zhcntiangang/seahorse.github.io/fishs.jpg

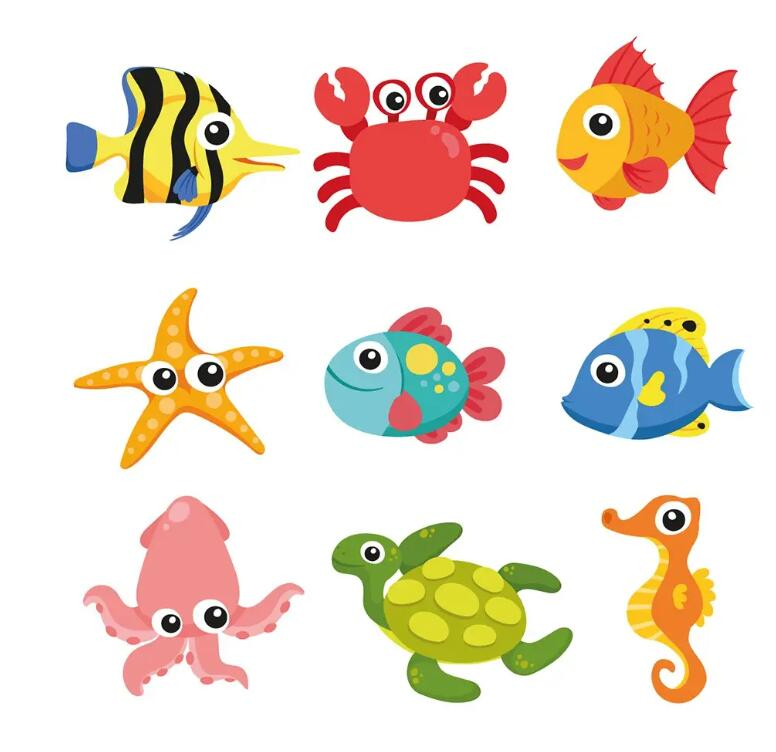
fishs.jpg
