zhcntiangang/seahorse.github.io/gzt/摆放示意图.jpg

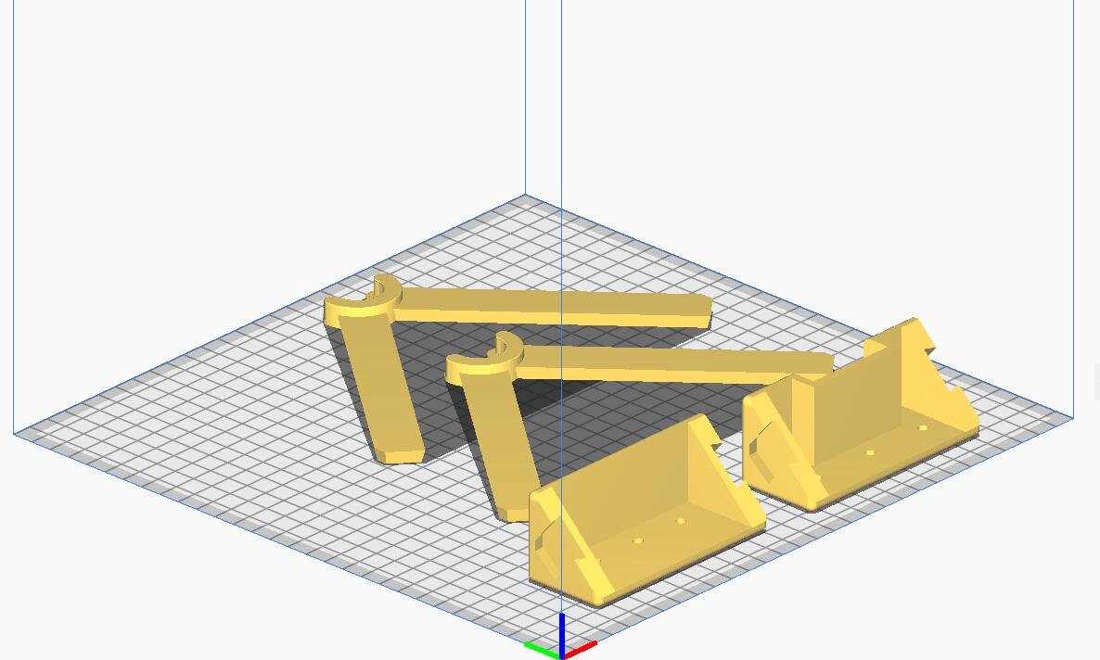
gzt/摆放示意图.jpg
