zhcntiangang/seahorse.github.io/voron/线束标签.docx

断线传感器 断线传感器 断线传感器 断线传感器

LED数据信号 LED数据信号 LED数据信号 LED数据信号

热端加热器V- 热端加热器V- 热端加热器V- 热端加热器V-

5V电源正极 5V电源正极 5V电源正极 5V电源正极

热端风扇V- 热端风扇V- 热端风扇V- 热端风扇V-

电机线-黑色 电机线-黑色 电机线-黑色 电机线-黑色

电机线-绿色 电机线-绿色 电机线-绿色 电机线-绿色

电机线-红色 电机线-红色 电机线-红色 电机线-红色

电机线-蓝色 电机线-蓝色 电机线-蓝色 电机线-蓝色

Probe 信号线 Probe 信号线 Probe 信号线 Probe 信号线

24V正极 24V正极 24V正极 24V正极

可控风扇V- 可控风扇V- 可控风扇V- 可控风扇V-

热敏V- 热敏V- 热敏V- 热敏V-

热敏信号线 热敏信号线 热敏信号线 热敏信号线

电源负极 电源负极 电源负极 电源负极

辅助的信号线 辅助的信号线 辅助的信号线 辅助的信号线

X限位 Y限位 Z限位 照明 仓底风扇 热床正极 热床负极 热床热敏 排气风扇 热床控制

X限位 Y限位 Z限位 照明 仓底风扇 热床正极 热床负极 热床热敏 排气风扇 热床控制
