zhcntiangang/seahorse.github.io/voron/网站发布过程.pptx

像Word一样，用Typora写网站的内容

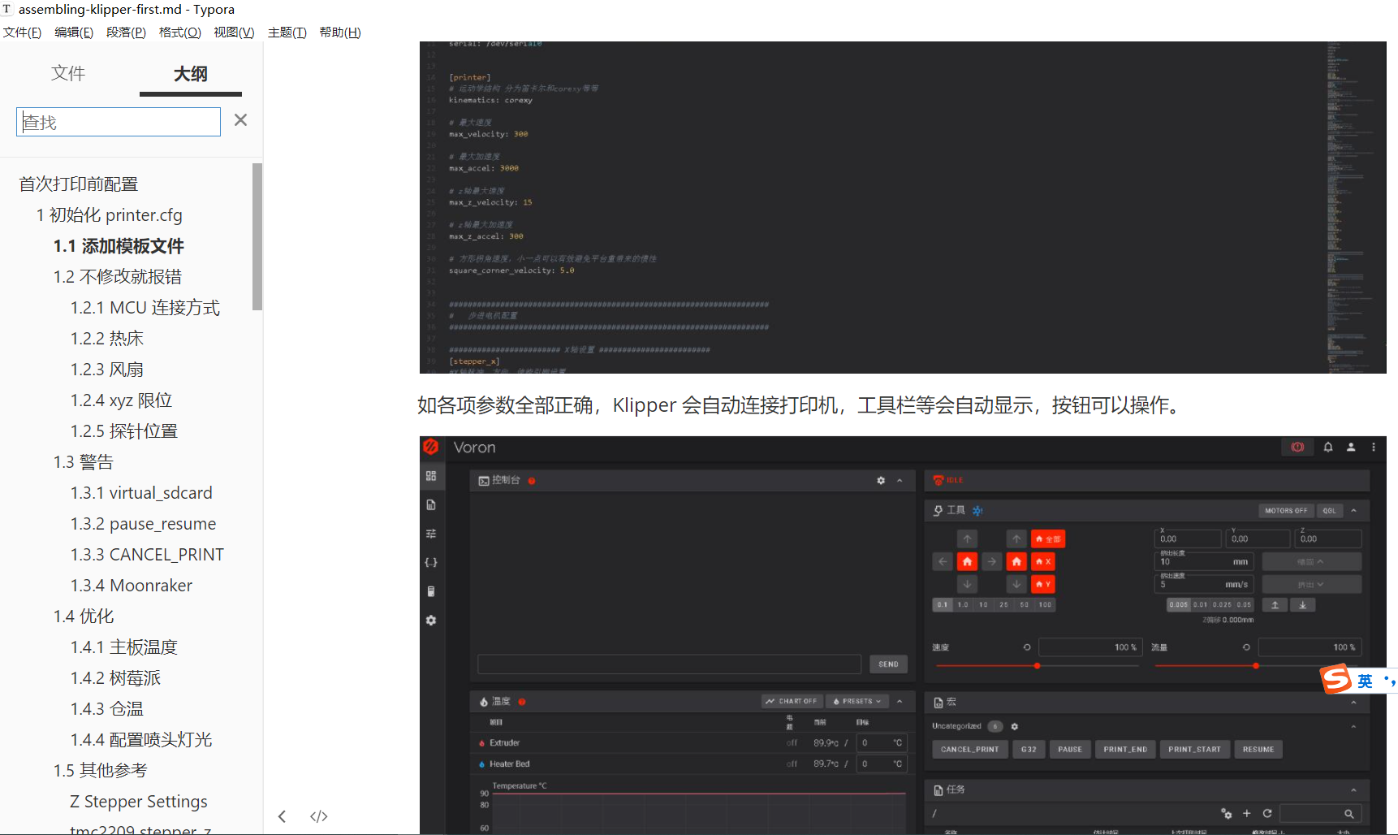
[picture p16: figure]

保存到免费的Gitee网站上

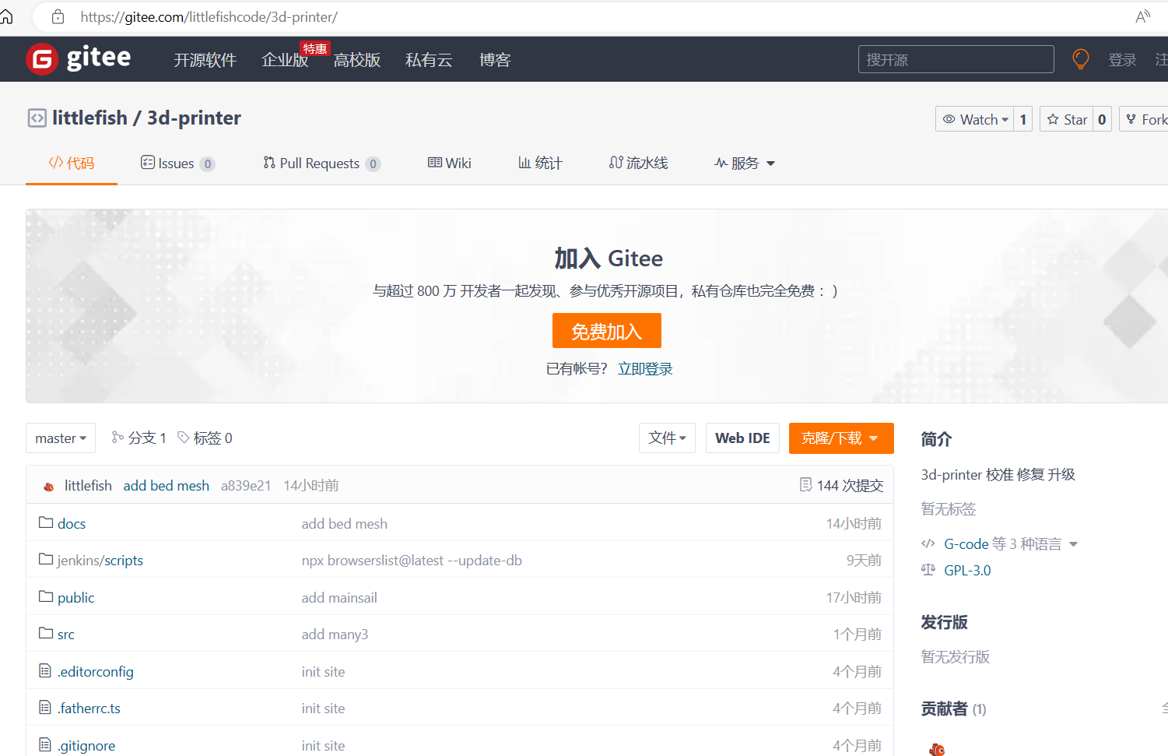
[picture p17: figure]

所有人都可以gitee下载这个项目

发现Gitee有变化，就自动编译网站

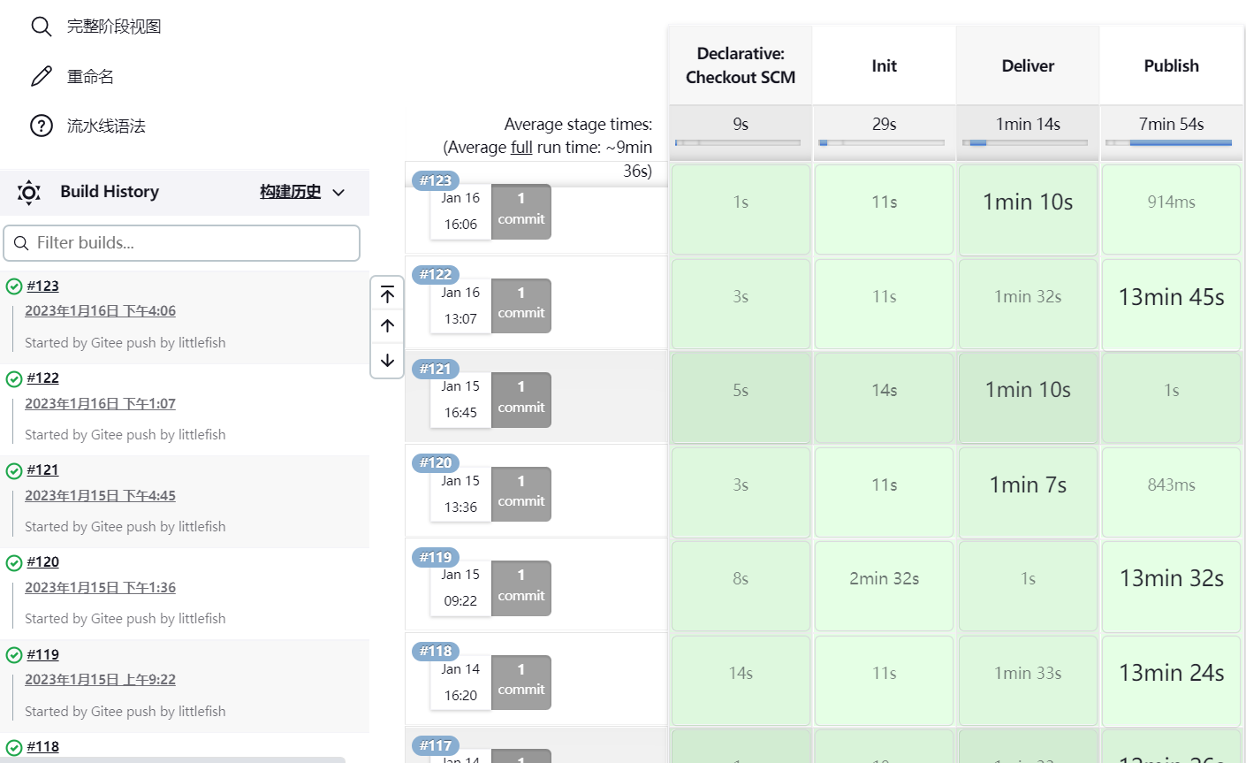
[picture p18: figure]

自动生成手机与电脑两种样式

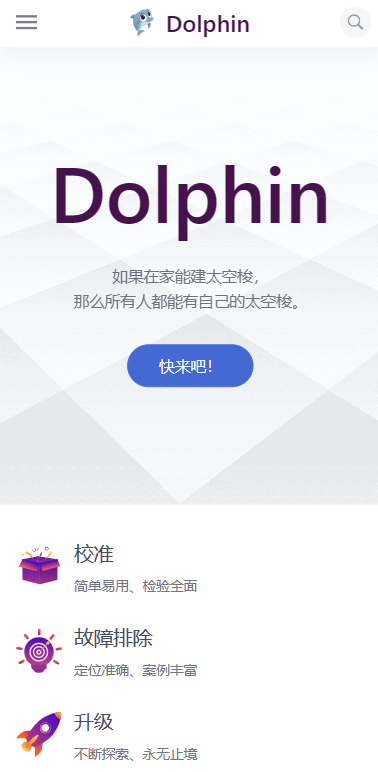
[picture p19: figure]
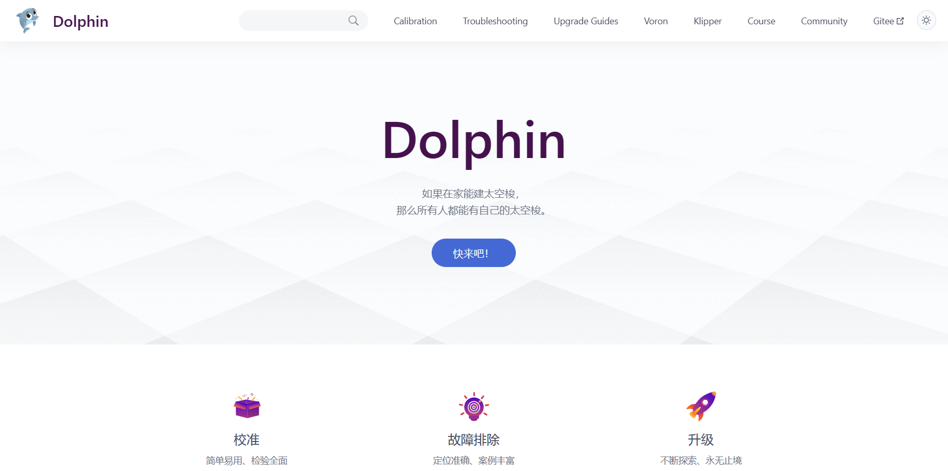
[picture p20: figure]
