zhcntiangang/seahorse.github.io/blibli.png

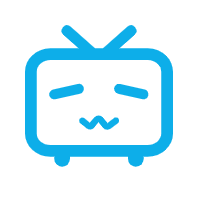
blibli.png
