zhcntiangang/seahorse.github.io/features/soft.png

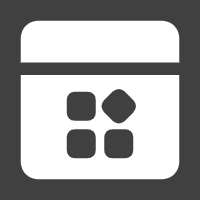
features/soft.png
