zhcntiangang/seahorse.github.io/features/upgrade.png

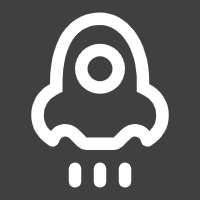
features/upgrade.png
