zhcntiangang/seahorse.github.io/help.png

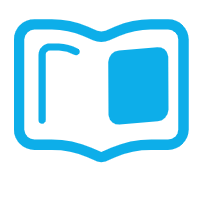
help.png
