zhcntiangang/seahorse.github.io/home.jpg

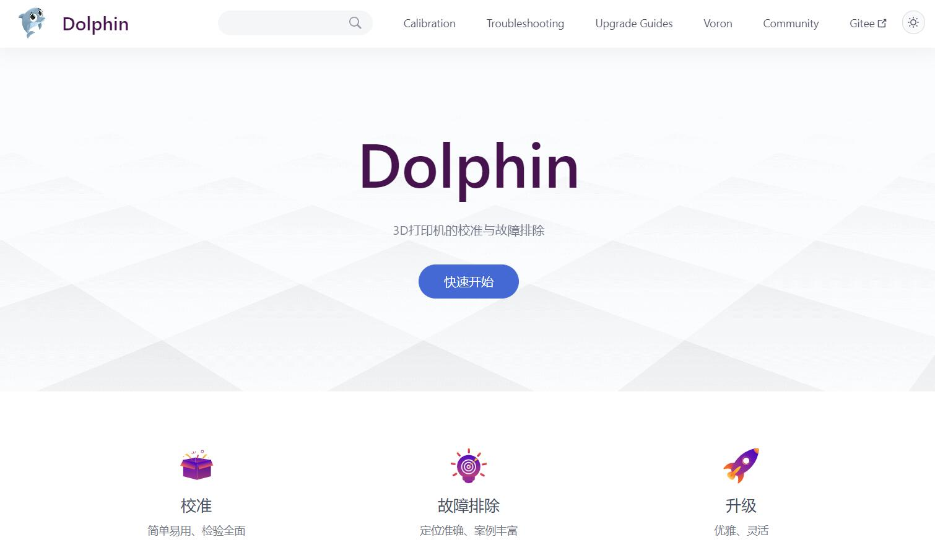
home.jpg
