zhcntiangang/seahorse.github.io/sj.jpg

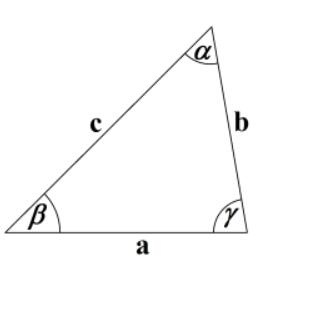
sj.jpg
