zhcntiangang/seahorse.github.io/bom/Voron2.4 R2（CNC专属BOM）中英互译20220822.pdf

# Voron V2.4 R2 300/350mm热床 中英对照翻译清单

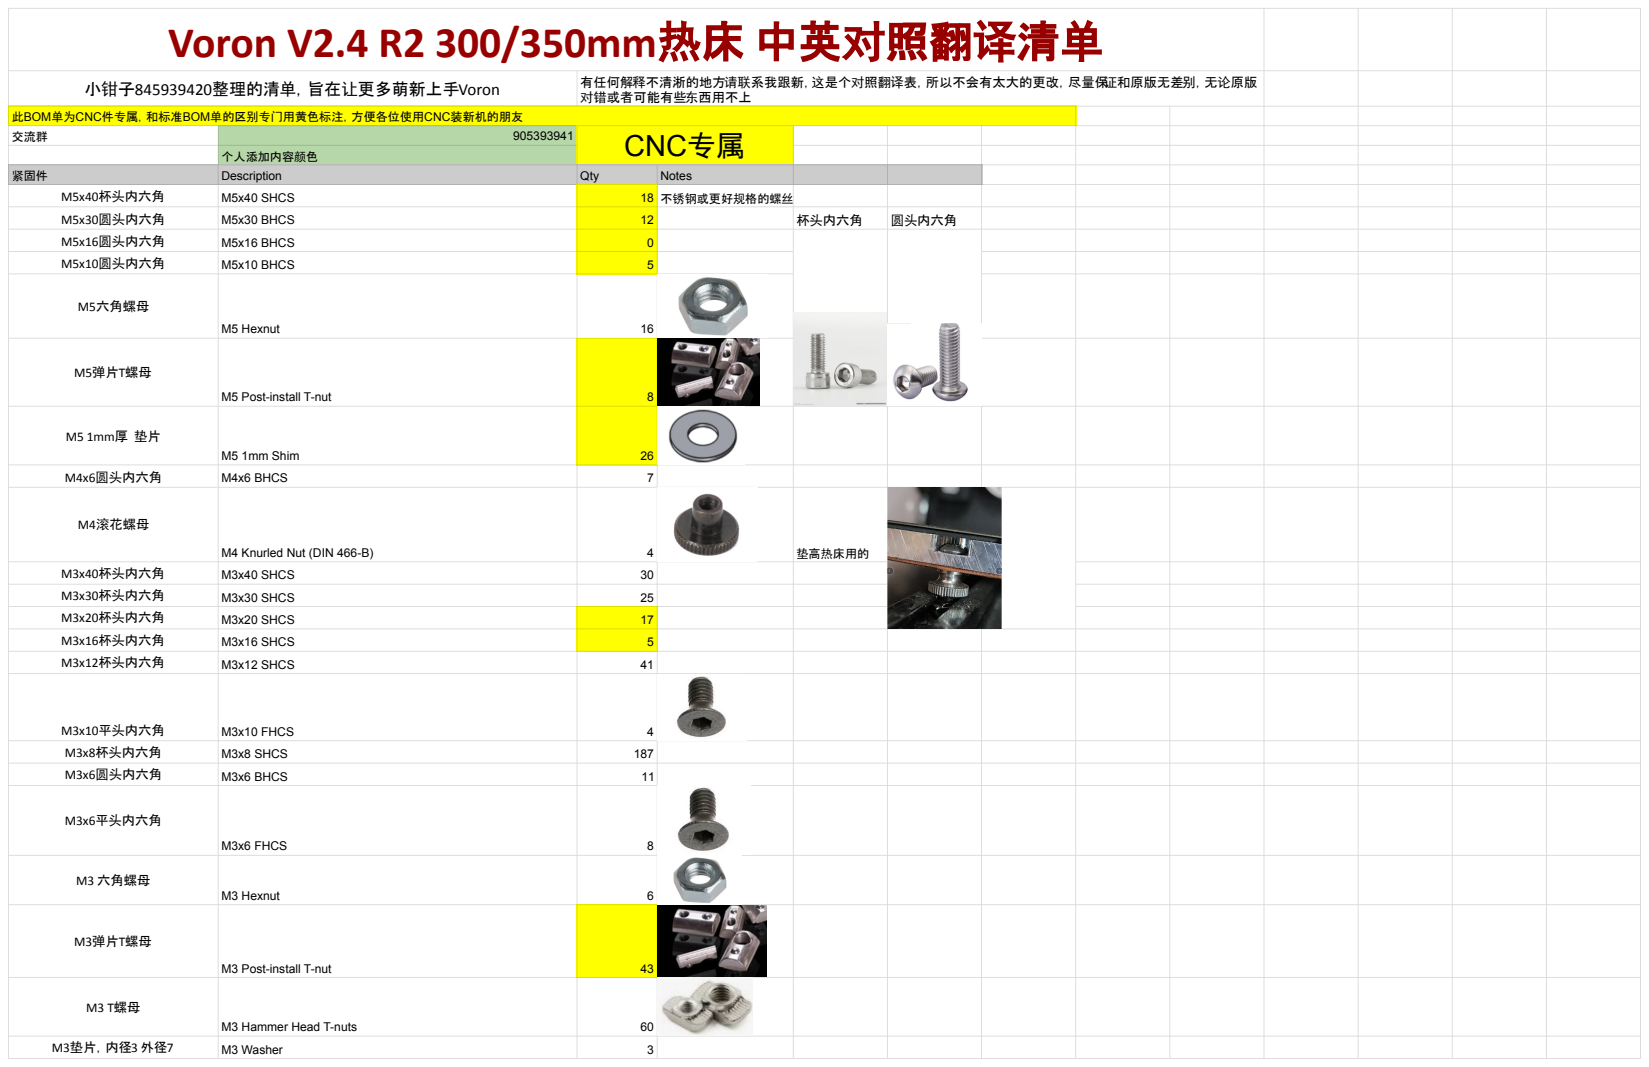
[picture p27: page 1]
M5x40杯头内六角; M5x40 SHCS; 不锈钢或更好规格的螺丝; M5x30圆头内六角; M5x30 BHCS; 杯头内六角; 圆头内六角; M5x16圆头内六角; M5x16 BHCS; M5x10圆头内六角; M5x10 BHCS; M5六角螺母; M5 Hexnut; M5弹片T螺母; M5 Post-install T-nut; M5 1mm厚 垫片; M5 1mm Shim; M4x6圆头内六角; M4x6 BHCS; M4滚花螺母; M4 Knurled Nut (DIN 466-B); 垫高热床用的; M3x40杯头内六角; M3x40 SHCS; M3x30杯头内六角; M3x30 SHCS; M3x20杯头内六角; M3x20 SHCS; M3x16杯头内六角; M3x16 SHCS; M3x12杯头内六角; M3x12 SHCS; M3x10平头内六角; M3x10 FHCS; M3x8杯头内六角; M3x8 SHCS; M3x6圆头内六角; M3x6 BHCS; M3x6平头内六角; M3x6 FHCS; M3 六角螺母; M3 Hexnut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

小钳子845939420整理的清单，旨在让更多萌新上手Voron | 有任何解释不清淅的地方请联系我跟新，这是个对照翻译表，所以不会有太大的更改，尽量保证和原版无差别，无论原版 对错或者可能有些东西用不上

此BOM单为CNC件专属，和标准BOM单的区别专门用黄色标注，方便各位使用CNC装新机的朋友
交流群 | 905393941 个人添加内容颜色 | CNC专属

紧固件 Description Qty Notes

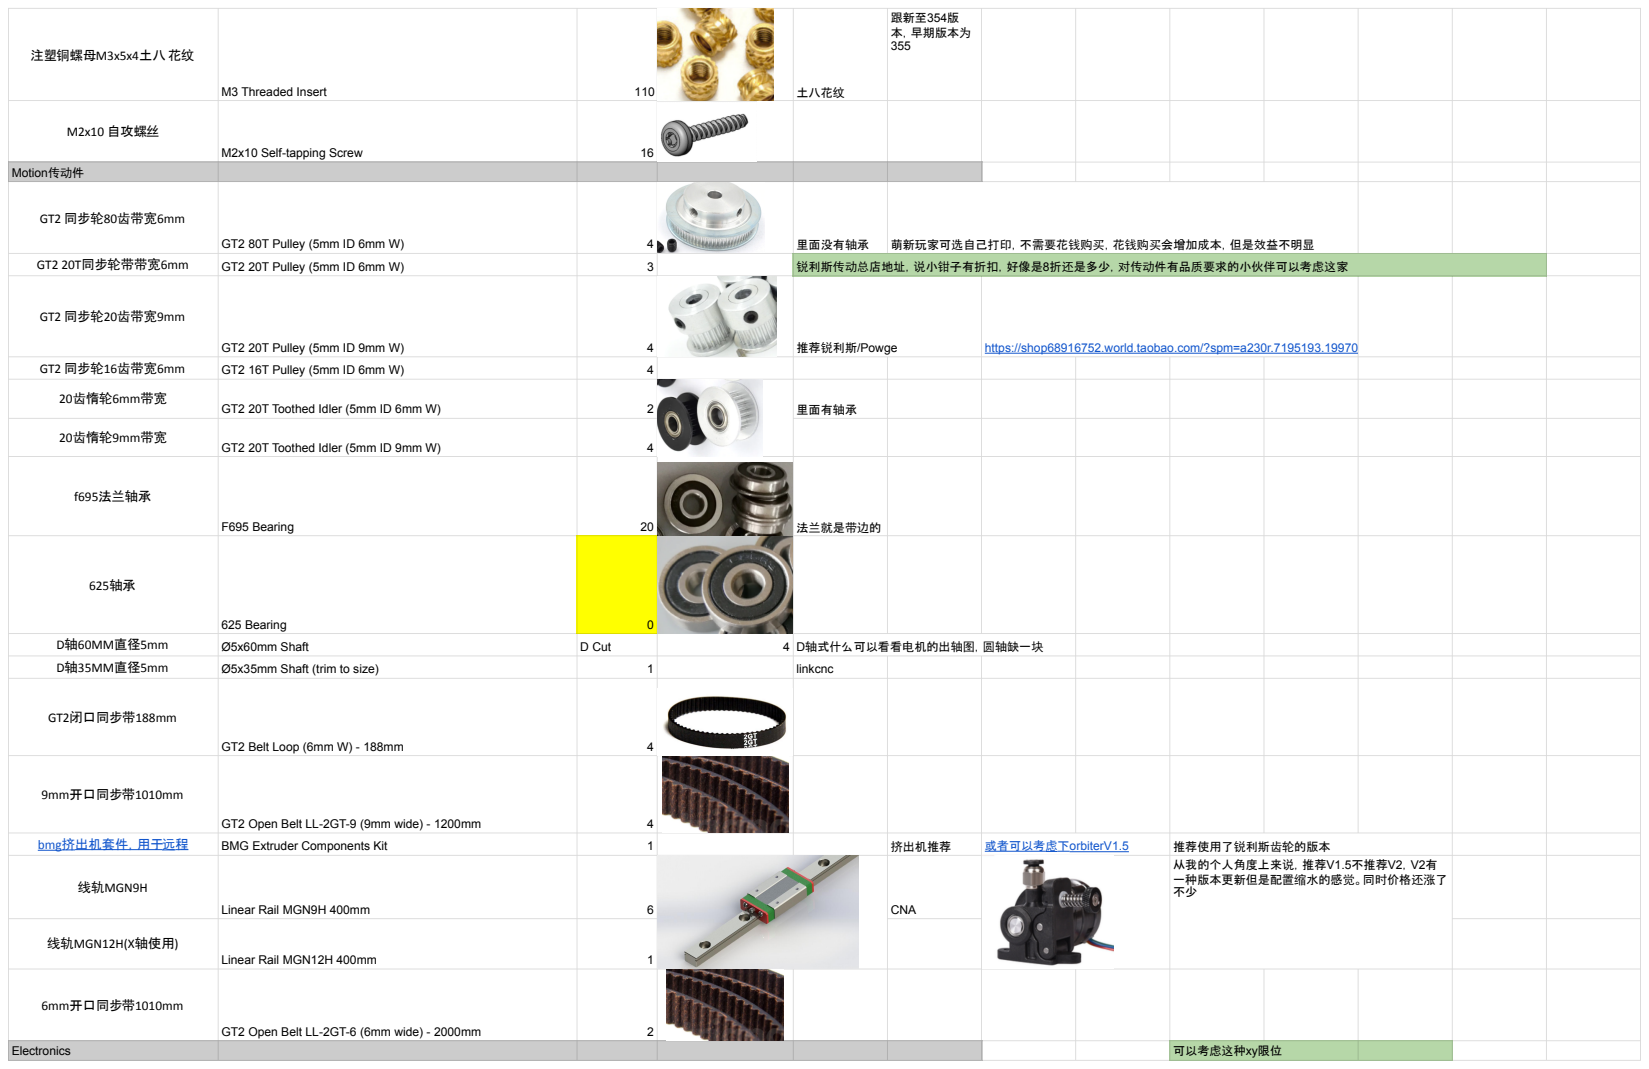
[picture p28: page 2]
注塑铜螺母M3x5x4土八 花纹; M3 Threaded Insert; 土八花纹; 跟新至354版 本，早期版本为 355; M2x10 自攻螺丝; M2x10 Self-tapping Screw; Motion传动件; GT2 同步轮80齿带宽6mm; GT2 80T Pulley (5mm ID 6mm W); 里面没有轴承; 萌新玩家可选自己打印，不需要花钱购买，花钱购买会增加成本，但是效益不明显; GT2 20T同步轮带带宽6mm; GT2 20T Pulley (5mm ID 6mm W); 锐利斯传动总店地址，说小钳子有折扣，好像是8折还是多少，对传动件有品质要求的小伙伴可以考虑这家; GT2 同步轮20齿带宽9mm; GT2 20T Pulley (5mm ID 9mm W); 推荐锐利斯/Powge; https://shop68916752.world.taobao.com/?spm=a230r.7195193.1997079397.2.1e216d77pc7N9O; GT2 同步轮16齿带宽6mm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

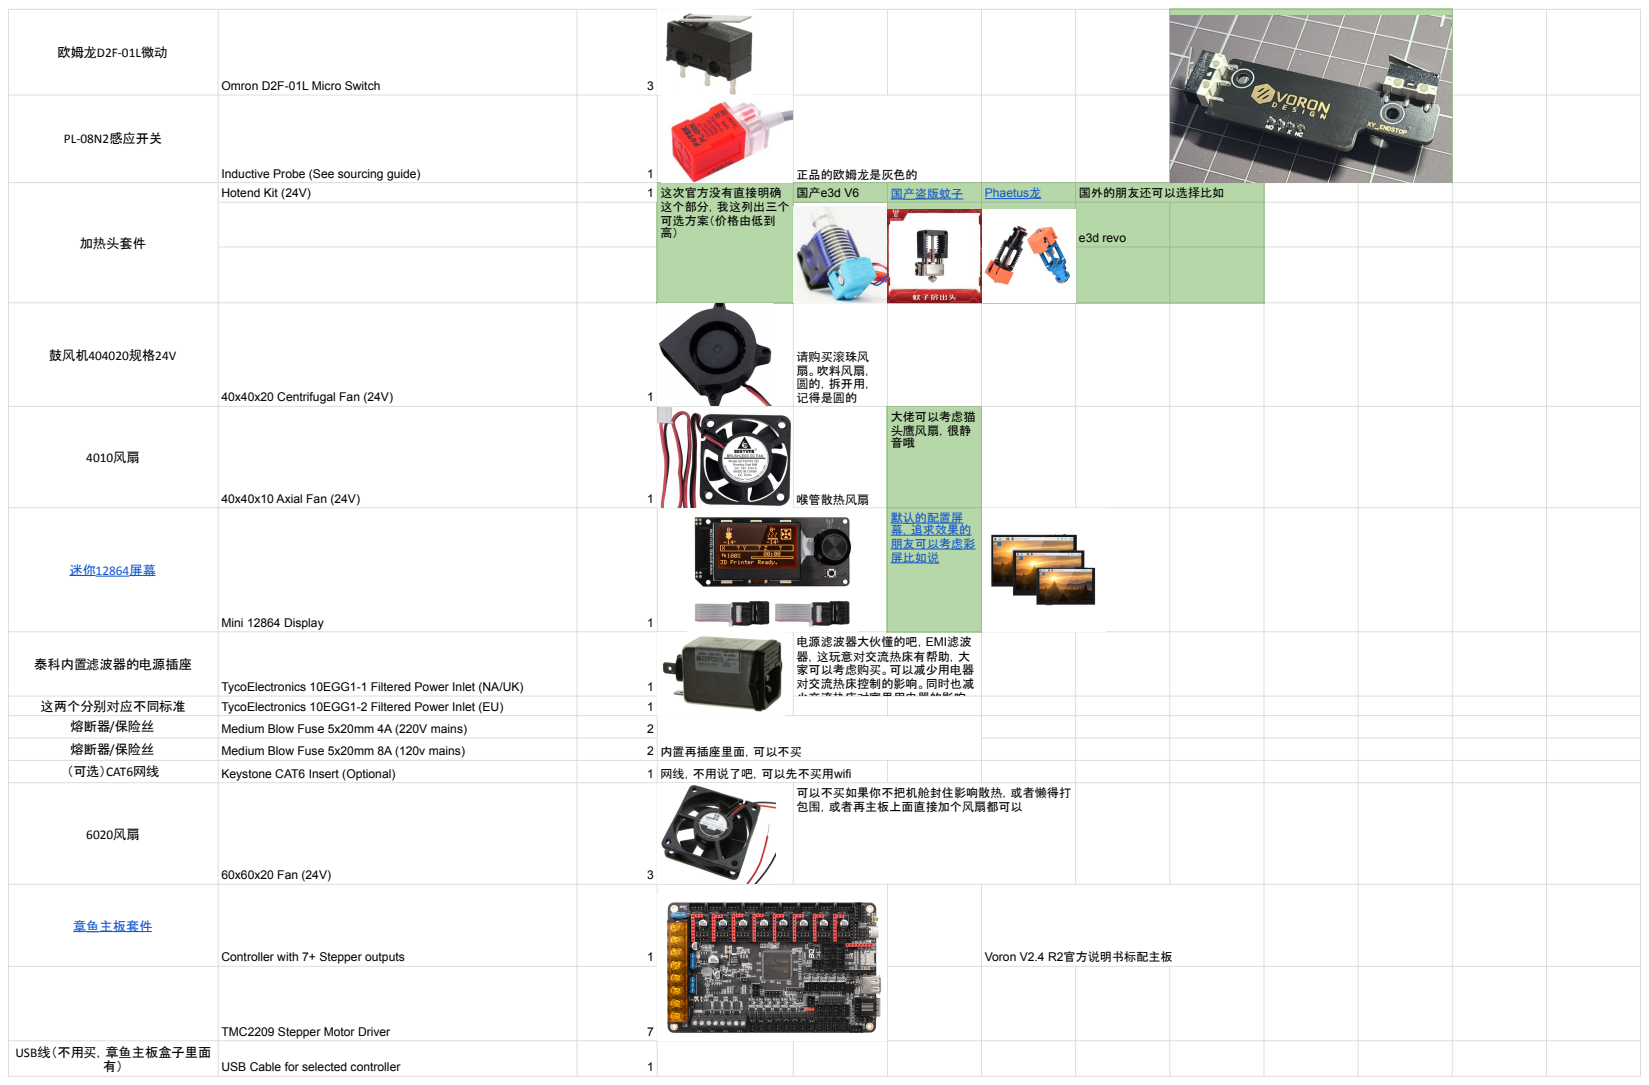
[picture p29: page 3]
加热头套件; Hotend Kit (24V); 这次官方没有直接明确; 鼓风机404020规格24V; 40x40x20 Centrifugal Fan (24V); 请购买滚珠风 扇。吹料风扇， 圆的，拆开用， 记得是圆的; 40x40x10 Axial Fan (24V); 喉管散热风扇; 大佬可以考虑猫 头鹰风扇，很静 音哦; Mini 12864 Display; 默认的配置屏 幕，追求效果的 朋友可以考虑彩 屏比如说; 泰科内置滤波器的电源插座; TycoElectronics 10EGG1-1 Filtered Power Inlet (NA/UK); 电源滤波器大伙懂的吧，EMI滤波 器，这玩意对交流热床有帮助，大 家可以考虑购买。可以减少用电器 对交流热床控制的影响。同时也减 少交流热床对家里用电器的影响。; 这两个分别对应不同标准; TycoElectronics 10EGG1-2 Filtered Power Inlet (EU); 1 熔断器/保险丝; Medium Blow Fuse 5x20mm 4A (220V mains); 2 熔断器/保险丝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

欧姆龙D2F-01L微动 Omron D2F-01L Micro Switch 3 PL-08N2感应开关 Inductive Probe (See sourcing guide) 1 正品的欧姆龙是灰色的

国产e3d V6 国产盗版蚊子 (https://item.taobao.com/item.htm?id=617701287324) Phaetus龙 (https://item.taobao.com/item.htm?id=618872835165) 国外的朋友还可以选择比如

这个部分，我这列出三个 可选方案（价格由低到 高） | | e3d revo

USB线（不用买，章鱼主板盒子里面

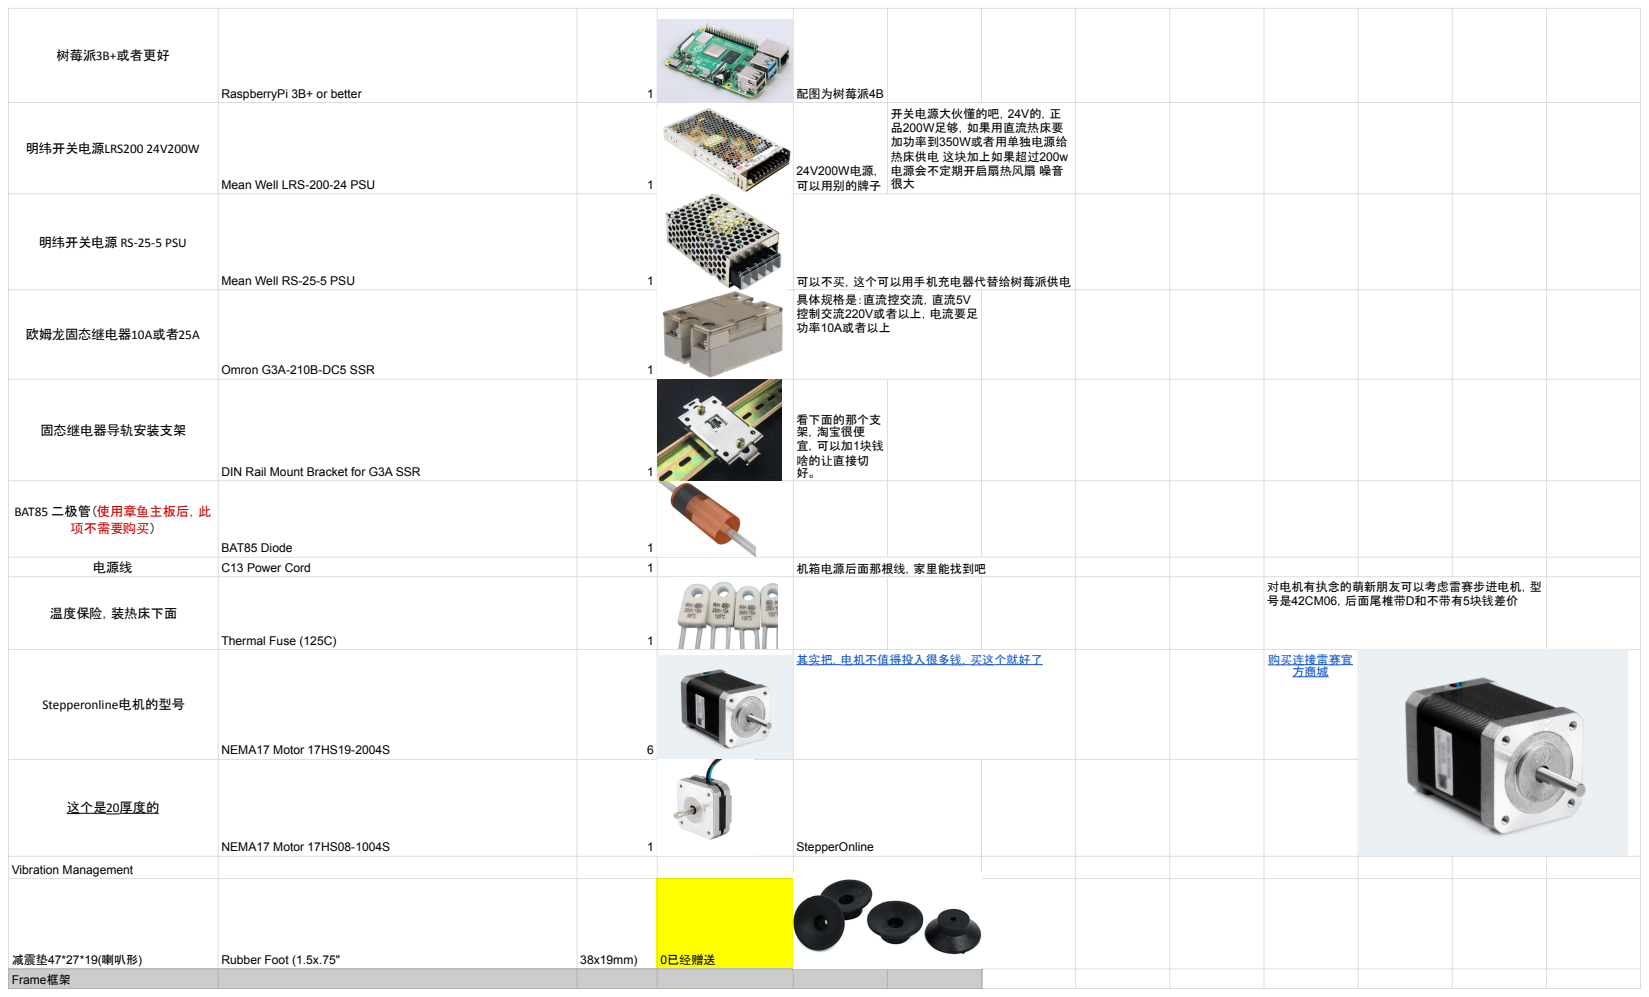
[picture p30: page 4]
树莓派3B+或者更好; RaspberryPi 3B+ or better; 配图为树莓派4B; 明纬开关电源LRS200 24V200W; Mean Well LRS-200-24 PSU; 24V200W电源， 可以用别的牌子; 开关电源大伙懂的吧，24V的，正 品200W足够，如果用直流热床要 加功率到350W或者用单独电源给 热床供电 这块加上如果超过200w 电源会不定期开启扇热风扇 噪音; Mean Well RS-25-5 PSU; 可以不买，这个可以用手机充电器代替给树莓派供电; 欧姆龙固态继电器10A或者25A; Omron G3A-210B-DC5 SSR; 功率10A或者以上; 固态继电器导轨安装支架; DIN Rail Mount Bracket for G3A SSR; 看下面的那个支 架，淘宝很便 宜，可以加1块钱 啥的让直接切 好。; BAT85 二极管（使用章鱼主板后，此 项不需要购买）; BAT85 Diode; 1 电源线; C13 Power Cord; 机箱电源后面那根线，家里能找到吧; 温度保险，装热床下面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

明纬开关电源 RS-25-5 PSU

具体规格是：直流控交流，直流5V 控制交流220V或者以上，电流要足

减震垫47*27*19(喇叭形) Rubber Foot (1.5x.75" 38x19mm) | 0已经赠送
Frame框架

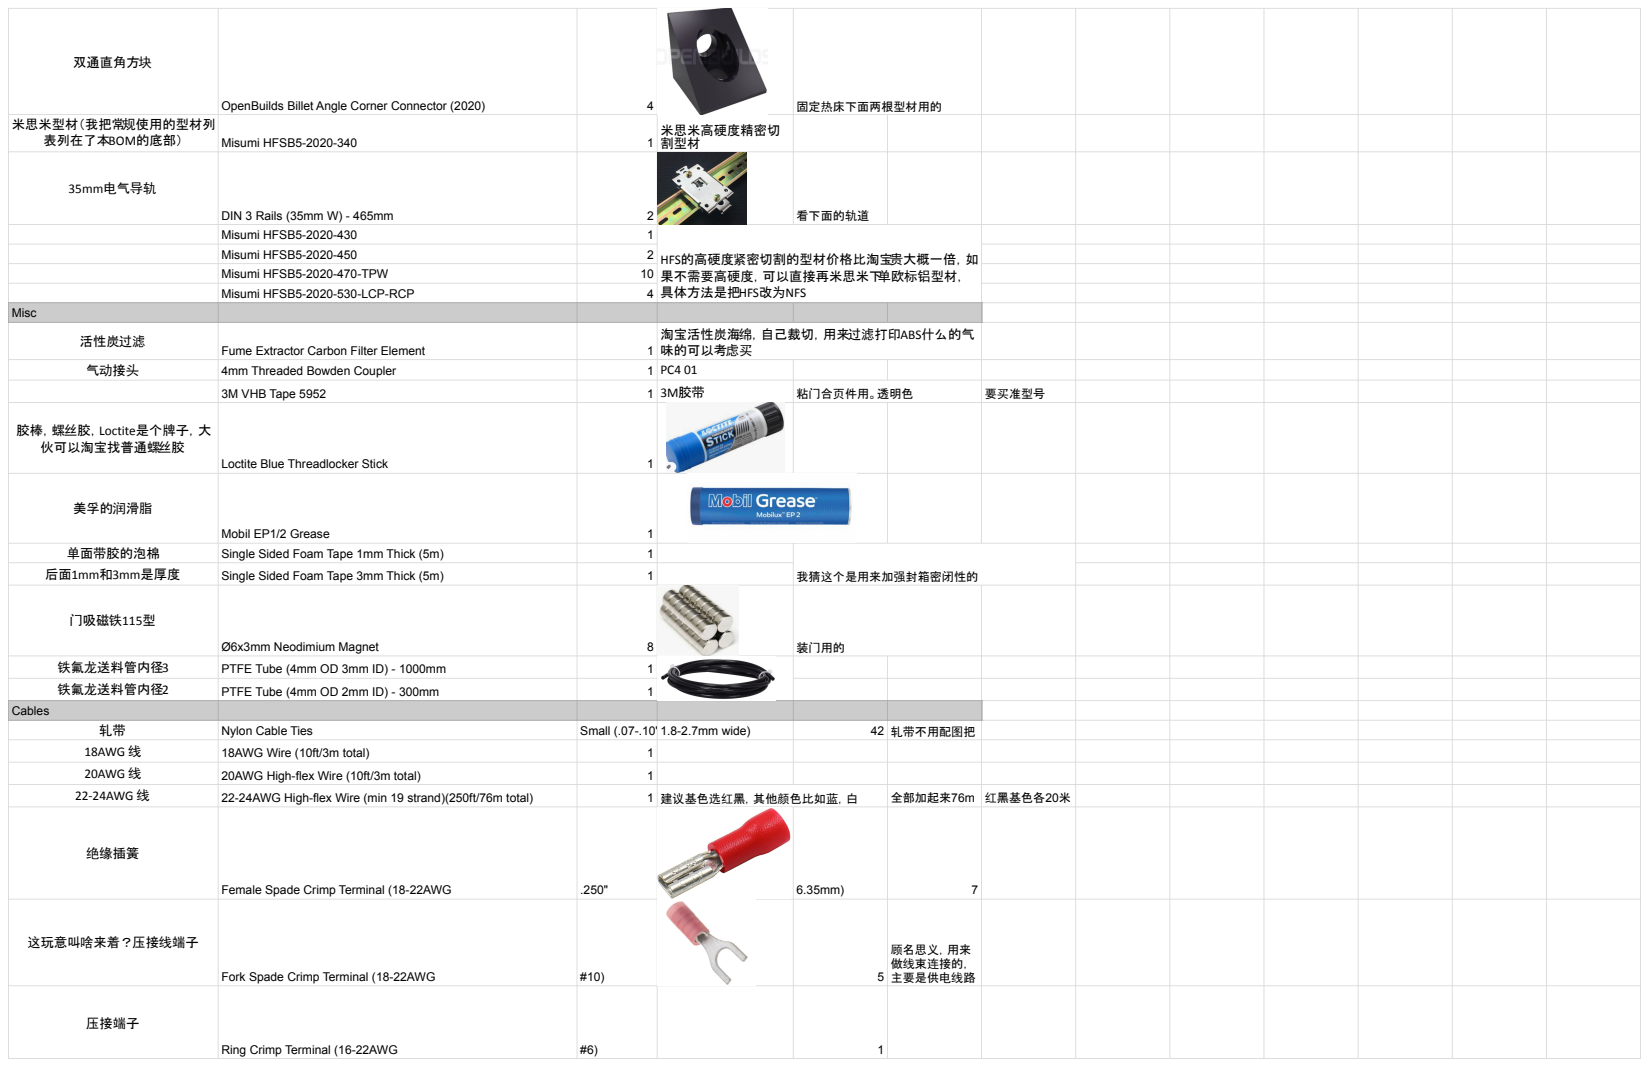
[picture p31: page 5]
双通直角方块; OpenBuilds Billet Angle Corner Connector (2020); 固定热床下面两根型材用的; 米思米型材（我把常规使用的型材列; 表列在了本BOM的底部）; Misumi HFSB5-2020-340; 1 米思米高硬度精密切; 割型材; 35mm电气导轨; DIN 3 Rails (35mm W) - 465mm; 看下面的轨道; Misumi HFSB5-2020-430; HFS的高硬度紧密切割的型材价格比淘宝贵大概一倍，如 果不需要高硬度，可以直接再米思米下单欧标铝型材， 具体方法是把HFS改为NFS; Misumi HFSB5-2020-450; Misumi HFSB5-2020-470-TPW; Misumi HFSB5-2020-530-LCP-RCP; Misc; 活性炭过滤; Fume Extractor Carbon Filter Element; 气动接头; 4mm Threaded Bowden Coupler; 3M VHB Tape 5952; 1 3M胶带; 粘门合页件用。透明色; 要买准型号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

淘宝活性炭海绵，自己裁切，用来过滤打印ABS什么的气
味的可以考虑买

胶棒，螺丝胶，Loctite是个牌子，大
伙可以淘宝找普通螺丝胶

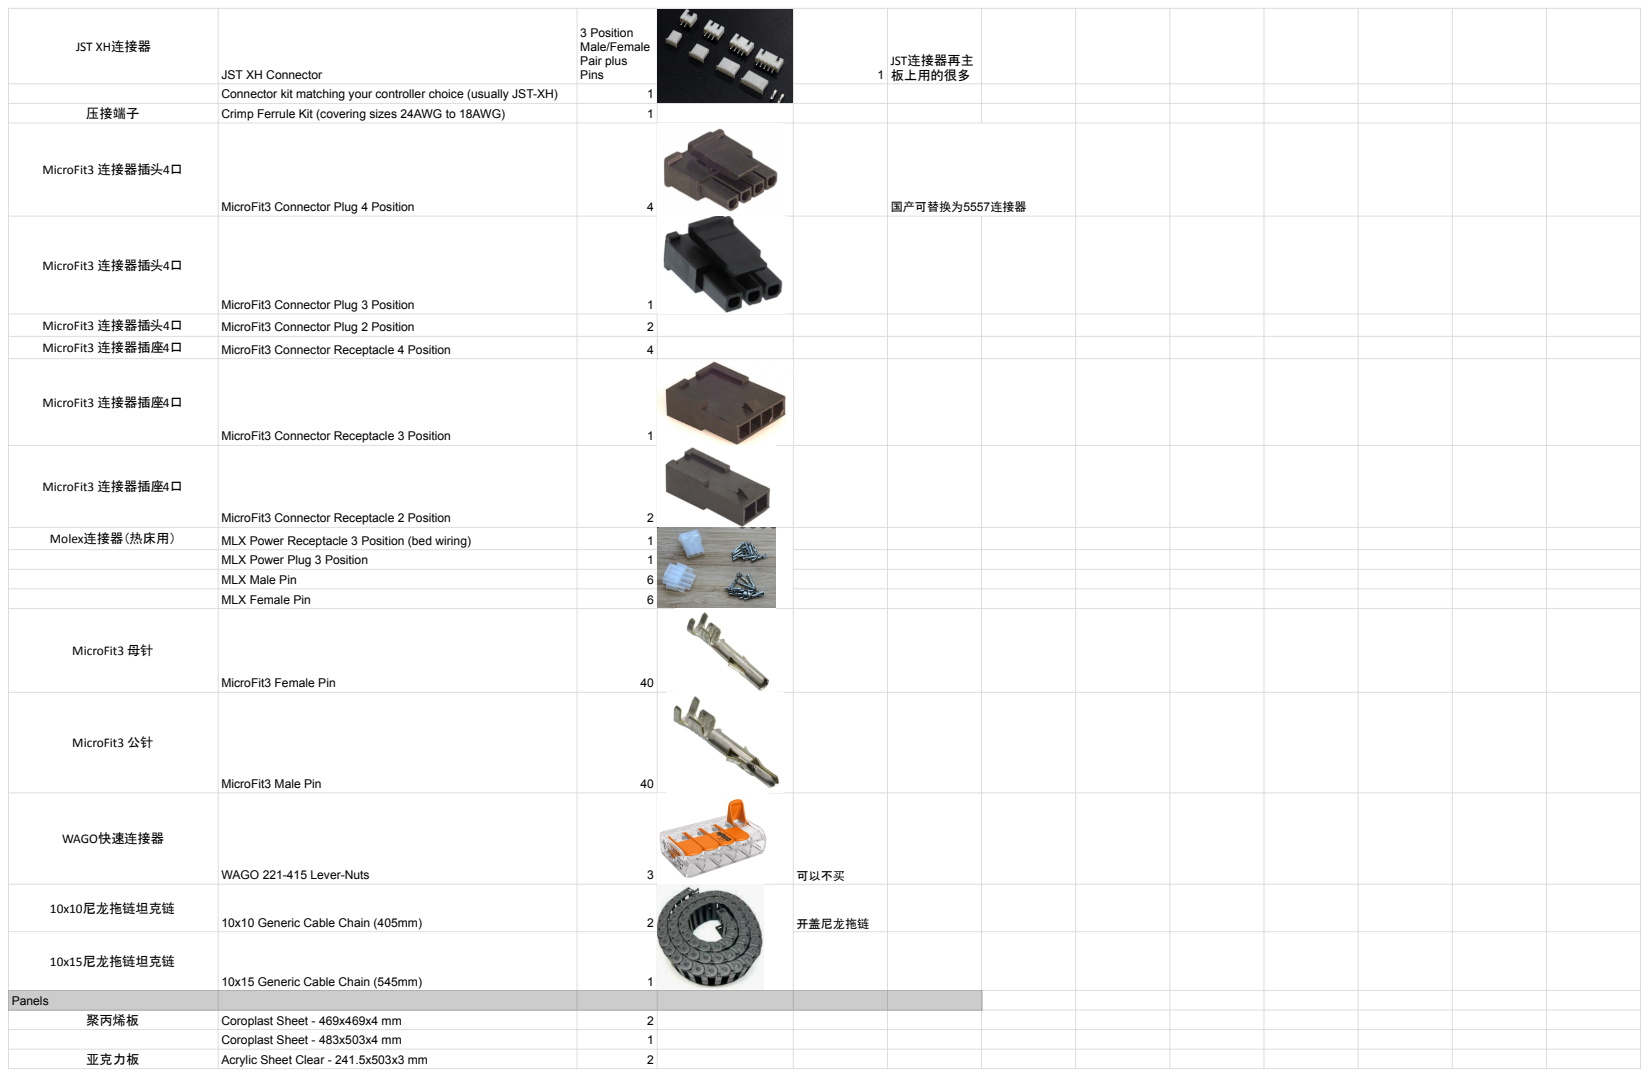
[picture p32: page 6]
JST XH连接器; 3 Position Male/Female Pair plus Pins; JST连接器再主 板上用的很多; Connector kit matching your controller choice (usually JST-XH); 1 压接端子; Crimp Ferrule Kit (covering sizes 24AWG to 18AWG); MicroFit3 连接器插头4口; MicroFit3 Connector Plug 4 Position; 国产可替换为5557连接器; MicroFit3 Connector Plug 3 Position; MicroFit3 Connector Plug 2 Position; MicroFit3 连接器插座4口; MicroFit3 Connector Receptacle 4 Position; MicroFit3 Connector Receptacle 3 Position; MicroFit3 Connector Receptacle 2 Position; Molex连接器（热床用）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

JST XH Connector

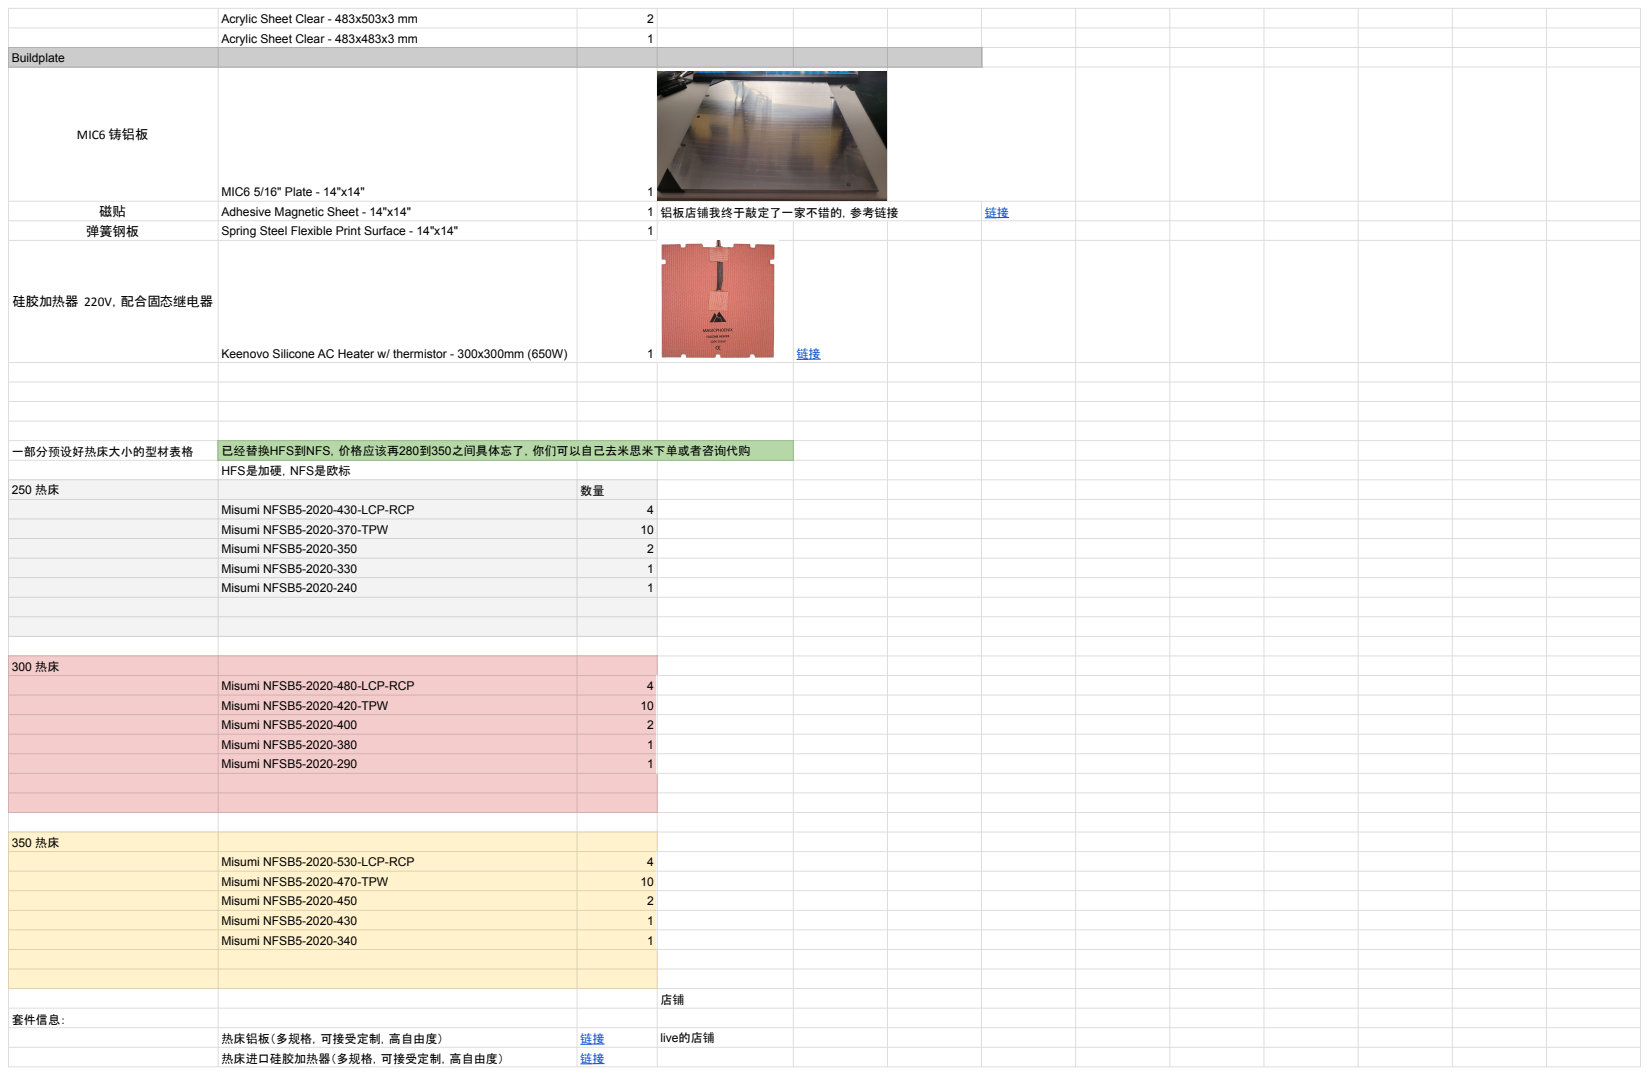
[picture p33: page 7]
Acrylic Sheet Clear - 483x503x3 mm; Acrylic Sheet Clear - 483x483x3 mm; Buildplate; MIC6 铸铝板; MIC6 5/16" Plate - 14"x14"; Adhesive Magnetic Sheet - 14"x14"; 1 铝板店铺我终于敲定了一家不错的，参考链接; 弹簧钢板; Spring Steel Flexible Print Surface - 14"x14"; 硅胶加热器 220V，配合固态继电器; Keenovo Silicone AC Heater w/ thermistor - 300x300mm (650W); 一部分预设好热床大小的型材表格; 已经替换HFS到NFS，价格应该再280到350之间具体忘了，你们可以自己去米思米下单或者咨询代购; HFS是加硬，NFS是欧标; Misumi NFSB5-2020-430-LCP-RCP; Misumi NFSB5-2020-370-TPW; Misumi NFSB5-2020-350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

传动件套件 | 链 接 (https://shop68916752.world.taobao.com/?spm=a230r.7195193.1997079397.2.1e216d77pc7N9O) | 锐利斯传动总 店 | 报 小 钳子有 8折折扣
可以 购入高品质锐利斯传动件， 轮子，皮 带 等
