zhcntiangang/seahorse.github.io/voron/采购清单_v2.4_250样例.xlsx

大类 | 物品 | 描述 | 数量 | 备注 | 淘宝连接 | 单号 | 订单价格 | 小计 | 总价
紧固件 | M5x10 BHCS | M5x10 圆头内六角螺丝40 | 20 | 已下单 | https://detail.tmall.com/item.htm?id=526444785564&ns=1&abbucket=13&skuId=4689711815827
 | M5x16 BHCS | M5x16 圆头内六角螺丝27 | 15 | 已下单 | https://detail.tmall.com/item.htm?id=526444785564&ns=1&abbucket=13&skuId=4689711815827
 | M5x30 BHCS | M5x30 圆头内六角螺丝22 | 11 | 已下单 | https://detail.tmall.com/item.htm?id=526444785564&ns=1&abbucket=13&skuId=4689711815827
 | M5x40 SHCS | M5x40 普通内六角螺丝22 | 11 | 已下单 | https://detail.tmall.com/item.htm?id=521303490209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
 | M5 Hexnut | M5 螺母26 | 13 | 已下单
 | M5 T-nut HNTAJ5-5 | M5 T型螺母 HNTAJ5-5 61 | 40 | 已下单 | https://detail.tmall.com/item.htm?id=542911953480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
 | M5 1mm Spacer | M5 1mm 垫片42 | 21 | 已下单
 | M4x6 BHCS | M4x6 圆头内六角螺丝4 | 2 | 已下单
 | M4 Knurled Nut (DIN 466-B) | M4 滚花螺母 (DIN 466-B) 4 | 2 | 已下单
 | M3x6 BHCS | M3x6 圆头内六角螺丝6 | 3 | 已下单
 | M3x8 SHCS | M3x8 普通内六角螺丝217 | 100 | 已下单
 | M3x12 SHCS | M3x12 普通内六角螺丝23 | 12 | 已下单
 | M3x16 SHCS | M3x16 普通内六角螺丝14 | 7 | 已下单
 | M3x20 SHCS | M3x20 普通内六角螺丝29 | 15 | 已下单
 | M3x30 SHCS | M3x30 普通内六角螺丝25 | 13 | 已下单
 | M3x40 SHCS | M3x40 普通内六角螺丝28 | 14 | 已下单
 | M3 Hexnut | M3 螺母 | 6 | 不用采购
 | M3 Washer | M3 垫圈 | 1 | 不用采购
 | M3 Hammer Head T-nuts | M3 Hammer Head T型螺母s 47 | 30 | 已下单
 | M3 T-nut HNTAJ5-3 | M3 T型螺母 HNTAJ5-3 120 | 52 | 已下单 | https://detail.tmall.com/item.htm?id=542911953480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
 | M3 Threaded Insert | M3 螺纹嵌入件90 | 45 | 已下单
 | M2x10 Self-tapping Screw | M2x10 自攻螺丝15 | 8 | 不用采购
小计 |  |  |  |  |  |  |  | ¥0.00
运动件 | GT2 20T Toothed Idler (5mm ID 6mm W) | GT2 20T 同步带带轮（带齿） (5mm 内径 6mm W) 2 | 3 | 已下单 | https://item.taobao.com/item.htm?spm=a1z10.5-c-s.w4002-22254585059.17.127171c2YtuZVC&id=528334274858
 | GT2 20T Toothed Idler (5mm ID 9mm W) | GT2 20T 同步带带轮（带齿） (5mm 内径 9mm W) 4 | 5 | 已下单 | https://item.taobao.com/item.htm?spm=a1z10.5-c-s.w4002-22254585059.17.127171c2YtuZVC&id=528334274858
 | GT2 16T Pulley (5mm ID 6mm W) | GT2 16T 滑轮 (5mm 内径 6mm W) 4 | 5 | 已下单 | https://item.taobao.com/item.htm?spm=a1z0d.7625083.1998302264.6.5c5f4e69aaZqoX&id=566921623127
 | GT2 20T Pulley (5mm ID 6mm W) | GT2 20T 滑轮 (5mm 内径 6mm W) 3 | 4 | 已下单 | https://item.taobao.com/item.htm?spm=a1z0d.7625083.1998302264.6.5c5f4e69aaZqoX&id=566921623127
 | GT2 20T Pulley (5mm ID 9mm W) | GT2 20T 滑轮 (5mm 内径 9mm W) 4 | 5 | 已下单 | https://item.taobao.com/item.htm?spm=a1z0d.7625083.1998302264.6.5c5f4e69qw19pC&id=591441097993
 | GT2 80T Pulley (5mm ID 6mm W) | GT2 80T 滑轮 (5mm 内径 6mm W) 4 | 4 | 已下单 | https://item.taobao.com/item.htm?spm=a1z0d.7625083.1998302264.6.5c5f4e69Y43Eno&id=590822265991
 | GT2 Belt Loop (6mm W) - 188mm | GT2 皮带环 (6mm W) - 188mm 4 | 5 | 已下单 | https://item.taobao.com/item.htm?spm=a1z0d.7625083.1998302264.6.5c5f4e69csUAUT&id=573703705377
 | GT2 Open Belt LL-2GT-6 (6mm wide) - 1600mm | GT2 皮带 LL-2GT-6 (6mm w内径e) - 2000mm 2 | 3 | 已下单 | https://item.taobao.com/item.htm?spm=a1z10.5-c-s.w4002-22254585059.11.32fa71c25OK8eg&id=527745858306
 | GT2 Open Belt LL-2GT-9 (9mm wide) - 910mm | GT2 皮带 LL-2GT-9 (9mm w内径e) - 1110mm 4 | 5 | 已下单 | https://item.taobao.com/item.htm?spm=a1z10.5-c-s.w4002-22254585059.11.32fa71c25OK8eg&id=527745858306
 | 625 Bearing | 625 轴承12 | 15 | 已下单 | https://item.taobao.com/item.htm?spm=a1z10.3-c.w4002-1583111922.9.6d8226b5Yd6MUG&id=22821888002
 | F695 Bearing | F695 轴承20 | 25 | 已下单 | https://item.taobao.com/item.htm?spm=a1z0d.7625083.1998302264.6.5c5f4e69wsMXqA&id=631306709484
 | 5x30mm Shaft | 5x30mm 轴1 | 1 | 已下单 | https://item.taobao.com/item.htm?spm=a1z0d.7625083.1998302264.6.5c5f4e697XhWca&id=609903675812
 | 5x60mm Shaft | 5x60mm 轴4 | 2 | 已下单 | https://item.taobao.com/item.htm?spm=a1z0d.7625083.1998302264.6.5c5f4e697XhWca&id=609903675812
 | BMG Extruder Componnets Kit | BMG 挤出机套件1 | 1 | 已下单 | https://item.taobao.com/item.htm?spm=a1z0d.7625083.1998302264.6.5c5f4e69s3Wqbs&id=607616053219
 | Linear Rail MGN9H 300mm | 线轨 MGN9H 400mm | 8 | 已下单 | https://item.taobao.com/item.htm?spm=a1z09.2.0.0.4c972e8dosr2U8&id=626739666987&_u=qc2trq2ade
小计 |  |  |  |  |  |  |  | ¥0.00
电子类 | NEMA17 Motor 17HS19-2004S | NEMA17 步进电机 17HS19-2004S 6 | 8 | 已下单 | https://item.taobao.com/item.htm?id=607627034377&ns=1&abbucket=13 (https://item.taobao.com/item.htm?spm=a230r.1.14.75.37d110d4f0G6QE&id=607627034377&ns=1&abbucket=13)
 | NEMA17 Motor 17HS08-1004S | NEMA17 电机 17HS08-1004S 1 | 1 | 已下单 | https://item.taobao.com/item.htm?spm=a1z10.5-c-s.w4002-21829575240.10.6cbe1280QFwzL9&id=628046381148
 | Keystone CAT6 Insert (Optional) | CAT6 输入接头 (可选) 1 | 1 | 不用采购
 | C13 Power Cord | C13 电缆1 | 1 | 不用采购
 | Inlet Power Socket IEC320 C14 | 输入电源座 IEC320 C14 1 | 2 | 已下单 | https://detail.tmall.com/item.htm?id=623807292869&spm=a1z09.2.0.0.77ea2e8dmn6Zto&_u=rc2trqedb7
 | Mean Well LRS-200-24 PSU | LRS-200-24 电源1 | 1 | 已下单 | https://item.taobao.com/item.htm?id=595783963500&ns=1&abbucket=13
 | Mean Well RS-25-5 PSU | RS-25-5 电源1 | 1 | 已下单 | https://item.taobao.com/item.htm?id=595783963500&ns=1&abbucket=13
 | Omron G3A-210B-DC5 SSR | 欧姆龙 G3A-210B-DC5 固态继电器1 | 1 | 已下单 | https://item.taobao.com/item.htm?spm=a1z0d.7625083.1998302264.6.5c5f4e69cEQXPM&id=35199228116
 | DIN Rail Mount Bracket for G3A SSR | G3A固态继电器安装支架1 | 1 | 已下单 | https://item.taobao.com/item.htm?spm=a1z0d.7625083.1998302264.6.5c5f4e699PPOV6&id=561361622414
 | BAT85 Diode | BAT85 二极管1 | 1 | 未采购
 | Thermal Fuse (120C) | 保险丝 (120C) 1 | 1 | 未采购
 | USB Cable A-male B-male | USB Cable A-公 B-公2 | 1 | 已下单 | https://detail.tmall.com/item.htm?id=548985853308&ns=1&abbucket=13&skuId=4383058248855
 | SPDT KW10 Limit Micro Switch | SPDT KW10 微动限位开关3 | 3 | 已下单 | https://detail.tmall.com/item.htm?id=637355104450&ns=1&abbucket=13&skuId=4745360878403
 | PL-08N Inductive Probe | PL-08N 接近开关1 | 1 | 已下单 | https://item.taobao.com/item.htm?id=626654032601&ns=1&abbucket=13
 | 40x40x20 Centrifugal Fan (24V) | 40x40x20 离心风扇 (24V) 1 | 1 | 已下单 | https://item.taobao.com/item.htm?spm=a1z10.3-c.w4002-21921534145.28.15f21714Aq6Nkg&id=600384522992
 | 40x40x10 Axial Fan (24V) | 40x40x10 轴流风扇 (24V) 1 | 1 | 已下单 | https://item.taobao.com/item.htm?spm=a1z10.3-c.w4002-21921534145.22.15f21714Aq6Nkg&id=626184133606
 | 60x60x20 Fan (24V) | 60x60x20 风扇 (24V) 3 | 6 | 已下单 | https://item.taobao.com/item.htm?spm=a1z0d.7625083.1998302264.6.5c5f4e69BOtJbt&id=600469054707
 | E3D V6 Bowden Hotend Kit (24V) | E3D V6 Bowden Hotend Kit (24V) 1 | 1 | 已下单 | https://item.taobao.com/item.htm?spm=a1z09.2.0.0.704b2e8dnKYMa2&id=559769172879&_u=rc2trqb2a0
 | Mini 12864 Display | Mini 12864 显示屏1 | 1 | 已下单 | https://item.taobao.com/item.htm?id=631993516074&ns=1&abbucket=13
 | SKR PRO | SKR PRO | 2 | 已下单 | https://item.taobao.com/item.htm?spm=a1z10.3-c.w4002-17869221479.15.6175b631FWRHP1&id=625671241167
 | RaspberryPi 4 | RaspberryPi 4 1 | 1 | 已下单 | https://item.taobao.com/item.htm?spm=a1z09.2.0.0.2a792e8dA0FAu3&id=597048000256&_u=rc2trqd2a7
 | TMC2209 Stepper Motor Driver | TMC2209 步进电机驱动板7 | 7 | 已下单 | https://item.taobao.com/item.htm?spm=a1z09.2.0.0.62852e8d240ots&id=616606914217&_u=rc2trq169f
小计 |  |  |  |  |  |  |  | ¥0.00
Vibration Management | Rubber Compressor Foot |  | 2 | 未采购
型材框架 | OpenBuilds Angle Corner Connector | 角码 | 4 | 不用采购
 | DIN 3 Rails (35mm W) - 370mm | 设备 安装板 | 1 | 已下单 | https://detail.tmall.com/item.htm?id=543619238162&ns=1&abbucket=13&skuId=4375645299333
 | Misumi HFSB5-2020-240 | 2020-240 | 1 | 已下单 | https://detail.tmall.com/item.htm?id=589891490152&spm=a1z09.2.0.0.67002e8dhL2uUw&_u=qc2trq92e2
 | Misumi HFSB5-2020-330 | 2020-330 | 1 | 已下单 | https://detail.tmall.com/item.htm?id=589891490152&spm=a1z09.2.0.0.67002e8dhL2uUw&_u=qc2trq92e3
 | Misumi HFSB5-2020-350 | 2020-350 | 2 | 已下单 | https://detail.tmall.com/item.htm?id=589891490152&spm=a1z09.2.0.0.67002e8dhL2uUw&_u=qc2trq92e4
 | Misumi HFSB5-2020-370-TPW | 2020-370 | 10 | 已下单 | https://detail.tmall.com/item.htm?id=589891490152&spm=a1z09.2.0.0.67002e8dhL2uUw&_u=qc2trq92e5
 | Misumi HFSB5-2020-430-LCP-RCP | 2020-430 | 4 | 已下单 | https://detail.tmall.com/item.htm?id=589891490152&spm=a1z09.2.0.0.67002e8dhL2uUw&_u=qc2trq92e6
小计 |  |  |  |  |  |  |  | ¥0.00
杂项 | Fume Extractor Carbon Filter Element | 活性炭滤芯1 | 1 | 未采购
 | 4mm Bowden Coupler | 4mm 快插气动接头1 | 1 | 不用采购
 | Bowden Tube 100mm Piece (For Spool Holder) | 特氟龙管 100mm (料架用) 2 | 1 | 不用采购
 | 3M VHB Tape 5952 | 3M VHB 胶带 5952 1 | 1 | 已下单 | https://detail.tmall.com/item.htm?id=620576825408&spm=a1z09.2.0.0.20ee2e8dWNS7bw&_u=rc2trqe2f6
 | Loctite Blue Threadlocker Stick | 螺丝胶1 | 1 | 已下单 | https://detail.tmall.com/item.htm?id=611309468987&spm=a1z09.2.0.0.242b2e8dDwAsBM&_u=rc2trqf8a6
 | Mobil EP2 Grease | EP2 润滑脂1 | 1 | 已下单 | https://item.taobao.com/item.htm?id=573235803291&ns=1&abbucket=13
 | SuperLube PTFE Grease | PTFE 润滑脂1 | 1 | 已下单
 | Tesa Wire Loom Harness Tape | 耐热电工胶带1 | 1 | 已下单 | https://detail.tmall.com/item.htm?id=36505275892&ns=1&abbucket=13&skuId=3562805002211
 | 6x3mm Neodimium Magnet | 6x3mm 汝磁磁铁8 | 4 | 已下单 | https://item.taobao.com/item.htm?spm=a210c.1.0.0.79791debjgaApp&id=522032448600
 | PTFE Tube (4mm OD 3mm ID) - 1m | 铁氟龙管 | 1 | 不用采购
 | petg打印耗材 |  | 1 | 已下单
 | petg打印耗材 |  | 1 | 已下单
 | tf卡两张 |  | 1 | 已下单
 | 砂轮片 |  | 5 | 已下单
 | 25cm镜子 |  | 2 | 已下单
小计 |  |  |  |  |  |  |  | ¥0.00
线材 | Nylon Cable Ties 4" | 扎带 4" 40 | 20 | 已下单
 | 20AWG Silicone Cable (10ft total) | 20AWG 硅胶线 (10ft total=3.1m) 1 | 5 | 已下单 | https://detail.tmall.com/item.htm?id=601167338741&ns=1&abbucket=13&skuId=4371828122108
 | 24AWG Silicone Cable (250ft total) | 24AWG 硅胶线 (250ft total=77m) 1 | 0.5 | 已下单 | https://detail.tmall.com/item.htm?id=601167338741&ns=1&abbucket=13&skuId=4371828122108
 | Spade Crimp Terminal 4.8mm Female | 冷压端子 4.8mm 母头7 | 10 | 已下单 | https://detail.tmall.com/item.htm?id=548394502988&ns=1&abbucket=13&skuId=3327483737121
 | JST XH Connector Plug 4 Position | JST XH 4针插头7 | 3.5 | 已下单 | https://detail.tmall.com/item.htm?id=551195211656&cm_id=140105335569ed55e27b&abbucket=13&skuId=3423125168152
 | JST XH Connector Plug 2 Position | JST XH 2针插头6 | 3 | 已下单 | https://detail.tmall.com/item.htm?id=551195211656&cm_id=140105335569ed55e27b&abbucket=13&skuId=3423125168152
 | MicroFit3 Connector Plug 4 Position | molex 4针连接器4 | 2 | 已下单 | https://detail.tmall.com/item.htm?id=610339377518&ns=1&abbucket=13&skuId=4291527132748
 | MicroFit3 Connector Plug 3 Position | molex 3针连接器1 | 0.5 | 已下单 | https://detail.tmall.com/item.htm?id=610339377518&ns=1&abbucket=13&skuId=4291527132748
 | MicroFit3 Connector Plug 2 Position | molex 2针连接器2 | 1 | 已下单 | https://detail.tmall.com/item.htm?id=610339377518&ns=1&abbucket=13&skuId=4291527132748
 | MicroFit3 Connector Receptacle 4 Position | molex 4针插座4 | 2 | 已下单 | https://detail.tmall.com/item.htm?id=610339377518&ns=1&abbucket=13&skuId=4291527132748
 | MicroFit3 Connector Receptacle 3 Position | molex 3针插座1 | 0.5 | 已下单 | https://detail.tmall.com/item.htm?id=610339377518&ns=1&abbucket=13&skuId=4291527132748
 | MicroFit3 Connector Receptacle 2 Position | molex 2针插座2 | 1 | 已下单 | https://detail.tmall.com/item.htm?id=610339377518&ns=1&abbucket=13&skuId=4291527132748
 | JST XH Female Pin | JST XH 母头40 | 20 | 已下单 | https://detail.tmall.com/item.htm?id=608456381688&rn=9afc4e4bde5fde640c6c86a9d3878af7&abbucket=8
 | MicroFit3 Female Pin | molex MicroFit3 母头40 | 20 | 已下单 | https://detail.tmall.com/item.htm?id=608456381688&rn=9afc4e4bde5fde640c6c86a9d3878af7&abbucket=8
 | MicroFit3 Male Pin | molex MicroFit3 公头40 | 20 | 已下单 | https://detail.tmall.com/item.htm?id=608456381688&rn=9afc4e4bde5fde640c6c86a9d3878af7&abbucket=8
 | VORON XY ZipChain (printed a/b link pairs) | 10x10 拖链 (405mm) 2 | 9 | 未采购
 | VORON Z ZipChain (printed a/b link pairs) | 10x15 拖链 (545mm) 1 | 5.5 | 未采购
 | VORON XY ZipChain (printed ends) |  | 2 | 未采购
 | VORON Z ZipChain (printed ends) |  | 1 | 未采购
 |  |  |  |  |  |  |  | ¥0.00
外面板 | Coroplast Sheet - 370x370x4 mm | 塑料瓦楞板 -370x370x4mm | 2 | 已下单 | https://item.taobao.com/item.htm?spm=a1z0d.7625083.1998302264.6.5c5f4e69oFzstl&id=533229845809
 | Coroplast Sheet - 384x404x4 mm | 塑料瓦楞板 - 384x404x4mm | 1 | 已下单 | https://item.taobao.com/item.htm?spm=a1z0d.7625083.1998302264.6.5c5f4e69oFzstl&id=533229845809
 | Acrylic Sheet Clear - 192x404x2.5 mm | 透明亚克力板 -192x404x2.5 mm | 2 | 已下单 | https://detail.tmall.com/item.htm?id=45653259177&tracelogww=ltckbburl
 | Acrylic Sheet Clear - 384x404x2.5 mm | 透明亚克力板 - 384x404x2.5 mm | 2 | 已下单 | https://detail.tmall.com/item.htm?id=45653259177&tracelogww=ltckbburl
 | Acrylic Sheet Clear - 384x384x2.5 mm | 透明亚克力板 - 384x384x2.5 mm | 1 | 已下单 | https://detail.tmall.com/item.htm?id=45653259177&tracelogww=ltckbburl
 |  |  |  |  |  |  |  | ¥0.00
Buildplate | 3M 468MP Adhesive Sheet - 10"x10" | 3M 468MP 无基材双面胶 - 10"x10" 1 | 1 | 已下单 | https://item.taobao.com/item.htm?id=641310406256&ns=1&abbucket=13
 | PEI 0.04" Sheet - 10"x10" | 0.04" PEI板 - 10"x10" 1 | 1 | 未采购
 | MIC6 5/16" Plate - 10"x10" | 5/16" MIC6铝合金板 - 10"x10" 1 | 1 | 已下单 | https://item.taobao.com/item.htm?spm=a210c.1.0.0.52681debmuVBVf&id=614474644547
 | Keenovo Silicone AC Heater w/ thermistor - 200x200mm (300W) | AC加热床 - 200x200mm (300W) 1 | 1 | 已下单 | https://item.taobao.com/item.htm?spm=a1z09.2.0.0.4da02e8dQx73aA&id=632527218556&_u=rc2trq03a6
小计 |  |  |  |  |  |  |  | ¥0.00
合计 |  |  |  |  |  |  |  |  | ¥0.00
