zhcntiangang/seahorse.github.io/voron/Voron Printed Part Reference.xlsx

Sheet: V0.1
Location |  |  | Part | Color | Quantity | Essential (PIF provided) | Non-Essential | Notes
Base |  |  | A_Drive_Frame_Lower_x1 | Primary | 1 | Included
Base |  |  | A_Drive_Frame_Upper_x1 | Primary | 1 | Included
Base |  |  | A_Idler_Lower_x1 | Primary | 1 | Included
Base |  |  | A_Idler_Upper_x1 | Primary | 1 | Included
Base |  |  | B_Drive_Frame_Lower_x1 | Primary | 1 | Included
Base |  |  | B_Drive_Frame_Upper_x1 | Primary | 1 | Included
Base |  |  | B_Idler_Lower_x1 | Primary | 1 | Included
Base |  |  | B_Idler_Upper_x1 | Primary | 1 | Included
Base |  |  | Front_Bed_Mount_x1 | Primary | 1 | Included
Base |  |  | M2_Nut_Adapter_Rotated_x5 | Primary | 5 | Included
Base |  |  | MGN7_Rail_Guide_x2 | Primary | 2 | Included
Base |  |  | PSU_Cover_x1 | Primary | 1 |  | Cosmetic
Base |  |  | Power_Inlet_x1 | Primary | 1 | Included
Base |  |  | Raspberry_Pi_3b_Mount_x1 | Primary | 1 | Included
Base |  |  | Rear_Bed_Mount_Left_x1 | Primary | 1 | Included
Base |  |  | Rear_Bed_Mount_Right_x1 | Primary | 1 | Included
Base |  |  | Skirt_mirror_x3 | Primary | 3 |  | Cosmetic
Base |  |  | Skirt_x3 | Primary | 3 |  | Cosmetic
Base |  |  | Skr_E3_Mounting_Bracket_x1 | Primary | 1 | Included
Base |  |  | Spool_Holder_V0_x1 | Primary | 1 | Included
Base |  |  | T8_Nut_Block_16mmx22mmOD_x1 | Primary | 1 | Optional
Base |  |  | T8_Nut_Block_18mmx24mmOD_x1 | Primary | 1 | Included
Base |  |  | XY_Joint_Left_Lower_x1 | Primary | 1 | Included
Base |  |  | XY_Joint_Left_Upper_x1 | Primary | 1 | Included
Base |  |  | XY_Joint_Right_Lower_x1 | Primary | 1 | Included
Base |  |  | XY_Joint_Right_Upper_x1 | Primary | 1 | Included
Base |  |  | [a]_9mm_Spacer_x6 | Alternate | 6 | Included
Base |  |  | [a]_A_Drive_Tensioner_x1 | Alternate | 1 | Included
Base |  |  | [a]_B_Drive_Tensione_x1 | Alternate | 1 | Included
Base |  |  | [a]_Cable_Tie_x1 | Alternate | 1 | Included
Base |  |  | [a]_Foot_Front_x2 | Alternate | 2 | Included
Base |  |  | [a]_Foot_Rear_Left_x1 | Alternate | 1 | Included
Base |  |  | [a]_Foot_Rear_Right_x1 | Alternate | 1 | Included
Base |  |  | [a]_Railstops_x6 | Alternate | 6 | Included
Base |  |  | [a]_Tensioner_Knob_x2 | Alternate | 2 | Included
Base |  |  | [a]_Thumb_Nut_x3 | Alternate | 3 | Included
Base |  |  | [a]_X_Endstop_Bumper_x1 | Alternate | 1 | Included
Base |  |  | [a]_Z_Endstop_Mount_x1 | Alternate | 1 | Included
Base |  |  | [a]_Z_Motor_Mount_x1 | Alternate | 1 | Included
Panel_Mounting |  |  | Door_Handle_x1 | Primary | 1 |  | Cosmetic
Panel_Mounting |  |  | Door_Latch_x2 | Primary | 2 |  | Cosmetic
Panel_Mounting | For_2.5mm_Panels |  | 2point5mm_Bottom_Corner_Front_x1 | Primary | 1 |  | Cosmetic
Panel_Mounting | For_2.5mm_Panels |  | 2point5mm_Bottom_Corner_Rear_mirror_x1 | Primary | 1 |  | Cosmetic
Panel_Mounting | For_2.5mm_Panels |  | 2point5mm_Bottom_Corner_Rear_x1 | Primary | 1 |  | Cosmetic
Panel_Mounting | For_2.5mm_Panels |  | 2point5mm_Bottom_Corner_Side_mirror_x1 | Primary | 1 |  | Cosmetic
Panel_Mounting | For_2.5mm_Panels |  | 2point5mm_Bottom_Corner_Side_x2 | Primary | 2 |  | Cosmetic
Panel_Mounting | For_2.5mm_Panels |  | 2point5mm_Hinge_Bottom_A_x1 | Primary | 1 |  | Cosmetic
Panel_Mounting | For_2.5mm_Panels |  | 2point5mm_Hinge_Bottom_B_x1 | Primary | 1 |  | Cosmetic
Panel_Mounting | For_2.5mm_Panels |  | 2point5mm_Hinge_Top_A_x1 | Primary | 1 |  | Cosmetic
Panel_Mounting | For_2.5mm_Panels |  | 2point5mm_Hinge_Top_B_x1 | Primary | 1 |  | Cosmetic
Panel_Mounting | For_2.5mm_Panels |  | 2point5mm_Middle_Clip_x9 | Primary | 9 |  | Cosmetic
Panel_Mounting | For_2.5mm_Panels |  | 2point5mm_Top_Corner_Front_x1 | Primary | 1 |  | Cosmetic
Panel_Mounting | For_2.5mm_Panels |  | 2point5mm_Top_Corner_Rear_mirror_x1 | Primary | 1 |  | Cosmetic
Panel_Mounting | For_2.5mm_Panels |  | 2point5mm_Top_Corner_Rear_x1 | Primary | 1 |  | Cosmetic
Panel_Mounting | For_2.5mm_Panels |  | 2point5mm_Top_Corner_Side_mirror_x1 | Primary | 1 |  | Cosmetic
Panel_Mounting | For_2.5mm_Panels |  | 2point5mm_Top_Corner_Side_x2 | Primary | 2 |  | Cosmetic
Panel_Mounting | For_2mm_Panels |  | 2mm_Bottom_Corner_Front_x1 | Primary | 1 |  | Cosmetic
Panel_Mounting | For_2mm_Panels |  | 2mm_Bottom_Corner_Rear_mirror_x1 | Primary | 1 |  | Cosmetic
Panel_Mounting | For_2mm_Panels |  | 2mm_Bottom_Corner_Rear_x1 | Primary | 1 |  | Cosmetic
Panel_Mounting | For_2mm_Panels |  | 2mm_Bottom_Corner_Side_mirror_x1 | Primary | 1 |  | Cosmetic
Panel_Mounting | For_2mm_Panels |  | 2mm_Bottom_Corner_Side_x2 | Primary | 2 |  | Cosmetic
Panel_Mounting | For_2mm_Panels |  | 2mm_Hinge_Bottom_A_x1 | Primary | 1 |  | Cosmetic
Panel_Mounting | For_2mm_Panels |  | 2mm_Hinge_Bottom_B_x1 | Primary | 1 |  | Cosmetic
Panel_Mounting | For_2mm_Panels |  | 2mm_Hinge_Top_A_x1 | Primary | 1 |  | Cosmetic
Panel_Mounting | For_2mm_Panels |  | 2mm_Hinge_Top_B_x1 | Primary | 1 |  | Cosmetic
Panel_Mounting | For_2mm_Panels |  | 2mm_Middle_Clip_x9 | Primary | 9 |  | Cosmetic
Panel_Mounting | For_2mm_Panels |  | 2mm_Top_Corner_Front_x1 | Primary | 1 |  | Cosmetic
Panel_Mounting | For_2mm_Panels |  | 2mm_Top_Corner_Rear_mirror_x1 | Primary | 1 |  | Cosmetic
Panel_Mounting | For_2mm_Panels |  | 2mm_Top_Corner_Rear_x1 | Primary | 1 |  | Cosmetic
Panel_Mounting | For_2mm_Panels |  | 2mm_Top_Corner_Side_mirror_x1 | Primary | 1 |  | Cosmetic
Panel_Mounting | For_2mm_Panels |  | 2mm_Top_Corner_Side_x2 | Primary | 2 |  | Cosmetic
Panel_Mounting | For_3mm_Panels |  | 3mm_Bottom_Corner_Front_x1 | Primary | 1 |  | Cosmetic
Panel_Mounting | For_3mm_Panels |  | 3mm_Bottom_Corner_Rear_mirror_x1 | Primary | 1 |  | Cosmetic
Panel_Mounting | For_3mm_Panels |  | 3mm_Bottom_Corner_Rear_x1 | Primary | 1 |  | Cosmetic
Panel_Mounting | For_3mm_Panels |  | 3mm_Bottom_Corner_Side_mirror_x1 | Primary | 1 |  | Cosmetic
Panel_Mounting | For_3mm_Panels |  | 3mm_Bottom_Corner_Side_x2 | Primary | 2 |  | Cosmetic
Panel_Mounting | For_3mm_Panels |  | 3mm_Hinge_Bottom_A_x1 | Primary | 1 |  | Cosmetic
Panel_Mounting | For_3mm_Panels |  | 3mm_Hinge_Bottom_B_x1 | Primary | 1 |  | Cosmetic
Panel_Mounting | For_3mm_Panels |  | 3mm_Hinge_Top_A_x1 | Primary | 1 |  | Cosmetic
Panel_Mounting | For_3mm_Panels |  | 3mm_Hinge_Top_B_x1 | Primary | 1 |  | Cosmetic
Panel_Mounting | For_3mm_Panels |  | 3mm_Middle_Clip_x9 | Primary | 9 |  | Cosmetic
Panel_Mounting | For_3mm_Panels |  | 3mm_Top_Corner_Front_x1 | Primary | 1 |  | Cosmetic
Panel_Mounting | For_3mm_Panels |  | 3mm_Top_Corner_Rear_mirror_x1 | Primary | 1 |  | Cosmetic
Panel_Mounting | For_3mm_Panels |  | 3mm_Top_Corner_Rear_x1 | Primary | 1 |  | Cosmetic
Panel_Mounting | For_3mm_Panels |  | 3mm_Top_Corner_Side_mirror_x1 | Primary | 1 |  | Cosmetic
Panel_Mounting | For_3mm_Panels |  | 3mm_Top_Corner_Side_x2 | Primary | 2 |  | Cosmetic
Toolheads | Bowden | Dragon_Toolhead | Toolhead_Left_Dragon_x1 | Primary | 1 | Check With Provider
Toolheads | Bowden | Dragon_Toolhead | Toolhead_Right_Dragon_x1 | Primary | 1
Toolheads | Bowden | Dragon_Toolhead | [a]_Toolhead_Blower_Duct_Left_x1 | Alternate | 1
Toolheads | Bowden | Dragon_Toolhead | [a]_Toolhead_Blower_Duct_Right_x1 | Alternate | 1
Toolheads | Bowden | Mosquito_Toolhead | Toolhead_Left_Mosquito_x1 | Primary | 1
Toolheads | Bowden | Mosquito_Toolhead | Toolhead_Right_Mosquito_x1 | Primary | 1
Toolheads | Bowden | Mosquito_Toolhead | [a]_Toolhead_Blower_Duct_Left_x1 | Alternate | 1
Toolheads | Bowden | Mosquito_Toolhead | [a]_Toolhead_Blower_Duct_Right_x1 | Alternate | 1
Toolheads | Bowden | Threaded_V6_Toolhead | Toolhead_Left_Threaded_V6_x1 | Primary | 1
Toolheads | Bowden | Threaded_V6_Toolhead | Toolhead_Right_Threaded_V6_x1 | Primary | 1
Toolheads | Bowden | Threaded_V6_Toolhead | [a]_Toolhead_Blower_Duct_Left_TV6_x1 | Alternate | 1
Toolheads | Bowden | Threaded_V6_Toolhead | [a]_Toolhead_Blower_Duct_Right_TV6_x1 | Alternate | 1
Toolheads | Bowden |  | [a]_Endstop_Strike_Block_x1 | Alternate | 1 |  | Optional
Toolheads | Mini_Afterburner | Dragon_Toolhead_DD | [a]_Cowling_dragon_MULTIBODY_x1 | Alternate | 1 | Included - Choose one hot end
Toolheads | Mini_Afterburner | Dragon_Toolhead_DD | [a]_Cowling_dragon_x1 | Alternate | 1
Toolheads | Mini_Afterburner | Dragon_Toolhead_DD | [a]_Mid_Body_Dragon_x1 | Alternate | 1
Toolheads | Mini_Afterburner | Dragonfly_BMO_Toolhead_DD | [a]_Cowling_BMO_MULTIBODY_x1 | Alternate | 1
Toolheads | Mini_Afterburner | Dragonfly_BMO_Toolhead_DD | [a]_Cowling_BMO_x1 | Alternate | 1
Toolheads | Mini_Afterburner | Dragonfly_BMO_Toolhead_DD | [a]_Mid_Body_BMO_x1 | Alternate | 1
Toolheads | Mini_Afterburner | Mosquito_Toolhead_DD | [a]_Cowling_Mosquito_MULTIBODY_x1 | Alternate | 1 |  | Not Supported | PIF no longer supports Slice products
Toolheads | Mini_Afterburner | Mosquito_Toolhead_DD | [a]_Cowling_Mosquito_x1 | Alternate | 1
Toolheads | Mini_Afterburner | Mosquito_Toolhead_DD | [a]_Mid_Body_Mosquito_x1 | Alternate | 1
Toolheads | Mini_Afterburner |  | Cowling_LOGO_ONLY_x1 | Primary | 1 |  | Optional
Toolheads | Mini_Afterburner |  | Guidler_DD_x1 | Primary | 1 | Included
Toolheads | Mini_Afterburner |  | Latch_DD_x1 | Primary | 1 | Included
Toolheads | Mini_Afterburner |  | Latch_Shuttle_DD_x1 | Primary | 1 | Included
Toolheads | Mini_Afterburner |  | Motor_Frame_x1 | Primary | 1 | Included
Toolheads | Mini_Afterburner |  | Strain_Relief_Body_x1 | Primary | 1 | Included
Toolheads | Mini_Afterburner |  | Strain_Relief_Spacers_x2 | Primary | 2 | Included
Toolheads | Mini_Afterburner |  | X_Carriage_90_x1 | Primary | 1 | Included
Tools |  |  | AB_pulley_jig_x1 | Primary | 1 |  | Optional
Tools |  |  | BMG_Shaft_Mod_Spacer_x1 | Primary | 1 | Included
Tools |  |  | T-Nut_Mod_Tool_x1 | Primary | 1 | Included
Tools |  |  | V0_Extrusion_Drilling_Guide_x1 | Primary | 1 | Included
Tophat |  |  | Front_and_Rear_Midclip_x2 | Primary | 2 | Check Provider
Tophat |  |  | Left_and_Right_Midclip_x2 | Primary | 2 | Check Provider
Tophat |  |  | Lower_Corner_1_and_3_Clip_x2 | Primary | 2 | Check Provider
Tophat |  |  | Lower_Corner_2_and_4_Clip_x2 | Primary | 2 | Check Provider
Tophat |  |  | Tophat_Part1_x1 | Primary | 1 | Check Provider
Tophat |  |  | Tophat_Part2_x2 | Primary | 2 | Check Provider
Tophat |  |  | Tophat_Part3_x1 | Primary | 1 | Check Provider
Tophat |  |  | Unibody_Tophat_x1 | Primary | 1 | Check Provider
Tophat |  |  | Upper_Corner_1_and_3_Clip_x2 | Primary | 2 | Check Provider
Tophat |  |  | Upper_Corner_2_and_4_Clip_x2 | Primary | 2 | Check Provider
Last Updated: | 2021-08-26

Sheet: Trident
Location |  |  |  |  | Part | Color | Quantity | Essential (PIF provided) | Non-Essential | Notes
ElectronicsBay | Controller_Mounts |  |  |  | BTT_MOT_EXP_bracket | Primary | 1 | Included - Choose One
ElectronicsBay | Controller_Mounts |  |  |  | Duet2_Duet3Mini5_bracket_2pc | Primary | 1
ElectronicsBay | Controller_Mounts |  |  |  | GTR_bracket_2pc | Primary | 1
ElectronicsBay | Controller_Mounts |  |  |  | Octopus_bracket_2pc | Primary | 1
ElectronicsBay | Controller_Mounts |  |  |  | SKR_Pro_bracket_2pc | Primary | 1
ElectronicsBay | Controller_Mounts |  |  |  | SKR_bracket_inline_2pc | Primary | 1
ElectronicsBay | Controller_Mounts |  |  |  | Spider_bracket_2pc | Primary | 1
ElectronicsBay |  |  |  |  | DIN_center_support_x2 | Primary | 2 | Included
ElectronicsBay |  |  |  |  | DIN_frame_mount_x4 | Primary | 4 | Included
ElectronicsBay | Other_PS_Mounts |  |  |  | UHP_200_Mount_x2 | Primary | 2 |  | Optional
ElectronicsBay | Other_PS_Mounts |  |  |  | UHP_350_Mount_x2 | Primary | 2 |  | Optional
ElectronicsBay |  |  |  |  | PSU_stabilizer_50mm | Primary | 1 | Included
ElectronicsBay |  |  |  |  | cable_frame_anchor_x6 | Primary | 6 | Included
ElectronicsBay |  |  |  |  | lrs_psu_bracket_x2 | Primary | 2 | Included
ElectronicsBay |  |  |  |  | pcb_din_clip_v2_x5 | Primary | 5 | Included
ElectronicsBay |  |  |  |  | raspberrypi_bracket | Primary | 1 | Included
ElectronicsBay |  |  |  |  | rs25_psu_bracket | Primary | 1 | Included
Exhaust_Filter |  |  |  |  | [a]_exhaust_filter_mount_x2 | Alternate | 2 |  | Optional
Exhaust_Filter |  |  |  |  | [a]_filter_access_cover | Alternate | 1 |  | Optional
Exhaust_Filter |  |  |  |  | exhaust_filter_grill | Primary | 1 |  | Optional
Exhaust_Filter |  |  |  |  | exhaust_filter_housing | Primary | 1 |  | Optional
Gantry | AB_Drive_Units |  |  |  | [a]_wire_cover | Alternate | 1 | Included
Gantry | AB_Drive_Units |  |  |  | [a]_y_endstop_bumper | Alternate | 1 | Included
Gantry | AB_Drive_Units |  |  |  | [a]_y_endstop_housing | Alternate | 1 | Included
Gantry | AB_Drive_Units |  |  |  | a_drive_frame_lower | Primary | 1 | Included
Gantry | AB_Drive_Units |  |  |  | a_drive_frame_upper | Primary | 1 | Included
Gantry | AB_Drive_Units |  |  |  | b_drive_frame_lower | Primary | 1 | Included
Gantry | AB_Drive_Units |  |  |  | b_drive_frame_upper | Primary | 1 | Included
Gantry | Front_Idlers |  |  |  | [a]_tensioner_left | Alternate | 1 | Included
Gantry | Front_Idlers |  |  |  | [a]_tensioner_right | Alternate | 1 | Included
Gantry | Front_Idlers |  |  |  | front_idler_a_x2 | Primary | 2 | Included
Gantry | Front_Idlers |  |  |  | front_idler_b_x2 | Primary | 2 | Included
Gantry | X_Axis | XY_Joints |  |  | [a]_endstop_pod_hall_effect | Alternate | 1 | Check Provider |  | Only one needed based on endstop type selected
Gantry | X_Axis | XY_Joints |  |  | [a]_endstop_pod_microswitch | Alternate | 1 | Included
Gantry | X_Axis | XY_Joints |  |  | [a]_xy_joint_cable_bridge_2hole | Alternate | 1 | Included |  | Only one needed based on chain type
Gantry | X_Axis | XY_Joints |  |  | [a]_xy_joint_cable_bridge_3hole | Alternate | 1 | Included
Gantry | X_Axis | XY_Joints |  |  | xy_joint_left_lower_MGN12 | Primary | 1 | Included
Gantry | X_Axis | XY_Joints |  |  | xy_joint_left_upper_MGN12 | Primary | 1 | Included
Gantry | X_Axis | XY_Joints |  |  | xy_joint_right_lower_MGN12 | Primary | 1 | Included
Gantry | X_Axis | XY_Joints |  |  | xy_joint_right_upper_MGN12 | Primary | 1 | Included
Gantry | X_Axis | X_Carriage | Bowden |  | bowden_module_front | Primary | 1 |  | Optional
Gantry | X_Axis | X_Carriage | Bowden |  | bowden_module_rear_10x11chains | Primary | 1 |  | Optional
Gantry | X_Axis | X_Carriage | Bowden |  | bowden_module_rear_igus | Primary | 1 |  | Optional
Gantry | X_Axis | X_Carriage | Bowden |  | bsp_adapter | Primary | 1 |  | Optional
Gantry | X_Axis | X_Carriage | Bowden |  | tl_collet_adapter | Primary | 1 |  | Optional
Gantry | X_Axis | X_Carriage | Direct Feed |  | [a]_connector_cover | Alternate | 1 | Included
Gantry | X_Axis | X_Carriage | Direct Feed |  | [a]_guidler | Alternate | 1 | Included
Gantry | X_Axis | X_Carriage | Direct Feed |  | [a]_latch | Alternate | 1 | Included
Gantry | X_Axis | X_Carriage | Direct Feed |  | [a]_latch_shuttle | Alternate | 1 | Included
Gantry | X_Axis | X_Carriage | Direct Feed |  | chain_anchor_2hole | Primary | 1 | Included
Gantry | X_Axis | X_Carriage | Direct Feed |  | chain_anchor_3hole | Primary | 1 | Included
Gantry | X_Axis | X_Carriage | Direct Feed |  | extruder_body | Primary | 1 | Included
Gantry | X_Axis | X_Carriage | Direct Feed |  | extruder_motor_plate | Primary | 1 | Included
Gantry | X_Axis | X_Carriage | Toolheads | Dragon | printhead_front_dragon | Primary | 1 | Included - Choose One Hot End
Gantry | X_Axis | X_Carriage | Toolheads | Dragon | printhead_rear_dragon | Primary | 1
Gantry | X_Axis | X_Carriage | Toolheads | Dragonfly_BMO | printhead_front_dragonfly_bmo | Primary | 1
Gantry | X_Axis | X_Carriage | Toolheads | Dragonfly_BMO | printhead_rear_dragonfly_bmo | Primary | 1
Gantry | X_Axis | X_Carriage | Toolheads | Dragonfly_BMS | printhead_front_dragonfly_bms | Primary | 1
Gantry | X_Axis | X_Carriage | Toolheads | Dragonfly_BMS | printhead_rear_dragonfly_bms | Primary | 1
Gantry | X_Axis | X_Carriage | Toolheads | E3D V6 | printhead_front_e3dv6 | Primary | 1
Gantry | X_Axis | X_Carriage | Toolheads | E3D V6 | printhead_rear_e3dv6 | Primary | 1
Gantry | X_Axis | X_Carriage | Toolheads | Slice Mosquito | printhead_front_mosquito | Primary | 1 |  | Not Supported | PIF no longer supports Slice products
Gantry | X_Axis | X_Carriage | Toolheads | Slice Mosquito | printhead_rear_mosquito | Primary | 1
Gantry | X_Axis | X_Carriage |  |  | [a]_blower_housing_front | Alternate | 1 | Included
Gantry | X_Axis | X_Carriage |  |  | blower_housing_rear | Primary | 1 | Included
Gantry | X_Axis | X_Carriage |  |  | hotend_fan_mount | Primary | 1 | Included
Gantry | X_Axis | X_Carriage |  |  | probe_retainer_bracket | Primary | 1 | Included
Gantry | X_Axis | X_Carriage |  |  | x_carriage_frame_left | Primary | 1 | Included
Gantry | X_Axis | X_Carriage |  |  | x_carriage_frame_right | Primary | 1 | Included
Panels | Front_Doors |  |  |  | door_hinge_x6 | Primary | 6 |  | Cosmetic
Panels | Front_Doors |  |  |  | handle_a_x2 | Primary | 2 |  | Cosmetic
Panels | Front_Doors |  |  |  | handle_b_x2 | Primary | 2 |  | Cosmetic
Panels | Front_Doors |  |  |  | latch_x2 | Primary | 2 |  | Cosmetic
Panels |  |  |  |  | bottom_panel_clip_x4 | Primary | 4 |  | Cosmetic
Panels |  |  |  |  | bottom_panel_hinge_x2 | Primary | 2 |  | Cosmetic
Panels |  |  |  |  | corner_panel_clip_4mm_x8 | Primary | 8 |  | Cosmetic | 4mm clips intended for back and top
Panels |  |  |  |  | corner_panel_clip_6mm_x8 | Primary | 8 |  | Cosmetic | 8mm clips intended for sides
Panels |  |  |  |  | deck_support_3mm_x8 | Primary | 8 | Included
Panels |  |  |  |  | deck_support_4mm_x8 | Primary | 8 |  | Optional | For use with thinner deck material (PC, ACM)
Panels |  |  |  |  | midspan_panel_clip_4mm_x7 | Primary | 7 |  | Cosmetic | 4mm clips intended for back and top
Panels |  |  |  |  | midspan_panel_clip_6mm_x8 | Primary | 8 |  | Cosmetic | 8mm clips intended for sides
Panels |  |  |  |  | wire_corner_left | Primary | 1 |  | Cosmetic
Panels |  |  |  |  | wire_corner_right | Primary | 1 |  | Cosmetic
Skirt | 250 |  |  |  | front_skirt_a_250 | Primary | 1 |  | Cosmetic - Select based on frame size
Skirt | 250 |  |  |  | front_skirt_b_250 | Primary | 1
Skirt | 250 |  |  |  | rear_center_skirt_250 | Primary | 1
Skirt | 250 |  |  |  | side_skirt_a_250_x2 | Primary | 2
Skirt | 250 |  |  |  | side_skirt_b_250_x2 | Primary | 2
Skirt | 300 |  |  |  | front_skirt_a_300 | Primary | 1
Skirt | 300 |  |  |  | front_skirt_b_300 | Primary | 1
Skirt | 300 |  |  |  | rear_center_skirt_300 | Primary | 1
Skirt | 300 |  |  |  | side_skirt_a_300_x2 | Primary | 2
Skirt | 300 |  |  |  | side_skirt_b_300_x2 | Primary | 2
Skirt | 350 |  |  |  | front_skirt_a_350 | Primary | 1
Skirt | 350 |  |  |  | front_skirt_b_350 | Primary | 1
Skirt | 350 |  |  |  | rear_center_skirt_350 | Primary | 1
Skirt | 350 |  |  |  | side_skirt_a_350_x2 | Primary | 2
Skirt | 350 |  |  |  | side_skirt_b_350_x2 | Primary | 2
Skirt |  |  |  |  | [a]_60mm_fan_blank_insert_x2 | Alternate | 2 |  | Cosmetic
Skirt |  |  |  |  | [a]_corner_baseplate_a_x2 | Alternate | 2 | Included
Skirt |  |  |  |  | [a]_corner_baseplate_b_x2 | Alternate | 2 | Included
Skirt |  |  |  |  | [a]_keystone_blank_insert_x2 | Alternate | 2 |  | Cosmetic
Skirt |  |  |  |  | [a]_mini12864_case_front_insert | Alternate | 1 |  | Optional
Skirt |  |  |  |  | [a]_mini12864_case_hinge | Alternate | 1 |  | Optional
Skirt |  |  |  |  | [a]_skirt_logo_x2 | Alternate | 2 |  | Cosmetic
Skirt |  |  |  |  | corner_a_x2 | Primary | 2 | Included
Skirt |  |  |  |  | corner_b_x2 | Primary | 2 | Included
Skirt |  |  |  |  | keystone_panel | Primary | 1 |  | Cosmetic
Skirt |  |  |  |  | mini12864_case_front | Primary | 1 |  | Optional
Skirt |  |  |  |  | mini12864_case_rear | Primary | 1 |  | Optional
Skirt |  |  |  |  | power_inlet_adamstech | Primary | 1 |  | Optional
Skirt |  |  |  |  | power_inlet_filtered | Primary | 1 | Included
Skirt |  |  |  |  | side_fan_support_x2 | Primary | 2 |  | Cosmetic
Spool_Management |  |  |  |  | bowen_retainer | Primary | 1 | Included
Spool_Management |  |  |  |  | spool_holder | Primary | 1 | Included
Tools |  |  |  |  | 10mm_extrusion_drill_guide | Primary | 1 | Included |  | Intended for 1.8 -> Trident conversion
Tools |  |  |  |  | 110mm_Y_alignment_spacer_x2 | Primary | 2 | Included
Tools |  |  |  |  | 140mm_extrusion_drill_guide | Primary | 1 | Included |  | Intended for 1.8 -> Trident conversion
Tools |  |  |  |  | AB_pulley_jig | Primary | 1 | Included
Tools |  |  |  |  | MGN12_rail_guide_x2 | Primary | 2 | Included
Tools |  |  |  |  | MGN9_rail_guide_x2 | Primary | 2 | Included
Z_Assembly |  |  |  |  | [a]_z_carriage_left | Alternate | 1 | Included
Z_Assembly |  |  |  |  | [a]_z_carriage_right | Alternate | 1 | Included
Z_Assembly |  |  |  |  | [a]_z_rail_stop_x3 | Alternate | 3 | Included
Z_Assembly |  |  |  |  | nozzle_probe | Primary | 1 | Included
Z_Assembly |  |  |  |  | z_bed_left | Primary | 1 | Included
Z_Assembly |  |  |  |  | z_bed_rear | Primary | 1 | Included
Z_Assembly |  |  |  |  | z_bed_right | Primary | 1 | Included
Z_Assembly |  |  |  |  | z_cable_chain_mount_2hole | Primary | 1 | Included |  | Only one needed based on chain type
Z_Assembly |  |  |  |  | z_cable_chain_mount_3hole | Primary | 1 | Included
Z_Assembly |  |  |  |  | z_carriage_left | Primary | 1 | Included
Z_Assembly |  |  |  |  | z_carriage_rear_2hole | Primary | 1 | Included |  | Only one needed based on chain type
Z_Assembly |  |  |  |  | z_carriage_rear_3hole | Primary | 1 | Included
Z_Assembly |  |  |  |  | z_carriage_right | Primary | 1 | Included
Z_Assembly |  |  |  |  | z_rear_extrusionbracket_left | Primary | 1 | Included
Z_Assembly |  |  |  |  | z_rear_extrusionbracket_right | Primary | 1 | Included
Z_Assembly |  |  |  |  | z_stepper_left | Primary | 1 | Included
Z_Assembly |  |  |  |  | z_stepper_rear | Primary | 1 | Included
Z_Assembly |  |  |  |  | z_stepper_right | Primary | 1 | Included
Last Updated: | 2021-11-26

Sheet: V2.4
目录 |  |  |  |  | 组件 | 实际称重 | 必不可少的 (提供PIF) | 非必需 | Notes
Electronics_Bay | Controller_Mounts |  |  |  | BIGDIPPER_bracket_set |  | 包括 -从这里面选一个
Electronics_Bay | Controller_Mounts |  |  |  | BTT_MOT_EXP_bracket
Electronics_Bay | Controller_Mounts |  |  |  | Duet2_Duet3Mini5_bracket_set
Electronics_Bay | Controller_Mounts |  |  |  | GTR_bracket_set
Electronics_Bay | Controller_Mounts |  |  |  | Octopus_bracket_set
Electronics_Bay | Controller_Mounts |  |  |  | S6_bracket_set
Electronics_Bay | Controller_Mounts |  |  |  | SKR_Pro_bracket_set
Electronics_Bay | Controller_Mounts |  |  |  | SKR_bracket_inline_set
Electronics_Bay | Controller_Mounts |  |  |  | Spider_bracket_set
Electronics_Bay | Other_PS_Mounts |  |  |  | UHP_200_Mount_x2 |  |  | Optional
Electronics_Bay | Other_PS_Mounts |  |  |  | UHP_350_Mount_x2 |  |  | Optional
Electronics_Bay |  |  |  |  | PSU_stabilizer_50mm |  | Included
Electronics_Bay |  |  |  |  | lrs_200_psu_bracket_x2.stl |  | Included
Electronics_Bay |  |  |  |  | pcb_din_clip_x3 |  | Included
Electronics_Bay |  |  |  |  | raspberrypi_bracket |  | Included
Electronics_Bay |  |  |  |  | rs25_psu_bracket |  | Included
Electronics_Bay |  |  |  |  | wago_221-415_mount_3x5 |  |  | Optional
Exhaust_Filter |  |  |  |  | [a]_exhaust_fan_grill |  |  | Optional
Exhaust_Filter |  |  |  |  | [a]_exhaust_filter_mount_x2 |  |  | Optional
Exhaust_Filter |  |  |  |  | [a]_filter_access_cover |  |  | Optional
Exhaust_Filter |  |  |  |  | exhaust_filter_grill |  |  | Optional
Exhaust_Filter |  |  |  |  | exhaust_filter_housing |  |  | Optional
Gantry | AB_Drive_Units |  |  |  | [a]_cable_cover |  | Included
Gantry | AB_Drive_Units |  |  |  | [a]_z_chain_retainer_bracket_x2 |  | Included
Gantry | AB_Drive_Units |  |  |  | a_drive_frame_lower |  | Included
Gantry | AB_Drive_Units |  |  |  | a_drive_frame_upper |  | Included
Gantry | AB_Drive_Units |  |  |  | b_drive_frame_lower |  | Included
Gantry | AB_Drive_Units |  |  |  | b_drive_frame_upper |  | Included
Gantry | Front_Idlers |  |  |  | [a]_tensioner_left |  | Included
Gantry | Front_Idlers |  |  |  | [a]_tensioner_right |  | Included
Gantry | Front_Idlers |  |  |  | front_idler_left_lower |  | Included
Gantry | Front_Idlers |  |  |  | front_idler_left_upper |  | Included
Gantry | Front_Idlers |  |  |  | front_idler_right_lower |  | Included
Gantry | Front_Idlers |  |  |  | front_idler_right_upper |  | Included
Gantry | X_Axis | XY_Joints |  |  | [a]_endstop_pod_D2F_switch |  | Included |  | Only one needed based on endstop type selected
Gantry | X_Axis | XY_Joints |  |  | [a]_endstop_pod_hall_effect |  | Included
Gantry | X_Axis | XY_Joints |  |  | [a]_xy_joint_cable_bridge_2hole |  | Included |  | Only one needed based on chain type
Gantry | X_Axis | XY_Joints |  |  | [a]_xy_joint_cable_bridge_3hole |  | Included
Gantry | X_Axis | XY_Joints |  |  | xy_joint_left_lower_MGN12 |  | Included
Gantry | X_Axis | XY_Joints |  |  | xy_joint_left_upper_MGN12 |  | Included
Gantry | X_Axis | XY_Joints |  |  | xy_joint_right_lower_MGN12 |  | Included
Gantry | X_Axis | XY_Joints |  |  | xy_joint_right_upper_MGN12 |  | Included
Gantry | X_Axis | X_Carriage | Bowden |  | bowden_dual_front_a |  |  | Optional
Gantry | X_Axis | X_Carriage | Bowden |  | bowden_dual_front_b |  |  | Optional
Gantry | X_Axis | X_Carriage | Bowden |  | bowden_rear |  |  | Optional
Gantry | X_Axis | X_Carriage | Bowden |  | bowden_single_bsp_adapter |  |  | Optional
Gantry | X_Axis | X_Carriage | Bowden |  | bowden_single_front |  |  | Optional
Gantry | X_Axis | X_Carriage | Bowden |  | bowden_single_tl_collet_adapter |  |  | Optional
Gantry | X_Axis | X_Carriage | Direct_Feed |  | [a]_connector_cover |  | Included
Gantry | X_Axis | X_Carriage | Direct_Feed |  | [a]_guidler |  | Included
Gantry | X_Axis | X_Carriage | Direct_Feed |  | [a]_latch |  | Included
Gantry | X_Axis | X_Carriage | Direct_Feed |  | [a]_latch_shuttle |  | Included
Gantry | X_Axis | X_Carriage | Direct_Feed |  | chain_anchor_2hole |  | Included |  | Only one needed based on chain type
Gantry | X_Axis | X_Carriage | Direct_Feed |  | chain_anchor_3hole |  | Included
Gantry | X_Axis | X_Carriage | Direct_Feed |  | extruder_body |  | Included
Gantry | X_Axis | X_Carriage | Direct_Feed |  | extruder_motor_plate |  | Included
Gantry | X_Axis | X_Carriage | Direct_Feed |  | extruder_motor_plate_for_pcb |  |  | Optional
Gantry | X_Axis | X_Carriage | Printheads | Dragon | printhead_front_dragon |  | 这里面选一个
Gantry | X_Axis | X_Carriage | Printheads | Dragon | printhead_rear_dragon
Gantry | X_Axis | X_Carriage | Printheads | Dragonfly_BMO | printhead_front_dragonfly_bmo
Gantry | X_Axis | X_Carriage | Printheads | Dragonfly_BMO | printhead_rear_dragonfly_bmo
Gantry | X_Axis | X_Carriage | Printheads | Dragonfly_BMS | printhead_front_dragonfly_bms
Gantry | X_Axis | X_Carriage | Printheads | Dragonfly_BMS | printhead_rear_dragonfly_bms
Gantry | X_Axis | X_Carriage | Printheads | E3D_Revo_Micro | printhead_front_e3d_revo_micro
Gantry | X_Axis | X_Carriage | Printheads | E3D_Revo_Micro | printhead_rear_e3d_revo_micro
Gantry | X_Axis | X_Carriage | Printheads | E3D_V6 | printhead_front_e3dv6
Gantry | X_Axis | X_Carriage | Printheads | E3D_V6 | printhead_rear_e3dv6
Gantry | X_Axis | X_Carriage | Printheads | Slice_Mosquito | printhead_front_mosquito |  |  | Not Supported | PIF no longer supports Slice products
Gantry | X_Axis | X_Carriage | Printheads | Slice_Mosquito | printhead_rear_mosquito
Gantry | X_Axis | X_Carriage |  |  | [a]_blower_housing_front |  | Included
Gantry | X_Axis | X_Carriage |  |  | blower_housing_rear |  | Included
Gantry | X_Axis | X_Carriage |  |  | hotend_fan_mount |  | Included
Gantry | X_Axis | X_Carriage |  |  | pinda_adapter |  |  | Optional
Gantry | X_Axis | X_Carriage |  |  | probe_retainer_bracket |  | Included
Gantry | X_Axis | X_Carriage |  |  | probe_retainer_bracket_9mm |  |  | Optional
Gantry | X_Axis | X_Carriage |  |  | x_carriage_frame_left_MGN12 |  | Included
Gantry | X_Axis | X_Carriage |  |  | x_carriage_frame_right_MGN12 |  | Included
Gantry | Z_Joints |  |  |  | z_joint_lower_x4 |  | Included
Gantry | Z_Joints |  |  |  | z_joint_upper_hall_effect |  | Included |  | Only needed if using hall effect
Gantry | Z_Joints |  |  |  | z_joint_upper_x4 |  | Included |  | 3 needed if using hall effect (one replaced by hall effect joint)
Gantry |  |  |  |  | [a]_z_belt_clip_lower_x4 |  | Included
Gantry |  |  |  |  | [a]_z_belt_clip_upper_x4 |  | Included
Gantry |  |  |  |  | z_chain_bottom_anchor |  | Included
Gantry |  |  |  |  | z_chain_guide |  | Included
Panel_Mounting | Front_Doors |  |  |  | door_hinge_x6 |  |  | 装饰件
Panel_Mounting | Front_Doors |  |  |  | handle_a_x2 |  |  | 装饰件
Panel_Mounting | Front_Doors |  |  |  | handle_b_x2 |  |  | 装饰件
Panel_Mounting | Front_Doors |  |  |  | latch_x2 |  |  | 装饰件
Panel_Mounting |  |  |  |  | bottom_panel_clip_x4 |  |  | 装饰件
Panel_Mounting |  |  |  |  | bottom_panel_hinge_x2 |  |  | 装饰件
Panel_Mounting |  |  |  |  | corner_panel_clip_4mm_x8 |  |  | 装饰件 | 4mm clips intended for sides, can be larger
Panel_Mounting |  |  |  |  | corner_panel_clip_6mm_x8 |  |  | 装饰件 | 6mm clips intended for top and back, can be used other places
Panel_Mounting |  |  |  |  | deck_support_3mm_x8 |  |  | 装饰件 | Choose one based on deck panel thickness
Panel_Mounting |  |  |  |  | deck_support_4mm_x8 |  |  | 装饰件
Panel_Mounting |  |  |  |  | midspan_panel_clip_4mm_x7 |  |  | 装饰件 | 4mm clips intended for sides, can be larger
Panel_Mounting |  |  |  |  | midspan_panel_clip_6mm_x8 |  |  | 装饰件 | 6mm clips intended for top and back, can be used other places
Panel_Mounting |  |  |  |  | z_belt_cover_a_x2 |  |  | 装饰件
Panel_Mounting |  |  |  |  | z_belt_cover_b_x2 |  |  | 装饰件
Skirts | 250 |  |  |  | front_skirt_a_250 |  |  | 装饰件 - Select based on frame size
Skirts | 250 |  |  |  | front_skirt_b_250
Skirts | 250 |  |  |  | rear_center_skirt_250
Skirts | 250 |  |  |  | side_skirt_a_250_x2
Skirts | 250 |  |  |  | side_skirt_b_250_x2
Skirts | 300 |  |  |  | front_skirt_a_300
Skirts | 300 |  |  |  | front_skirt_b_300
Skirts | 300 |  |  |  | rear_center_skirt_300
Skirts | 300 |  |  |  | side_skirt_a_300_x2
Skirts | 300 |  |  |  | side_skirt_b_300_x2
Skirts | 350 |  |  |  | front_skirt_a_350
Skirts | 350 |  |  |  | front_skirt_b_350
Skirts | 350 |  |  |  | rear_center_skirt_350
Skirts | 350 |  |  |  | side_skirt_a_350_x2
Skirts | 350 |  |  |  | side_skirt_b_350_x2
Skirts |  |  |  |  | [a]_belt_guard_a_x2 |  |  | 装饰件
Skirts |  |  |  |  | [a]_belt_guard_b_x2 |  |  | 装饰件
Skirts |  |  |  |  | [a]_btt_knob_light_shield |  |  | Optional
Skirts |  |  |  |  | [a]_fan_grill_a_x2 |  |  | 装饰件
Skirts |  |  |  |  | [a]_fan_grill_b_x2 |  |  | 装饰件
Skirts |  |  |  |  | [a]_fan_grill_open_optional_x2 |  |  | 装饰件
Skirts |  |  |  |  | [a]_fan_grill_retainer_x2 |  |  | 装饰件
Skirts |  |  |  |  | [a]_keystone_blank_insert |  |  | Optional
Skirts |  |  |  |  | [a]_mini12864_case_front_insert |  |  | Optional
Skirts |  |  |  |  | [a]_mini12864_case_hinge |  |  | Optional
Skirts |  |  |  |  | keystone_panel |  |  | Optional
Skirts |  |  |  |  | mini12864_case_front |  |  | Optional
Skirts |  |  |  |  | mini12864_case_rear |  |  | Optional
Skirts |  |  |  |  | power_inlet_IECGS_1.2mm |  |  | Optional | Only one needed, choose one. For PIF check with provider.
Skirts |  |  |  |  | power_inlet_IECGS_1mm |  |  | Optional
Skirts |  |  |  |  | power_inlet_filtered |  | Included
Skirts |  |  |  |  | side_fan_support_x2 |  |  | 装饰件
Spool_Management |  |  |  |  | bowden_retainer |  | Included
Spool_Management |  |  |  |  | spool_holder |  | Included
Tools |  |  |  |  | MGN12_rail_guide_x2 |  | Included
Tools |  |  |  |  | MGN9_rail_guide_x2 |  | Included
Tools |  |  |  |  | bed_hole_marking_template_x1_Rev2 |  |  | Optional | Not needed if buying a pre-drilled bed
Tools |  |  |  |  | bottom_panel_template |  |  | Optional | Only needed if upgrading from 2.4r1
Tools |  |  |  |  | pulley_jig |  |  | Optional | Commonly included - check with PIF provider
Z_Drive |  |  |  |  | [a]_belt_tensioner_a_x2 |  | Included
Z_Drive |  |  |  |  | [a]_belt_tensioner_b_x2 |  | Included
Z_Drive |  |  |  |  | [a]_z_drive_baseplate_a_x2 |  | Included
Z_Drive |  |  |  |  | [a]_z_drive_baseplate_b_x2 |  | Included
Z_Drive |  |  |  |  | z_drive_main_a_x2 |  | Included
Z_Drive |  |  |  |  | z_drive_main_b_x2 |  | Included
Z_Drive |  |  |  |  | z_drive_retainer_a_x2 |  | Included
Z_Drive |  |  |  |  | z_drive_retainer_b_x2 |  | Included
Z_Drive |  |  |  |  | z_motor_mount_a_x2 |  | Included
Z_Drive |  |  |  |  | z_motor_mount_b_x2 |  | Included
Z_Endstop |  |  |  |  | nozzle_probe |  | Included
Z_Idlers |  |  |  |  | [a]_z_tensioner_x4_9mm |  | Included
Z_Idlers |  |  |  |  | z_tensioner_bracket_a_x2 |  | Included
Z_Idlers |  |  |  |  | z_tensioner_bracket_b_x2 |  | Included
Superceded_Parts | Frame_Brackets |  |  |  | dual_ramps_bracket_frame |  |  |  | No longer required
Superceded_Parts | Frame_Brackets |  |  |  | duet_duex_bracket_frame_x2 |  |  |  | No longer required
Superceded_Parts | Frame_Brackets |  |  |  | lrs_bracket_frame |  |  |  | No longer required
Superceded_Parts | Frame_Brackets |  |  |  | mks_gen_1.4_bracket_frame_x2 |  |  |  | No longer required
Superceded_Parts | Frame_Brackets |  |  |  | mks_gen_L_bracket_frame_x2 |  |  |  | No longer required
Superceded_Parts | Frame_Brackets |  |  |  | raspberry_pi_bracket |  |  |  | No longer required
Superceded_Parts | Frame_Brackets |  |  |  | rs_25_psu_bracket_frame |  |  |  | No longer required
Superceded_Parts | Frame_Brackets |  |  |  | rs_35_bracket_frame |  |  |  | No longer required
Superceded_Parts | Frame_Brackets |  |  |  | skr_1.3_bracket_frame |  |  |  | No longer required
Superceded_Parts | Frame_Brackets |  |  |  | skr_mini_e3_bracket_frame |  |  |  | No longer required
Superceded_Parts | MGN9_X |  |  |  | [a]_belt_clamp_MGN9_x2 |  |  |  | No longer required
Superceded_Parts | MGN9_X |  |  |  | x_carriage_frame_left_MGN9 |  |  |  | No longer required
Superceded_Parts | MGN9_X |  |  |  | x_carriage_frame_right_MGN9 |  |  |  | No longer required
Superceded_Parts | MGN9_X |  |  |  | x_carriage_pivot_block_MGN9 |  |  |  | No longer required
Superceded_Parts | MGN9_X |  |  |  | xy_joint_left_lower_MGN9 |  |  |  | No longer required
Superceded_Parts | MGN9_X |  |  |  | xy_joint_left_upper_MGN9 |  |  |  | No longer required
Superceded_Parts | MGN9_X |  |  |  | xy_joint_right_lower_MGN9 |  |  |  | No longer required
Superceded_Parts | MGN9_X |  |  |  | xy_joint_right_upper_MGN9 |  |  |  | No longer required
Superceded_Parts | ZipChain | XY |  |  | zipchain2_xy_end |  |  |  | No longer required
Superceded_Parts | ZipChain | XY |  |  | zipchain2_xy_link_a |  |  |  | No longer required
Superceded_Parts | ZipChain | XY |  |  | zipchain2_xy_link_b |  |  |  | No longer required
Superceded_Parts | ZipChain | Z |  |  | zipchain2_z_end |  |  |  | No longer required
Superceded_Parts | ZipChain | Z |  |  | zipchain2_z_link_a |  |  |  | No longer required
Superceded_Parts | ZipChain | Z |  |  | zipchain2_z_link_b |  |  |  | No longer required
Superceded_Parts | ZipChain | Z |  |  | zipchain2_z_link_b_locking |  |  |  | No longer required
Superceded_Parts |  |  |  |  | [a]_stopgap_80T_hubbed_gear |  |  |  | No longer required
Superceded_Parts |  |  |  |  | [a]_z_tensioner_x4_6mm |  |  |  | No longer required
Last Updated: | 2022-03-27
https://dolphin.littlefish.love/voron/assembling/assembling-stls

Sheet: 黑色
a_drive_frame_lower
a_drive_frame_upper
b_drive_frame_lower
b_drive_frame_upper
blower_housing_rear
bowden_retainer
chain_anchor_3hole
extruder_body
extruder_motor_plate
front_idler_left_lower
front_idler_left_upper
front_idler_right_lower
front_idler_right_upper
hotend_fan_mount
lrs_200_psu_bracket_x2.stl
nozzle_probe
pcb_din_clip_x3
power_inlet_filtered
printhead_front_e3dv6
printhead_rear_e3dv6
probe_retainer_bracket
PSU_stabilizer_50mm
raspberrypi_bracket
Spider_bracket_set
spool_holder
wago_221-415_mount_3x5
x_carriage_frame_left_MGN12
x_carriage_frame_right_MGN12
xy_joint_left_lower_MGN12
xy_joint_left_upper_MGN12
xy_joint_right_lower_MGN12
xy_joint_right_upper_MGN12
z_chain_bottom_anchor
z_chain_guide
z_drive_main_a_x2
z_drive_main_b_x2
z_drive_retainer_a_x2
z_drive_retainer_b_x2
z_joint_lower_x4
z_joint_upper_hall_effect
z_joint_upper_x4
z_motor_mount_a_x2
z_motor_mount_b_x2
z_tensioner_bracket_a_x2
z_tensioner_bracket_b_x2

Sheet: 红色
[a]_belt_tensioner_a_x2
[a]_belt_tensioner_b_x2
[a]_blower_housing_front
[a]_cable_cover
[a]_connector_cover
[a]_endstop_pod_D2F_switch
[a]_guidler
[a]_latch
[a]_latch_shuttle
[a]_tensioner_left
[a]_tensioner_right
[a]_xy_joint_cable_bridge_3hole
[a]_z_belt_clip_lower_x4
[a]_z_belt_clip_upper_x4
[a]_z_chain_retainer_bracket_x2
[a]_z_drive_baseplate_a_x2
[a]_z_drive_baseplate_b_x2
[a]_z_tensioner_x4_9mm

Sheet: Switchwire
Location |  |  |  |  | Part | Color | Quantity | Essential (PIF provided) | Non-Essential | Notes
Electronics |  |  |  |  | 3030_wire_clip | Primary | 1 | Included
Electronics | LCD | 2004_(Prusa) |  |  | [a]_lcd_knob | Alternate | 1 |  | Optional
Electronics | LCD | 2004_(Prusa) |  |  | lcd_case_front_2004 | Primary | 1 |  | Optional
Electronics | LCD | 2004_(Prusa) |  |  | lcd_case_rear_2004 | Primary | 1 |  | Optional
Electronics | LCD | Mini12864 |  |  | lcd_case_front_mini12864 | Primary | 1 |  | Optional
Electronics | LCD | Mini12864 |  |  | lcd_case_rear_mini12864 | Primary | 1 |  | Optional
Electronics | LCD | No_LCD |  |  | [a]_lcd_blank | Alternate | 1 |  | Optional
Electronics |  |  |  |  | PS_2020_Mount_x2 | Primary | 2 | Included
Electronics |  |  |  |  | PS_3030_Mount_x2 | Primary | 2 | Included
Electronics |  |  |  |  | einsy_rambo_mount | Primary | 1 | Included - Choose one
Electronics |  |  |  |  | skr_mini_e3_mount | Primary | 1
Electronics |  |  |  |  | skr_mount | Primary | 1
Electronics |  |  |  |  | skr_mount_rotated | Primary | 1
Electronics |  |  |  |  | raspberry_pi_mount | Primary | 1 | Included
Electronics |  |  |  |  | raspberry_pi_zero_shelf | Primary | 1 |  | Optional
Electronics |  |  |  |  | rs_25_mount | Primary | 1 | Included
Gantry |  |  |  |  | 2020_MGN12_guide_x2 | Primary | 2 | Included
Gantry |  |  |  |  | 3030_MGN12_guide_x2 | Primary | 2 | Included
Gantry | XZ_Axis | X_Carriage | Bowden |  | bowden_dual_adapter_front_a | Primary | 1 |  | Optional
Gantry | XZ_Axis | X_Carriage | Bowden |  | bowden_dual_adapter_front_b | Primary | 1 |  | Optional
Gantry | XZ_Axis | X_Carriage | Bowden |  | bowden_module_front | Primary | 1 |  | Optional
Gantry | XZ_Axis | X_Carriage | Bowden |  | bowden_module_rear_generic | Primary | 1 |  | Optional | Only one needed based on chain type
Gantry | XZ_Axis | X_Carriage | Bowden |  | bowden_module_rear_igus | Primary | 1 |  | Optional
Gantry | XZ_Axis | X_Carriage | Bowden |  | bsp_adapter | Primary | 1 |  | Optional
Gantry | XZ_Axis | X_Carriage | Bowden |  | tl_collet_adapter | Primary | 1 |  | Optional
Gantry | XZ_Axis | X_Carriage | Direct_Feed |  | [a]_connector_cover | Alternate | 1 | Included
Gantry | XZ_Axis | X_Carriage | Direct_Feed |  | [a]_guidler | Alternate | 1 | Included
Gantry | XZ_Axis | X_Carriage | Direct_Feed |  | [a]_latch | Alternate | 1 | Included
Gantry | XZ_Axis | X_Carriage | Direct_Feed |  | [a]_latch_shuttle | Alternate | 1 | Included
Gantry | XZ_Axis | X_Carriage | Direct_Feed |  | extruder_body | Primary | 1 | Included
Gantry | XZ_Axis | X_Carriage | Direct_Feed |  | extruder_motor_plate | Primary | 1 | Included
Gantry | XZ_Axis | X_Carriage | Direct_Feed |  | x_chain_anchor_generic | Primary | 1 | Included |  | Only one needed based on chain type
Gantry | XZ_Axis | X_Carriage | Direct_Feed |  | x_chain_anchor_igus | Primary | 1 | Included
Gantry | XZ_Axis | X_Carriage | Printheads | E3D_V6 | printhead_front_e3dv6 | Primary | 1 | Included - Choose one hot end
Gantry | XZ_Axis | X_Carriage | Printheads | E3D_V6 | printhead_rear_e3dv6 | Primary | 1
Gantry | XZ_Axis | X_Carriage | Printheads | TriangleLab_Dragon | printhead_front_dragon | Primary | 1
Gantry | XZ_Axis | X_Carriage | Printheads | TriangleLab_Dragon | printhead_rear_dragon | Primary | 1
Gantry | XZ_Axis | X_Carriage | Printheads | Slice_Mosquito | printhead_front_mosquito | Primary | 1 |  | Not Supported | PIF no longer supports Slice products
Gantry | XZ_Axis | X_Carriage | Printheads | Slice_Mosquito | printhead_rear_mosquito | Primary | 1
Gantry | XZ_Axis | X_Carriage |  |  | [a]_blower_housing_front | Alternate | 1 | Included
Gantry | XZ_Axis | X_Carriage |  |  | [a]_x_bearing_block | Alternate | 1 | Included
Gantry | XZ_Axis | X_Carriage |  |  | [a]_xz_belt_clip_x2 | Alternate | 2 | Included
Gantry | XZ_Axis | X_Carriage |  |  | blower_housing_rear | Primary | 1 | Included
Gantry | XZ_Axis | X_Carriage |  |  | hotend_fan_mount | Primary | 1 | Included
Gantry | XZ_Axis | X_Carriage |  |  | pinion | Primary | 1 | Included
Gantry | XZ_Axis | X_Carriage |  |  | probe_retainer_bracket | Primary | 1 | Included
Gantry | XZ_Axis | X_Carriage |  |  | x_carriage_frame_left | Primary | 1 | Included
Gantry | XZ_Axis | X_Carriage |  |  | x_carriage_frame_right | Primary | 1 | Included
Gantry | XZ_Axis |  |  |  | [a]_upper_idler_support_b_left | Alternate | 1 | Included
Gantry | XZ_Axis |  |  |  | [a]_upper_idler_support_b_right | Alternate | 1 | Included
Gantry | XZ_Axis |  |  |  | [a]_xz_cable_cover | Alternate | 1 | Included
Gantry | XZ_Axis |  |  |  | [a]_xz_tensioner_x2 | Alternate | 2 | Included
Gantry | XZ_Axis |  |  |  | [a]_z_chain_lower_mount_generic | Alternate | 1 | Included |  | Only one needed based on chain type
Gantry | XZ_Axis |  |  |  | [a]_z_chain_lower_mount_igus | Alternate | 1 | Included
Gantry | XZ_Axis |  |  |  | keybak_gantry_anchor | Primary | 1 | Included
Gantry | XZ_Axis |  |  |  | keybak_idler_bracket | Primary | 1 | Included
Gantry | XZ_Axis |  |  |  | keybak_mount | Primary | 1 | Included
Gantry | XZ_Axis |  |  |  | keybak_mount_plate | Primary | 1 | Included
Gantry | XZ_Axis |  |  |  | upper_idler_support_a_left | Primary | 1 | Included
Gantry | XZ_Axis |  |  |  | upper_idler_support_a_right | Primary | 1 | Included
Gantry | XZ_Axis |  |  |  | x_motor_mount_a | Primary | 1 | Included
Gantry | XZ_Axis |  |  |  | x_motor_mount_b | Primary | 1 | Included
Gantry | XZ_Axis |  |  |  | xz_block_left_a | Primary | 1 | Included
Gantry | XZ_Axis |  |  |  | xz_block_left_b | Primary | 1 | Included
Gantry | XZ_Axis |  |  |  | xz_block_right_a | Primary | 1 | Included
Gantry | XZ_Axis |  |  |  | xz_block_right_b | Primary | 1 | Included
Gantry | XZ_Axis |  |  |  | z_bearing_block_left | Primary | 1 | Included
Gantry | XZ_Axis |  |  |  | z_bearing_block_right_generic | Primary | 1 | Included |  | Only one needed based on chain type
Gantry | XZ_Axis |  |  |  | z_bearing_block_right_igus | Primary | 1 | Included
Gantry | XZ_Axis |  |  |  | z_carriage_stop_x3 | Primary | 3 | Included
Gantry | XZ_Axis |  |  |  | z_motor_mount_a | Primary | 1 | Included
Gantry | XZ_Axis |  |  |  | z_motor_mount_b | Primary | 1 | Included
Gantry | Y_Axis |  |  |  | [a]_dummy_microswitch | Alternate | 1 |  | Optional
Gantry | Y_Axis |  |  |  | [a]_y_belt_clip | Alternate | 1 | Included
Gantry | Y_Axis |  |  |  | [a]_y_chain_bed_mount_generic | Alternate | 1 | Included |  | Only one needed based on chain type
Gantry | Y_Axis |  |  |  | [a]_y_chain_bed_mount_igus | Alternate | 1 | Included
Gantry | Y_Axis |  |  |  | [a]_y_chain_frame_mount_generic | Alternate | 1 | Included |  | Only one needed based on chain type
Gantry | Y_Axis |  |  |  | [a]_y_chain_frame_mount_igus | Alternate | 1 | Included
Gantry | Y_Axis |  |  |  | heatbed_terminals_cover | Primary | 1 | Included
Gantry | Y_Axis |  |  |  | y_belt_anchor | Primary | 1 | Included
Gantry | Y_Axis |  |  |  | y_carriage_drill_guide | Primary | 1 | Included
Gantry | Y_Axis |  |  |  | y_idler_lower | Primary | 1 | Included
Gantry | Y_Axis |  |  |  | y_idler_upper | Primary | 1 | Included
Gantry | Y_Axis |  |  |  | y_motor_mount_a | Primary | 1 | Included
Gantry | Y_Axis |  |  |  | y_motor_mount_b | Primary | 1 | Included
Grills |  |  |  |  | [a]_grill_endcap_x4 | Alternate | 4 |  | Cosmetic
Grills |  |  |  |  | grill_front_middle | Primary | 1 |  | Cosmetic
Grills |  |  |  |  | grill_front_x2 | Primary | 1 |  | Cosmetic
Grills |  |  |  |  | grill_rear_left | Primary | 1 |  | Cosmetic
Grills |  |  |  |  | grill_rear_left_filtered | Primary | 1 | Included
Grills |  |  |  |  | grill_rear_middle | Primary | 1 | Included
Grills |  |  |  |  | grill_rear_right | Primary | 1 | Included
Panel_Mounting | Doors |  |  |  | door_handle_a_x2 | Primary | 2 |  | Cosmetic
Panel_Mounting | Doors |  |  |  | door_handle_b_x2 | Primary | 2 |  | Cosmetic
Panel_Mounting | Doors |  |  |  | door_hinge_x4 | Primary | 4 |  | Cosmetic
Panel_Mounting |  |  |  |  | feed_slot | Primary | 1 |  | Cosmetic
Panel_Mounting |  |  |  |  | light_bar_x2 | Primary | 2 |  | Cosmetic
Panel_Mounting |  |  |  |  | panel_clip_x10 | Primary | 10 |  | Cosmetic
Panel_Mounting |  |  |  |  | rear_panel_bracket_x6 | Primary | 6 |  | Cosmetic
Panel_Mounting |  |  |  |  | side_strap_x4 | Primary | 4 |  | Cosmetic
Panel_Mounting |  |  |  |  | top_door_latch | Primary | 1 |  | Cosmetic
Other |  |  |  |  | foot_tpu_x4 | Primary | 4 |  | Optional
Other |  |  |  |  | spool_holder | Primary | 1 | Included
Other |  |  |  |  | spool_holder_base | Primary | 1 | Included
Last Updated: | 2021-08-26

Sheet: Legacy
Location |  |  |  | Part | Color | Quantity | Essential (PIF provided) | Non-Essential | Notes
Electronics | LCD |  |  | lcd_front | Primary | 1 |  | Optional
Electronics | LCD |  |  | lcd_mount | Primary | 1 |  | Optional
Electronics | LCD |  |  | lcd_pivot | Primary | 1 |  | Optional
Electronics | LCD |  |  | lcd_rear | Primary | 1 |  | Optional
Electronics |  |  |  | cable_frame_anchor_x10 | Primary | 10 | Included
Electronics |  |  |  | enclosure | Primary | 1 | Included
Electronics |  |  |  | enclosure_cover | Primary | 1 | Included
Electronics |  |  |  | psu_stabilizer | Primary | 1 | Included
Gantry | AB Drive Units |  |  | [a]_belt_tensioner_x2 | Alternate | 2 | Included
Gantry | AB Drive Units |  |  | a_drive_unit_lower | Primary | 1 | Included
Gantry | AB Drive Units |  |  | a_drive_unit_upper | Primary | 1 | Included
Gantry | AB Drive Units |  |  | b_drive_unit_lower | Primary | 1 | Included
Gantry | AB Drive Units |  |  | b_drive_unit_upper | Primary | 1 | Included
Gantry | AB Drive Units |  |  | y_shaft_rear_support_x2 | Primary | 2 | Included
Gantry | Front Idlers |  |  | front_idler_left_lower | Primary | 1 | Included
Gantry | Front Idlers |  |  | front_idler_left_upper | Primary | 1 | Included
Gantry | Front Idlers |  |  | front_idler_right_lower | Primary | 1 | Included
Gantry | Front Idlers |  |  | front_idler_right_upper | Primary | 1 | Included
Gantry | Front Idlers |  |  | idler_spacer_x2 | Primary | 2 | Included
Gantry | X Carriage | Printheads | E3D_V6 | printhead_front_e3dv6 | Primary | 1 | Included - Choose one hot end
Gantry | X Carriage | Printheads | E3D_V6 | printhead_rear_e3dv6 | Primary | 1
Gantry | X Carriage | Printheads | TriangleLab_Dragon | printhead_front_dragon | Primary | 1
Gantry | X Carriage | Printheads | TriangleLab_Dragon | printhead_rear_dragon | Primary | 1
Gantry | X Carriage | Printheads | Slice_Mosquito | printhead_front_mosquito | Primary | 1 |  | Not Supported | PIF no longer supports Slice products
Gantry | X Carriage | Printheads | Slice_Mosquito | printhead_rear_mosquito | Primary | 1
Gantry | X Carriage |  |  | [a]_belt_clip_x2 | Alternate | 2 | Included
Gantry | X Carriage |  |  | [a]_blower_housing_front | Alternate | 1 | Included
Gantry | X Carriage |  |  | [a]_bowden_cable_cover | Alternate | 1 | Included
Gantry | X Carriage |  |  | [a]_hotend_fan_mount | Alternate | 1 | Included
Gantry | X Carriage |  |  | afterburner_umbilical_anchor | Primary | 1 | Included
Gantry | X Carriage |  |  | blower_housing_rear | Primary | 1 | Included
Gantry | X Carriage |  |  | bowden_adapter_front | Primary | 1 | Included
Gantry | X Carriage |  |  | bowden_adapter_midsection | Primary | 1 | Included
Gantry | X Carriage |  |  | bowden_adapter_rear | Primary | 1 | Included
Gantry | X Carriage |  |  | probe_retainer_bracket | Primary | 1 | Included
Gantry | X Carriage |  |  | x_carriage_left | Primary | 1 | Included
Gantry | X Carriage |  |  | x_carriage_right | Primary | 4 | Included
Gantry | XY Joints |  |  | idler_spacer_x4 | Primary | 1 | Included
Gantry | XY Joints |  |  | xy_joint_backbrace_x2 | Primary | 2 | Included
Gantry | XY Joints |  |  | xy_joint_left_lower | Primary | 1 | Included
Gantry | XY Joints |  |  | xy_joint_left_upper | Primary | 1 | Included
Gantry | XY Joints |  |  | xy_joint_right_lower | Primary | 1 | Included
Gantry | XY Joints |  |  | xy_joint_right_upper | Primary | 1 | Included
Gantry | XY Joints |  |  | y_bearing_retainer_front_x2 | Primary | 2 | Included
Gantry | XY Joints |  |  | y_bearing_retainer_rear_x2 | Primary | 2 | Included
Tools |  |  |  | z_component_alignment_jig | Primary | 1 | Included
Z Axis | Bed Carriages |  |  | bed_carriage_lower_a_x2 | Primary | 2 | Included
Z Axis | Bed Carriages |  |  | bed_carriage_lower_b_x2 | Primary | 2 | Included
Z Axis | Bed Carriages |  |  | bed_carriage_upper_a_x2 | Primary | 2 | Included
Z Axis | Bed Carriages |  |  | bed_carriage_upper_b_x2 | Primary | 2 | Included
Z Axis | Bed Carriages |  |  | z_leadscrew_block_x2 | Primary | 2 | Included
Z Axis |  |  |  | z_motor_mount_a_x2 | Primary | 2 | Included
Z Axis |  |  |  | z_motor_mount_b_x2 | Primary | 2 | Included
Z Axis |  |  |  | z_shaft_suport_lower_a_x2 | Primary | 2 | Included
Z Axis |  |  |  | z_shaft_suport_lower_b_x2 | Primary | 2 | Included
Z Axis |  |  |  | z_shaft_suport_upper_x4 | Primary | 4 | Included
Last Updated: | 2021-08-26
