zhcntiangang/seahorse.github.io/voron/Voron bom采购指南.pdf

# Voron bom 采购指南

黎明

序言

本指南从常见的几个方面对 bom 采购中一些值得注意的地方进行指导，如有不足，请 各位大佬指出不足并加以了理解

1----------------------------------------------------------------------------------------------------------------螺丝 2----------------------------------------------------------------------------------------------------------------弹珠螺母 3----------------------------------------------------------------------------------------------------------------垫片 4----------------------------------------------------------------------------------------------------------------同步轮 5----------------------------------------------------------------------------------------------------------------同步带 6----------------------------------------------------------------------------------------------------------------轴承 7----------------------------------------------------------------------------------------------------------------挤出机 8----------------------------------------------------------------------------------------------------------------调平器件 9----------------------------------------------------------------------------------------------------------------热端 10--------------------------------------------------------------------------------------------------------------风扇 11--------------------------------------------------------------------------------------------------------------主板 12--------------------------------------------------------------------------------------------------------------上位机 13--------------------------------------------------------------------------------------------------------------开关电源 14--------------------------------------------------------------------------------------------------------------电机 15--------------------------------------------------------------------------------------------------------------型材 16--------------------------------------------------------------------------------------------------------------热床 17------------------------------------------------------------------------------------------------------- ------封箱板 18--------------------------------------------------------------------------------------------------------------结构件 19--------------------------------------------------------------------------------------------------------------拖链

螺丝

螺丝这里推荐 304 或者 12.9 级的，个人更推荐 304，304 有一个问题就是有很多家的 304 内六角很容易滑丝的。如果买 304 的螺丝，最好要配好的专门六角扳手，尽量不要用打 印机，主板什么的送的内六角。螺丝购买方面我个人是不建议去淘宝或者海鲜市场买成套（就 是别人已经按照 bom 表给你采购好装起来），这样的话虽然装机是够了，但是你之后稍微 有点升级或者螺丝丢了还得自己重新买，我个人建议买按照 bom 的数量买百分之 150，之 后升级之类的也需要一些螺丝。最后一点，因为 sb 头也就是常说的新头需要一两种新的螺 丝 没 有 纳 入 总 的 bom 需 要 单 独 购 买 ， bom 如 下 。 弹珠螺母

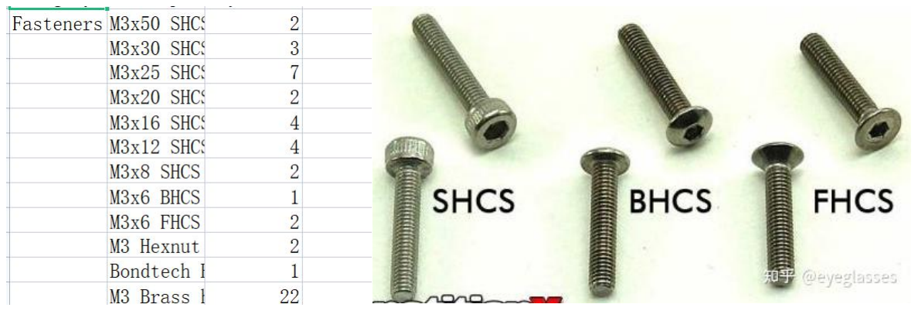
[picture p34: figure]

螺母方面。各家的弹珠螺母的尺寸外形相同，但是尺寸略有不同因为米思米型材和欧标 型材不同，槽宽是 6 槽深 4，而欧标是 6.2，淘宝上有些商家卖的弹珠螺母难装进去，装不

进去，所以选购时候需要注意。例如这样的就可以装入米思米型材之中 | 。弹珠螺母
价格大概是 0.25 一颗，不要买贵。 垫片

2.4 和三叉戟主要就是两种垫片 m3 和 m5 的。其中 m5 的最重要，要记住是 1mm 厚的 其他厚度的有可能导致轴承吃皮带

# 同步轮

同步轮从几角到十多的都有，各家质量参差不齐，好的有锐力斯，mellow 或者保捷 （powge）相比便宜的这几个耐久度更胜一筹，精度方面贵的和便宜的差别不是很大，这几 家贵的实际精度和耐用度更强，但是带来的问题是装配不到位的话带来负优化，导致出现刮

皮带的事情。再怎么说同步轮建议至少都要两三块钱的，价格太低的不是很推荐。 同步带

同步带，买盖茨的就没错了。普通的同步带在打印速度比较低的机器是够了，但是一旦 到了 voron 的机器动不动 100 以上的速度，普通的同步带一两周就拉断了。而且 voron 换皮 带又是比较麻烦，费时又耗力。盖茨同步带分三种，第一种普通的（整体黑色的）稍微便宜 一点 ，第二种低粉尘（齿面是棕色的）。第三种是耐高温的，比较少见，价格也比较高。 轴承

轴承好的肯定是 nsk 之类的，如果要买这些大品牌建议去米思米购买别在淘宝购买。一 般来说轴承淘宝三四块钱的就够了。 挤出机

## Voron 老头标配的挤出机是 cw1（clockwork1），新头标配的是 cw2（clockwork2），cw1

和 cw2 最大的不同就是挤出电机不同，cw1 是 42 电机，cw2 是 36 圆饼电机，购买时需要注 意。另外还有 orbiter1.5 和 orbiter2.0 推荐。这两个是成品挤出机，不会有一些小毛病，

## orbiter2.0 用在 sb 头上有点 bug，但是问题不大。如果有条件可以考虑一下 bondtech 的 lgx

挤出机，国外用的人挺多，换料也很方便。唯一缺点就是国内没有商家在卖。 调平器件

常用调平又 pl08n 和 klciky。Pl08n 就是无需其他配置上手即用，但是有热漂移的毛病。 Klicky 需要单独做配置，价格低，而且有替代 z 限位和自动做 z 偏移的功能。总体来说 klciky 更为推荐。 热端

如果对于不跑高速的人来说 v6 足够了。高速指 150 以下。V6 的选购有些点需要注意。

第一次是要选可以使用不锈钢封装的热敏 | 的，也就是这样子的加热块的

。第二就是应该有可以固定铁氟龙管的散热的 | 。如果土豪的

话可以选择龙，蚊子（sb 头官方不支持需要第三方 mod，问题不大），rapio，revo 之类的。 风扇

风扇，这里说的是模型散热风扇和喉管风扇。这两者都建议上高转速大风量的，喉管散 热不足的话很容易因为回抽过度导致喉管堵了，模型散热不足也会导致大角度的地方塌陷或 者拉桥塌陷。别买猫扇，猫扇除了静音和好看一无是处，价格也很贵。 主板

常用的主板有章鱼和蜘蛛，这两个的资料最完善，在用的群友也是最多的，对于新手来 说这两个主板比较合适。另外也有一些刚上市和准备上市的新品都有不错的产品力，有的将 上位机集成到主板上的。但是这主板可能没有配置来抄，自己配置起来比较麻烦

# 上位机

官方 bom 推荐是树莓派，树莓派的确有他的好，在国内的网络环境下不用饱受 kiauh 的折磨（大佬的话没这个问题）。无脑式安装 klipper。如果使用触摸屏幕，canhat（类似 u2c）的话也有现成的资料和脚本几句命令就可以启用。只是现在树莓派价格较高不是很推 荐。其他的 pi 只要搞定网络环境装起来也是很方便。有的大佬做的 klipper 盒子几十块钱也 有足够的性能，而且买来即用。最后千万别手贱点击更新，对于小白来说更新 klipper 就是 在浪费生命。 开关电源

开关电源，我只推荐明纬，注意我说的是明纬，绞丝旁的纬，明纬前面没有任何省份（例 如浙江明纬）。不要买成明伟。明纬群友们常用的有两种型号 lrs 和 uhp。Uhp 相比 lrs 体积 更小某些功率来说 uhp 的体积是 lrs 一半左右，但是价格更高大概是 lrs 的两倍价格。 电机

电机，一般来说拆机佬的电机对于普通人是足够了有些甚至比大价钱买的赛雷啥的还要 好。想要用好一个电机要电流给足给合适，驱动也要给散热，最好电机也贴一下散热片。如

果这些都还丢步，那可以考虑更好的电机比如说 ldo 和 moons。 型材

型材的选择很多，最常见的就是米思米的型材但是颜色只有两三种，另外还有淘宝上成 品的型材套装，淘宝的型材有些店铺是可以定制颜色的。以上的型材的横截面都是米思米同

款 | 。如果囊中羞涩可以选择欧标的型材，常见的欧标 20 型材有两种普通槽
和 v 槽 | ，这里不推荐 v 槽，因为 v 槽不好安装 9 的线规并且很难固定，影

响精度。 热床

热床，淘宝上，咸鱼上挺多智商税的。假的 mic6 也层出不穷，一个很容易鉴定假的 mic6 的 方法就是是不是 9.5mm 左右的。正品的 mic6 是没有 8mm 厚的产品的。如果是 8mm 厚的话

大概率是假的。群里面各位大佬和我一律推荐 live（voron 官方推荐卖家 | ）

的铝板，价格合适而且包平。VORON 2.4 Trident 铝板 热床铝板 构建板 铸铝板超平铝板 (https://item.taobao.com/item.htm?spm=a230r.1.14.16.39845361N5DkKe&id=677340504345&ns=1&abbucket=5) 精铣铝-淘宝网 (taobao.com)。他家的铝板多位群友购买后测出来都是 0.05 左右。而且加 热后形变很少。如果囊中羞涩的话可以找一下淘宝商家买精铸铝板，但是平整度一般，并且 一般不能帮忙打孔或者加工费很贵

# 加热垫

一般来说。300 尺寸的铝板要买 250 尺寸的加热垫，别买成 300 尺寸的否则不能安装。

但是 live 提供了异形加热垫 | ，可以规避螺丝孔位。加热面积更大也更加均匀。

# 封箱板

封箱板推荐 pc 材质，亚克力可能长时间加热后会变形。按理来说一套大概 300。如果 淘宝找商家切的话有的一百多就可以了，但是有个缺点就是尺寸不是很准，有个几毫米的误

# 差。结构件

官方推荐的是 abs 结构件。如果不是过分追求高速度，Abs 结构件完全够用。后期改装 加 mod 也更为方便。值得注意的一点 abs+结构件不是很推荐，abs+的比 abs 好打是因为掺 入一些其他材料例如 petg 让他不用封箱也可以打降低了代打门槛，但是因为掺入了这些材 料导致了其耐温性下降。如果土豪的话可以选择使用 cnc 结构件，建议是选那些专门优化过 结构的 cnc 套件。没有优化过的太重了。 拖链

拖链的选购有几个需要注意的点。z拖链也就是10*15的应该为r28，xy拖链也就是10*11 的应该为 r18，没选对虽然不会影响打印，但是对美观有一定的影响。还有购买时记得问商 家拖链头是多少孔的，一般有两孔或者三孔，并告诉代打的商家是多少孔的

# QQ 群 905393941
