zhcntiangang/seahorse.github.io/voron/stl/黑色/z_drive_main_b_x2.stl

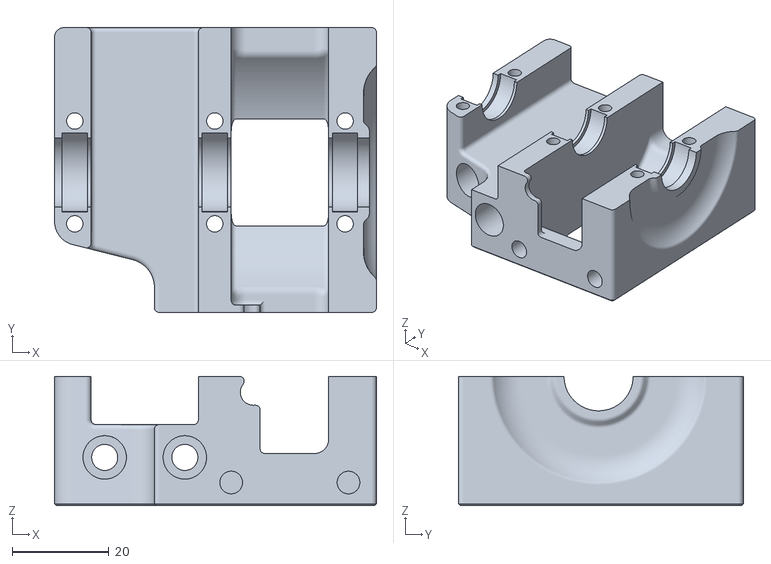
[picture p35: CAD file, 2026-05-05]
voron/stl/黑色/z_drive_main_b_x2.stl
66.7 x 59.0 x 26.8
