zhcntiangang/seahorse.github.io/babylon/exhaust_filter_housing.stl

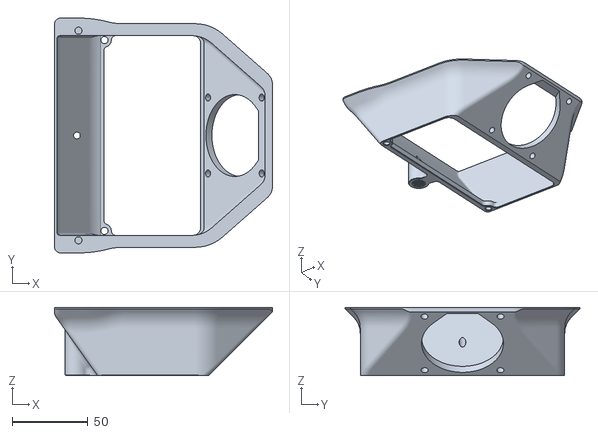
[picture p36: CAD file, 2026-05-05]
babylon/exhaust_filter_housing.stl
143.7 x 154.8 x 45.0
