zhcntiangang/seahorse.github.io/gzt/底座（小米温湿度） v3.stl

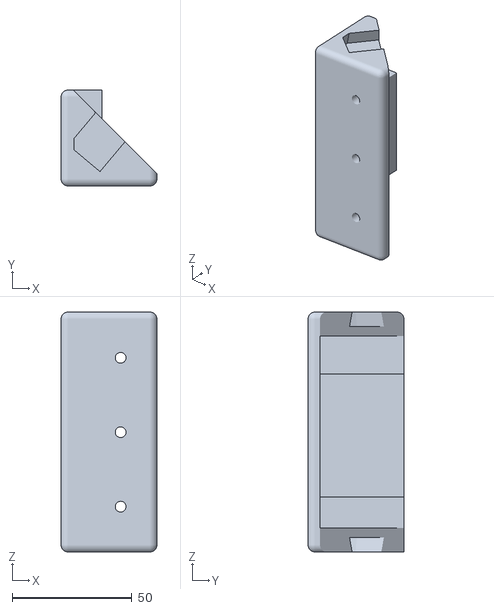
[picture p37: CAD file, 2026-05-05]
gzt/底座（小米温湿度） v3.stl
40.0 x 40.0 x 100.0
