zhcntiangang/seahorse.github.io/stl/accelerationtower.stl

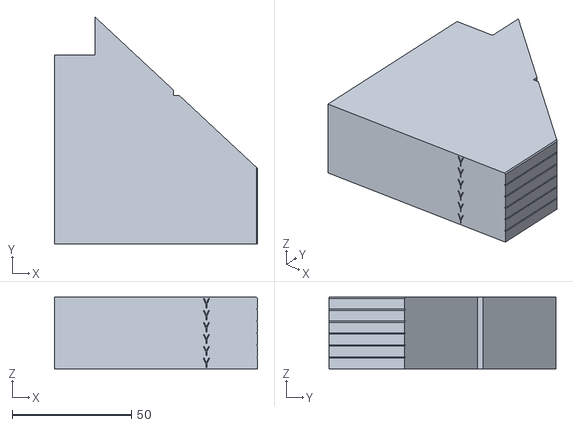
[picture p38: CAD file, 2026-05-05]
stl/accelerationtower.stl
85.0 x 95.0 x 30.0
