zhcntiangang/seahorse.github.io/stl/calibration/retraction-test-littlefish.stl

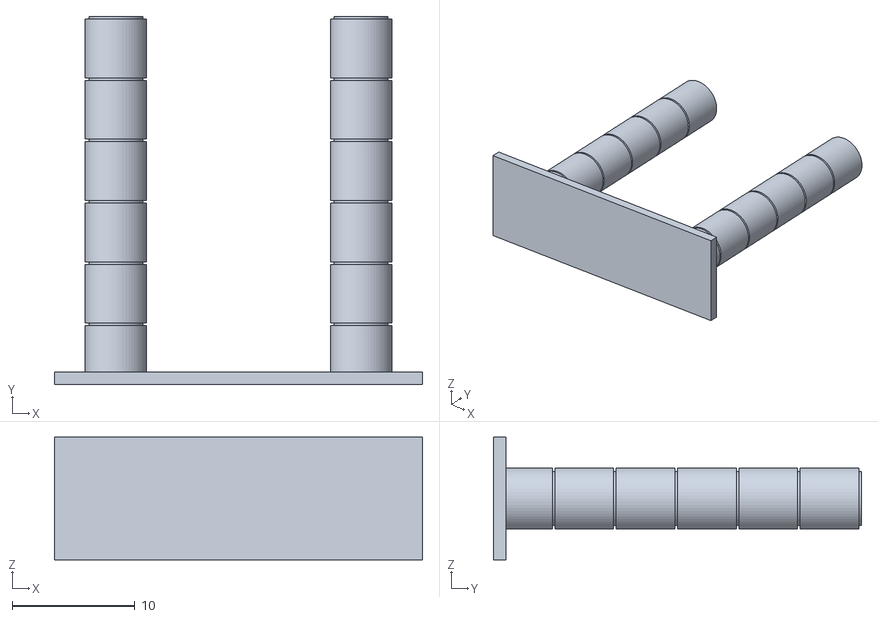
[picture p39: CAD file, 2026-05-05]
stl/calibration/retraction-test-littlefish.stl
30.0 x 30.0 x 10.0
