zhcntiangang/seahorse.github.io/stl/my/1亿.stl

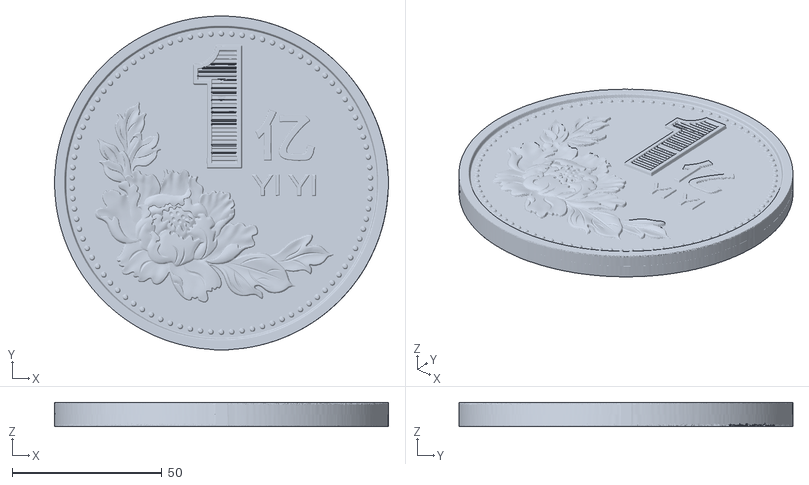
[picture p40: CAD file, 2026-05-05]
stl/my/1亿.stl
111.7 x 111.7 x 8.10
