zhcntiangang/seahorse.github.io/stl/upgrade/Magnetic_Panels_with_Magnet_Inserts/Corner-Clip-7mm.stl

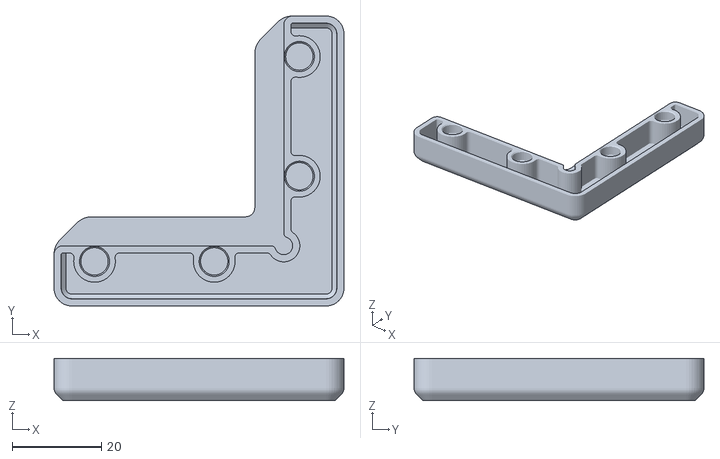
[picture p41: CAD file, 2026-05-05]
stl/upgrade/Magnetic_Panels_with_Magnet_Inserts/Corner-Clip-7mm.stl
65.0 x 65.0 x 9.50
