zhcntiangang/seahorse.github.io/stl/upgrade/中轴（大）装配体螺纹加长版.STL

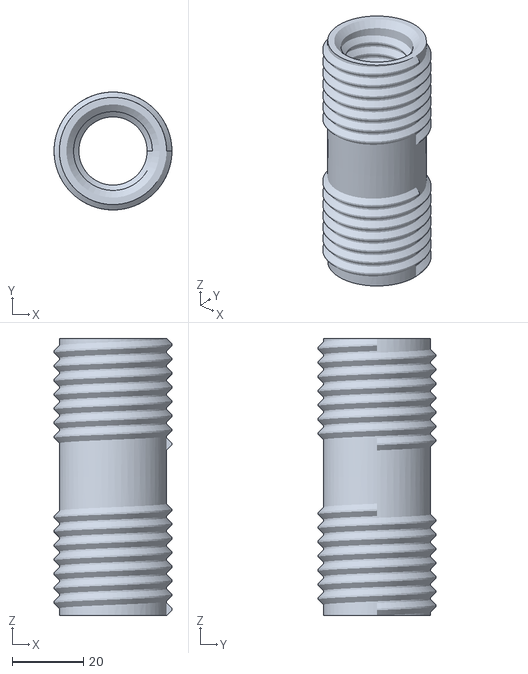
[picture p42: CAD file, 2026-05-05]
stl/upgrade/中轴（大）装配体螺纹加长版.STL
33.2 x 33.2 x 78.0
