zhcntiangang/seahorse.github.io/stl/voron/5mm-hole.stl

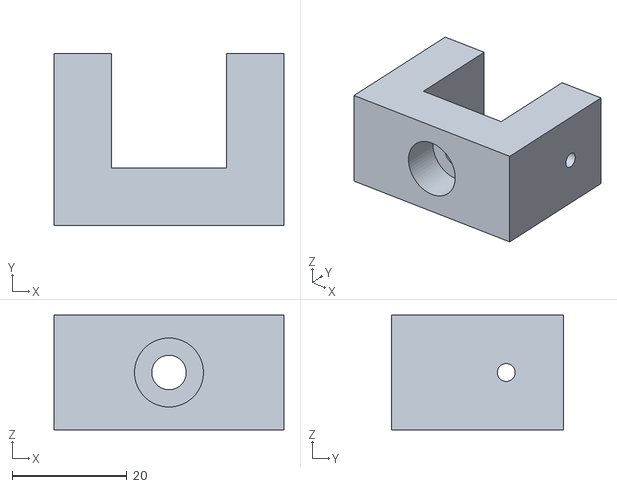
[picture p43: CAD file, 2026-05-05]
stl/voron/5mm-hole.stl
40.0 x 30.0 x 20.0
