zhcntiangang/seahorse.github.io/voron/stl/红色/[a]_guidler.stl

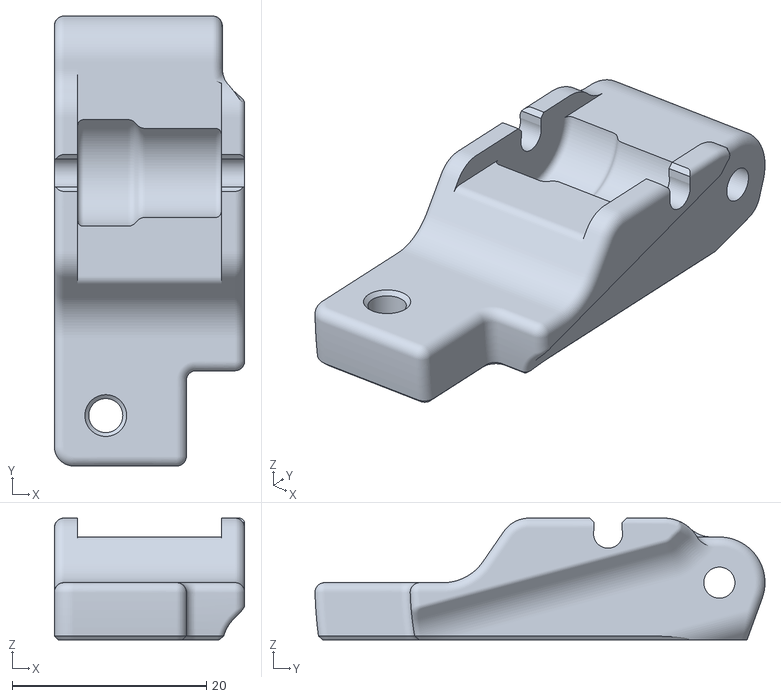
[picture p44: CAD file, 2026-05-05]
voron/stl/红色/[a]_guidler.stl
19.6 x 46.3 x 12.6
