zhcntiangang/seahorse.github.io/voron/stl/黑色/z_joint_lower_x4 -2.stl

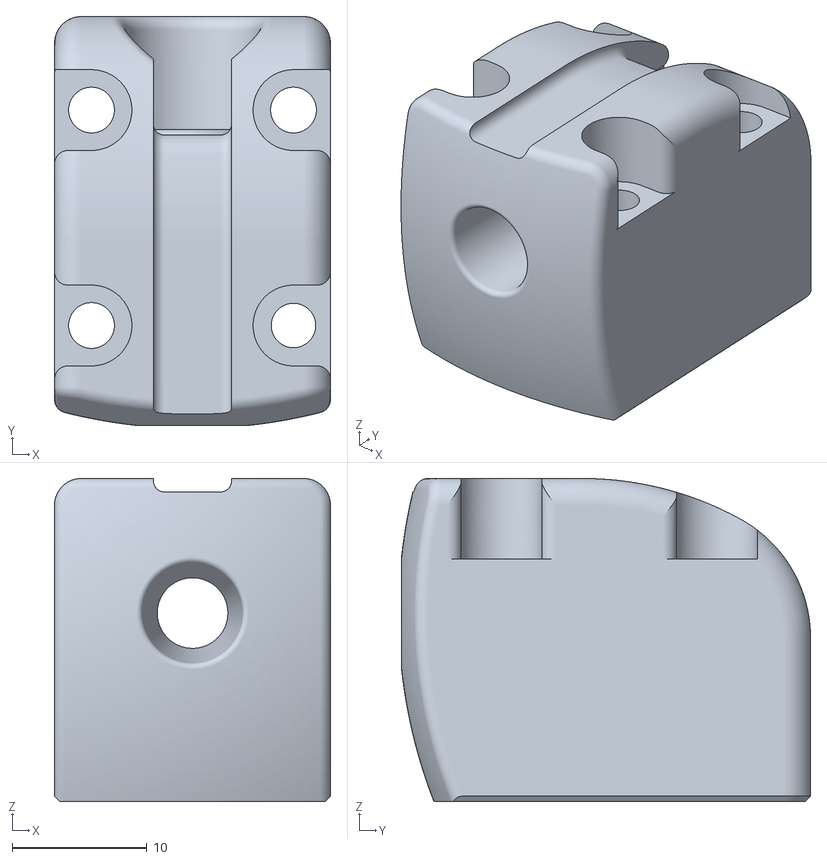
[picture p45: CAD file, 2026-05-05]
voron/stl/黑色/z_joint_lower_x4 -2.stl
20.5 x 30.4 x 24.0
