zhcntiangang/seahorse.github.io/babylon/printhead_front_e3dv6.stl

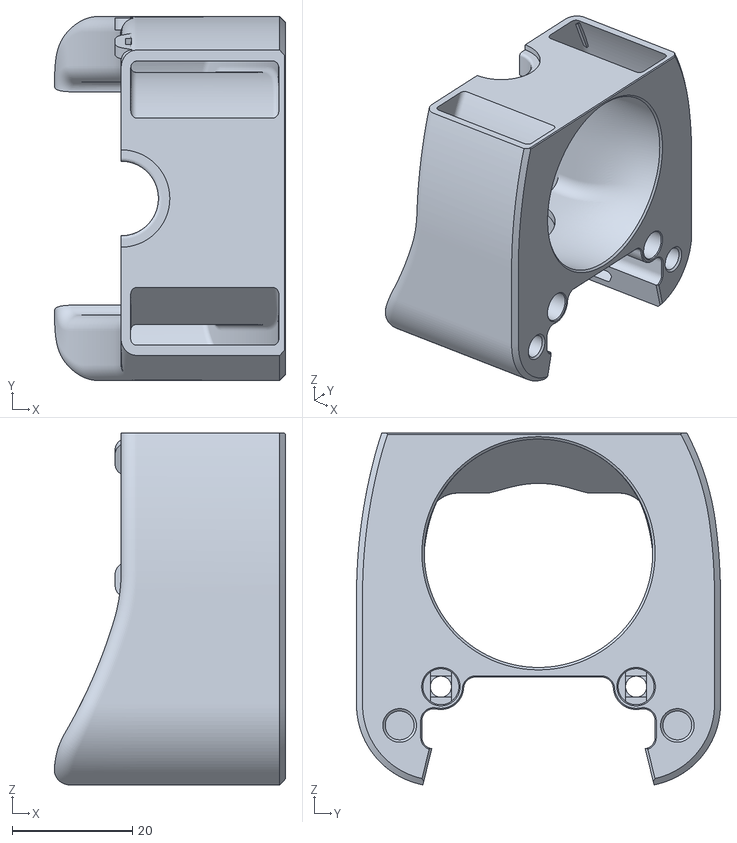
[picture p46: CAD file, 2026-05-05]
babylon/printhead_front_e3dv6.stl
38.5 x 60.6 x 58.6
