zhcntiangang/seahorse.github.io/gzt/中轴（大）-合并 v2.stl

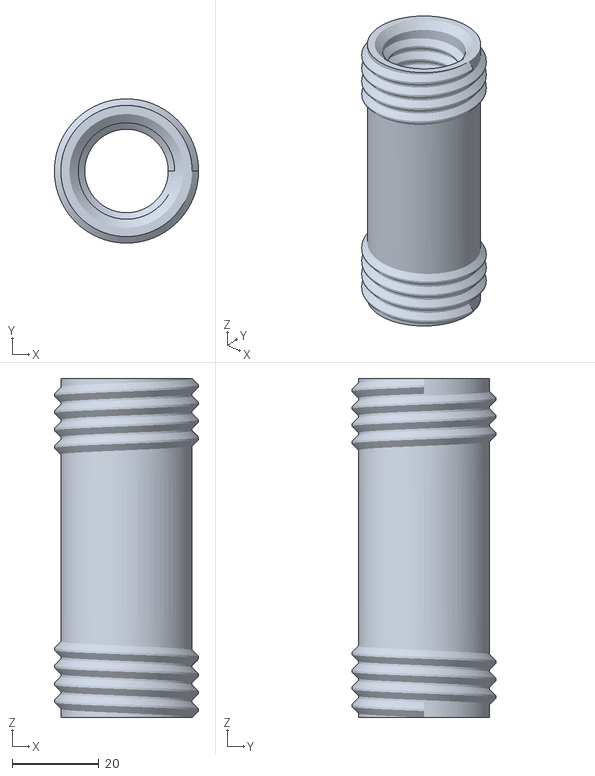
[picture p47: CAD file, 2026-05-05]
gzt/中轴（大）-合并 v2.stl
33.2 x 33.2 x 78.0
