zhcntiangang/seahorse.github.io/stl/calibration/百分表固定件.stl

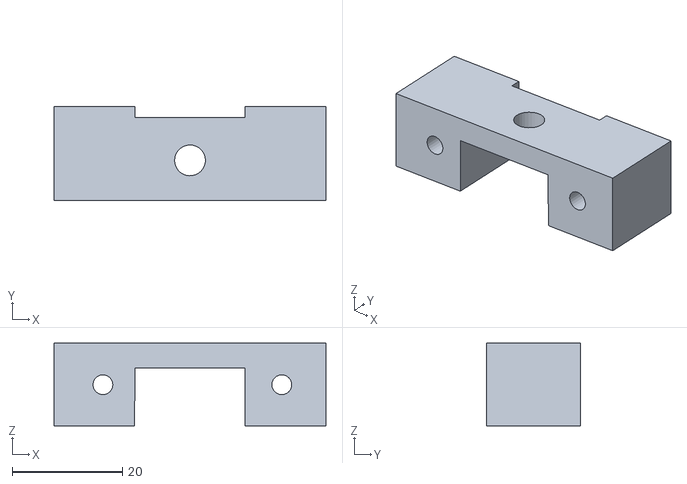
[picture p48: CAD file, 2026-05-05]
stl/calibration/百分表固定件.stl
49.4 x 17.0 x 15.0
