zhcntiangang/seahorse.github.io/stl/temperaturetower.stl

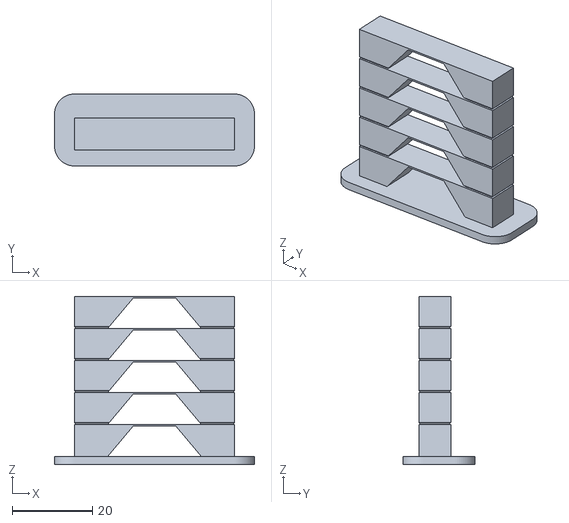
[picture p49: CAD file, 2026-05-05]
stl/temperaturetower.stl
50.0 x 18.0 x 42.0
