zhcntiangang/seahorse.github.io/stl/upgrade/把手垫片.stl

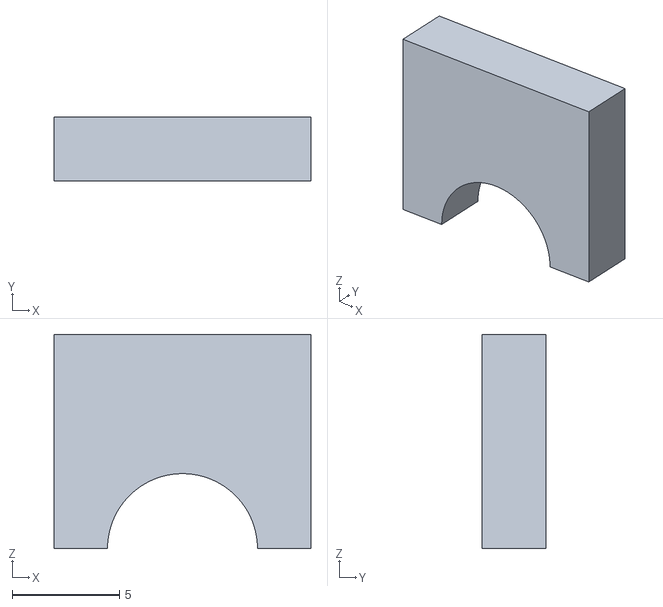
[picture p50: CAD file, 2026-05-05]
stl/upgrade/把手垫片.stl
12.0 x 3.00 x 10.0
