zhcntiangang/seahorse.github.io/stl/voron/6mm-hole.stl

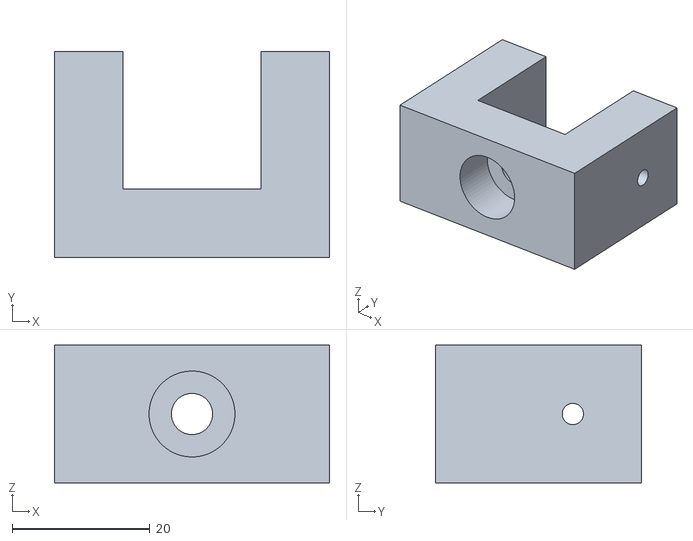
[picture p51: CAD file, 2026-05-05]
stl/voron/6mm-hole.stl
40.0 x 30.0 x 20.0
