zhcntiangang/seahorse.github.io/voron/stl/红色/[a]_belt_tensioner_b_x2.stl

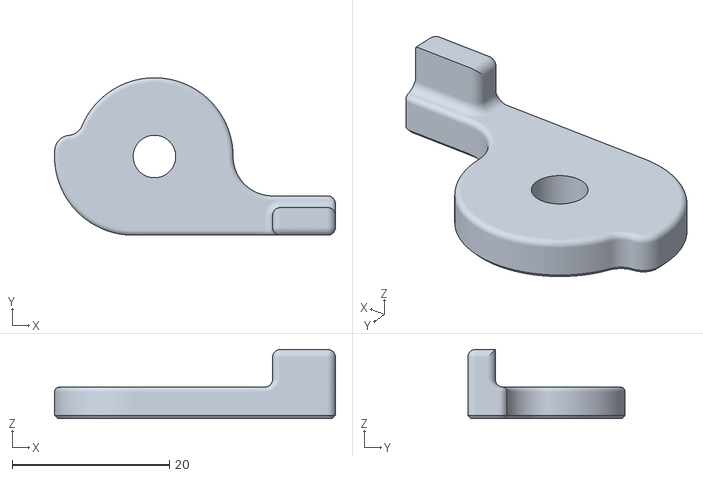
[picture p52: CAD file, 2026-05-05]
voron/stl/红色/[a]_belt_tensioner_b_x2.stl
35.7 x 20.0 x 8.80
