zhcntiangang/seahorse.github.io/voron/stl/黑色/extruder_motor_plate.stl

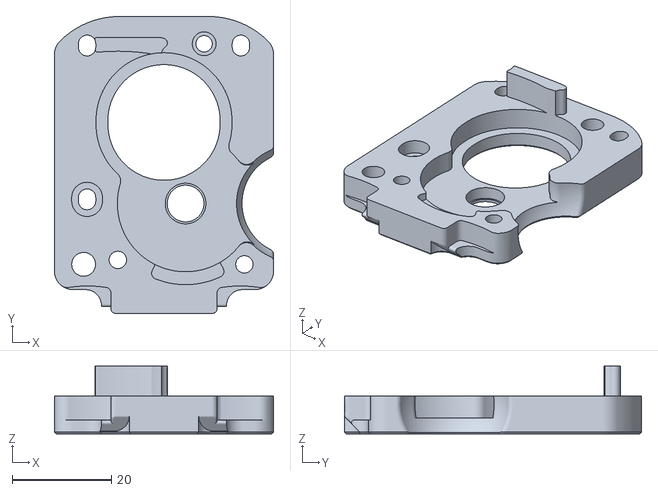
[picture p53: CAD file, 2026-05-05]
voron/stl/黑色/extruder_motor_plate.stl
44.2 x 59.9 x 13.7
