zhcntiangang/seahorse.github.io/babylon/ashe-1.stl

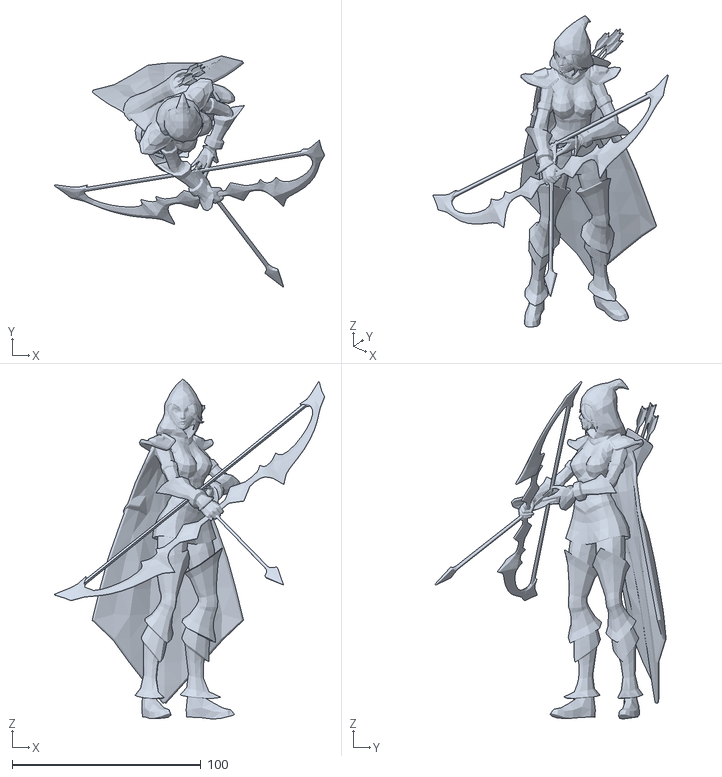
[picture p54: CAD file, 2026-05-05]
babylon/ashe-1.stl
143.3 x 122.6 x 180.2
