zhcntiangang/seahorse.github.io/gzt/三角支撑 v2 - 1.stl

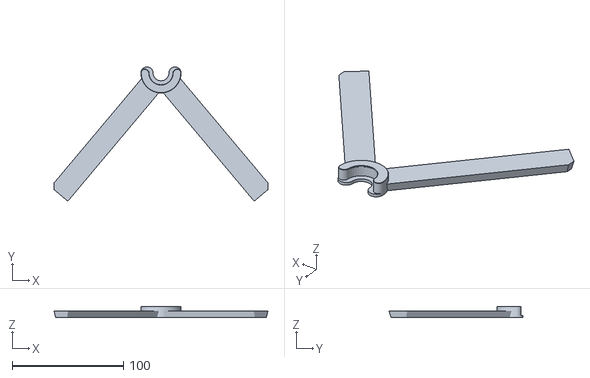
[picture p55: CAD file, 2026-05-05]
gzt/三角支撑 v2 - 1.stl
192.0 x 120.6 x 10.0
