zhcntiangang/seahorse.github.io/stl/calibration/hole-calibration-just-ok.stl

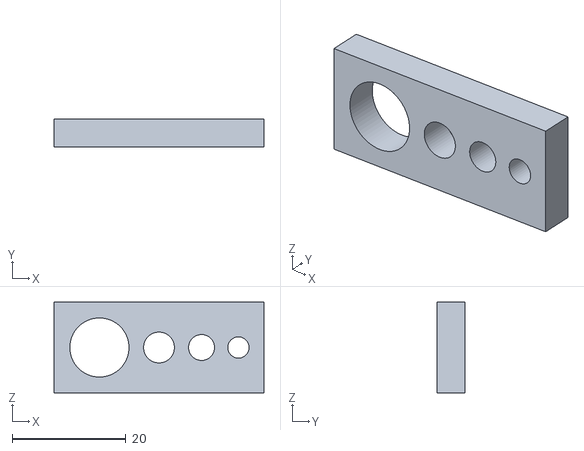
[picture p56: CAD file, 2026-05-05]
stl/calibration/hole-calibration-just-ok.stl
37.0 x 5.00 x 16.0
