zhcntiangang/seahorse.github.io/stl/retractiontest.stl

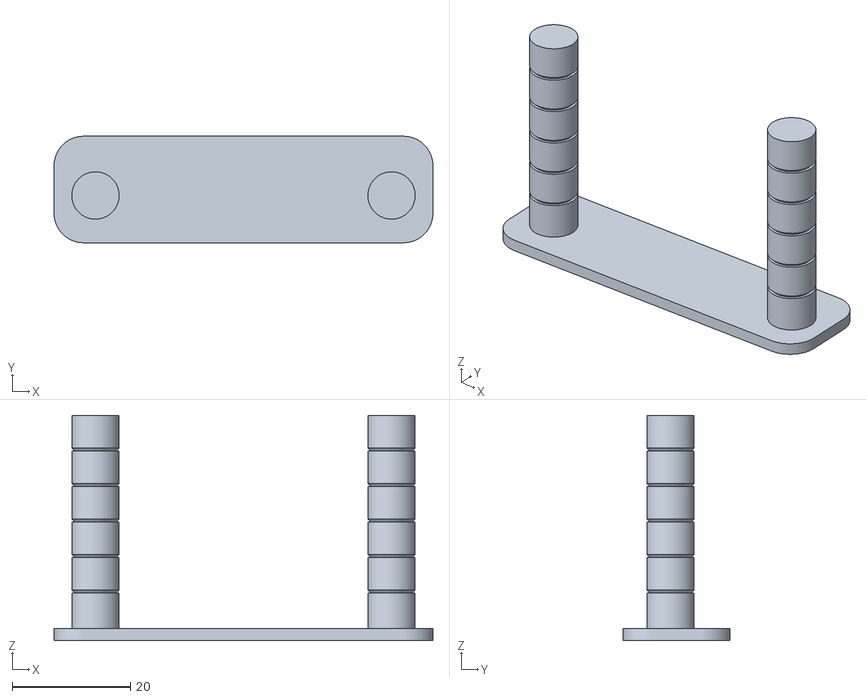
[picture p57: CAD file, 2026-05-05]
stl/retractiontest.stl
64.0 x 18.0 x 38.0
