zhcntiangang/seahorse.github.io/stl/upgrade/Magnetic_Panels_with_Magnet_Inserts/Corner-Clip-6mm.stl

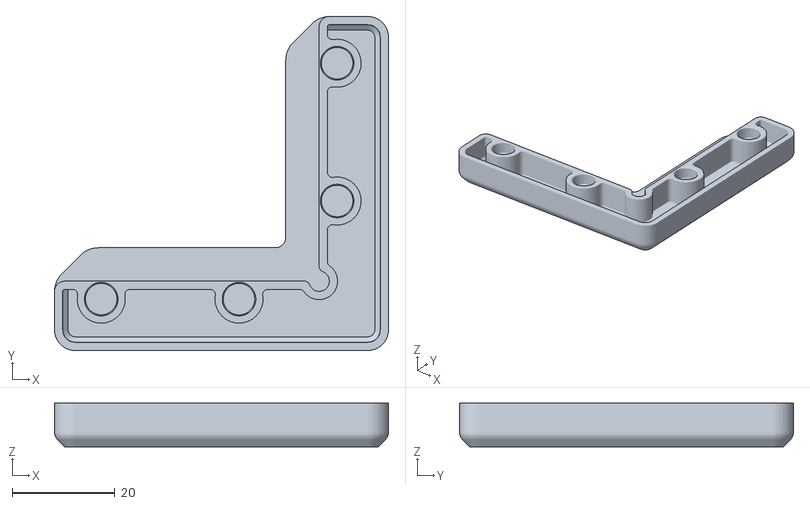
[picture p58: CAD file, 2026-05-05]
stl/upgrade/Magnetic_Panels_with_Magnet_Inserts/Corner-Clip-6mm.stl
65.0 x 65.0 x 8.50
