zhcntiangang/seahorse.github.io/stl/upgrade/中轴小区区-缩小版 v1.stl

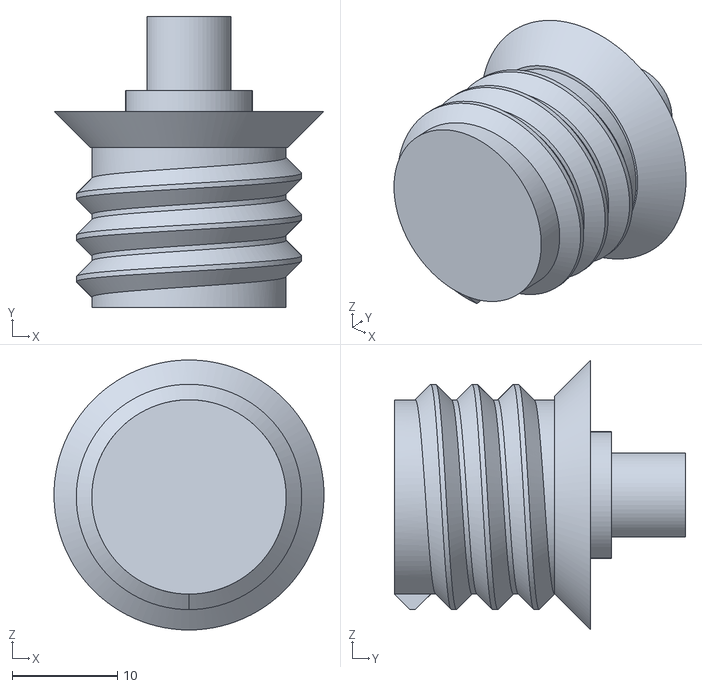
[picture p59: CAD file, 2026-05-05]
stl/upgrade/中轴小区区-缩小版 v1.stl
25.6 x 27.6 x 25.6
