zhcntiangang/seahorse.github.io/voron/stl/红色/[a]_z_chain_retainer_bracket_x2 - 1.stl

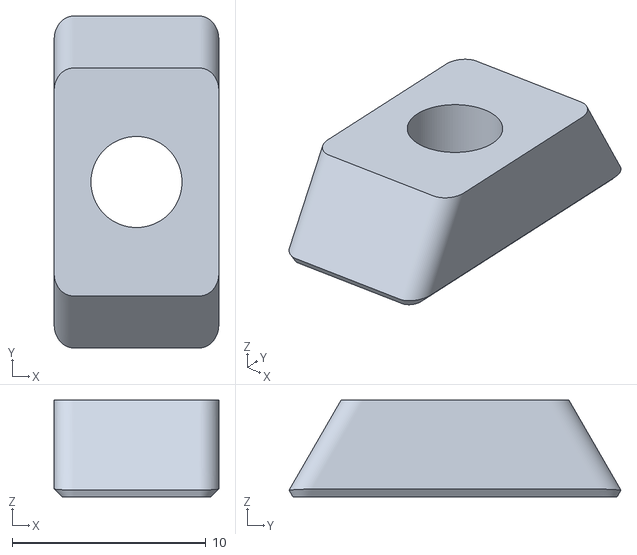
[picture p60: CAD file, 2026-05-05]
voron/stl/红色/[a]_z_chain_retainer_bracket_x2 - 1.stl
8.50 x 17.1 x 5.00
