zhcntiangang/seahorse.github.io/voron/stl/黑色/z_tensioner_bracket_a_x2.stl

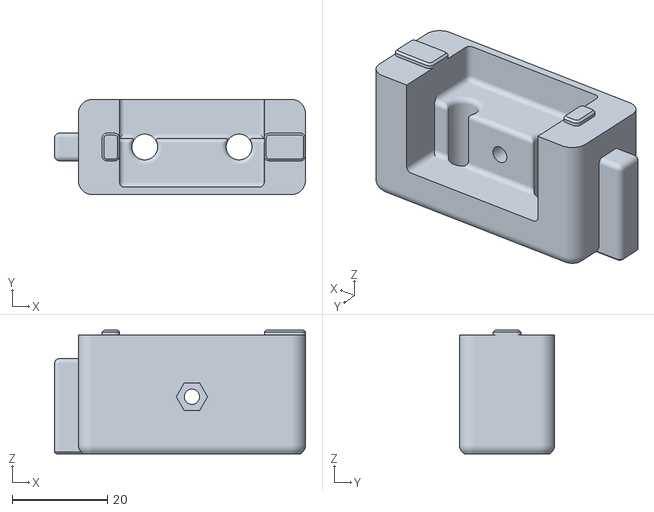
[picture p61: CAD file, 2026-05-05]
voron/stl/黑色/z_tensioner_bracket_a_x2.stl
52.7 x 20.0 x 26.0
