zhcntiangang/seahorse.github.io/gzt/中轴小区区 v1.stl

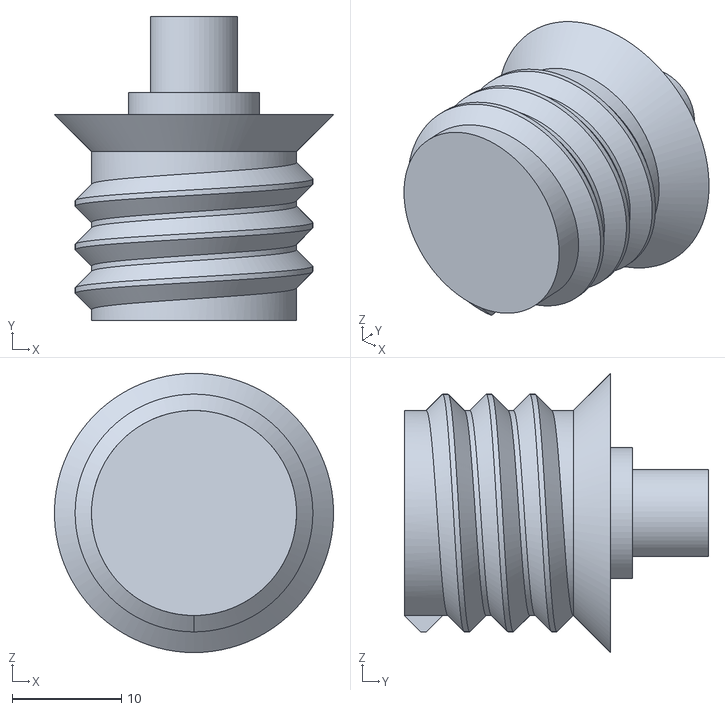
[picture p62: CAD file, 2026-05-05]
gzt/中轴小区区 v1.stl
25.6 x 27.9 x 25.6
