zhcntiangang/seahorse.github.io/stl/calibration/Voron_Design_Cube_v7.stl

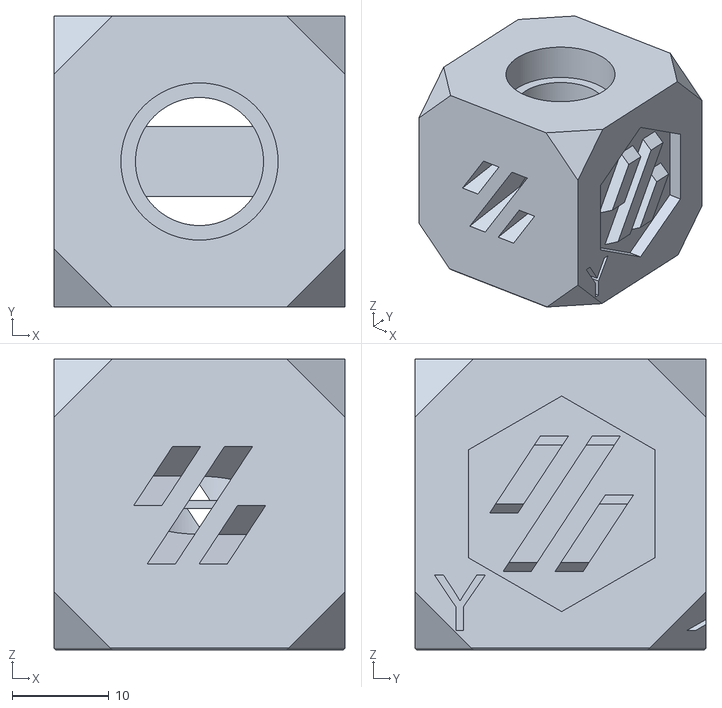
[picture p63: CAD file, 2026-05-05]
stl/calibration/Voron_Design_Cube_v7.stl
30.0 x 30.0 x 30.0
