zhcntiangang/seahorse.github.io/stl/retractiontestv2.stl

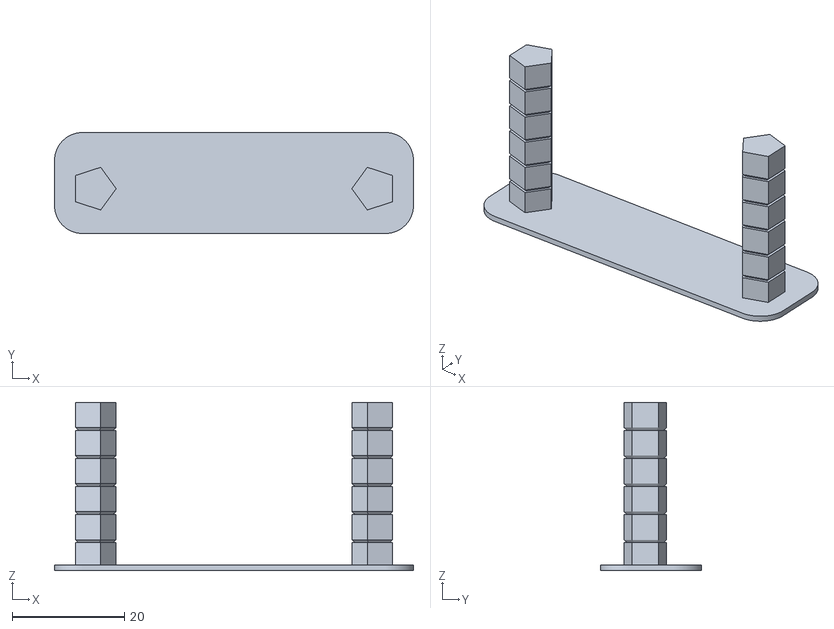
[picture p64: CAD file, 2026-05-05]
stl/retractiontestv2.stl
64.0 x 18.0 x 30.0
