zhcntiangang/seahorse.github.io/stl/upgrade/Magnetic_Panels_with_Magnet_Inserts/Magnet-Insert-v2.stl

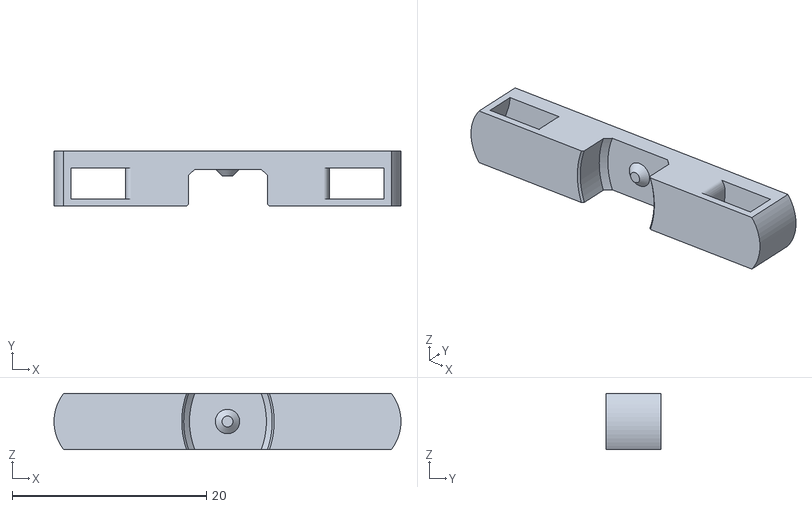
[picture p65: CAD file, 2026-05-05]
stl/upgrade/Magnetic_Panels_with_Magnet_Inserts/Magnet-Insert-v2.stl
35.7 x 5.70 x 5.80
