zhcntiangang/seahorse.github.io/voron/stl/黑色/z_motor_mount_b_x2.stl

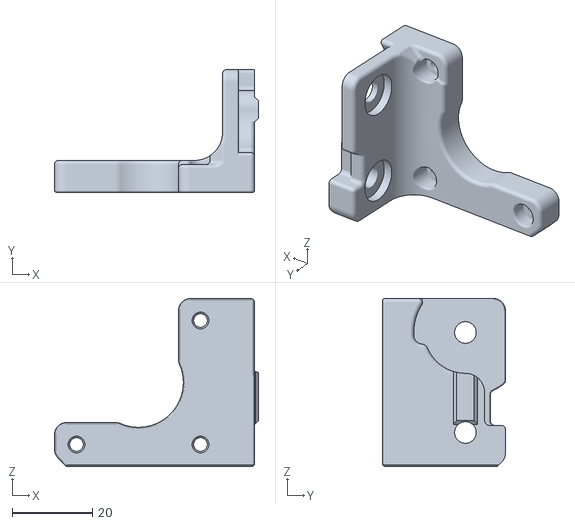
[picture p66: CAD file, 2026-05-05]
voron/stl/黑色/z_motor_mount_b_x2.stl
51.0 x 30.7 x 42.0
