zhcntiangang/seahorse.github.io/stl/calibration/hole-calibration-column.stl

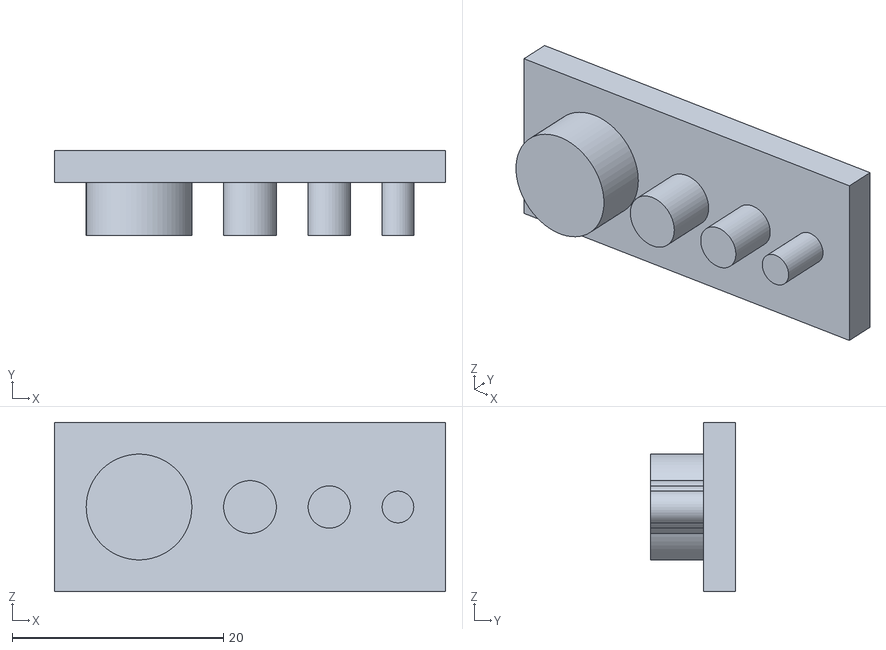
[picture p67: CAD file, 2026-05-05]
stl/calibration/hole-calibration-column.stl
37.0 x 8.00 x 16.0
