zhcntiangang/seahorse.github.io/stl/speedtower.stl

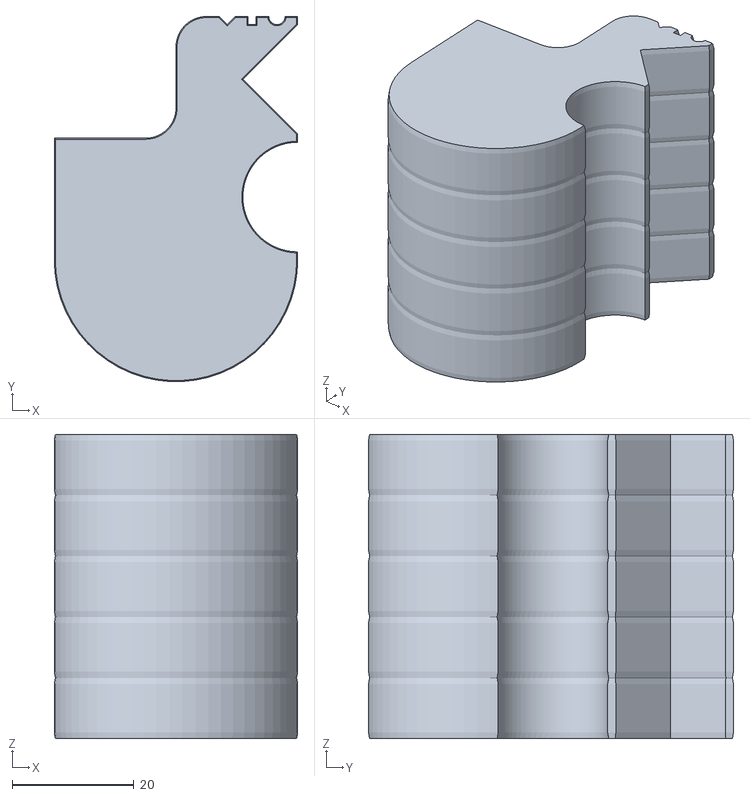
[picture p68: CAD file, 2026-05-05]
stl/speedtower.stl
40.0 x 60.0 x 50.0
