zhcntiangang/seahorse.github.io/voron/stl/黑色/z_drive_retainer_b_x2.stl

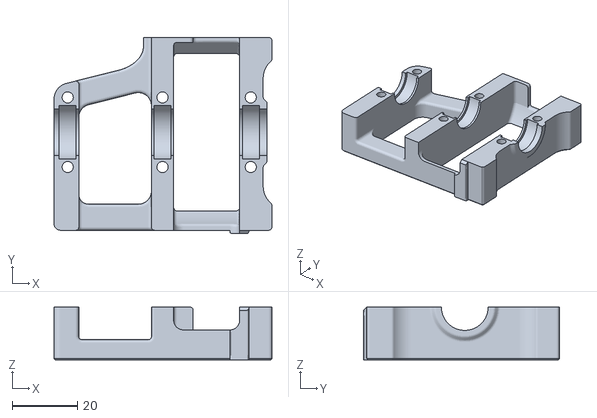
[picture p70: CAD file, 2026-05-05]
voron/stl/黑色/z_drive_retainer_b_x2.stl
66.7 x 60.0 x 16.2
