zhcntiangang/seahorse.github.io/stl/5mmTest.stl

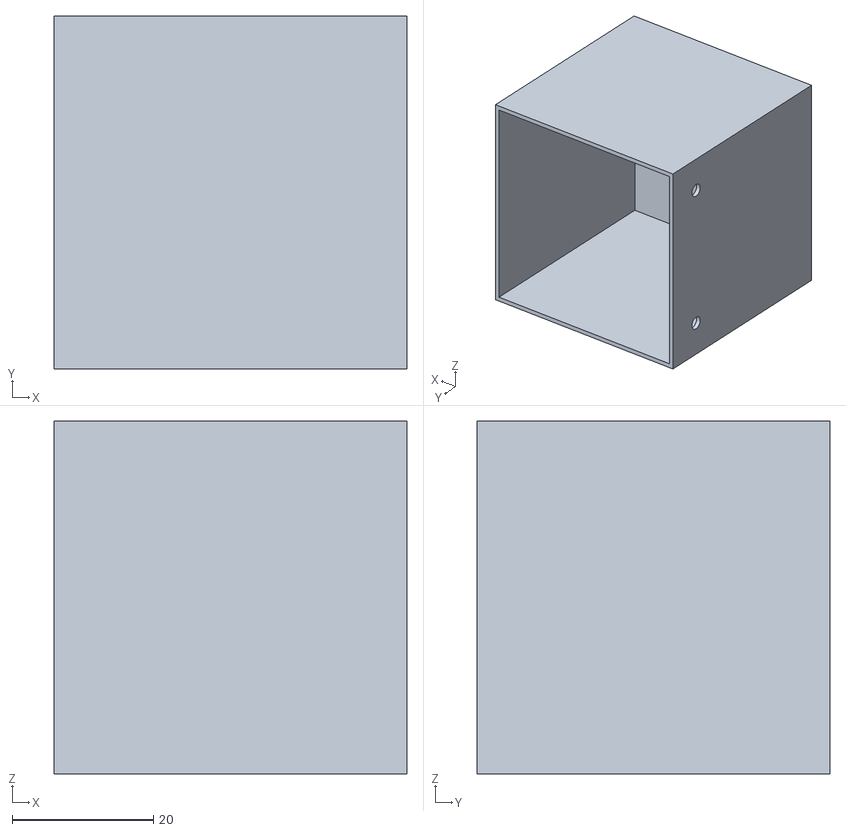
[picture p72: CAD file, 2026-05-05]
stl/5mmTest.stl
50.0 x 50.0 x 50.0
