zhcntiangang/seahorse.github.io/stl/upgrade/Magnetic_Panels_with_Magnet_Inserts/Unhammer-v2-Hex-Head.stl

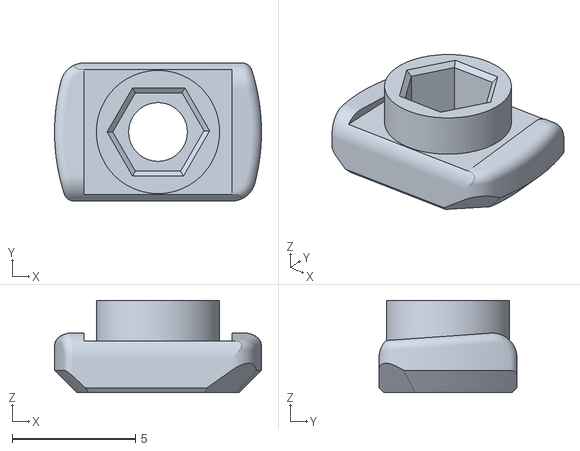
[picture p73: CAD file, 2026-05-05]
stl/upgrade/Magnetic_Panels_with_Magnet_Inserts/Unhammer-v2-Hex-Head.stl
8.40 x 5.60 x 3.75
