zhcntiangang/seahorse.github.io/voron/stl/红色/[a]_tensioner_left.stl

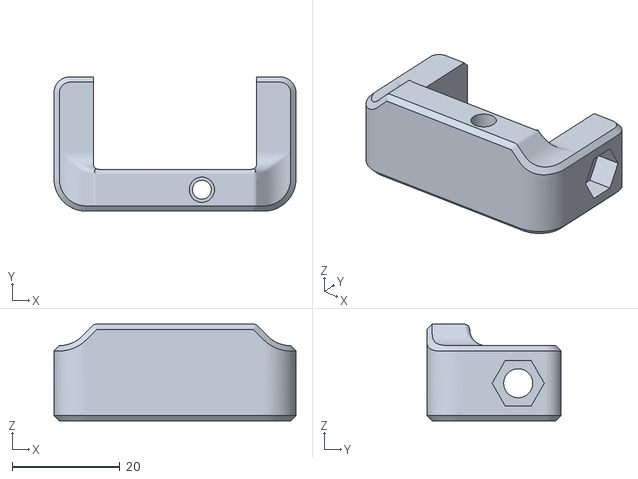
[picture p74: CAD file, 2026-05-05]
voron/stl/红色/[a]_tensioner_left.stl
45.0 x 25.0 x 18.0
