zhcntiangang/seahorse.github.io/voron/stl/黑色/pinda_adapter.stl

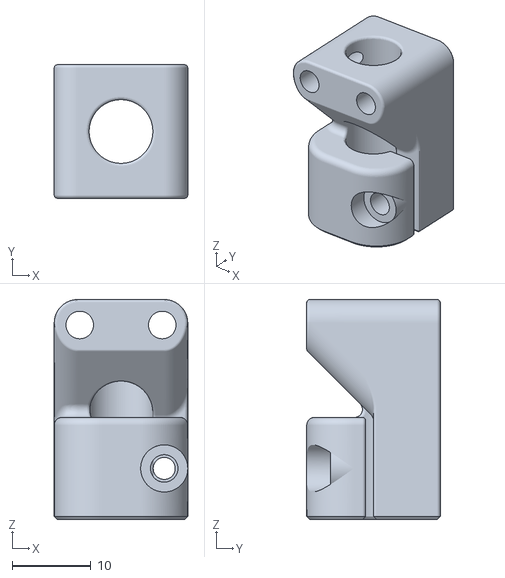
[picture p75: CAD file, 2026-05-05]
voron/stl/黑色/pinda_adapter.stl
17.0 x 17.0 x 28.0
