zhcntiangang/seahorse.github.io/gzt/中轴螺母 v1.stl

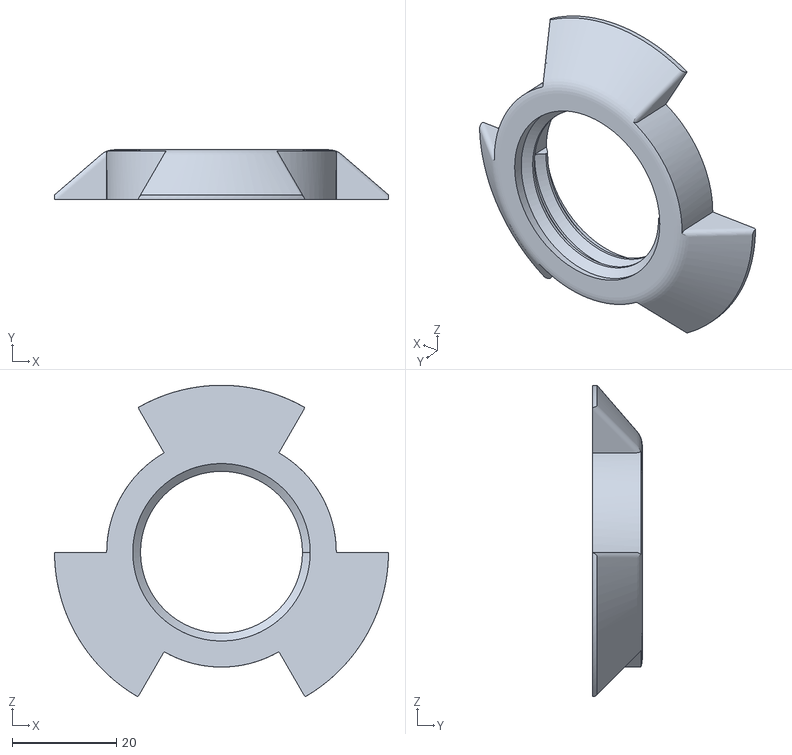
[picture p76: CAD file, 2026-05-05]
gzt/中轴螺母 v1.stl
64.0 x 9.50 x 59.7
