zhcntiangang/seahorse.github.io/stl/calibration/xyzCalibration_cube.stl

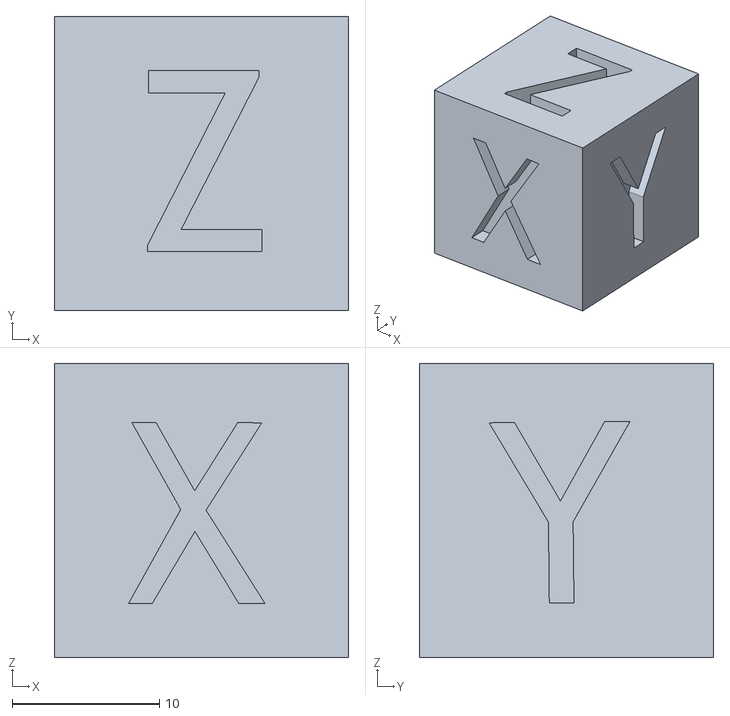
[picture p77: CAD file, 2026-05-05]
stl/calibration/xyzCalibration_cube.stl
20.0 x 20.0 x 20.0
