zhcntiangang/seahorse.github.io/stl/calibrationCube.stl

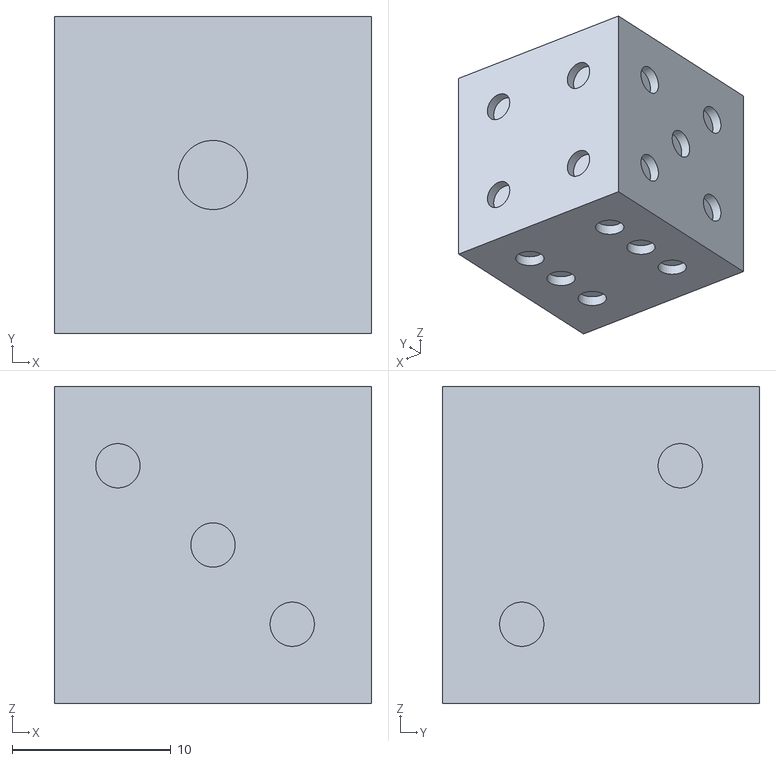
[picture p78: CAD file, 2026-05-05]
stl/calibrationCube.stl
20.0 x 20.0 x 20.0
