zhcntiangang/seahorse.github.io/voron/stl/红色/[a]_blower_housing_front.stl

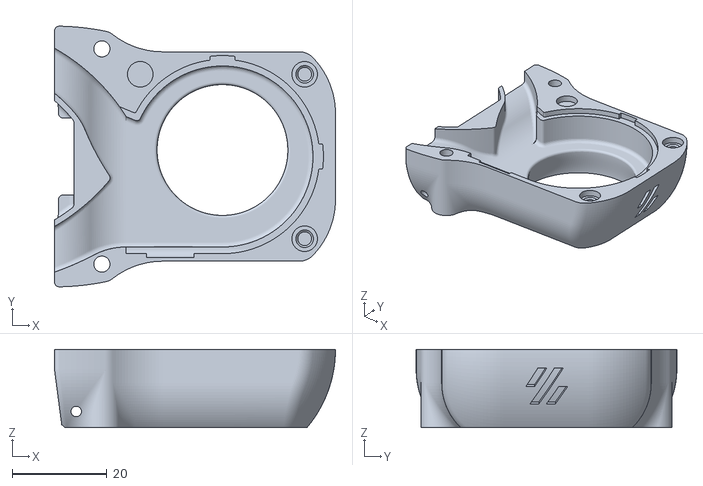
[picture p80: CAD file, 2026-05-05]
voron/stl/红色/[a]_blower_housing_front.stl
59.3 x 55.0 x 16.5
