zhcntiangang/seahorse.github.io/voron/stl/黑色/power_inlet_filtered.stl

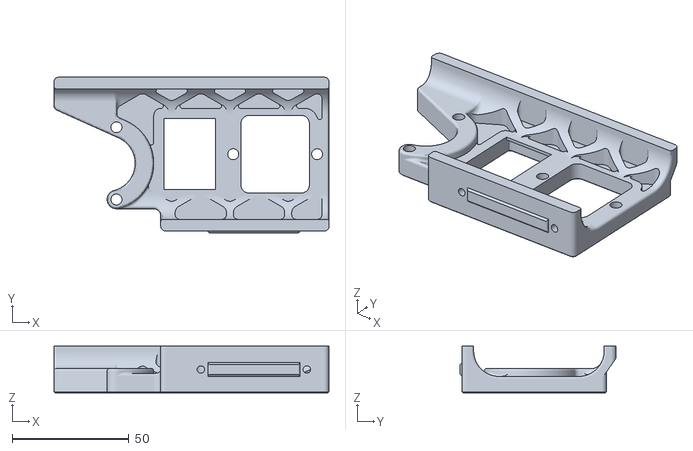
[picture p81: CAD file, 2026-05-05]
voron/stl/黑色/power_inlet_filtered.stl
118.0 x 66.8 x 20.0
