zhcntiangang/seahorse.github.io/stl/temperaturetowerv2.stl

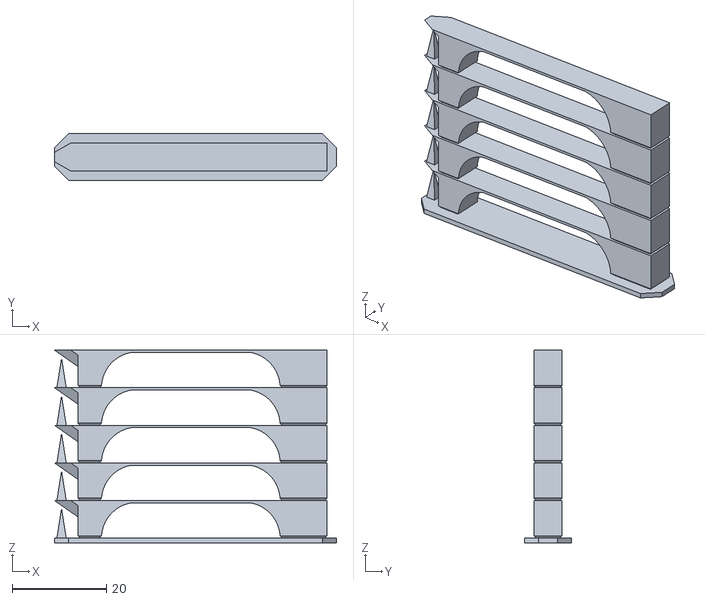
[picture p82: CAD file, 2026-05-05]
stl/temperaturetowerv2.stl
60.0 x 10.0 x 41.0
