zhcntiangang/seahorse.github.io/stl/upgrade/Magnetic_Panels_with_Magnet_Inserts/Midspan-Clip-6mm.stl

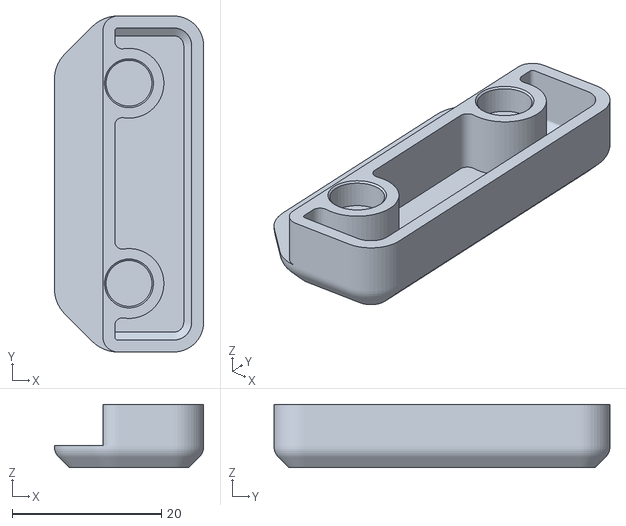
[picture p83: CAD file, 2026-05-05]
stl/upgrade/Magnetic_Panels_with_Magnet_Inserts/Midspan-Clip-6mm.stl
20.0 x 45.0 x 8.50
