zhcntiangang/seahorse.github.io/voron/stl/红色/[a]_cable_cover.stl

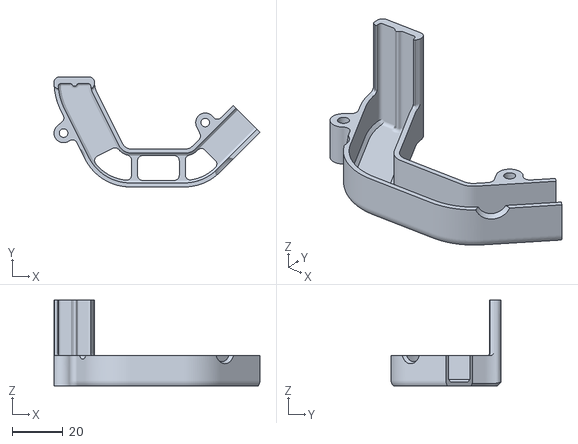
[picture p84: CAD file, 2026-05-05]
voron/stl/红色/[a]_cable_cover.stl
81.5 x 43.5 x 34.0
