zhcntiangang/seahorse.github.io/stl/upgrade/Magnetic_Panels_with_Magnet_Inserts/Mid-Panel-Clip-7mm-Lip.stl

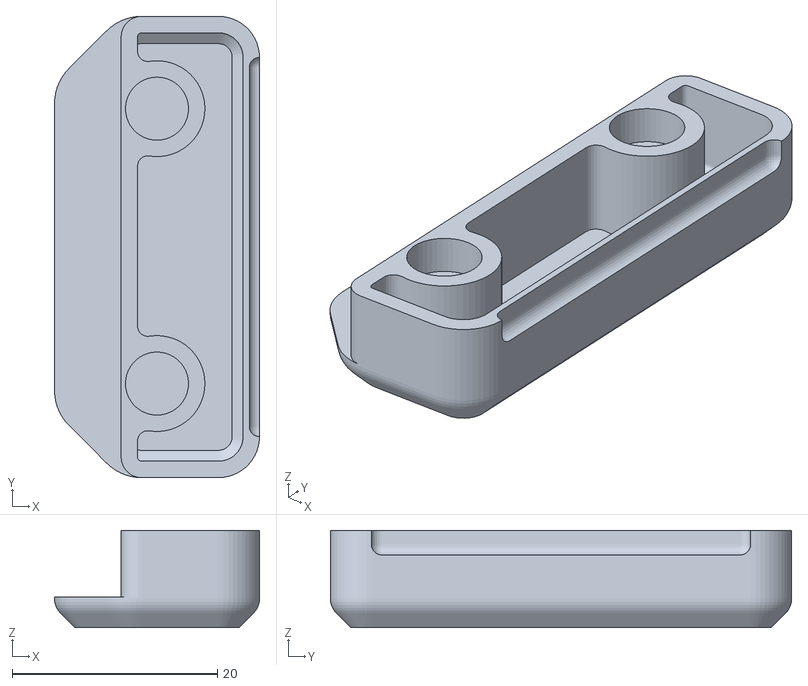
[picture p86: CAD file, 2026-05-05]
stl/upgrade/Magnetic_Panels_with_Magnet_Inserts/Mid-Panel-Clip-7mm-Lip.stl
20.0 x 45.0 x 9.50
