zhcntiangang/seahorse.github.io/voron/stl/红色/[a]_z_belt_clip_lower_x4 - 3.stl

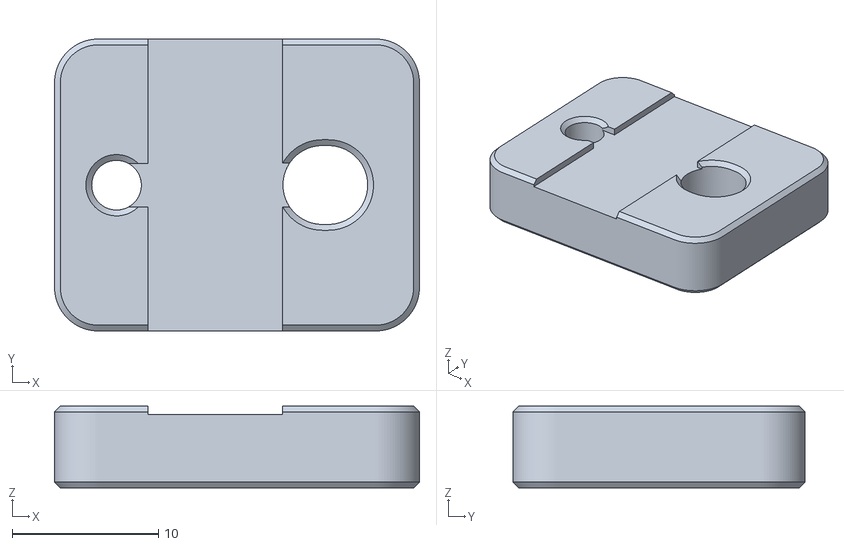
[picture p87: CAD file, 2026-05-05]
voron/stl/红色/[a]_z_belt_clip_lower_x4 - 3.stl
25.0 x 20.0 x 5.60
