zhcntiangang/seahorse.github.io/voron/stl/黑色/extruder_body.stl

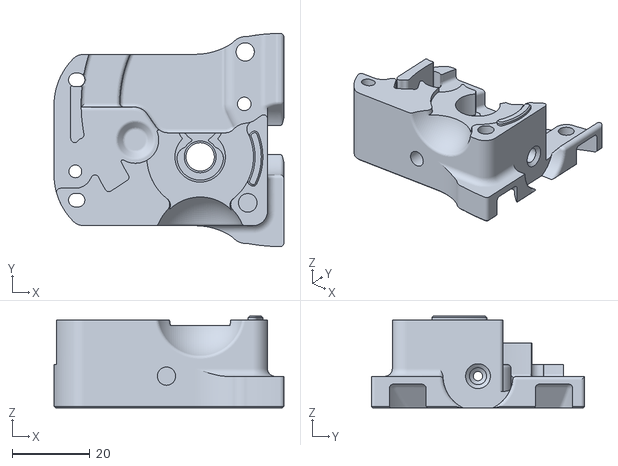
[picture p88: CAD file, 2026-05-05]
voron/stl/黑色/extruder_body.stl
59.3 x 55.0 x 23.7
