zhcntiangang/seahorse.github.io/stl/upgrade/Magnetic_Panels_with_Magnet_Inserts/加宽部件.stl

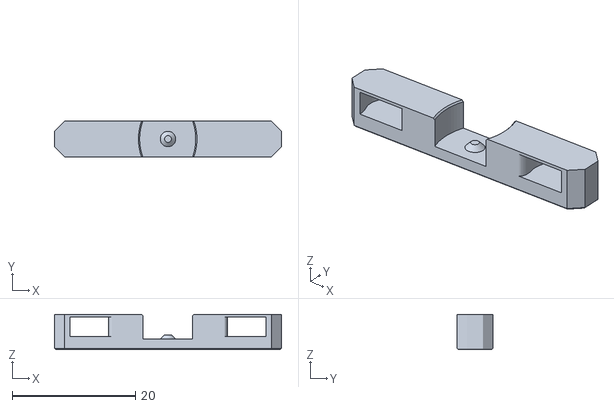
[picture p89: CAD file, 2026-05-05]
stl/upgrade/Magnetic_Panels_with_Magnet_Inserts/加宽部件.stl
36.9 x 5.80 x 5.70
