zhcntiangang/seahorse.github.io/voron/stl/黑色/nozzle_probe.stl

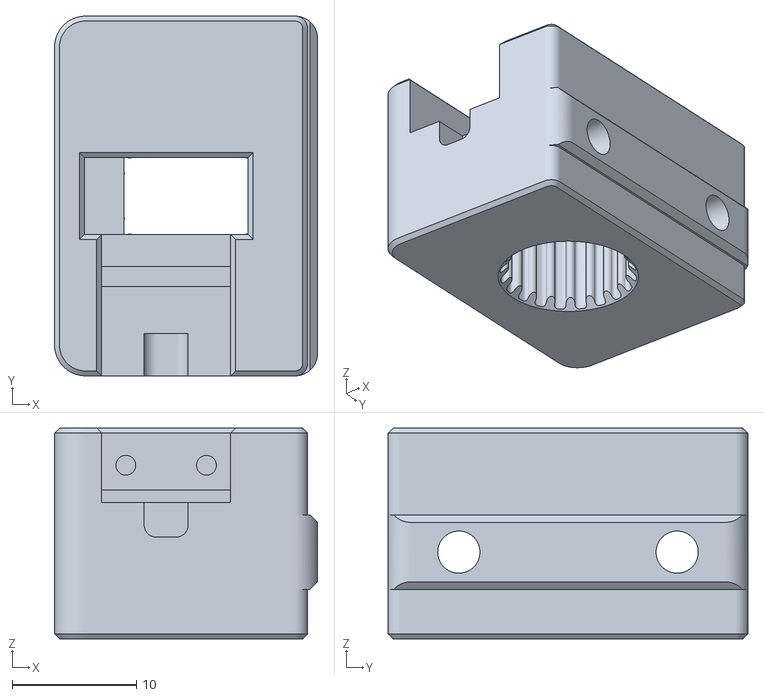
[picture p90: CAD file, 2026-05-05]
voron/stl/黑色/nozzle_probe.stl
21.2 x 29.0 x 17.0
