zhcntiangang/seahorse.github.io/voron/stl/黑色/b_drive_frame_upper.stl

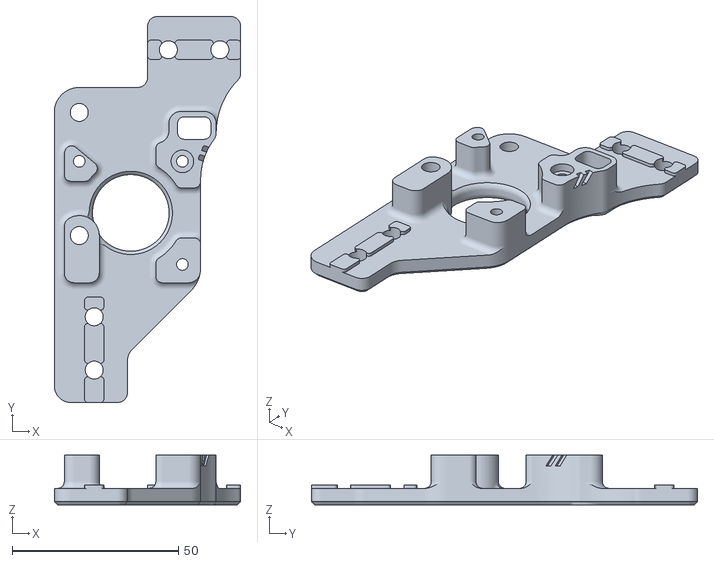
[picture p91: CAD file, 2026-05-05]
voron/stl/黑色/b_drive_frame_upper.stl
56.0 x 116.0 x 15.0
