zhcntiangang/seahorse.github.io/voron/stl/红色/[a]_z_tensioner_x4_9mm.stl

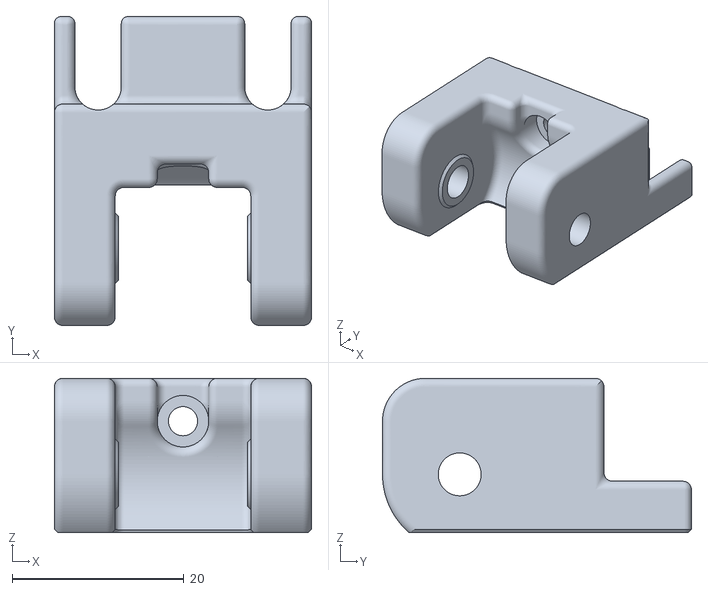
[picture p92: CAD file, 2026-05-05]
voron/stl/红色/[a]_z_tensioner_x4_9mm.stl
30.0 x 36.0 x 18.0
