zhcntiangang/seahorse.github.io/voron/stl/黑色/bowden_retainer.stl

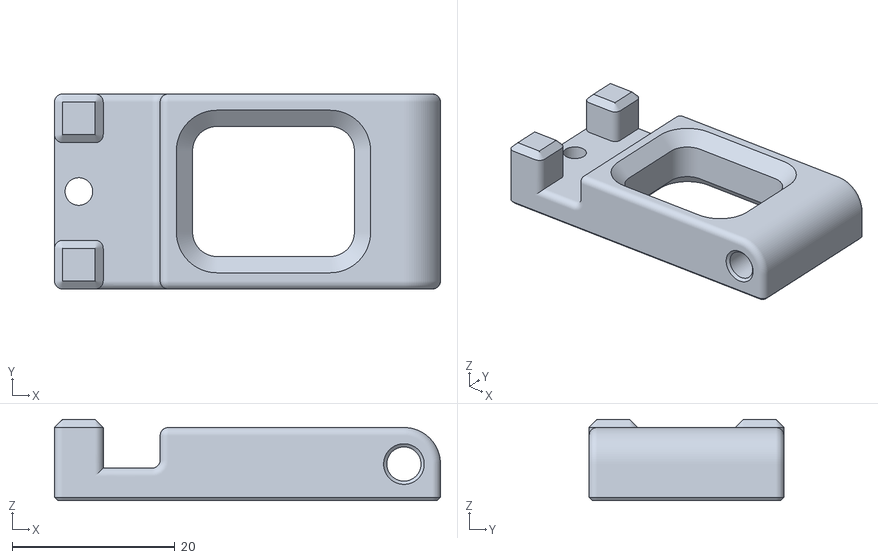
[picture p93: CAD file, 2026-05-05]
voron/stl/黑色/bowden_retainer.stl
47.5 x 24.0 x 10.00
