zhcntiangang/seahorse.github.io/voron/stl/红色/[a]_latch_shuttle.stl

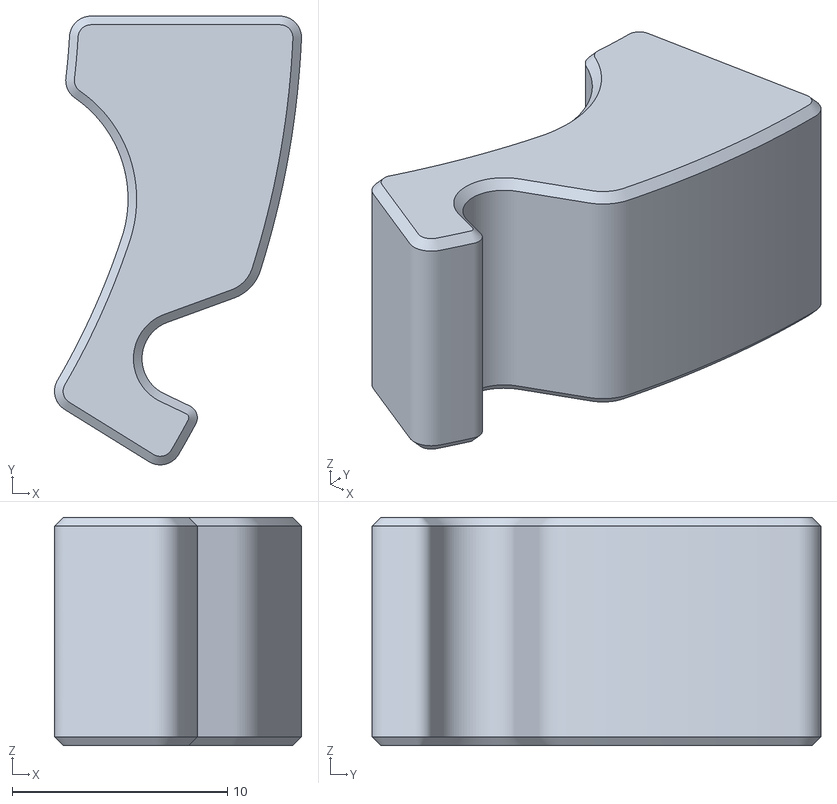
[picture p94: CAD file, 2026-05-05]
voron/stl/红色/[a]_latch_shuttle.stl
11.5 x 20.9 x 10.6
