zhcntiangang/seahorse.github.io/voron/stl/黑色/extruder_motor_plate_for_pcb.stl

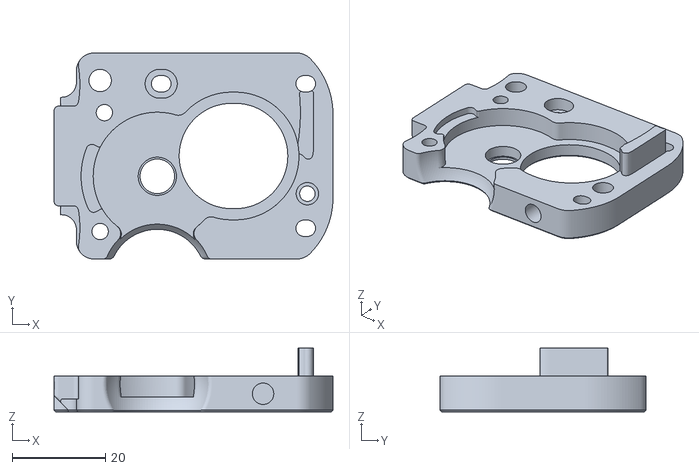
[picture p95: CAD file, 2026-05-05]
voron/stl/黑色/extruder_motor_plate_for_pcb.stl
59.9 x 44.2 x 13.7
