zhcntiangang/seahorse.github.io/stl/upgrade/Magnetic_Panels_with_Magnet_Inserts/Magnet-Insert-Side-v1.stl

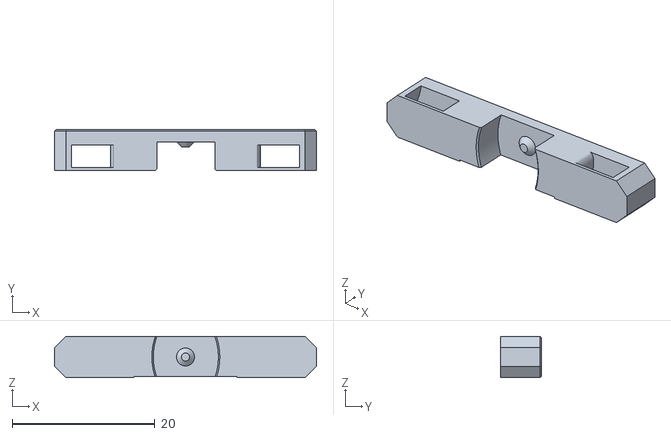
[picture p96: CAD file, 2026-05-05]
stl/upgrade/Magnetic_Panels_with_Magnet_Inserts/Magnet-Insert-Side-v1.stl
36.7 x 5.70 x 5.80
