zhcntiangang/seahorse.github.io/voron/stl/红色/[a]_xy_joint_cable_bridge_2hole.stl

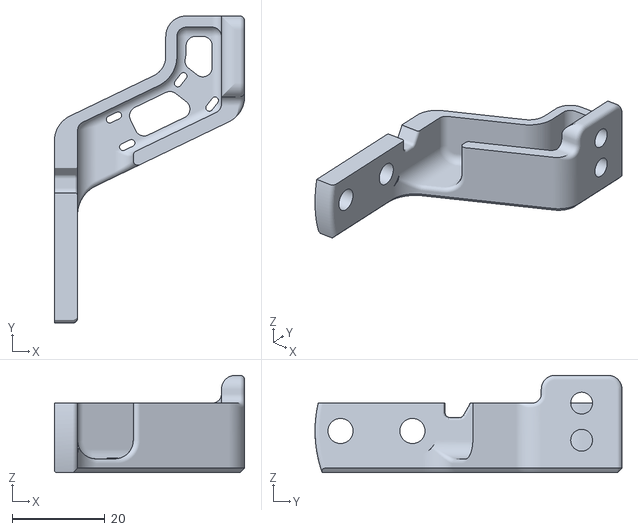
[picture p98: CAD file, 2026-05-05]
voron/stl/红色/[a]_xy_joint_cable_bridge_2hole.stl
41.0 x 66.1 x 21.0
