zhcntiangang/seahorse.github.io/voron/stl/黑色/z_joint_upper_hall_effect.stl

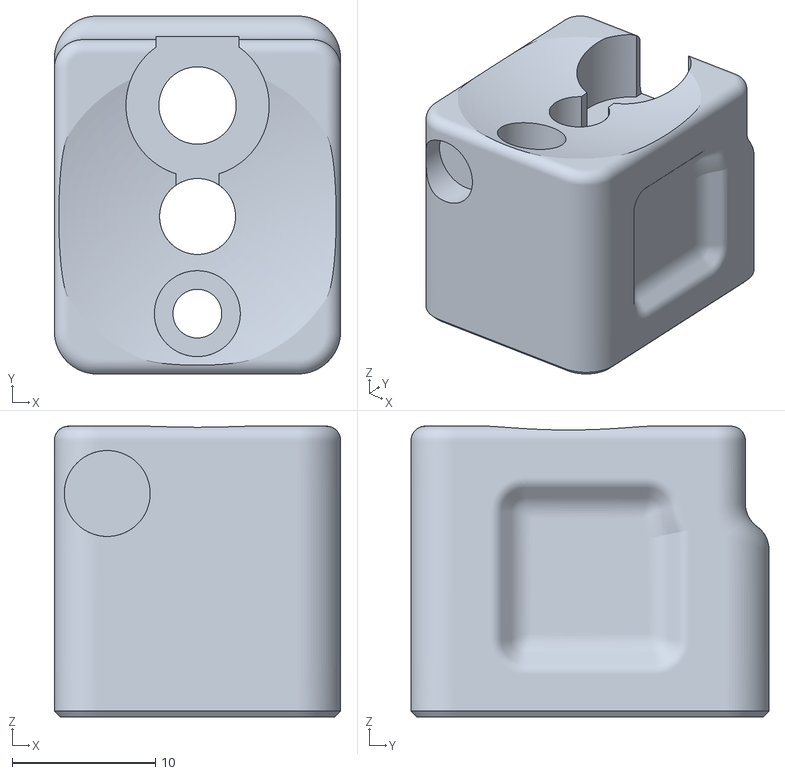
[picture p99: CAD file, 2026-05-05]
voron/stl/黑色/z_joint_upper_hall_effect.stl
20.0 x 25.0 x 20.3
