zhcntiangang/seahorse.github.io/stl/upgrade/Magnetic_Panels_with_Magnet_Inserts/Unhammer-v1.stl

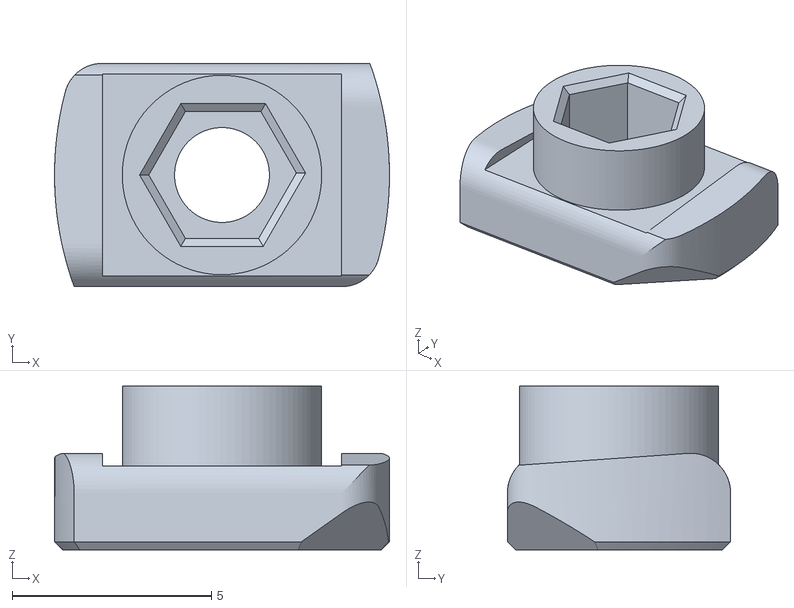
[picture p100: CAD file, 2026-05-05]
stl/upgrade/Magnetic_Panels_with_Magnet_Inserts/Unhammer-v1.stl
8.40 x 5.60 x 4.10
