zhcntiangang/seahorse.github.io/voron/stl/黑色/z_joint_upper_x4 - 2.stl

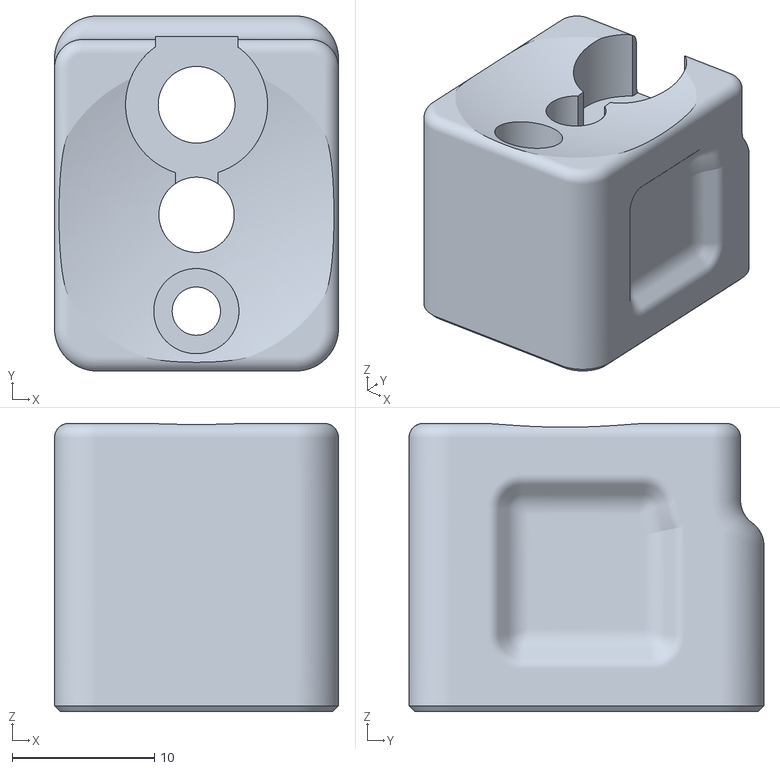
[picture p101: CAD file, 2026-05-05]
voron/stl/黑色/z_joint_upper_x4 - 2.stl
20.0 x 25.0 x 20.3
