zhcntiangang/seahorse.github.io/stl/upgrade/Magnetic_Panels_with_Magnet_Inserts/Unhammer-v2-Flat-Head.stl

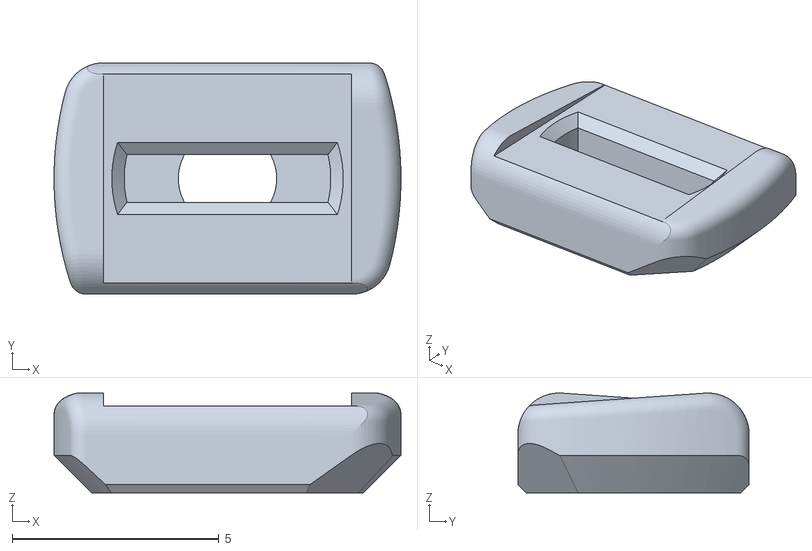
[picture p102: CAD file, 2026-05-05]
stl/upgrade/Magnetic_Panels_with_Magnet_Inserts/Unhammer-v2-Flat-Head.stl
8.40 x 5.60 x 2.42
