zhcntiangang/seahorse.github.io/stl/upgrade/Magnetic_Panels_with_Magnet_Inserts/Midspan-Clip-4mm-Lip.stl

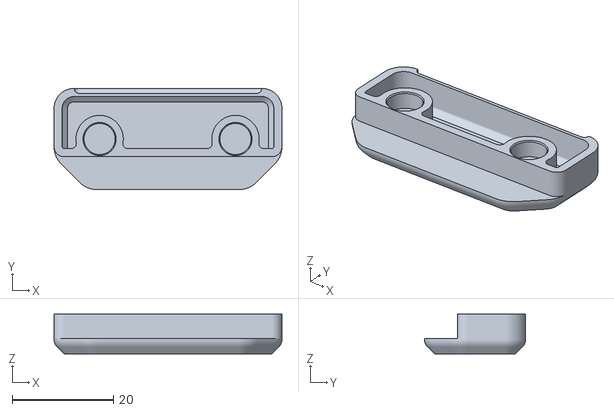
[picture p103: CAD file, 2026-05-05]
stl/upgrade/Magnetic_Panels_with_Magnet_Inserts/Midspan-Clip-4mm-Lip.stl
45.0 x 20.0 x 7.80
