zhcntiangang/seahorse.github.io/voron/stl/红色/[a]_z_drive_baseplate_a_x2.stl

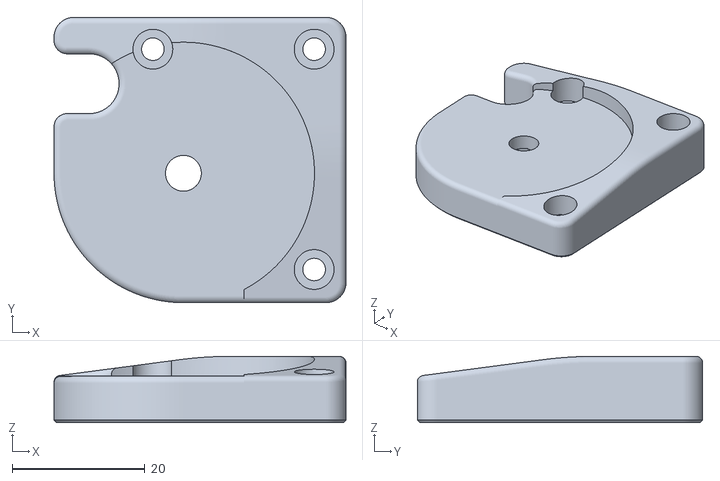
[picture p104: CAD file, 2026-05-05]
voron/stl/红色/[a]_z_drive_baseplate_a_x2.stl
44.0 x 43.0 x 10.0
