zhcntiangang/seahorse.github.io/voron/stl/黑色/chain_anchor_2hole.stl

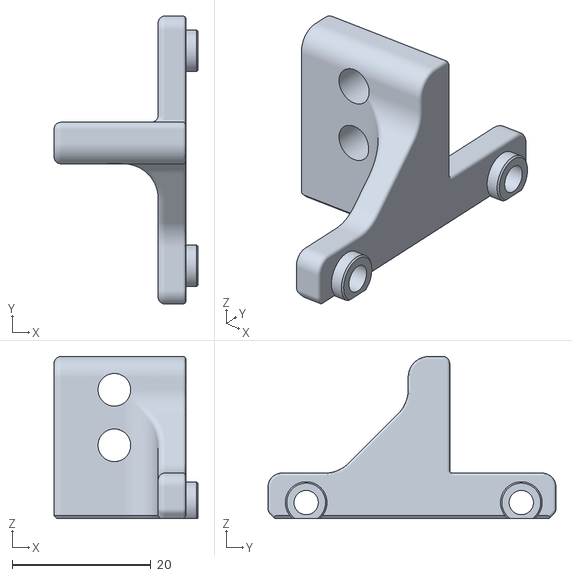
[picture p105: CAD file, 2026-05-05]
voron/stl/黑色/chain_anchor_2hole.stl
20.7 x 41.5 x 23.4
