zhcntiangang/seahorse.github.io/voron/stl/黑色/z_chain_guide.stl

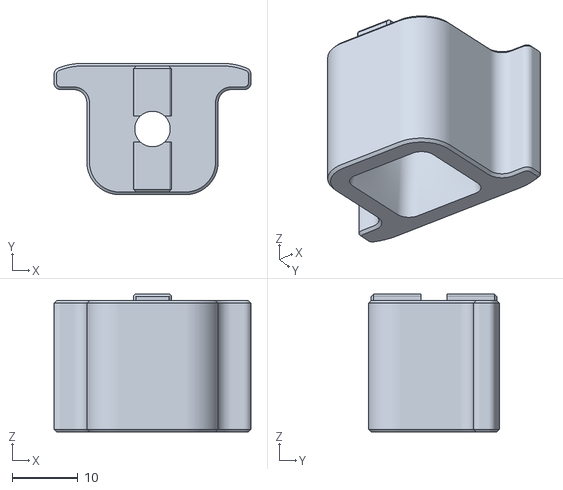
[picture p106: CAD file, 2026-05-05]
voron/stl/黑色/z_chain_guide.stl
30.0 x 20.0 x 21.0
