zhcntiangang/seahorse.github.io/voron/stl/黑色/front_idler_left_upper.stl

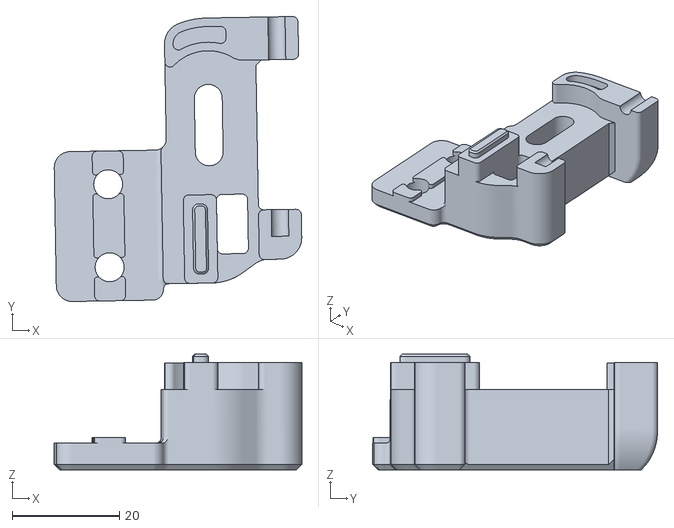
[picture p107: CAD file, 2026-05-05]
voron/stl/黑色/front_idler_left_upper.stl
46.2 x 53.2 x 21.6
