zhcntiangang/seahorse.github.io/voron/stl/红色/[a]_latch.stl

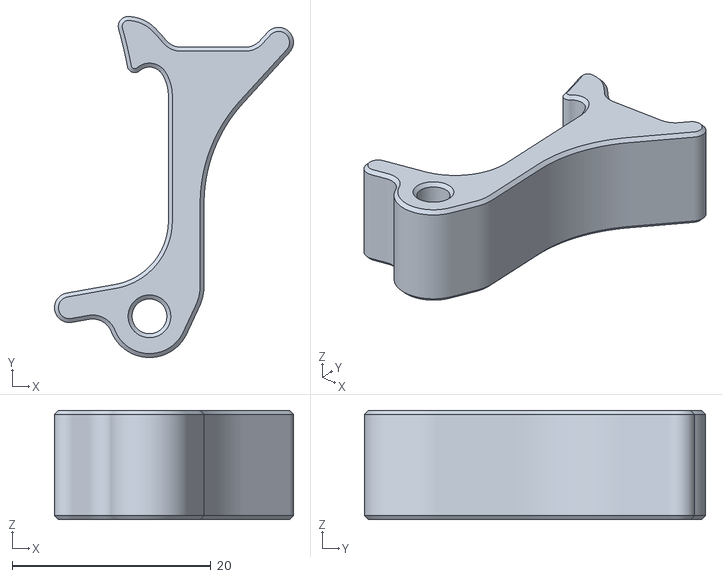
[picture p108: CAD file, 2026-05-05]
voron/stl/红色/[a]_latch.stl
24.1 x 34.3 x 11.0
