zhcntiangang/seahorse.github.io/voron/stl/黑色/probe_retainer_bracket_9mm.stl

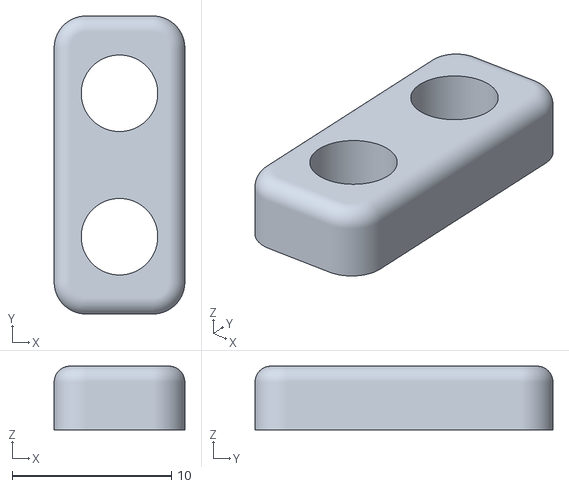
[picture p109: CAD file, 2026-05-05]
voron/stl/黑色/probe_retainer_bracket_9mm.stl
8.20 x 18.7 x 4.00
