zhcntiangang/seahorse.github.io/voron/stl/黑色/hotend_fan_mount.stl

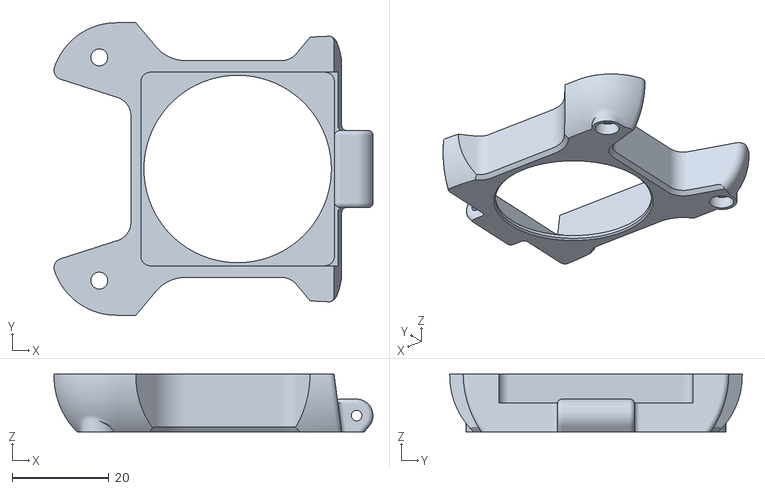
[picture p110: CAD file, 2026-05-05]
voron/stl/黑色/hotend_fan_mount.stl
66.1 x 60.6 x 12.0
