zhcntiangang/seahorse.github.io/voron/stl/红色/[a]_connector_cover.stl

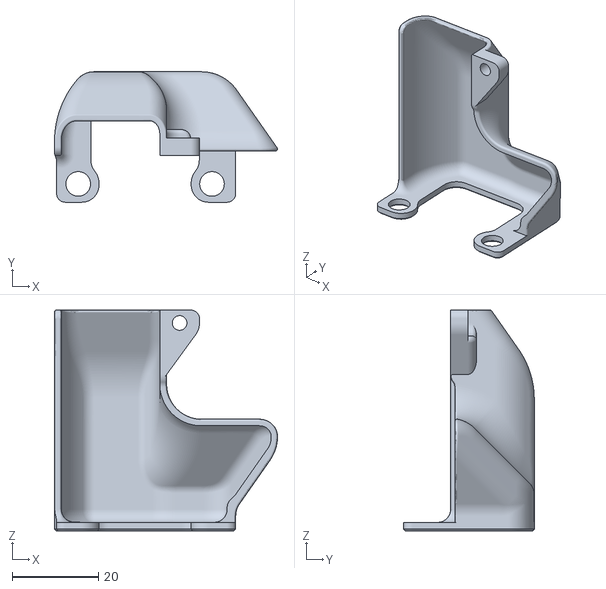
[picture p111: CAD file, 2026-05-05]
voron/stl/红色/[a]_connector_cover.stl
51.7 x 30.3 x 51.2
