zhcntiangang/seahorse.github.io/voron/stl/黑色/pcb_din_clip_x3.stl

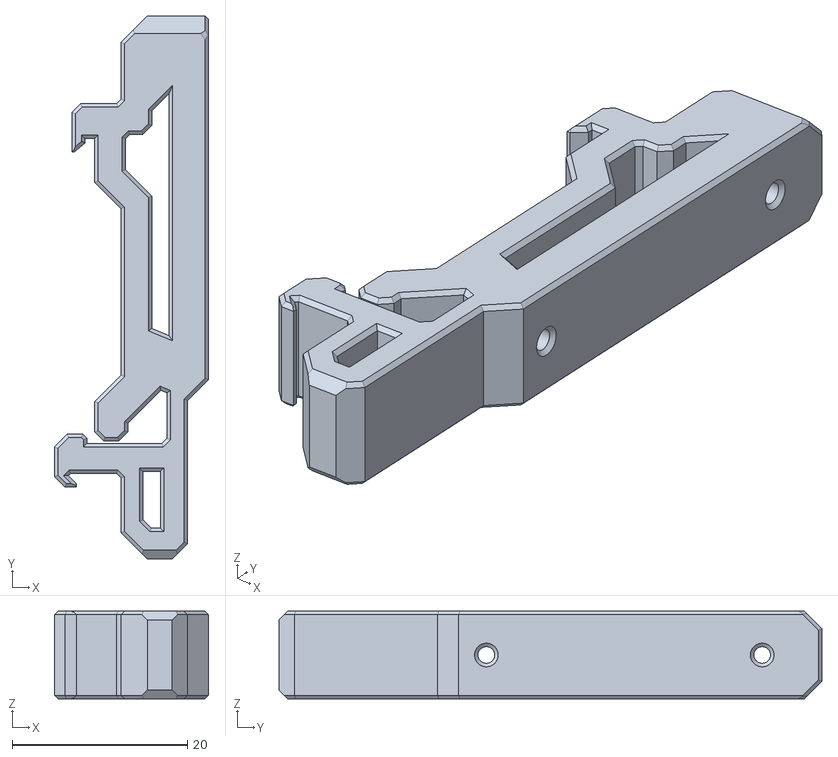
[picture p112: CAD file, 2026-05-05]
voron/stl/黑色/pcb_din_clip_x3.stl
17.6 x 62.0 x 10.0
