zhcntiangang/seahorse.github.io/voron/stl/黑色/blower_housing_rear.stl

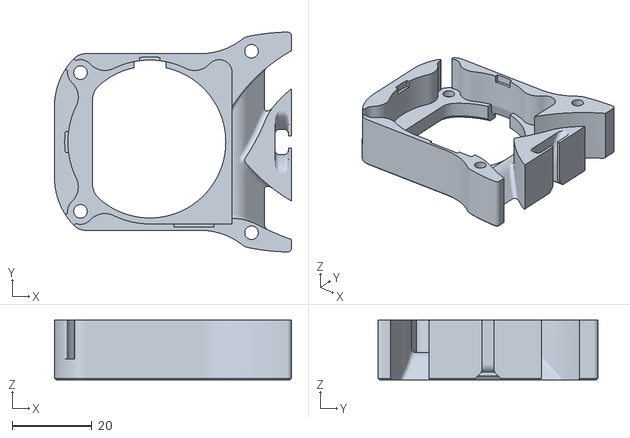
[picture p113: CAD file, 2026-05-05]
voron/stl/黑色/blower_housing_rear.stl
59.3 x 55.0 x 15.0
