zhcntiangang/seahorse.github.io/voron/stl/黑色/raspberrypi_bracket.stl

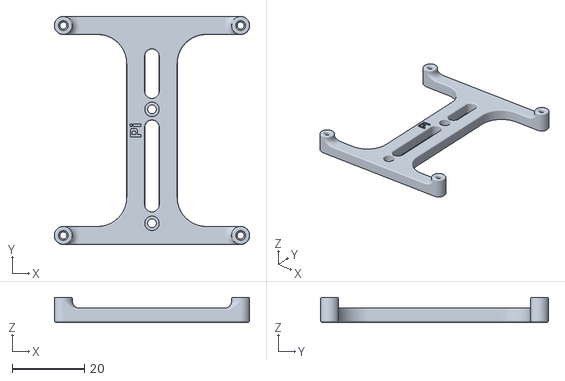
[picture p114: CAD file, 2026-05-05]
voron/stl/黑色/raspberrypi_bracket.stl
54.0 x 63.0 x 7.00
