zhcntiangang/seahorse.github.io/voron/stl/黑色/printhead_rear_e3dv6.stl

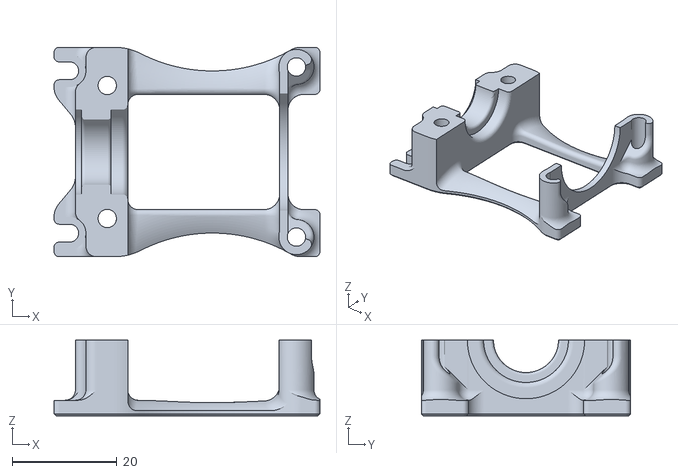
[picture p115: CAD file, 2026-05-05]
voron/stl/黑色/printhead_rear_e3dv6.stl
50.8 x 40.0 x 14.5
