zhcntiangang/seahorse.github.io/voron/stl/黑色/front_idler_right_upper.stl

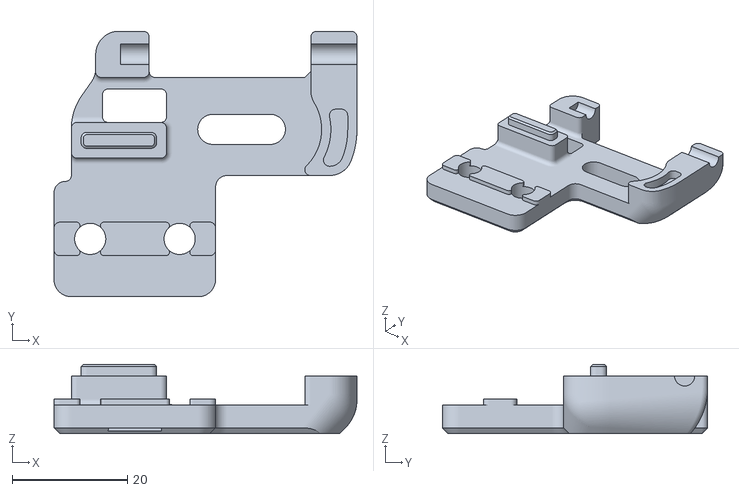
[picture p116: CAD file, 2026-05-05]
voron/stl/黑色/front_idler_right_upper.stl
52.5 x 46.0 x 12.0
