zhcntiangang/seahorse.github.io/voron/stl/红色/[a]_endstop_pod_D2F_switch.stl

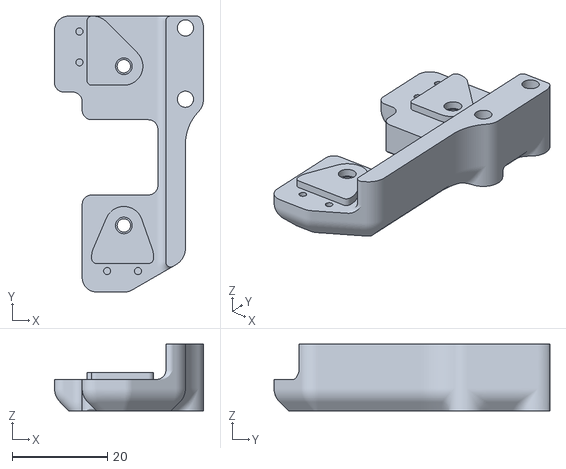
[picture p117: CAD file, 2026-05-05]
voron/stl/红色/[a]_endstop_pod_D2F_switch.stl
31.4 x 58.0 x 14.0
