zhcntiangang/seahorse.github.io/voron/stl/黑色/xy_joint_left_upper_MGN12.stl

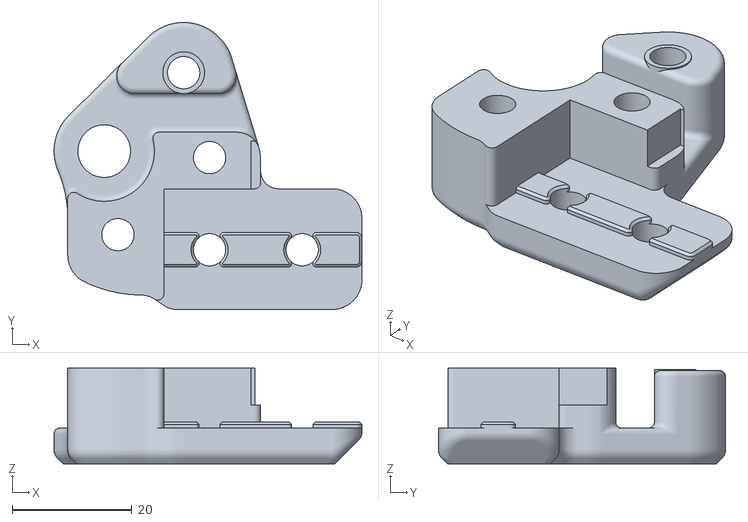
[picture p118: CAD file, 2026-05-05]
voron/stl/黑色/xy_joint_left_upper_MGN12.stl
51.5 x 48.0 x 16.0
