zhcntiangang/seahorse.github.io/voron/stl/黑色/a_drive_frame_lower.stl

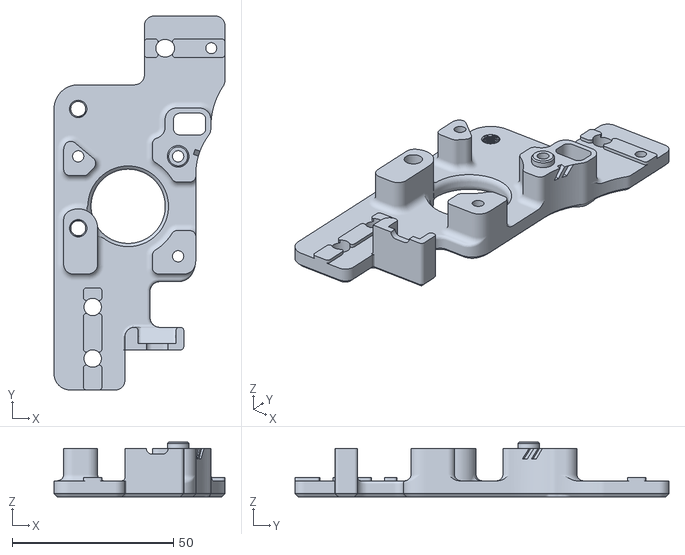
[picture p119: CAD file, 2026-05-05]
voron/stl/黑色/a_drive_frame_lower.stl
53.0 x 116.0 x 17.0
