zhcntiangang/seahorse.github.io/voron/stl/黑色/chain_anchor_3hole.stl

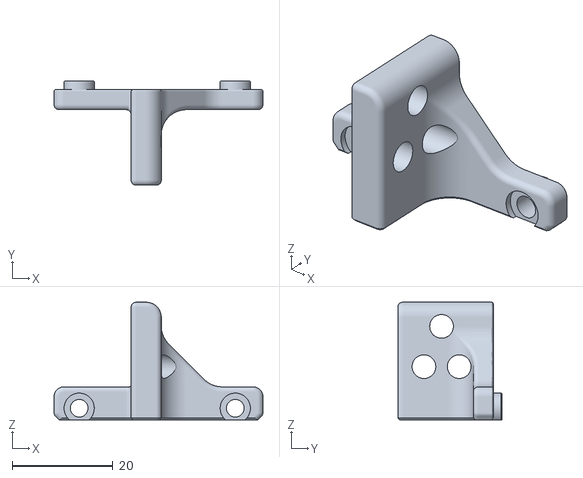
[picture p120: CAD file, 2026-05-05]
voron/stl/黑色/chain_anchor_3hole.stl
41.5 x 20.7 x 23.4
