zhcntiangang/seahorse.github.io/voron/stl/黑色/front_idler_right_lower.stl

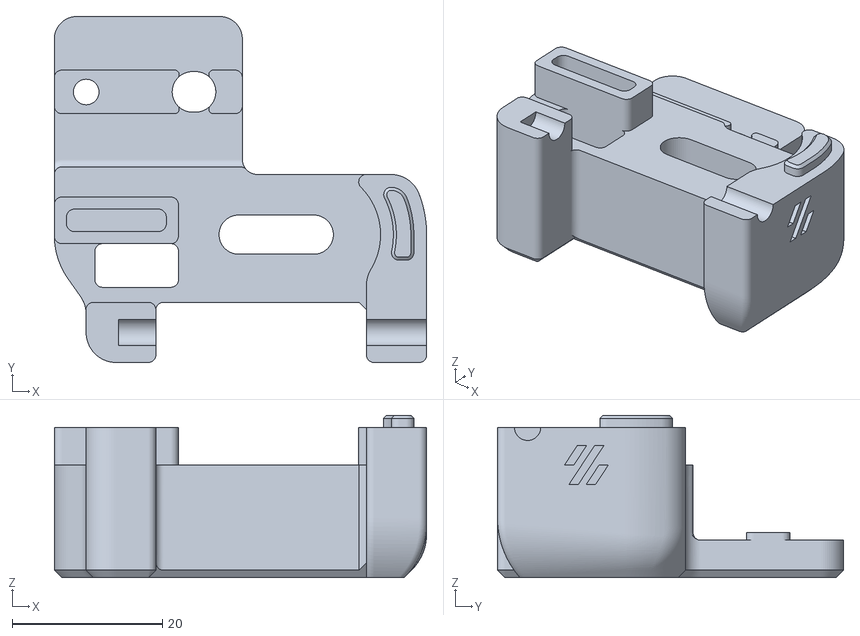
[picture p123: CAD file, 2026-05-05]
voron/stl/黑色/front_idler_right_lower.stl
49.5 x 46.0 x 21.6
