zhcntiangang/seahorse.github.io/voron/stl/黑色/x_carriage_frame_right_MGN12.stl

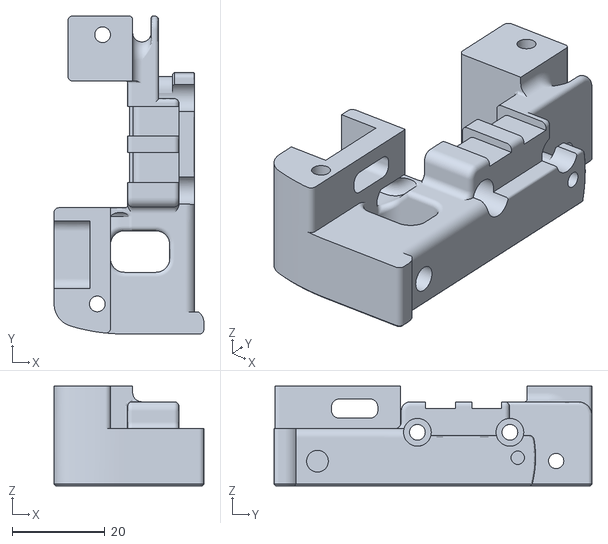
[picture p124: CAD file, 2026-05-05]
voron/stl/黑色/x_carriage_frame_right_MGN12.stl
32.4 x 68.8 x 21.6
