zhcntiangang/seahorse.github.io/voron/stl/黑色/lrs_200_psu_bracket_x2 -1.stl

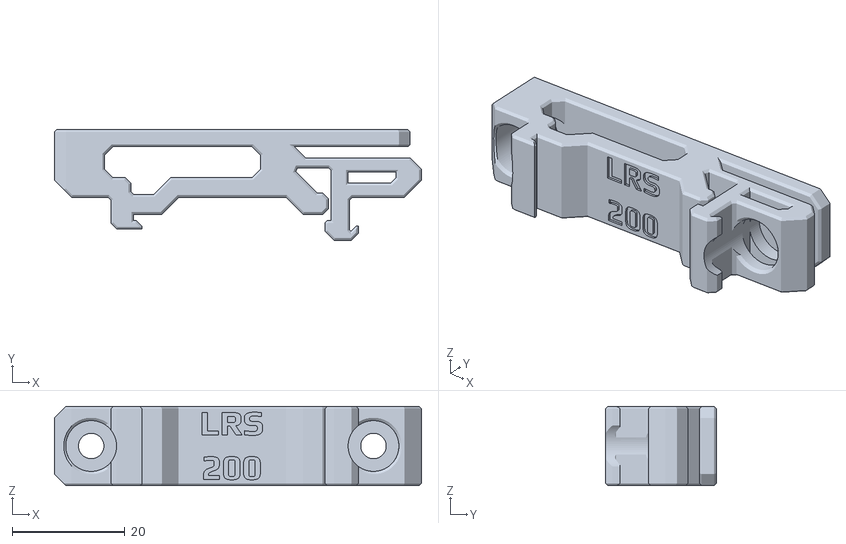
[picture p125: CAD file, 2026-05-05]
voron/stl/黑色/lrs_200_psu_bracket_x2 -1.stl
65.0 x 19.6 x 14.0
