zhcntiangang/seahorse.github.io/voron/stl/黑色/front_idler_left_lower.stl

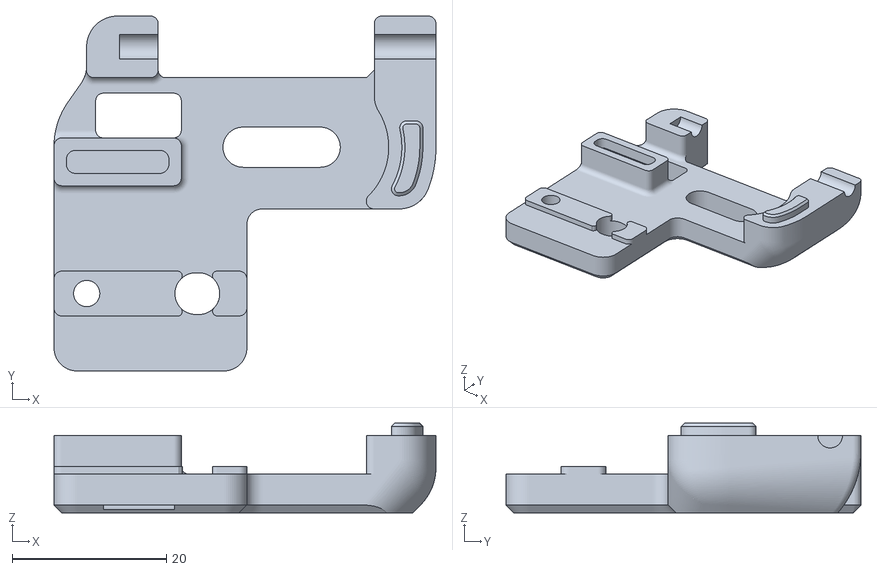
[picture p126: CAD file, 2026-05-05]
voron/stl/黑色/front_idler_left_lower.stl
49.5 x 46.0 x 11.6
