zhcntiangang/seahorse.github.io/voron/stl/黑色/wago_221-415_mount_3x5.stl

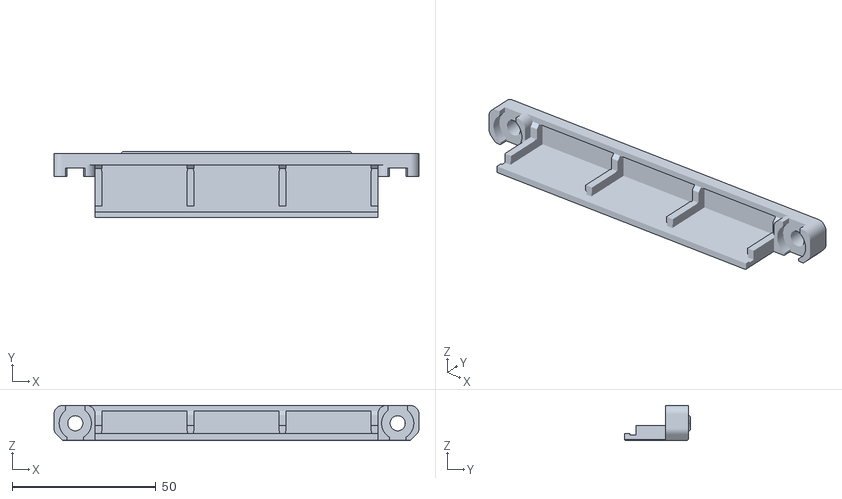
[picture p127: CAD file, 2026-05-05]
voron/stl/黑色/wago_221-415_mount_3x5.stl
126.8 x 23.0 x 12.2
