zhcntiangang/seahorse.github.io/voron/stl/黑色/z_chain_bottom_anchor.stl

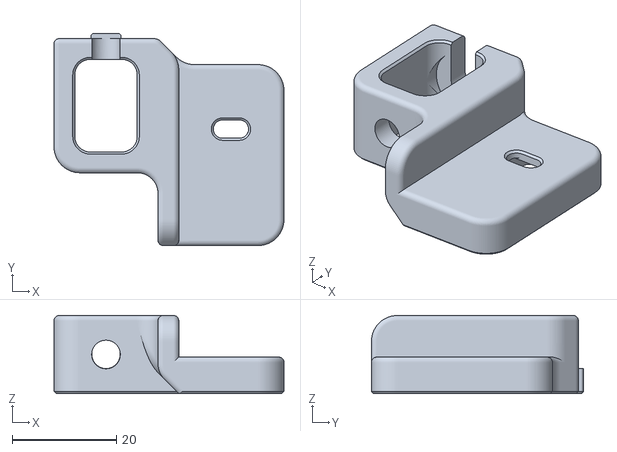
[picture p128: CAD file, 2026-05-05]
voron/stl/黑色/z_chain_bottom_anchor.stl
44.2 x 40.8 x 15.0
