zhcntiangang/seahorse.github.io/voron/stl/黑色/xy_joint_right_lower_MGN12.stl

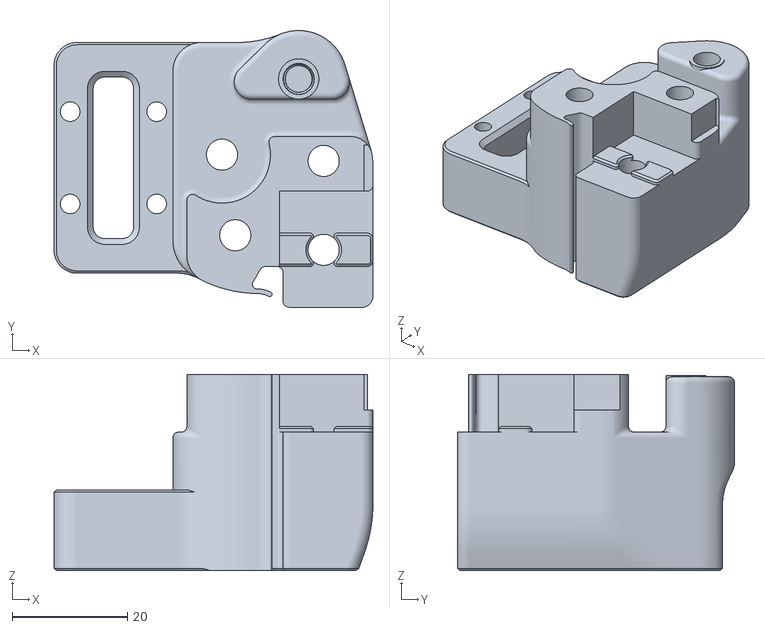
[picture p129: CAD file, 2026-05-05]
voron/stl/黑色/xy_joint_right_lower_MGN12.stl
55.3 x 48.0 x 34.0
