zhcntiangang/seahorse.github.io/voron/stl/黑色/PSU_stabilizer_50mm.stl

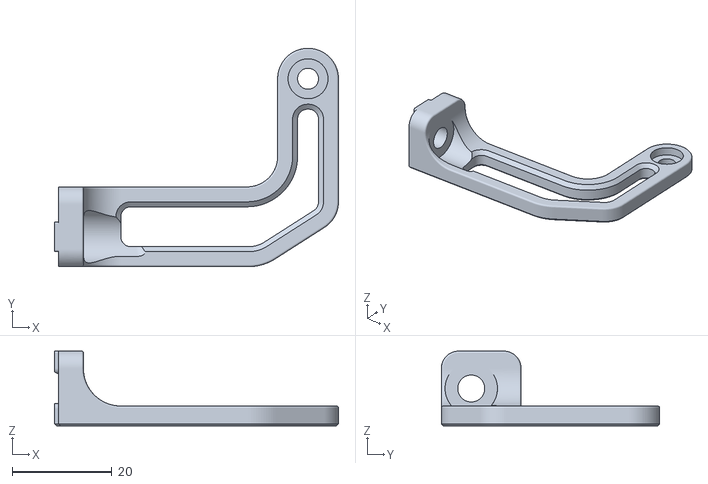
[picture p130: CAD file, 2026-05-05]
voron/stl/黑色/PSU_stabilizer_50mm.stl
56.9 x 43.8 x 15.0
