zhcntiangang/seahorse.github.io/voron/stl/黑色/Spider_bracket_set.stl

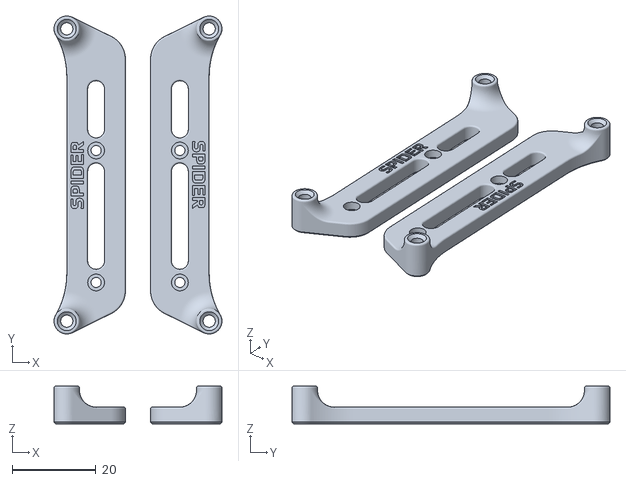
[picture p131: CAD file, 2026-05-05]
voron/stl/黑色/Spider_bracket_set.stl
40.1 x 75.9 x 9.00
