zhcntiangang/seahorse.github.io/voron/stl/黑色/spool_holder.stl

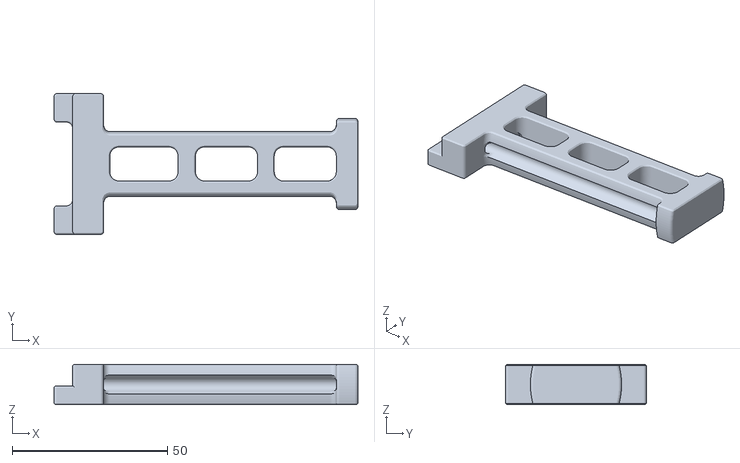
[picture p132: CAD file, 2026-05-05]
voron/stl/黑色/spool_holder.stl
98.0 x 45.4 x 13.0
