zhcntiangang/seahorse.github.io/(list of files, cad)

Other CAD files:
voron/stl/黑色/z_drive_main_a_x2.stl
voron/stl/黑色/z_drive_main_a_x2 - 1.stl
voron/stl/红色/[a]_belt_tensioner_a_x2.stl
stl/calibration/hole-calibration.stl
stl/upgrade/Magnetic_Panels_with_Magnet_Inserts/Mid-Panel-Clip-7mm.stl
stl/upgrade/Magnetic_Panels_with_Magnet_Inserts/Magnetic_Panels_with_Magnet_Inserts_v2.step
stl/upgrade/Magnetic_Panels_with_Magnet_Inserts/Midspan-Clip-6mm-Lip.stl
voron/stl/红色/[a]_belt_tensioner_a_x2 - 1.stl
stl/upgrade/Magnetic_Panels_with_Magnet_Inserts/Midspan-Clip-4mm.stl
voron/stl/红色/[a]_xy_joint_cable_bridge_3hole.stl
voron/stl/红色/[a]_z_drive_baseplate_b_x2.stl
voron/stl/红色/[a]_tensioner_right.stl
voron/stl/红色/[a]_z_drive_baseplate_b_x2 - 1.stl
voron/stl/黑色/z_tensioner_bracket_b_x2 - 1.stl
voron/stl/黑色/a_drive_frame_upper.stl
voron/stl/黑色/probe_retainer_bracket.stl
voron/stl/黑色/z_drive_retainer_a_x2.stl
voron/stl/黑色/z_motor_mount_a_x2 - 1.stl
voron/stl/黑色/printhead_front_e3dv6.stl
voron/stl/黑色/z_tensioner_bracket_b_x2.stl
voron/stl/黑色/z_drive_retainer_a_x2 - 1.stl
voron/stl/黑色/z_motor_mount_a_x2.stl
stl/upgrade/Magnetic_Panels_with_Magnet_Inserts/Magnet-Insert-v1.stl
stl/upgrade/Magnetic_Panels_with_Magnet_Inserts/Magnetic_Panels_with_Magnet_Inserts_v1.step
stl/upgrade/Magnetic_Panels_with_Magnet_Inserts/加宽部件.f3d
stl/upgrade/Magnetic_Panels_with_Magnet_Inserts/模块.f3d
