zhcntiangang/seahorse.github.io/voron/VORON2.4全中文组装手册.pdf

# VORON

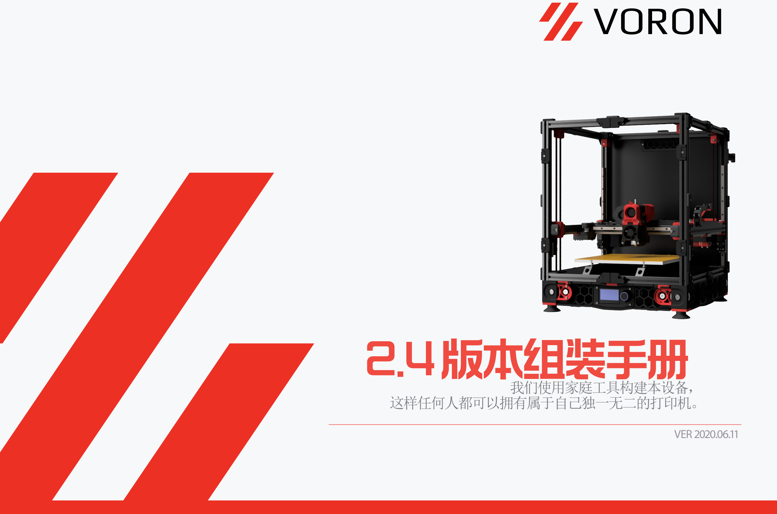
[picture p136: page 1]

1

## VER 2020.06.11

# 2.4版本组装手册

## 我们使用家庭工具构建本设备， 这样任何人都可以拥有属于自己独一无二的打印机。

2

VORON 2.4 | WWW.VORONDESIGN.COM

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
## 总装目录

介绍 | 液晶模组
框架组装 | 裙边
Z轴驱动器 | 面板
结构板 | 耗材支架
AB轴驱动模块 | 排气过滤器
龙门 | 电子安装
加力燃烧室 | 布线

## Z轴传动皮带

3

介绍 | 安全警告 | WWW.VORONDESIGN.COM

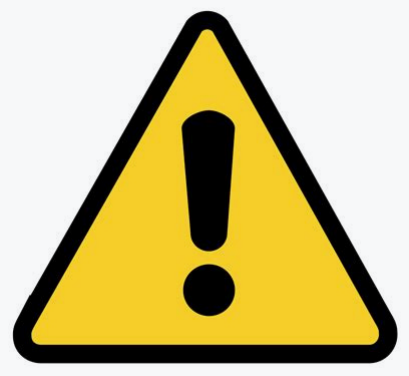
[picture p137: figure]

## 在开始本工程之前，请注意：

## 您即将在家中组装一台极其复杂的机器设备。如果你不小心，这个过程中 会导致你重伤、烧伤及触电。请不要成为第一个挂掉的极客。如果你在这 方面没有什么特别的天赋。在开始装配之前，请通篇阅读整个手册。当你 遇到无法解决的难题时，请查阅我们的有关频道(#voron_v2_build_help)， 以便获得任何提示和问题的解答，这会加快你自我研究难题时的进程。最 重要的是，VORON团队祝你好运!

4

## WWW.VORONDESIGN.COM

示例z_joint_lower_x4.stl

介绍 | STL文件的关键

此时，您应该已经从VoronGitHub下载了我们的STL文件。您可能已经注意到，我们对文件使 用了唯一的命名约定。以下是如何打印它们。

原色 | 强调颜色 | 所需数量

## STL选项

在为Voron打印的STL上，您可以选择一些选项。

新款框架或旧版 | 开始新版或结合上一旧版本 | 电缆链或坦克拖链
VORON2.4 \电子隔层 | VORON2.4 \龙门\ X轴\ X托架 | VORON2.4 \拖链
| 对于大多数情况，按此新版是标准设
| 置新版本。 | 我们建议使用电缆链。您可以查看采 购指南中的选项。

新版框架用于当前打印机规格。 如果您已
经购买老版本型材，请更换为2.2版本打印
零件.

如果不使用旧式支架，则可将电子设备
安装到新版框架导轨上。 | 旧版本允许使用外部挤出机。 如有
| 疑问，请打印2.2版本直接稿件。

如果您喜欢打印电路拖链，可以文件
夹中找到它自行打印.
范例[a]_tensioner_left.stl | 范例[a]_z_belt_clip_lower_x4.stl 如 果任 何文件以“ x＃”结尾，则表 示您需要打印的此零件的数量。
这些文件并无特别说明
完全可以根据自行理解
来进行安装

这些文件一般都是带有标准说明的文件

5

## WWW.VORONDESIGN.COM

VORON打印机是具有打印高温材料性能的机
器，可以用惊人的打印速度运行。因此，我
们建议仅使用ABS来构建打印机.

固态顶/底层
推荐：5层
介绍 | 打印指南

Voron团队已为您提供以下打印指导，以使您获得最佳成功几率。关于替换材料或更改打印标准经常会有疑问，但是我们建议您尽可能遵 循这些建议。

FDM打印耗材 | 填充类型 网格，陀螺，蜂窝，三角形或立方

层高

壁厚
推荐：4层

### 推荐：0.2mm

挤出宽度
推荐：强制0.4mm

填充率
推荐：40％

## 向前打印

通常，我们的社区成员在打印ABS时会遇到问题，他们会使用我们的PrintIt Forward程序将自己引导到VORON中。这是一项服务，VORON 打印机的社区会员可以为您提供一组功能部件，以启动和运行自己的机器。如果您希望有人帮助您，请登录Discord社区。

## WWW.VORONDESIGN.COM

介绍 | 如何获得帮助

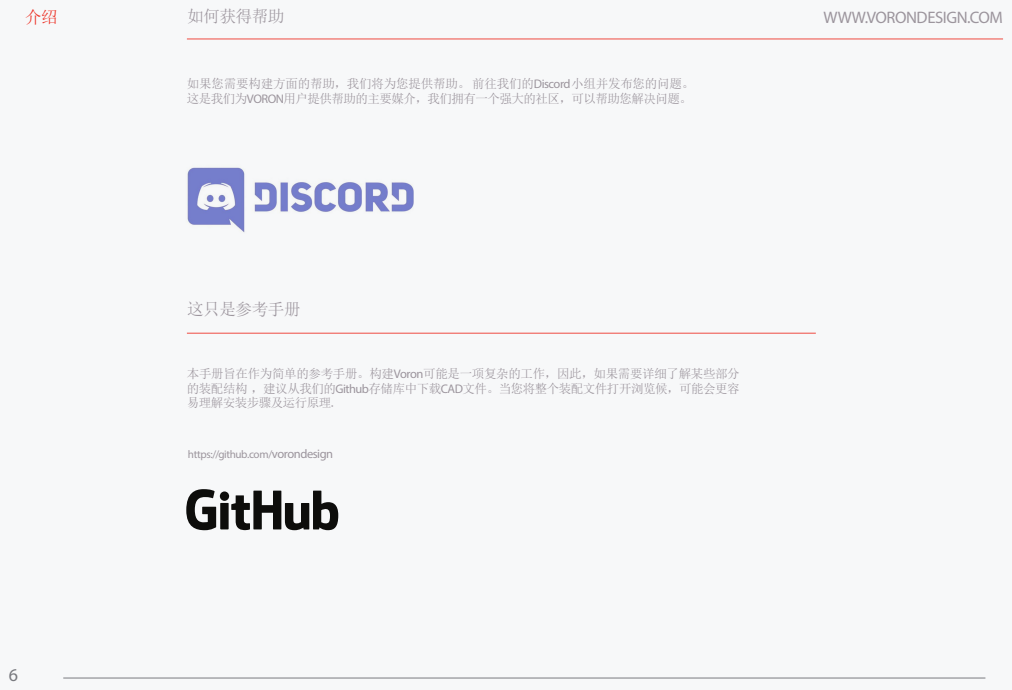
[picture p138: page 6]
这只是参考手册

如果您需要构建方面的帮助，我们将为您提供帮助。前往我们的Discord小组并发布您的问题。
这是我们为VORON用户提供帮助的主要媒介，我们拥有一个强大的社区，可以帮助您解决问题。

本手册旨在作为简单的参考手册。构建Voron可能是一项复杂的工作，因此，如果需要详细了解某些部分
的装配结构 ，建议从我们的Github存储库中下载CAD文件。当您将整个装配文件打开浏览候，可能会更容
易理解安装步骤及运行原理.

https://github.com/vorondesign

7

介绍 | WWW.VORONDESIGN.COM

VORON打印机是出色的机器，在组装时非常繁琐。慢慢来！组装阶段性出现的小问题往往会积累起来，并在以后给您带来麻烦。如果您 在任何时候陷入组装困难或遇到无法理解的原理，请在Discord社区上提问。在这里的任何问题我们都会很乐意为您指正明确的方向。

## 打印零件

并非所有的打印件都能完美打印，可能需要进行一些附加工作。您可能会发现需要进行一些打磨，以 使某些零件彼此更加吻合。尽量多花些时间正确修正零件毛糙的部分。

## 涉电警告

VORON打印机需要110v/220v布线工作。了解你在做什么以避免受伤或死亡还是很重要的。高压电源是致命的，在你被电 击的整个过程中都会受到伤害。如果有疑问，我们鼓励你问问题。这真的不是你猜测就能解决的问题。

VORON团队期待看到您的实际完成整机，祝你好运!

## 注意事项

8

打印机主框架 | WWW.VORONDESIGN.COM

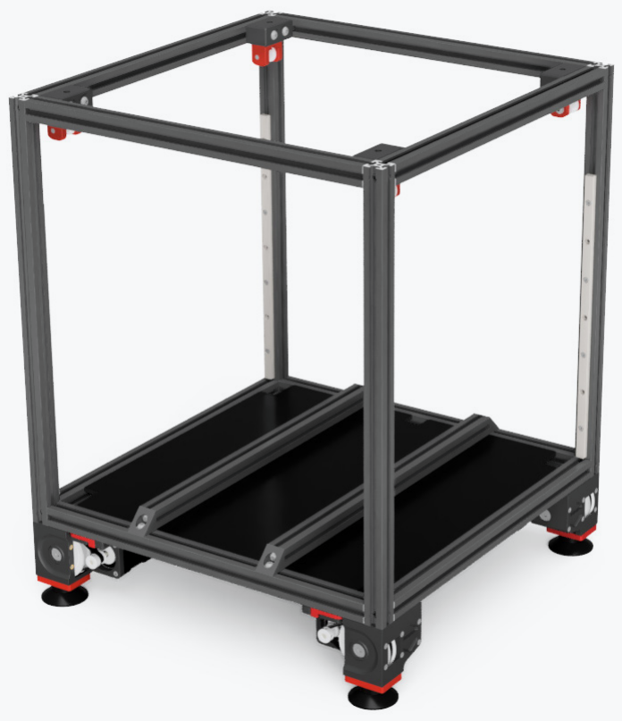
[picture p139: figure]

9

购买铝型材 | WWW.VORONDESIGN.COM

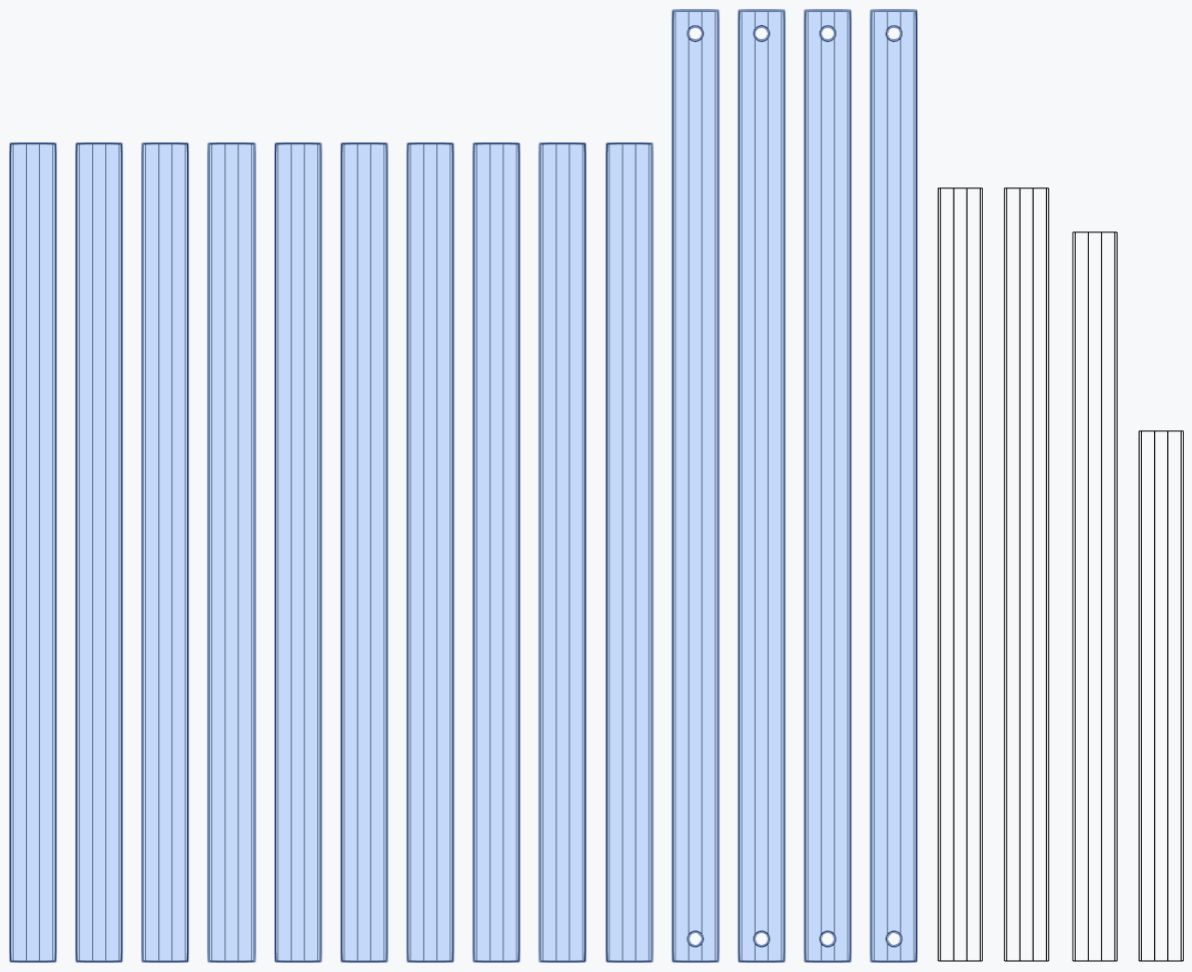
[picture p140: figure]

必须确保是同品牌同批次的型材
蓝色突出标识部分为主框架组分

## WWW.VORONDESIGN.COM

## 组装第一个角

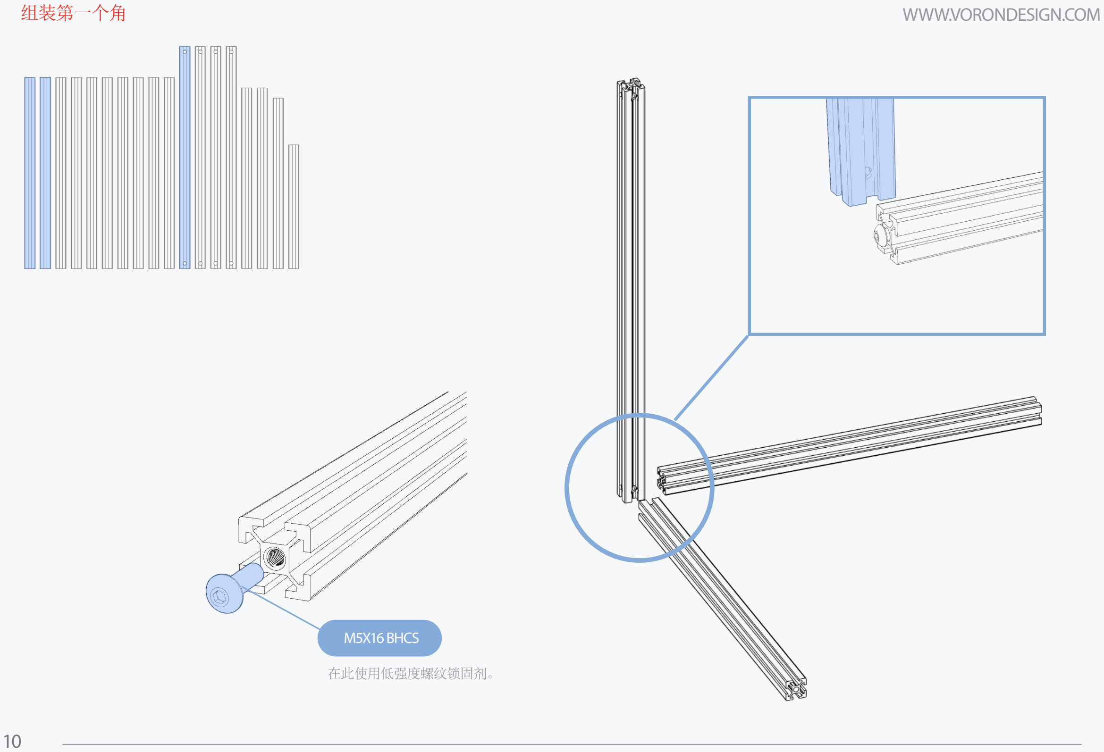
[picture p141: page 10]

10

## M5X16 BHCS

在此使用低强度螺纹锁固剂。

## WWW.VORONDESIGN.COM

## 同步骤安装其他角

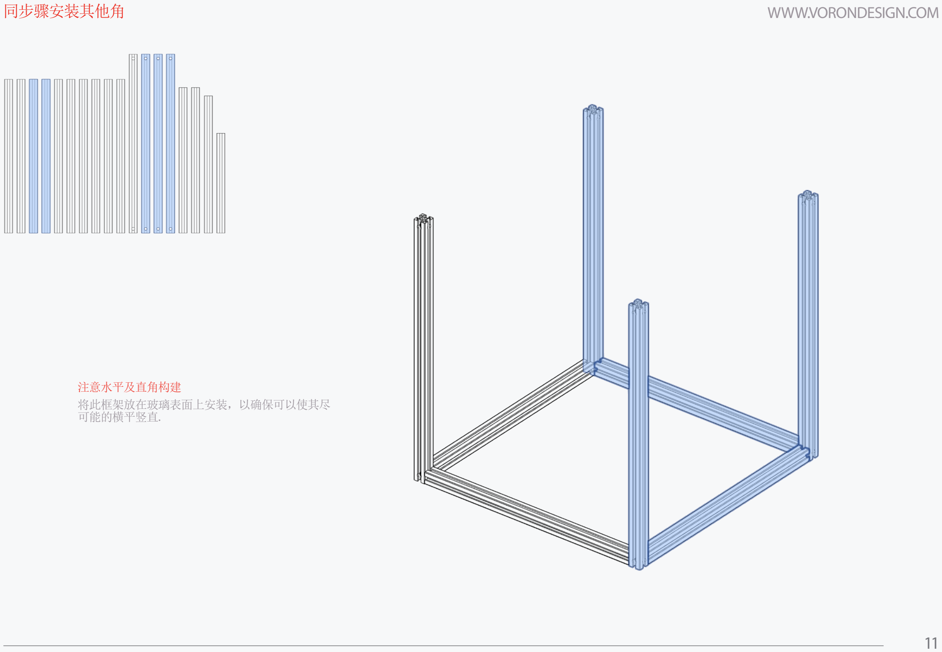
[picture p142: page 11]

11

将此框架放在玻璃表面上安装，以确保可以使其尽
可能的横平竖直.

注意水平及直角构建

## WWW.VORONDESIGN.COM

## 组装框架

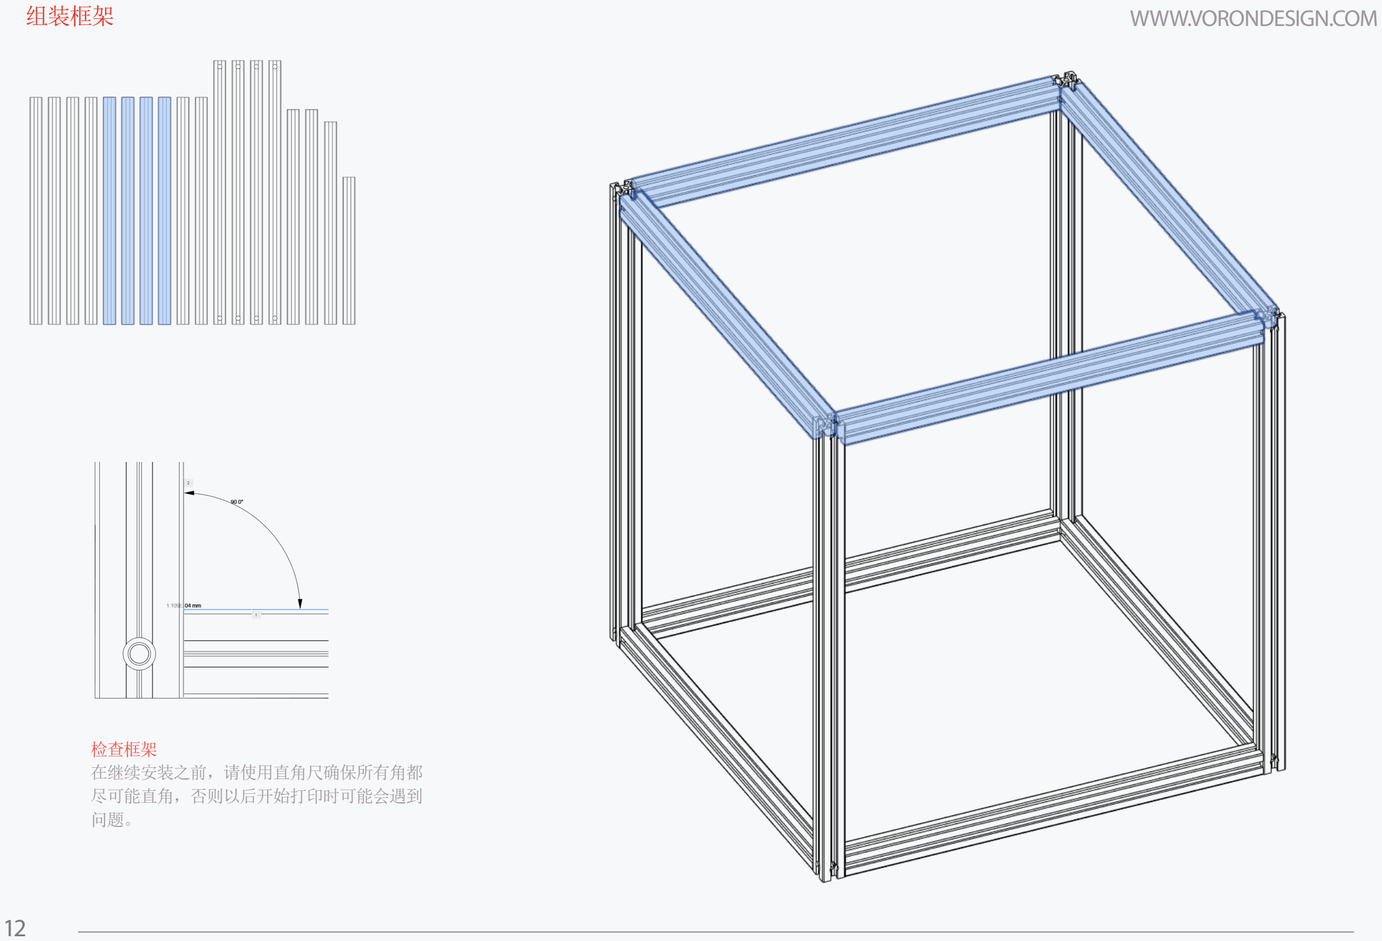
[picture p143: page 12]

12

检查框架
在继续安装之前，请使用直角尺确保所有角都
尽可能直角，否则以后开始打印时可能会遇到
问题。

## WWW.VORONDESIGN.COM

## 热床底托梁

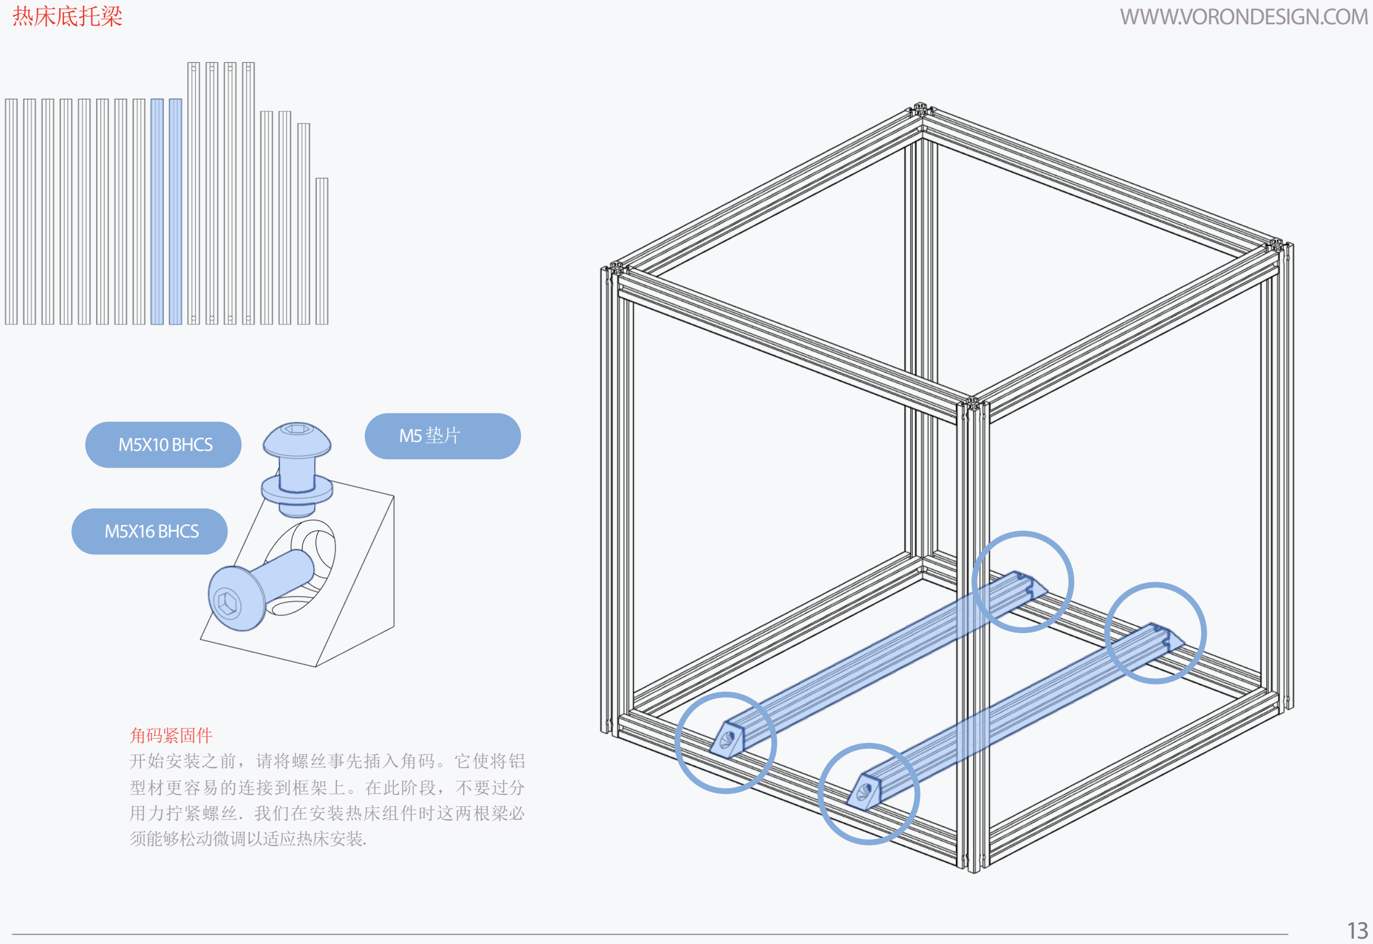
[picture p144: page 13]

13

M5X10 BHCS | M5垫片

## M5X16 BHCS

角码紧固件
开始安装之前，请将螺丝事先插入角码。它使将铝
型材更容易的连接到框架上。在此阶段，不要过分
用力拧紧螺丝. 我们在安装热床组件时这两根梁必
须能够松动微调以适应热床安装.

## WWW.VORONDESIGN.COM

## Z轴线性导轨的安装

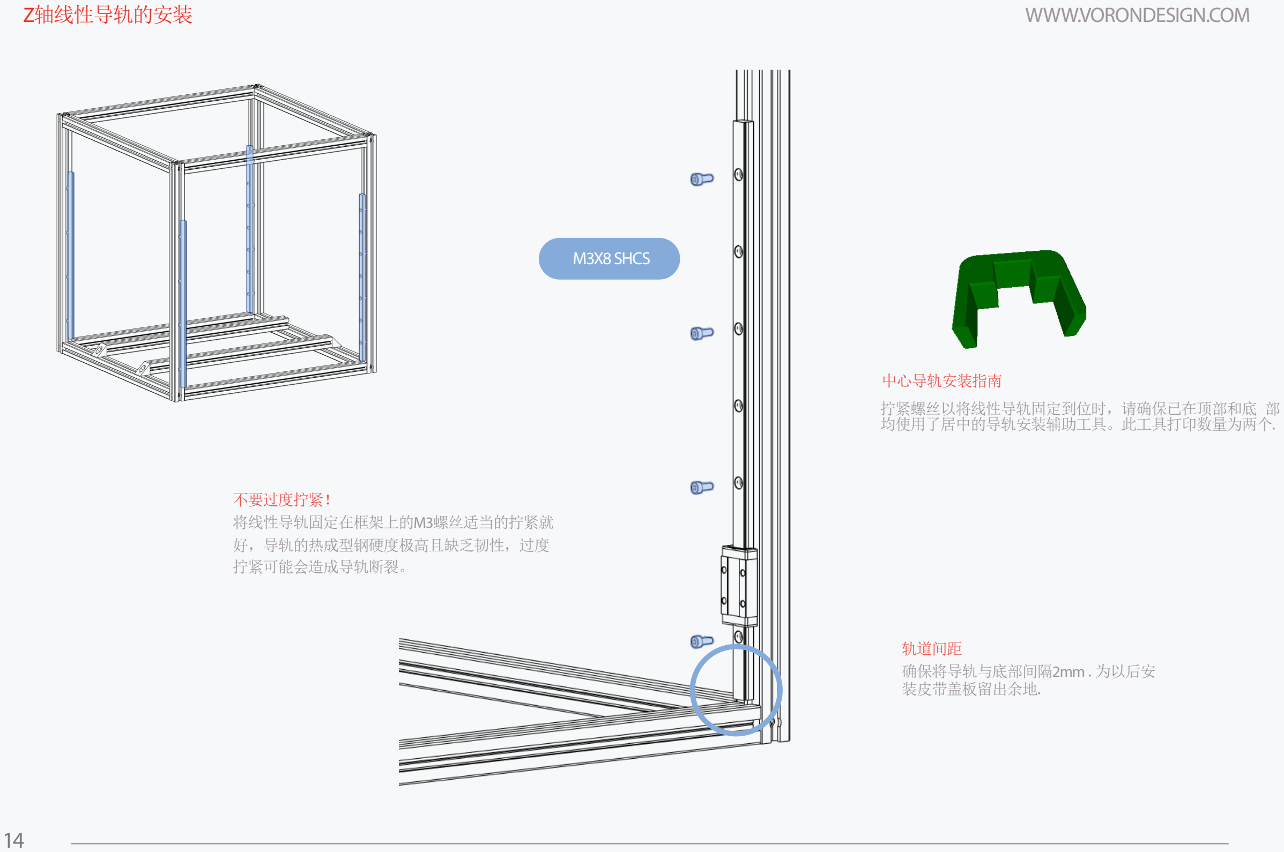
[picture p145: page 14]

14

## M3X8 SHCS

拧紧螺丝以将线性导轨固定到位时，请确保已在顶部和底 部 均使用了居中的导轨安装辅助工具。此工具打印数量为两个.

不要过度拧紧！
将线性导轨固定在框架上的M3螺丝适当的拧紧就
好，导轨的热成型钢硬度极高且缺乏韧性，过度
拧紧可能会造成导轨断裂。

中心导轨安装指南

轨道间距
确保将导轨与底部间隔2mm .为以后安
装皮带盖板留出余地.

15

## WWW.VORONDESIGN.COM

休息.休息几天.给自己缓冲一下

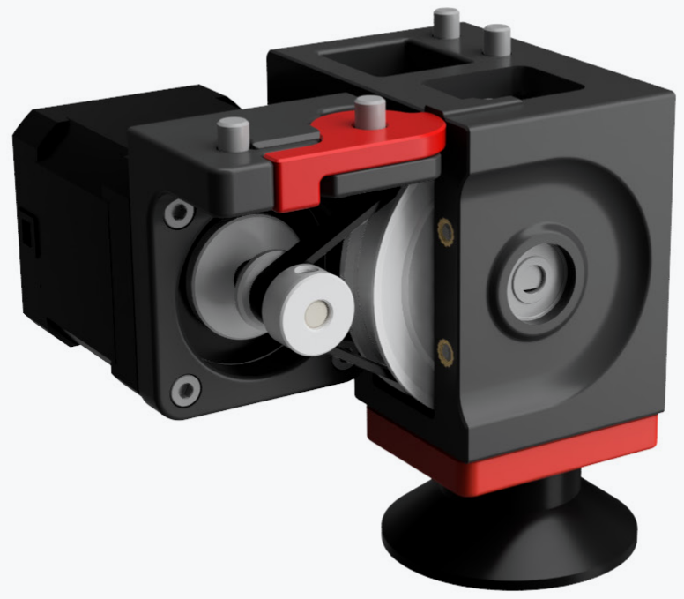
[picture p146: figure]

16

Z传动总成 | WWW.VORONDESIGN.COM

## WWW.VORONDESIGN.COM

## Z轴驱动皮带轮组和步进电机的组装

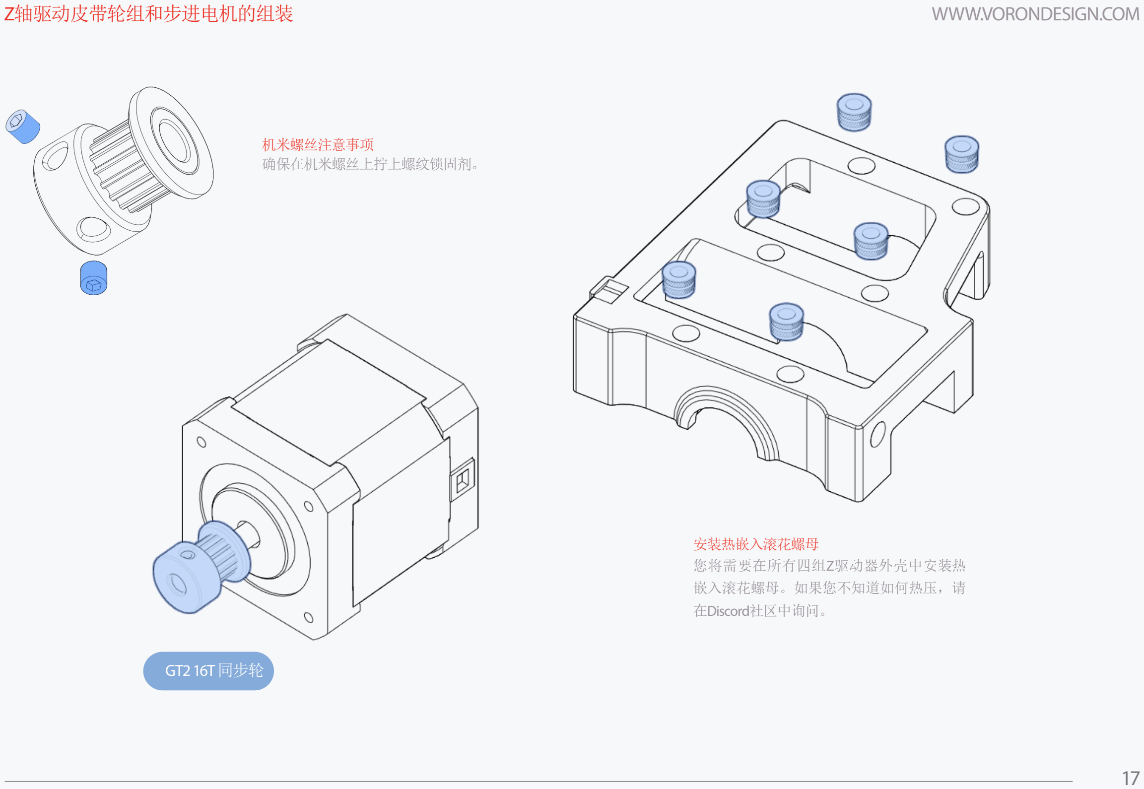
[picture p147: page 17]

17

## GT216T同步轮

确保在机米螺丝上拧上螺纹锁固剂。

机米螺丝注意事项

安装热嵌入滚花螺母
您将需要在所有四组Z驱动器外壳中安装热
嵌入滚花螺母。如果您不知道如何热压，请
在Discord社区中询问。

18

## WWW.VORONDESIGN.COM

## 皮带传动系统总成

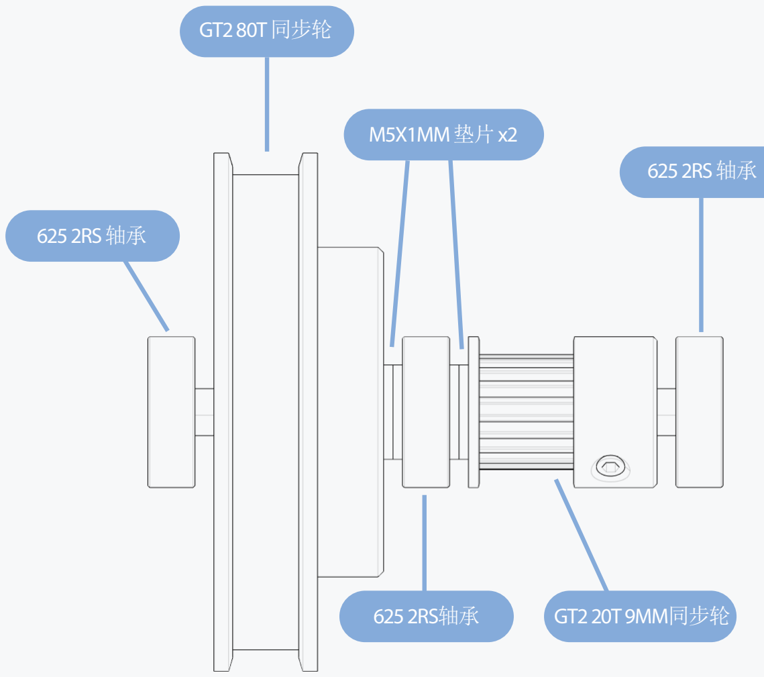
[picture p148: figure]
625 2RS轴承; GT280T同步轮; M5X1MM垫片x2; GT2 20T 9MM同步轮

应使用螺纹紧固剂
确保不仅在9mm皮带轮机米螺丝上而且
还要在80T皮带轮上使用螺纹锁固剂！

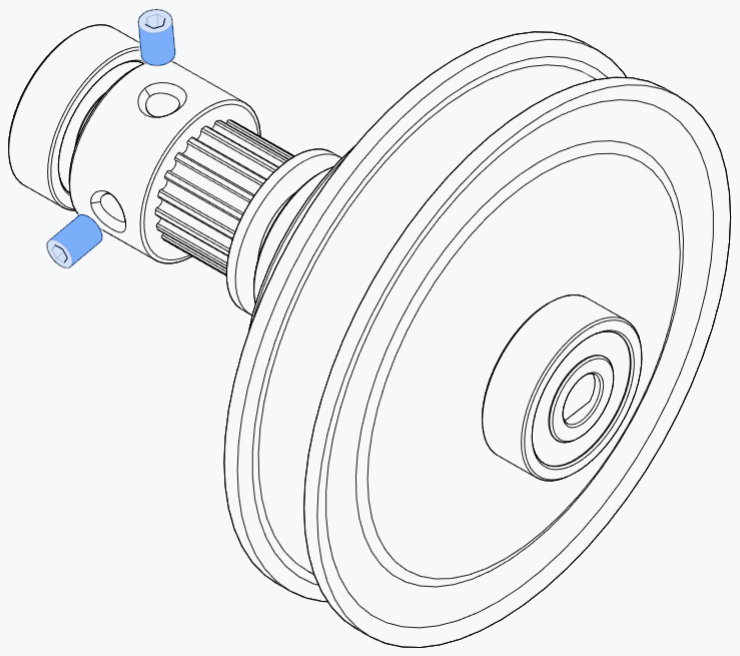
[picture p149: figure]

## WWW.VORONDESIGN.COM

## 皮带传动模块

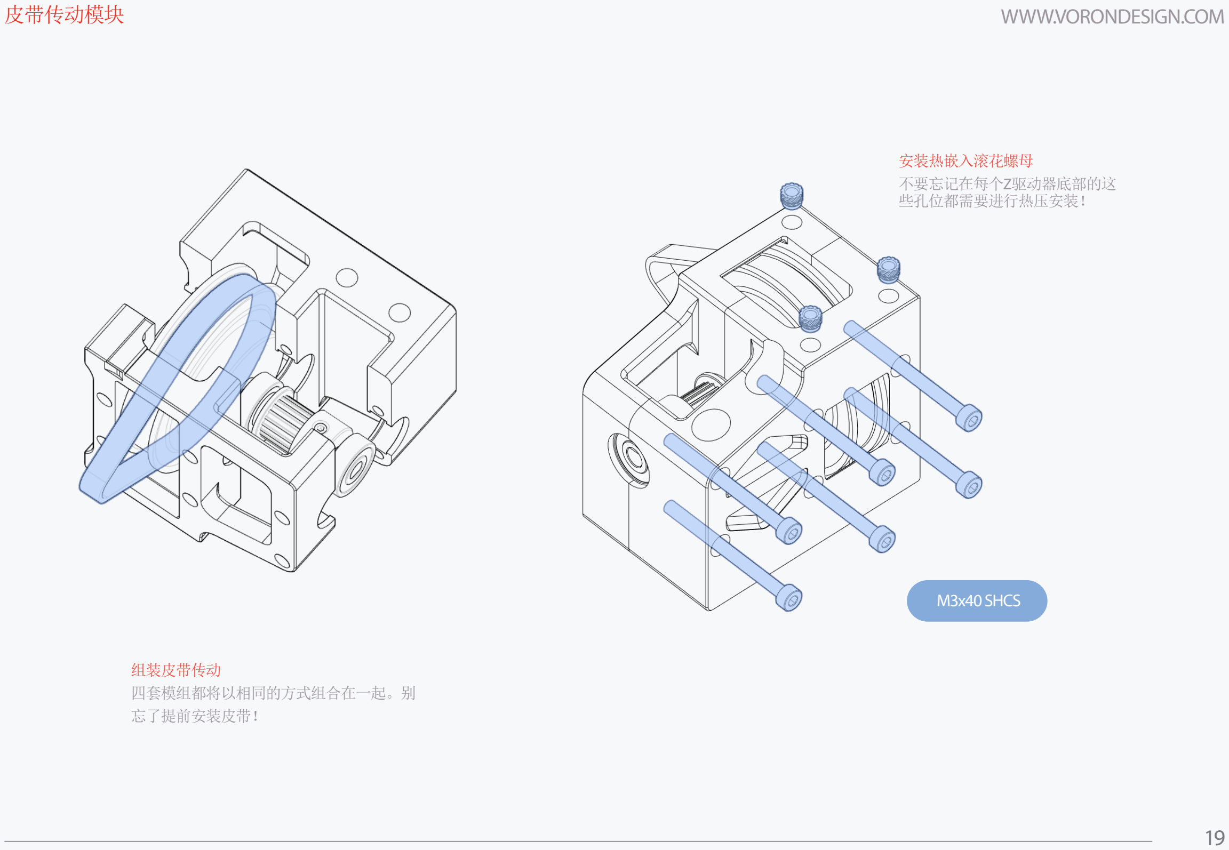
[picture p150: page 19]

19

## M3x40 SHCS

组装皮带传动
四套模组都将以相同的方式组合在一起。别
忘了提前安装皮带！

安装热嵌入滚花螺母
不要忘记在每个Z驱动器底部的这
些孔位都需要进行热压安装！

## WWW.VORONDESIGN.COM

## 机脚的安装

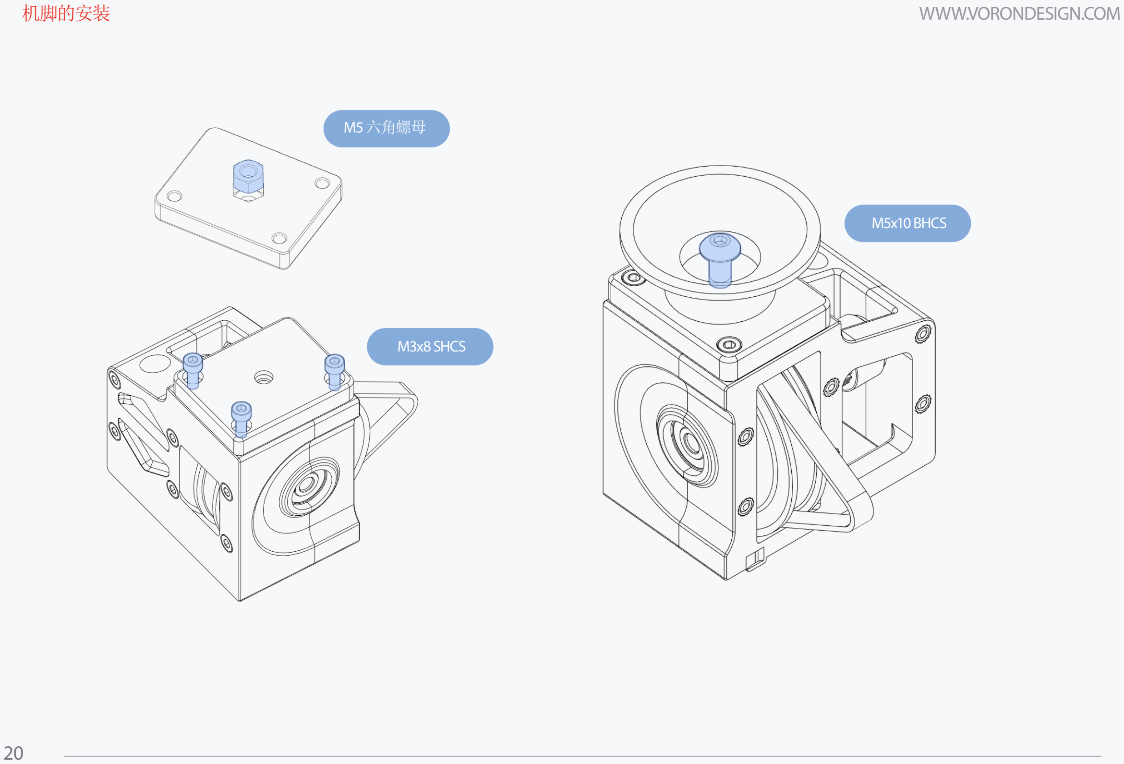
[picture p151: page 20]

20

## M3x8 SHCS

## M5x10 BHCS

M5六角螺母

21

## WWW.VORONDESIGN.COM

## Z轴步进电机支架

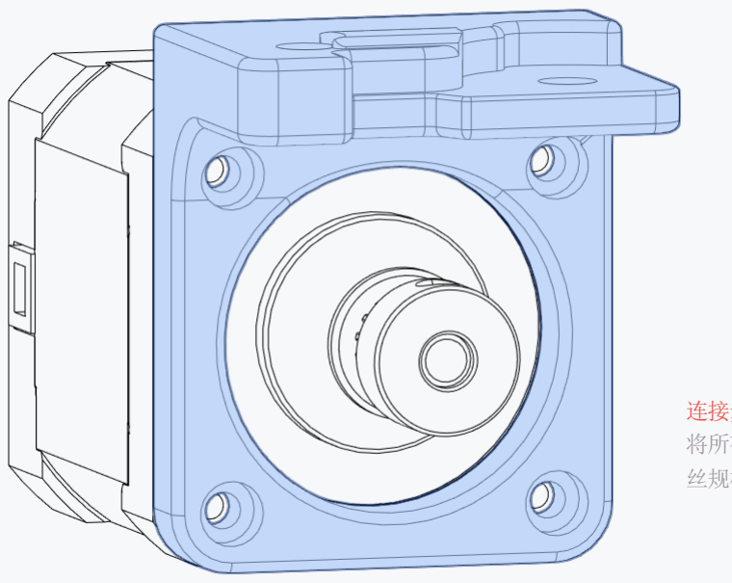
[picture p152: figure]

连接步进电机支架

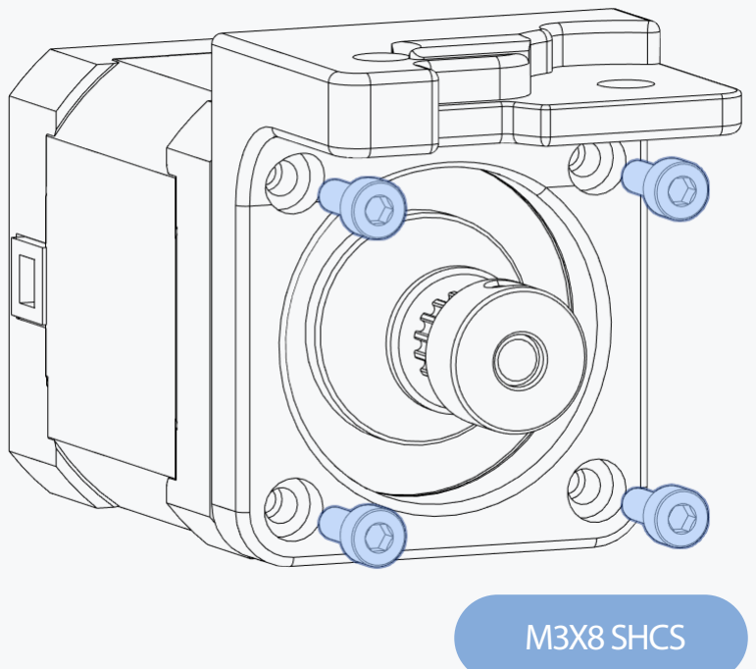
[picture p153: figure]
M3X8 SHCS

将所有4个电机支架安装到Z轴驱动器的步进电机上。使用螺 丝规格为M3x8 SHCS圆柱头螺丝。

## WWW.VORONDESIGN.COM

## 设备甲板和Z轴驱动器

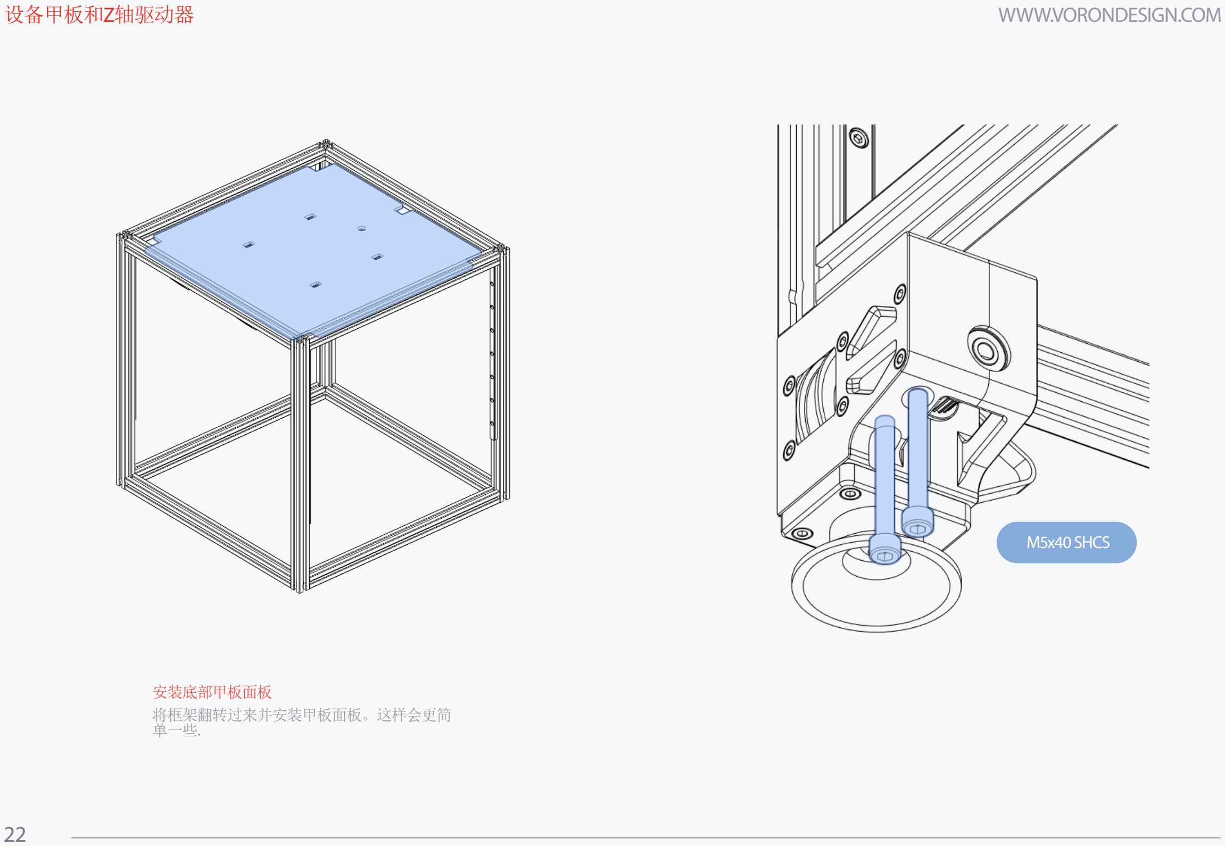
[picture p154: page 22]

22

安装底部甲板面板

## M5x40 SHCS

将框架翻转过来并安装甲板面板。这样会更简
单一些.

## WWW.VORONDESIGN.COM

## 电机安装和皮带

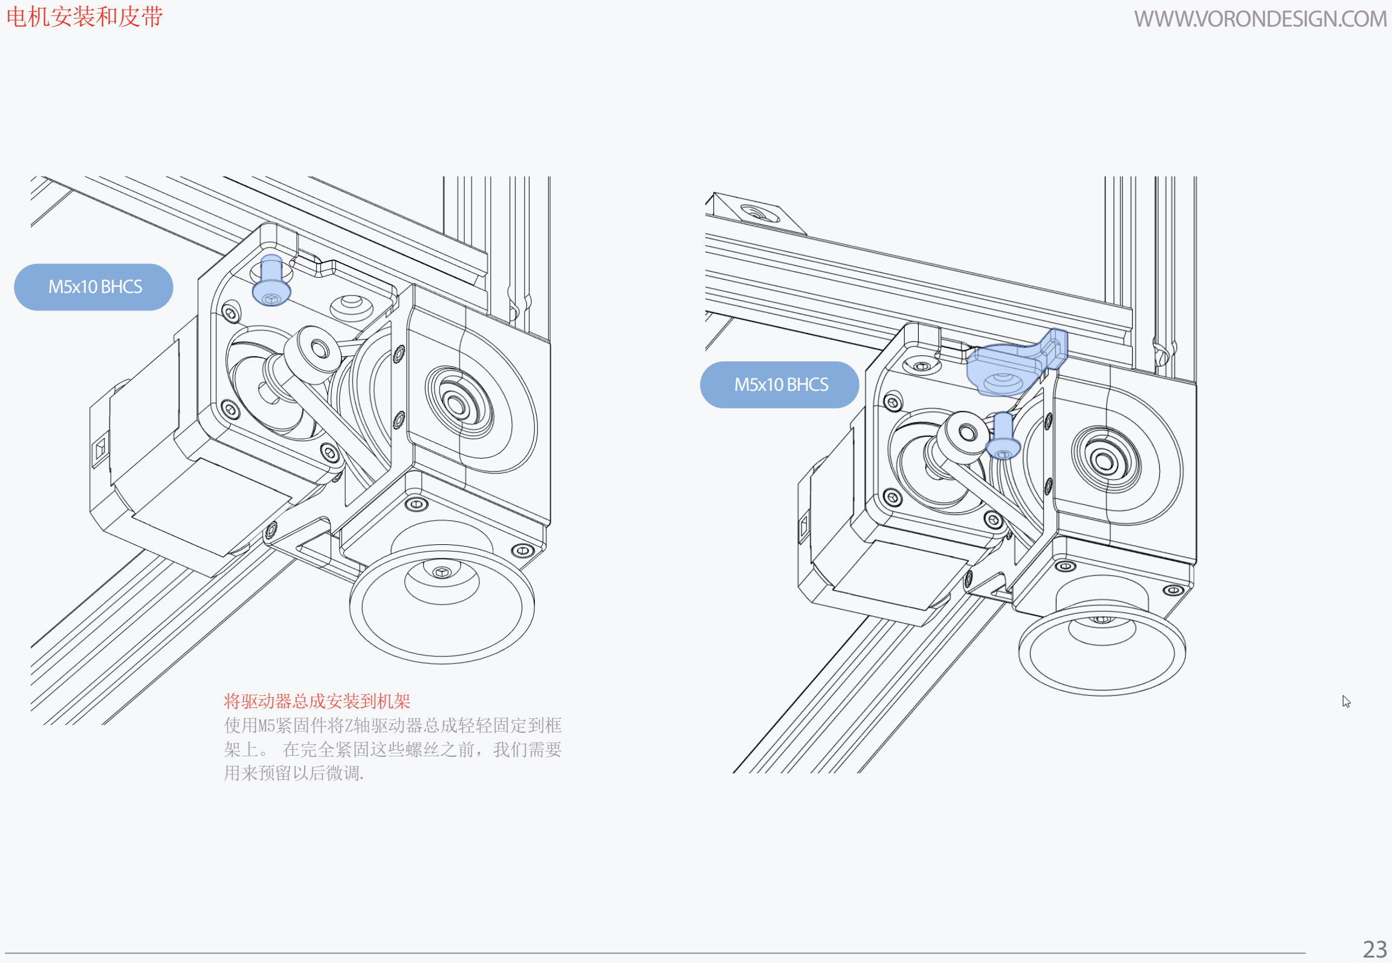
[picture p155: page 23]

23

## M5x10 BHCS

## M5x10 BHCS

将驱动器总成安装到机架
使用M5紧固件将Z轴驱动器总成轻轻固定到框
架上。 在完全紧固这些螺丝之前，我们需要
用来预留以后微调.

皮带张力机构 | WWW.VORONDESIGN.COM

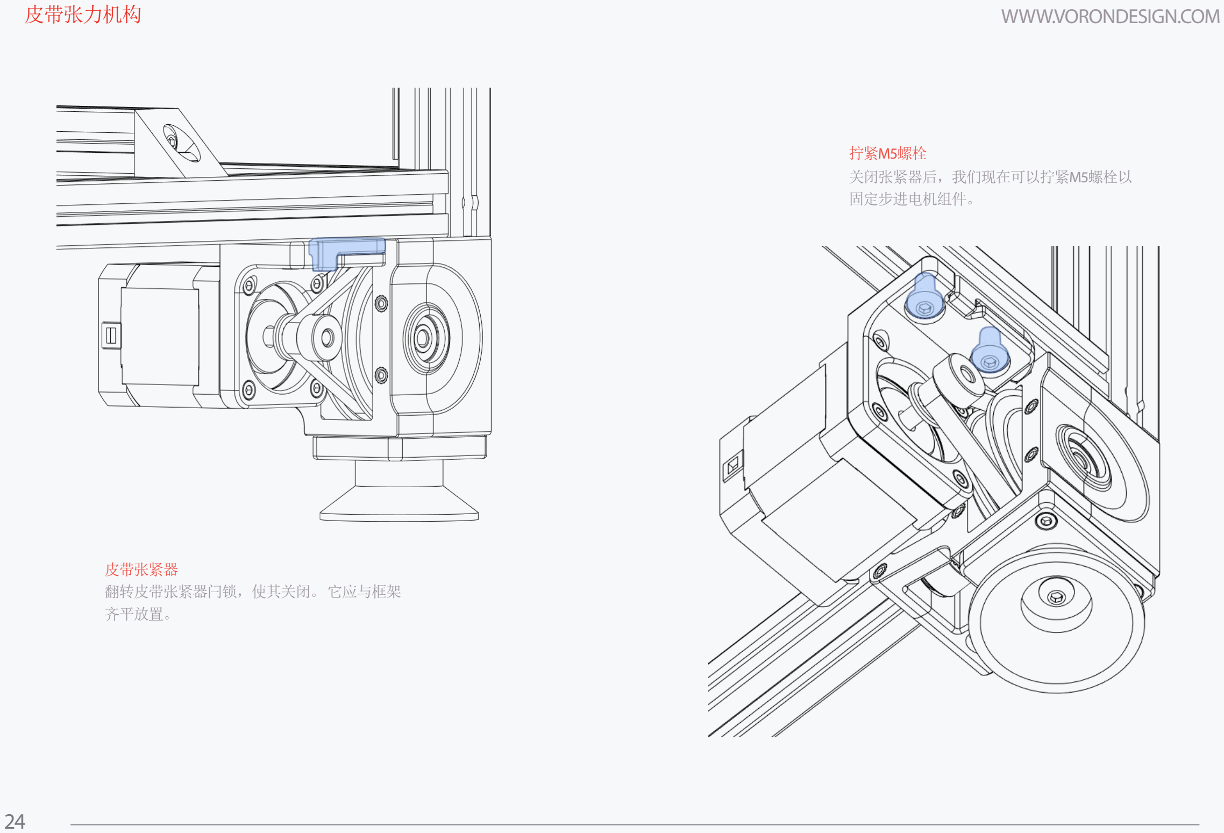
[picture p156: page 24]

24

皮带张紧器
翻转皮带张紧器闩锁，使其关闭。它应与框架
齐平放置。

拧紧M5螺栓
关闭张紧器后，我们现在可以拧紧M5螺栓以
固定步进电机组件。

25

Z轴惰轮模组 | WWW.VORONDESIGN.COM

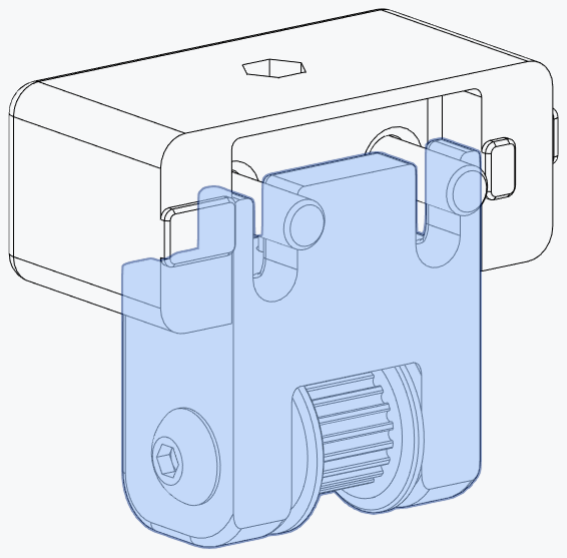
[picture p157: figure]
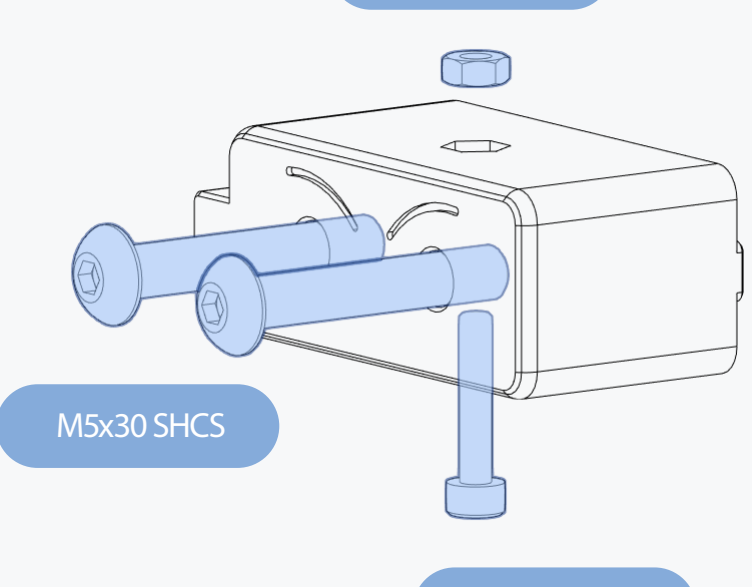
[picture p158: figure]
M5x30 SHCS

## M3x16 SHCS

M3六角螺母

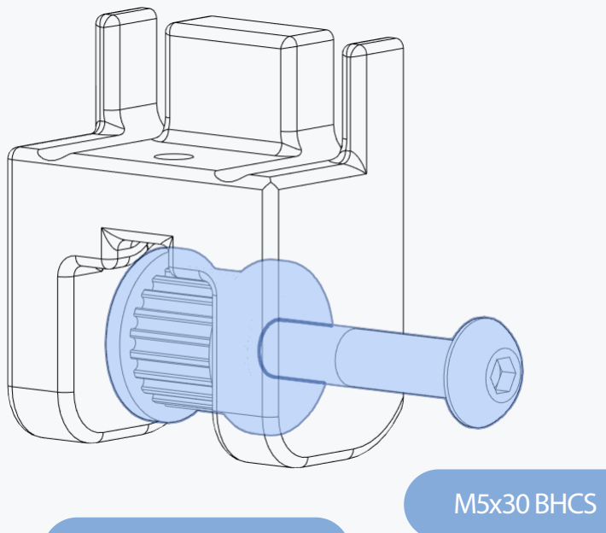
[picture p159: figure]
M5x30 BHCS

## GT2 20T 9mm惰轮

Z轴惰轮模组安装 | WWW.VORONDESIGN.COM

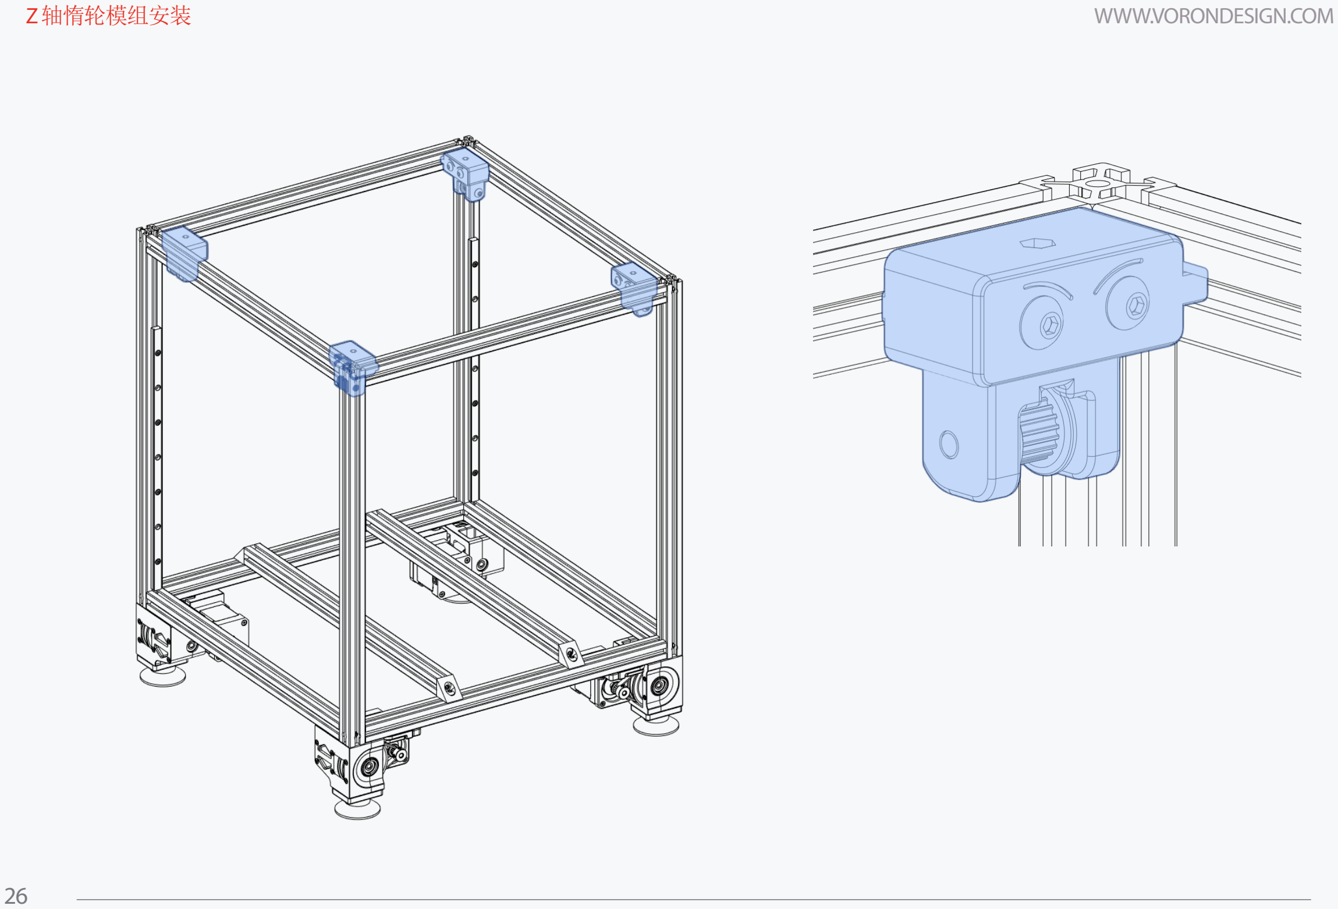
[picture p160: page 26]

26

27

## WWW.VORONDESIGN.COM

又到了休息一波的时候了，飞根香烟吧.

28

热床底板 | WWW.VORONDESIGN.COM

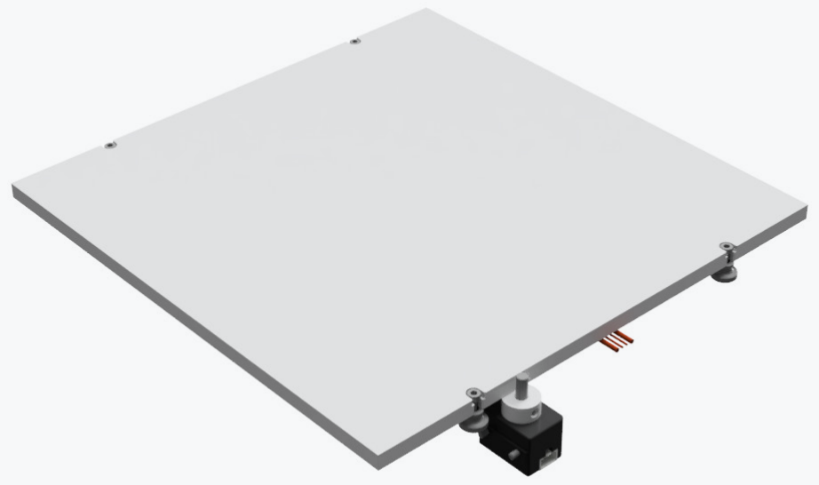
[picture p161: figure]

29

硅胶加热垫和测温电阻 | WWW.VORONDESIGN.COM

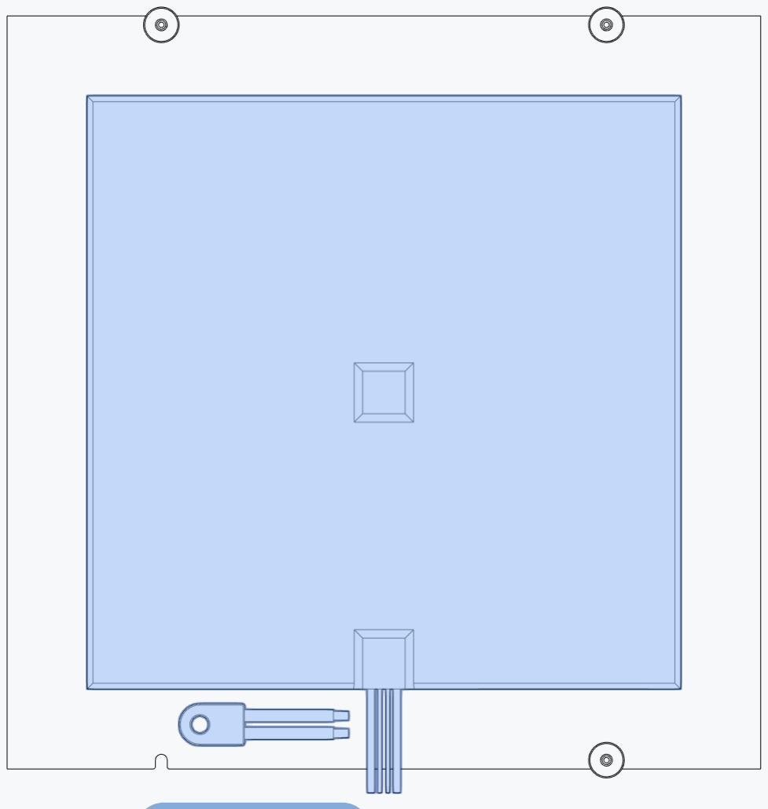
[picture p162: figure]

测温电阻

直流或交流硅胶加热垫

30

Z同步轮 | WWW.VORONDESIGN.COM

## 33mm光轴

GT2 20T同步轮法兰

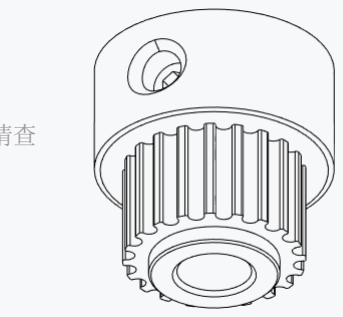
[picture p163: figure]

如果您不知道如何拆卸20T滑轮的法兰，请查
看我们的帮助视频。

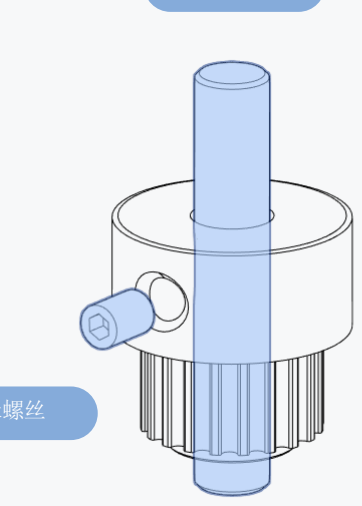
[picture p164: figure]

机米螺丝

31

## WWW.VORONDESIGN.COM

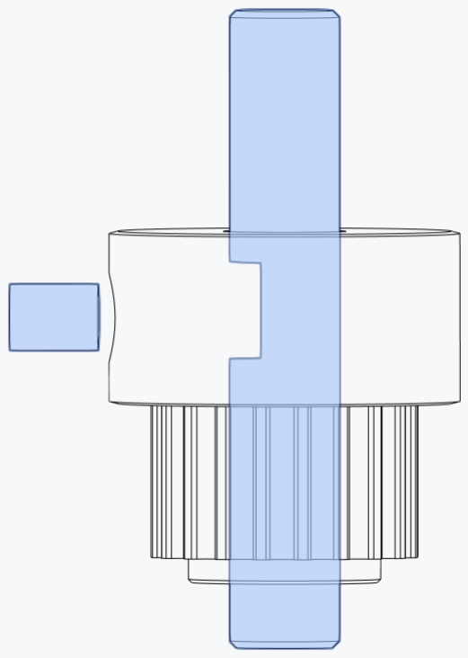
[picture p165: figure]

# 重要的提醒

光轴需要手工磨制出一个缺口，该缺口将与机米螺丝一起切入Z轴挡块 。这只是为了防止将来倾斜机器以使其工作时掉下来。确实发生了这 种情况，并且可能导致喷嘴撞击而对龙门架造成重大损坏。

建议您在组装过程中的最后一步，将此引脚的尺寸和尺寸减小。底板的 结构有时会因可移动的底板，PEI板厚度等因素而有所不同。如果销钉 太短 ，则会碰到模板上的热端外壳，但是如果销子太长，则会在打印 过程中撞到它。

固定平头螺钉时，请记住轴必须移动才能撞到微动开关。它不应紧紧固 定在轴上，而应保持松弛以允许移动。它打算稍微后退安装，并与保留 化合物一起固定在适当的位置。

如有疑问，请在我们的Discord中询问。这是构建过程中最关键的步骤之 一，因此在组装此组件时请多加注意。

Z轴限位 | WWW.VORONDESIGN.COM

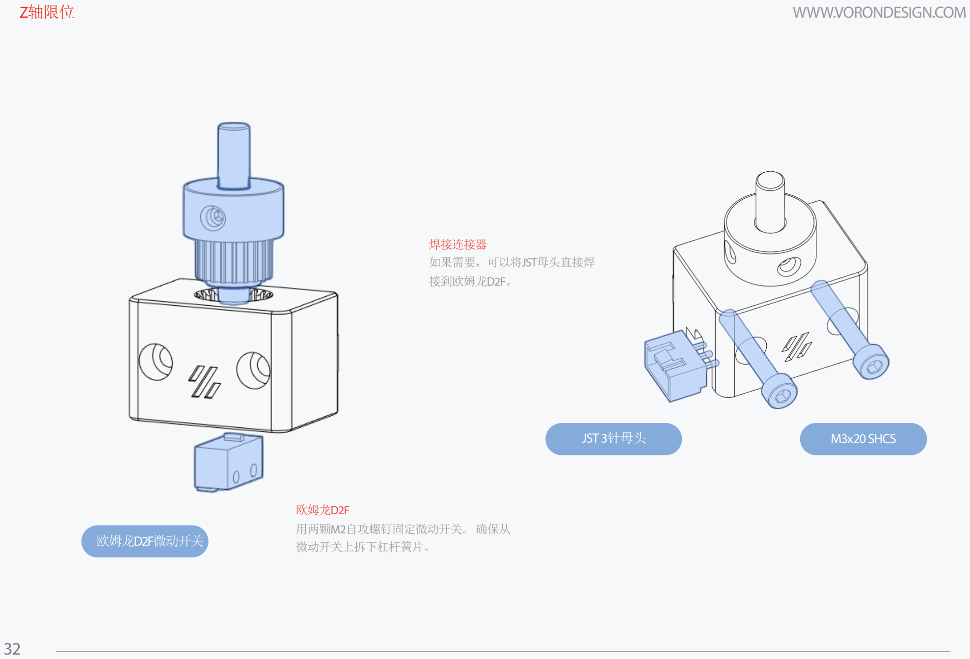
[picture p166: page 32]

32

## M3x20 SHCS

欧姆龙D2F微动开关

欧姆龙D2F
用两颗M2自攻螺钉固定微动开关。确保从
微动开关上拆下杠杆簧片。

焊接连接器
如果需要，可以将JST母头直接焊
接到欧姆龙D2F。

## JST 3针母头

## WWW.VORONDESIGN.COM

## 热床底板安装

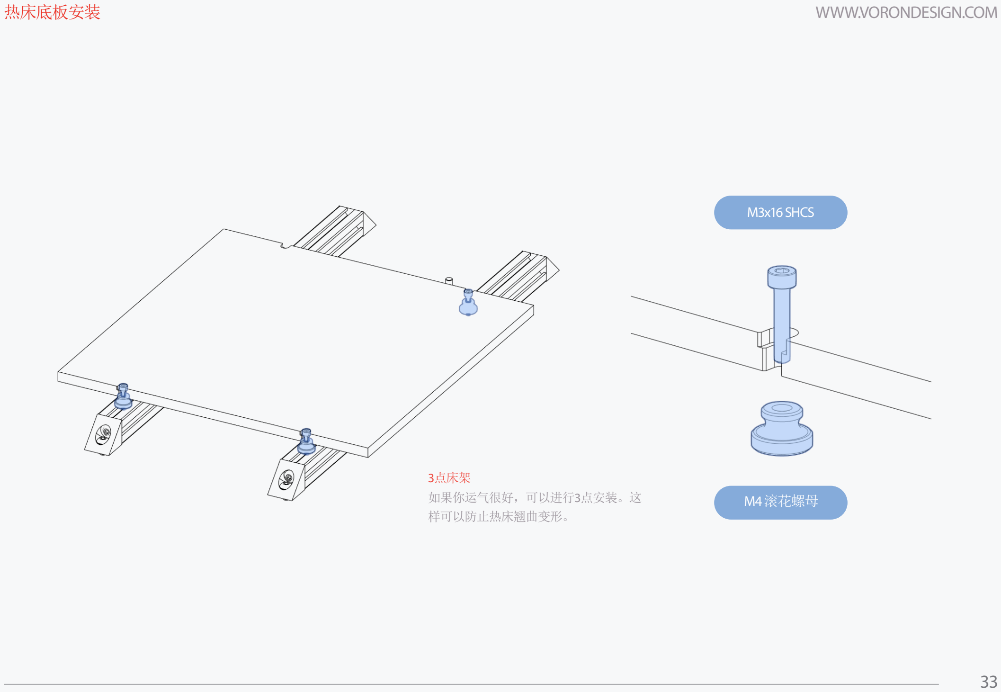
[picture p167: page 33]

33

## M3x16 SHCS

M4滚花螺母

3点床架
如果你运气很好，可以进行3点安装。这
样可以防止热床翘曲变形。

## WWW.VORONDESIGN.COM

## Z轴限位安装

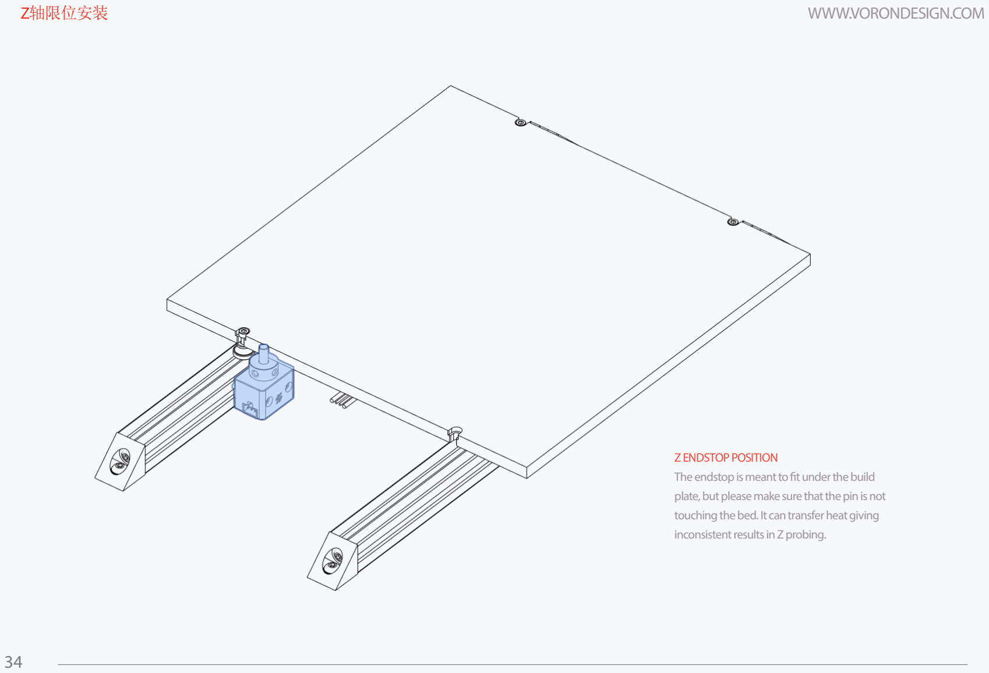
[picture p168: page 34]

34

### Z ENDSTOP POSITION The endstop is meant to fit under the build plate, but please make sure that the pin is not touching the bed. It can transfer heat giving

inconsistent results in Z probing.

35

## WWW.VORONDESIGN.COM

又到了休息一波的时候了，飞根香烟吧.

36

AB轴驱动模块 | WWW.VORONDESIGN.COM

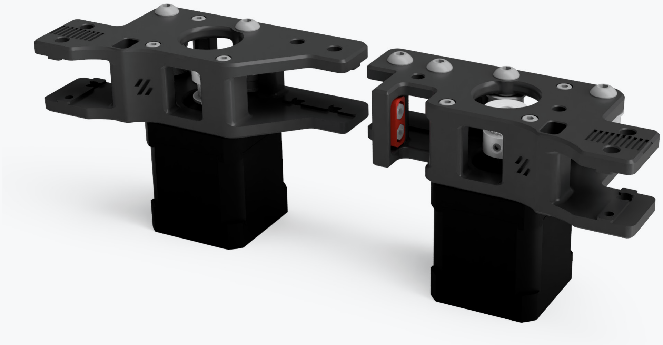
[picture p169: figure]

37

## WWW.VORONDESIGN.COM

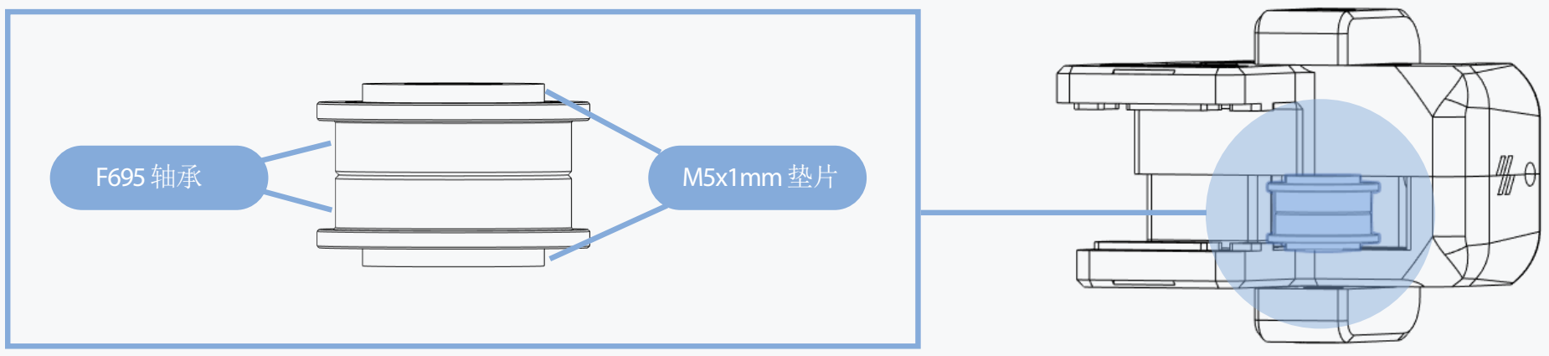
[picture p170: figure]
M5x1mm垫片
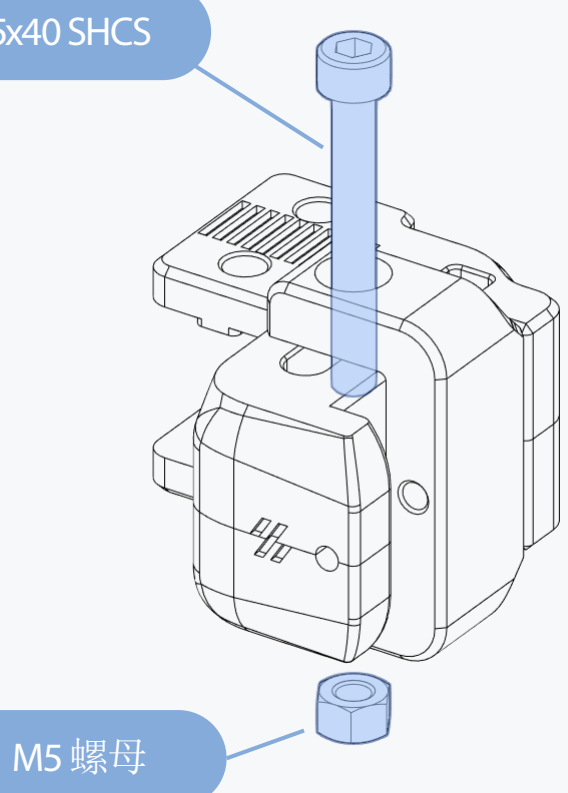
[picture p171: figure]

## M5x40 SHCS

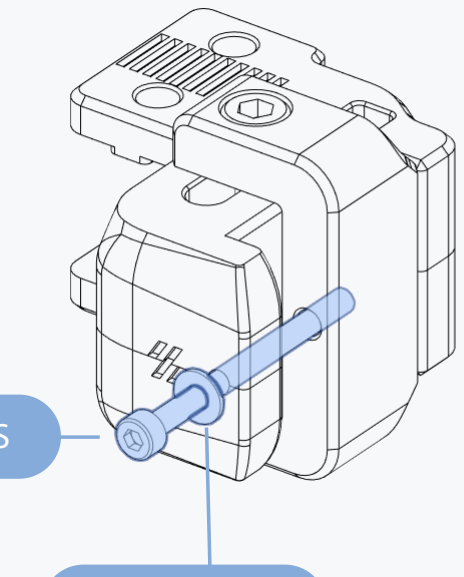
[picture p172: figure]

## M3x40 SHCS

## M3垫片

## 前惰轮

轴承堆栈

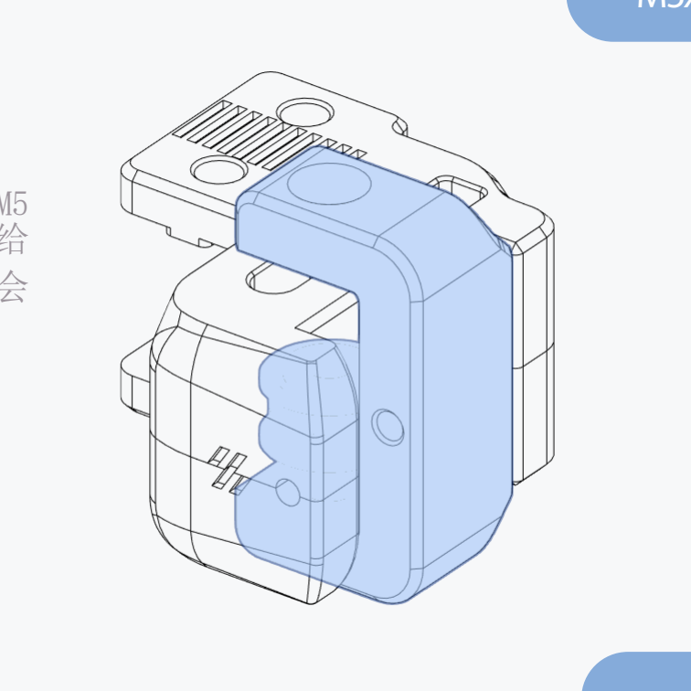
[picture p173: figure]

轴承箱安装有点麻烦，将M5 x40用作导向轴并同时给

垫圈和轴承一次性安装会
更加简单.

38

AB BEARING STACKS | WWW.VORONDESIGN.COM

## M5垫片

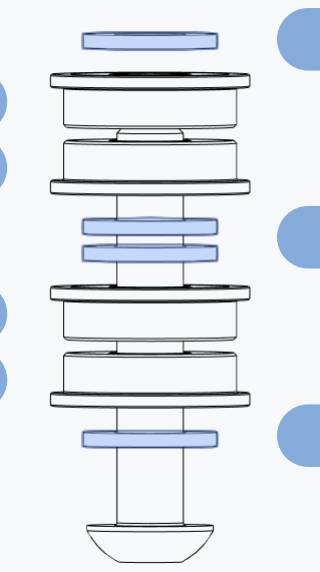
[picture p174: figure]

F695法兰轴承 | M5垫片

## F695法兰轴承

## F695法兰轴承

## F695法兰轴承

## F695法兰轴承

## F695法兰轴承

## M5垫片

## 2xM5垫片

## M5垫片

## M5x30 BHCS

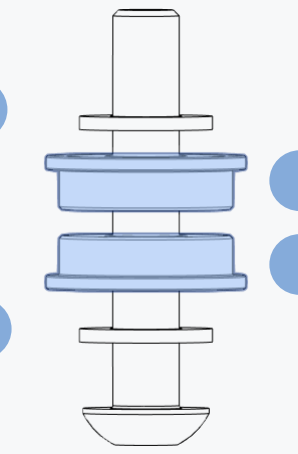
[picture p175: figure]

## M5x30 BHCS

## WWW.VORONDESIGN.COM

## B轴驱动模块

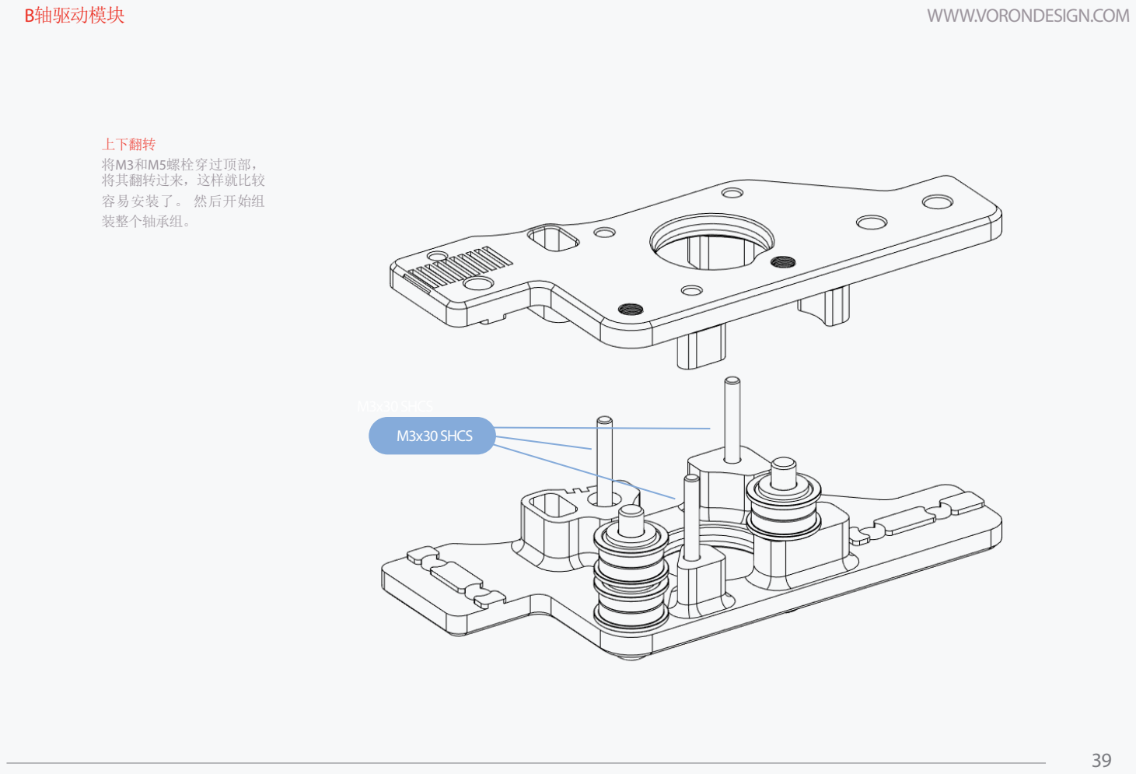
[picture p176: page 39]

39

## M3x30 SHCS M3x30 SHCS

上下翻转
将M3和M5螺栓穿过顶部，
将其翻转过来，这样就比较
容易安装了。 然后开始组
装整个轴承组。

## WWW.VORONDESIGN.COM

## 驱动模块+连接片

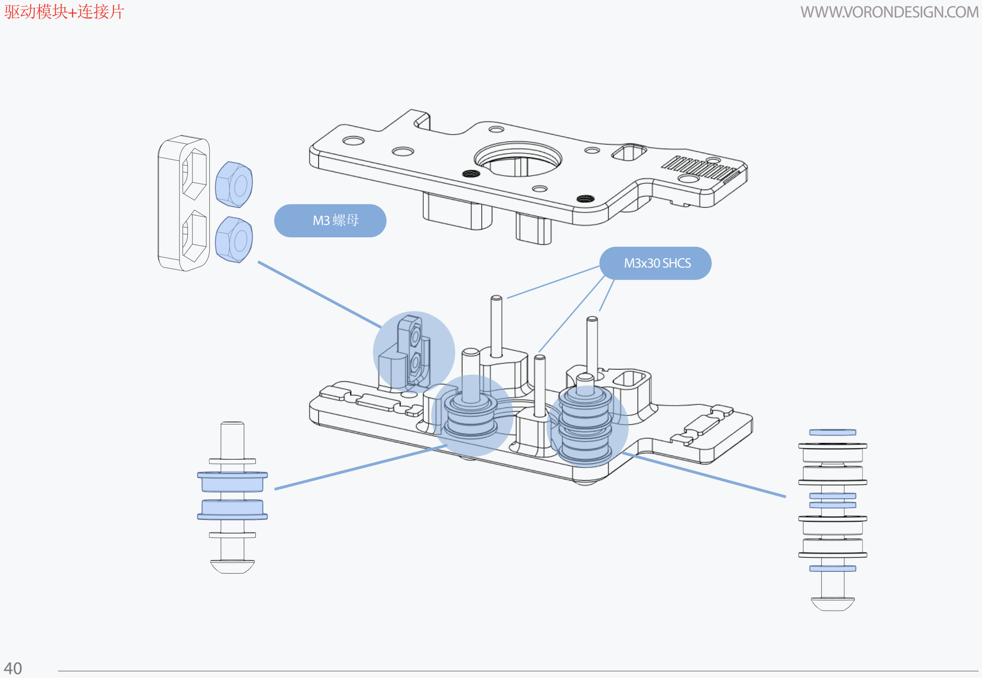
[picture p177: page 40]

40

## M3x30 SHCS

## M3螺母

41

## WWW.VORONDESIGN.COM

## M3x30 SHCS

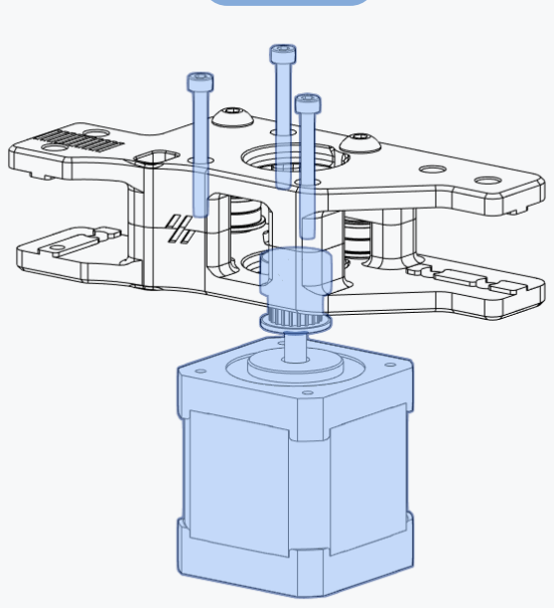
[picture p178: figure]

## GT220T同步轮

## 安装AB轴驱动步进电机

确保在皮带轮平头螺钉上拧上螺纹锁固剂。

应使用螺纹胶

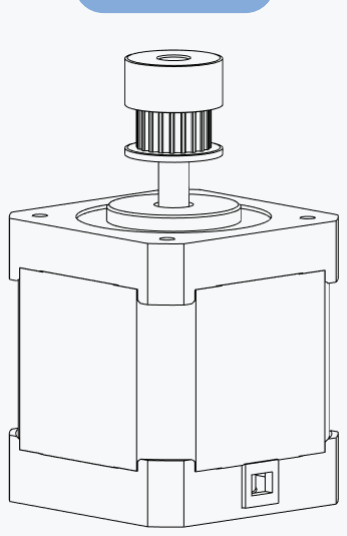
[picture p179: figure]

42

## WWW.VORONDESIGN.COM

## M3x30 SHCS

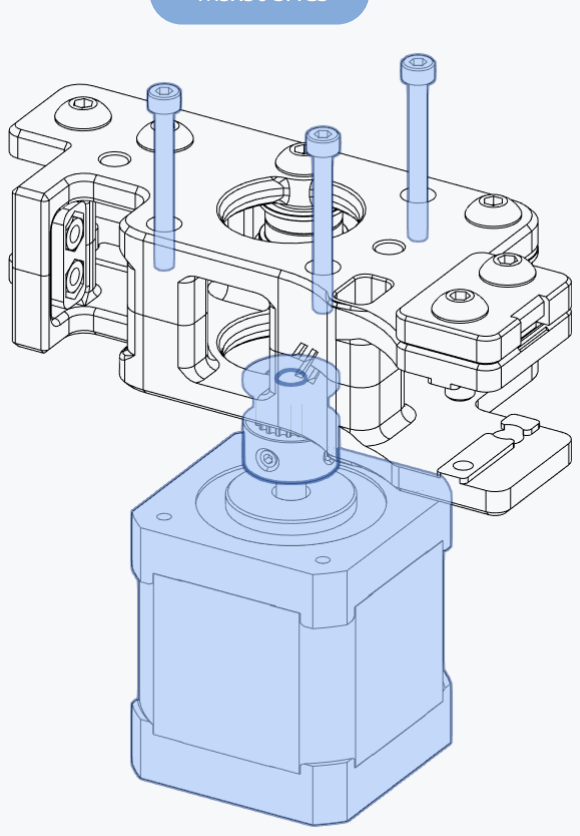
[picture p180: figure]

检查20T同步轮

## 完整的AB轴传动装置总成

确保将20T皮带轮安装在A驱
动器上（右侧图），与我们
B驱动器的安装方式相反（
左侧图）。

43

## WWW.VORONDESIGN.COM

又到了休息一波的时候了，飞根香烟吧.

44

龙门架总成预览 | WWW.VORONDESIGN.COM

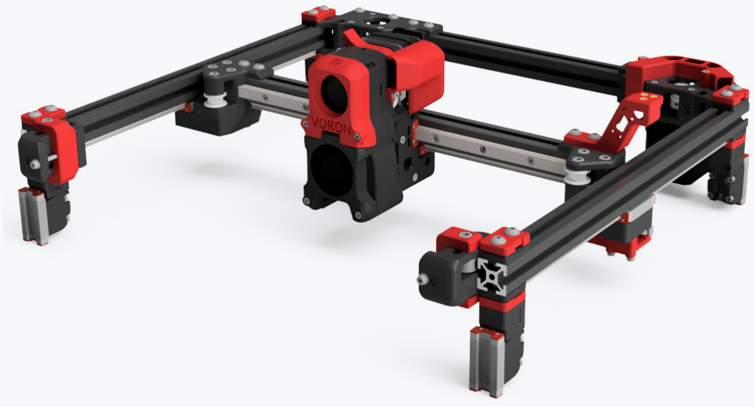
[picture p181: figure]

45

## WWW.VORONDESIGN.COM

## 双轨安装

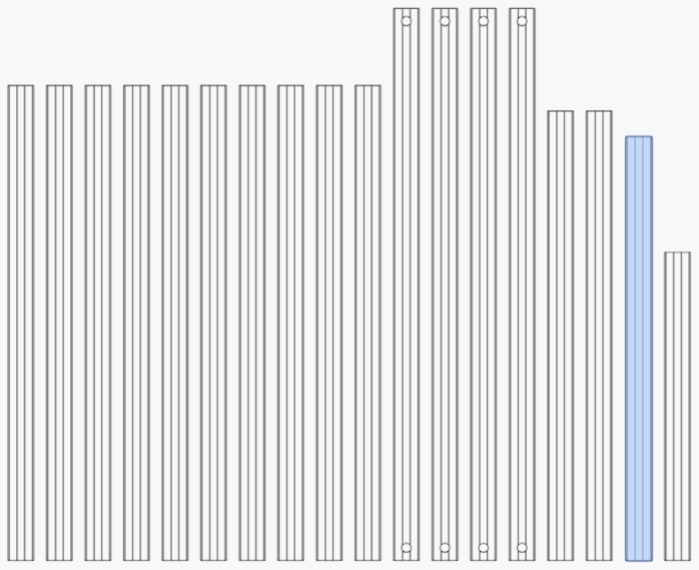
[picture p182: figure]

中心导轨安装指南

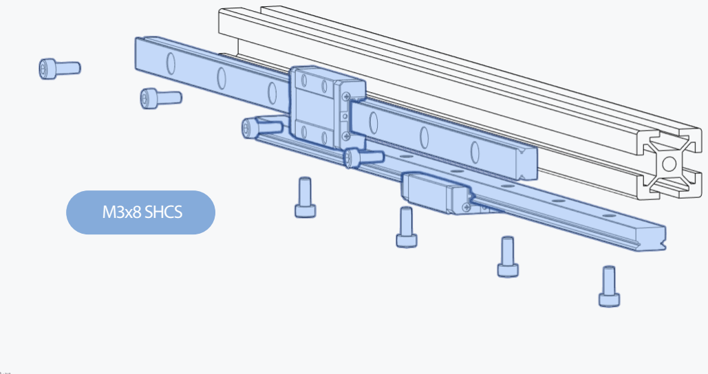
[picture p183: figure]
M3x8 SHCS

拧紧紧固件以将线性导轨固定到位时，请确保已在顶部
和底部均安装了居中的导轨安装工具。你应该打印两个
此型安装辅具.

## WWW.VORONDESIGN.COM

## 左XY轴关节组件

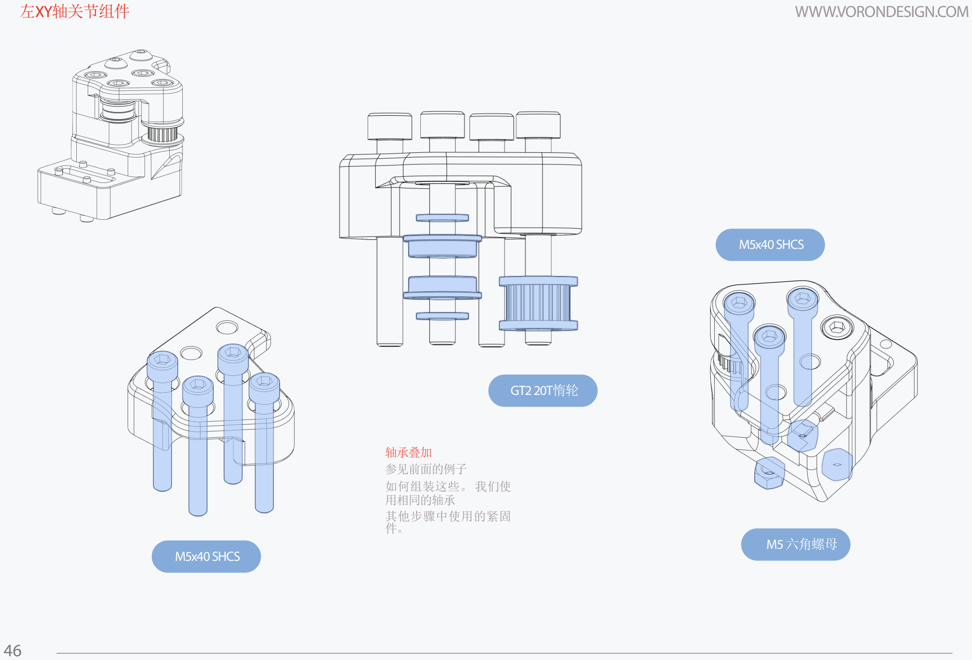
[picture p184: page 46]

46

## M5x40 SHCS

M5六角螺母

## M5x40 SHCS

## GT2 20T惰轮

轴承叠加
参见前面的例子
如何组装这些。 我们使
用相同的轴承
其他步骤中使用的紧固
件。

## WWW.VORONDESIGN.COM

## 右XY轴关节组件

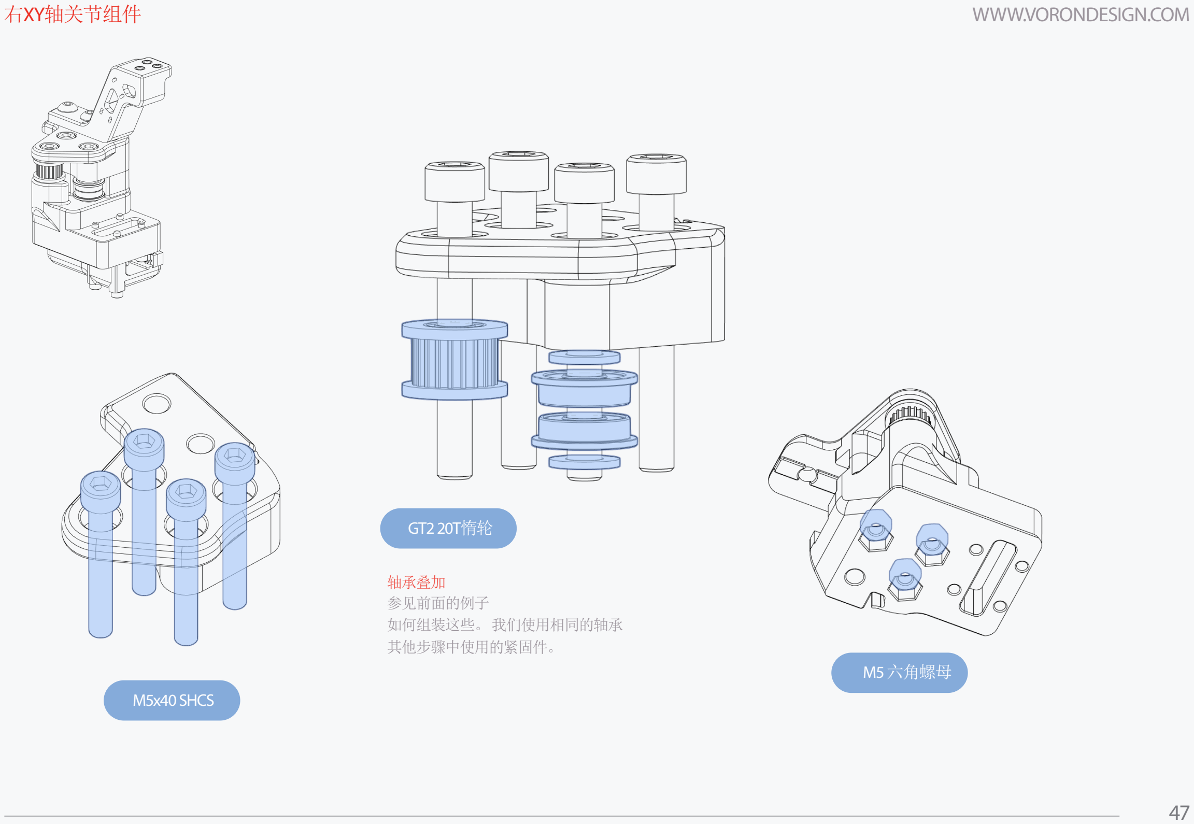
[picture p185: page 47]

47

M5六角螺母

## M5x40 SHCS

## GT2 20T惰轮

轴承叠加
参见前面的例子
如何组装这些。我们使用相同的轴承
其他步骤中使用的紧固件。

48

## WWW.VORONDESIGN.COM

## 微动开关盒

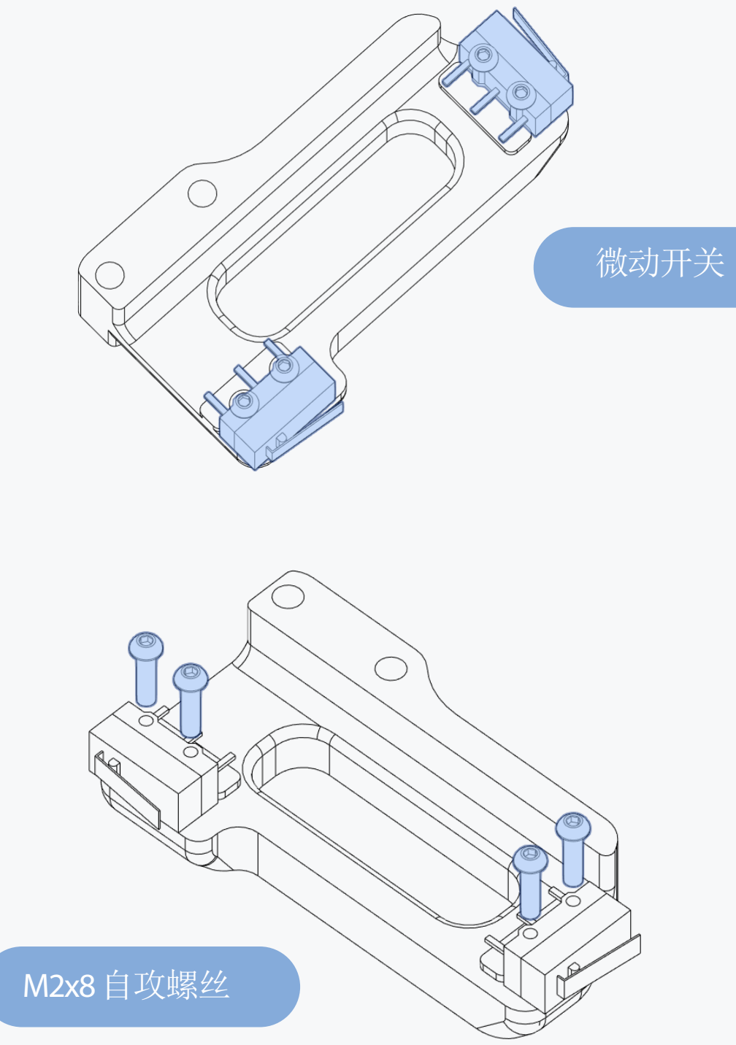
[picture p186: figure]
M2x8自攻螺丝; 微动开关

热嵌入滚花螺母

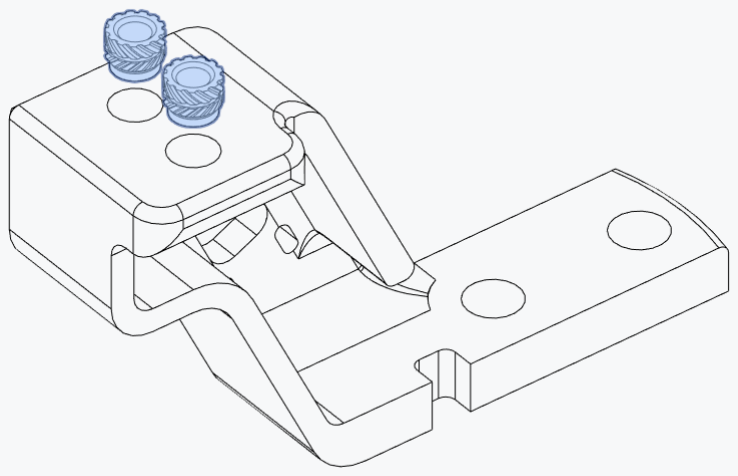
[picture p187: figure]

49

## WWW.VORONDESIGN.COM

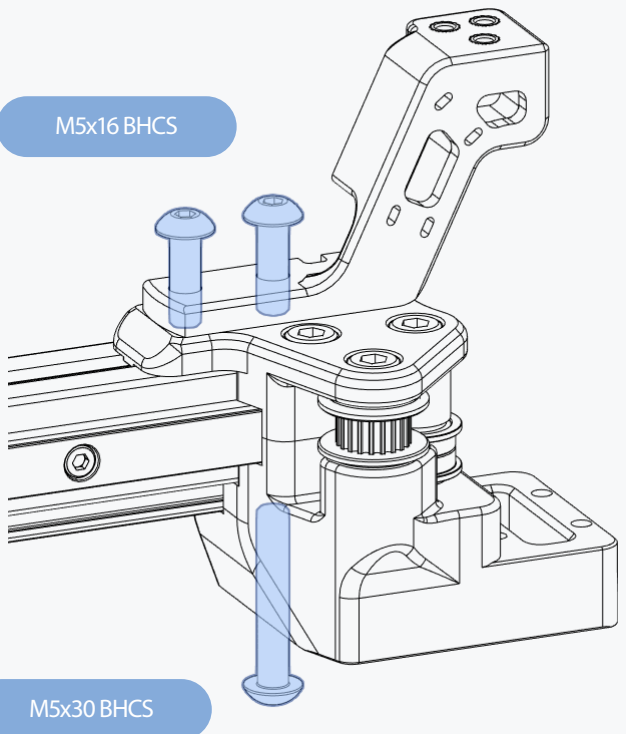
[picture p188: figure]
M5x30 BHCS; M5x16 BHCS

## M5x10 BHCS

## XY块安装

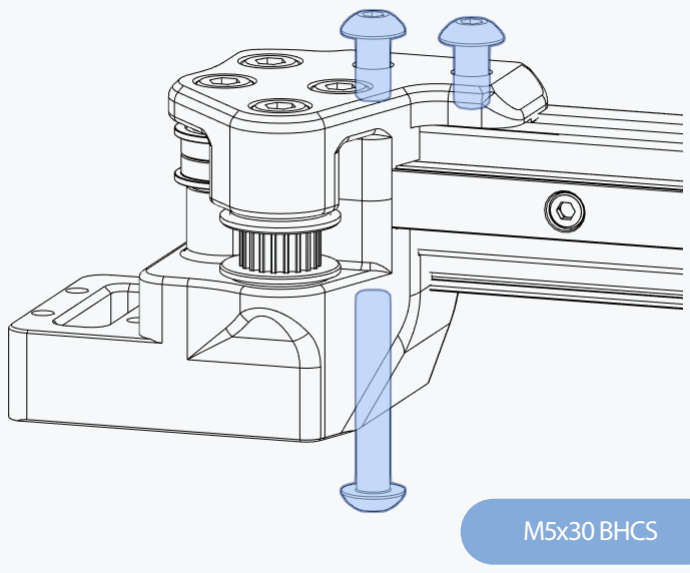
[picture p189: figure]
M5x30 BHCS

50

## WWW.VORONDESIGN.COM

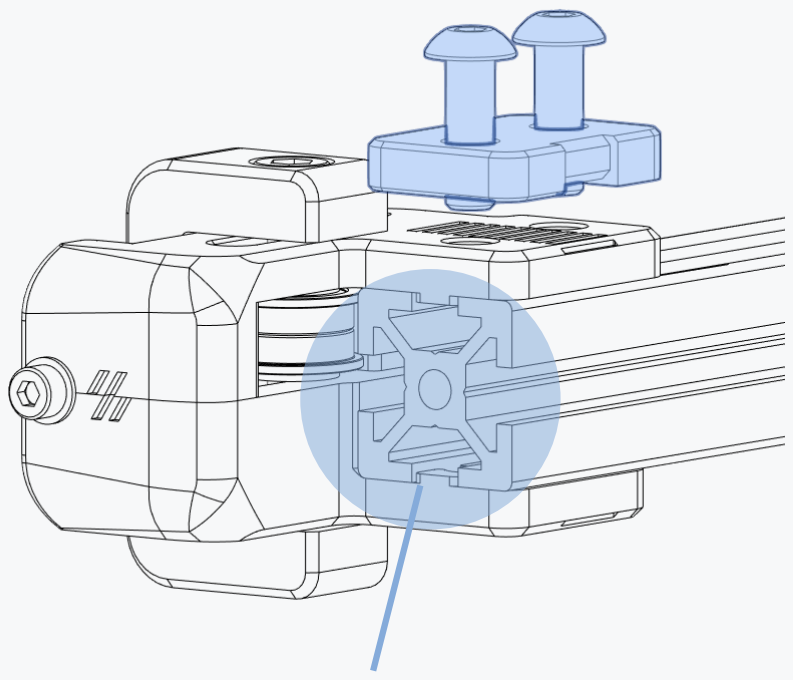
[picture p190: figure]

### FLUSHINSTALL

M5x16 BHCS | M5x16 BHCS

## 皮带夹片

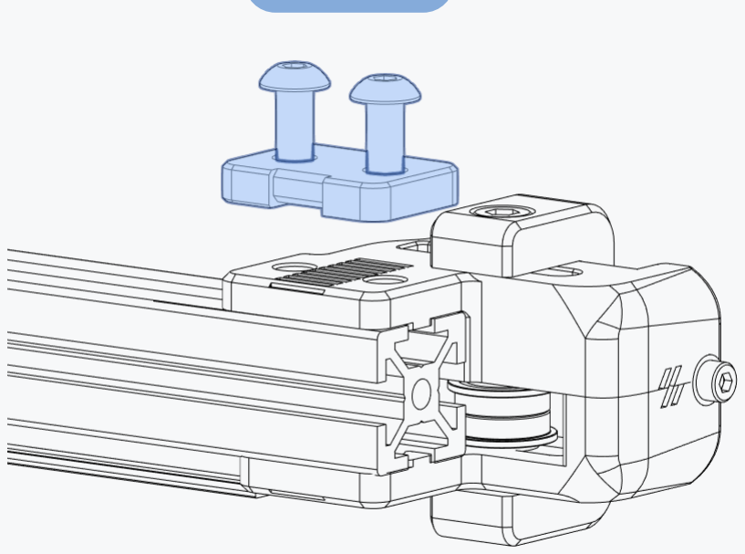
[picture p191: figure]

左夹片
确保将20T皮带轮安装在A驱
动器上（右侧图），与我们
B驱动器的安装方式相反（
左侧图）。

我们将索引前进中的前轮惰轮。 慢慢
来，确保两个惰轮都齐平
直到两次挤压结束。 此处的错误可能
会在以后导致问题。

## WWW.VORONDESIGN.COM

## Y轴导轨安装

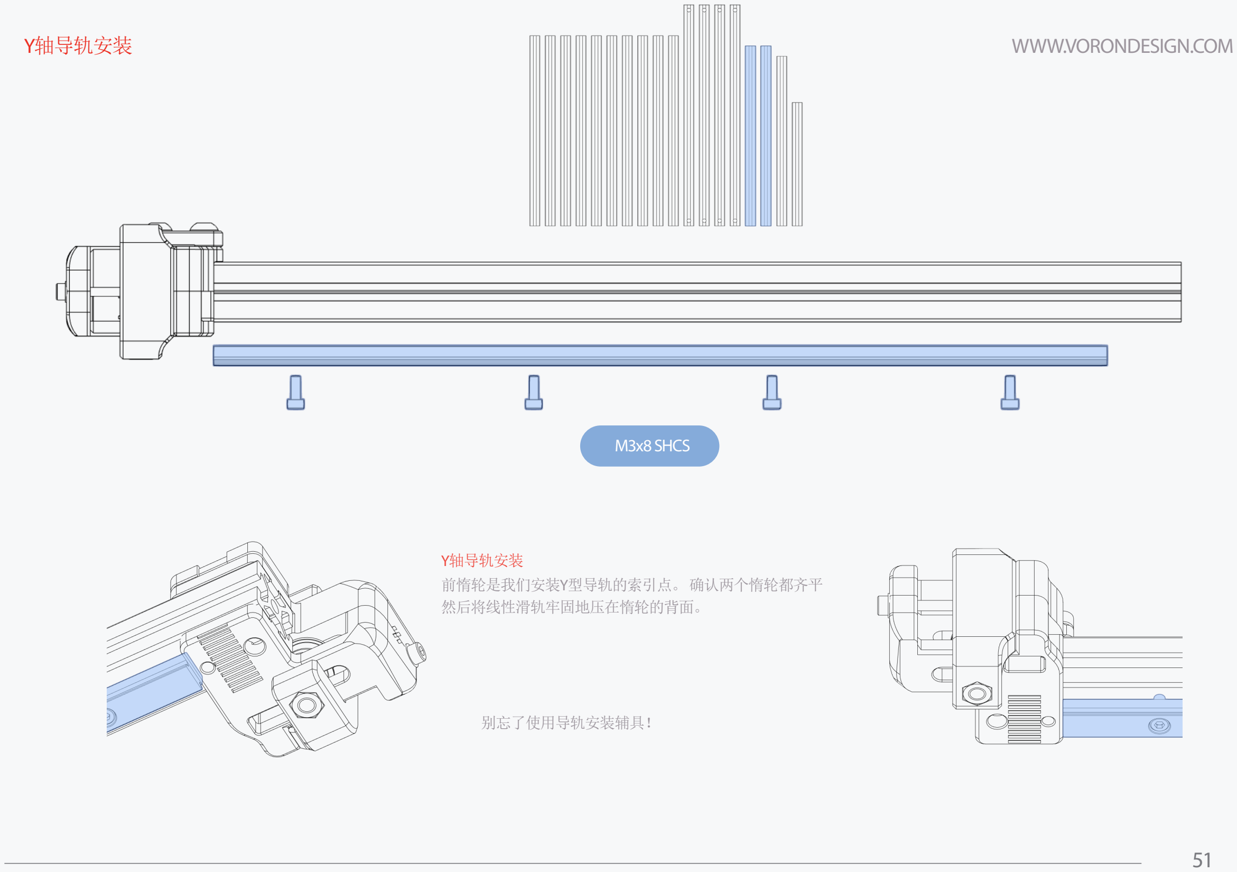
[picture p192: page 51]

51

## M3x8 SHCS

Y轴导轨安装
前惰轮是我们安装Y型导轨的索引点。确认两个惰轮都齐平 然后将线性滑轨牢固地压在惰轮的背面。

别忘了使用导轨安装辅具！

## WWW.VORONDESIGN.COM

## AB轴驱动单元总装

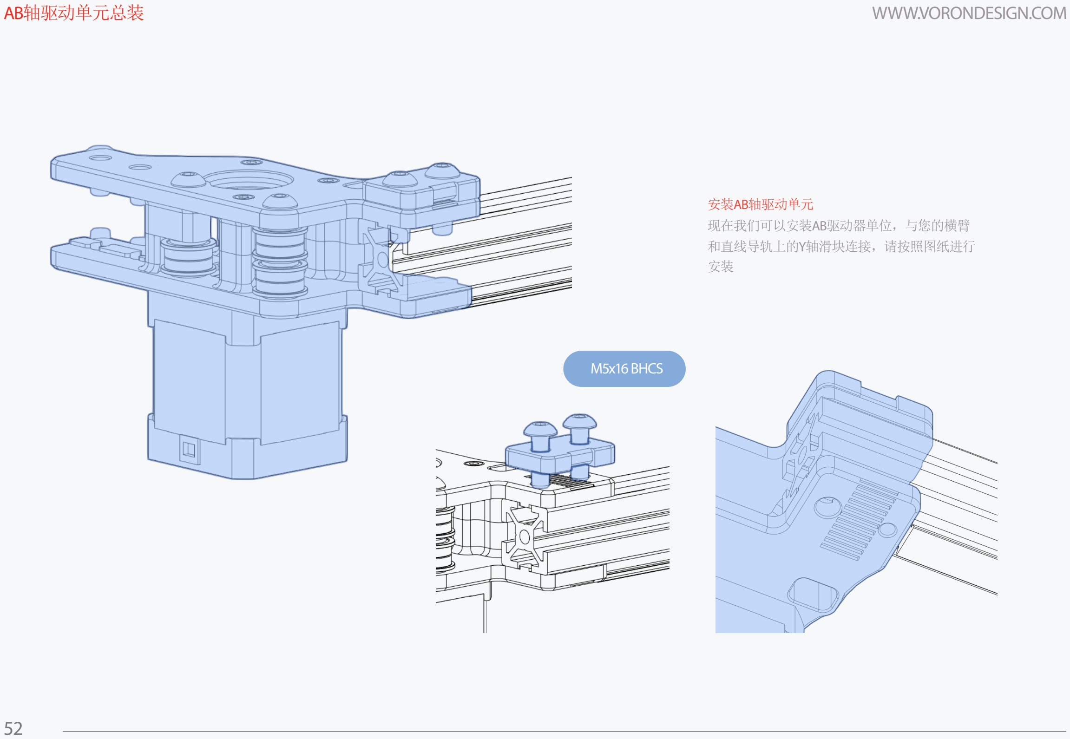
[picture p193: page 52]

52

## M5x16 BHCS

安装AB轴驱动单元
现在我们可以安装AB驱动器单位，与您的横臂
和直线导轨上的Y轴滑块连接，请按照图纸进行
安装

## WWW.VORONDESIGN.COM

## 后支架

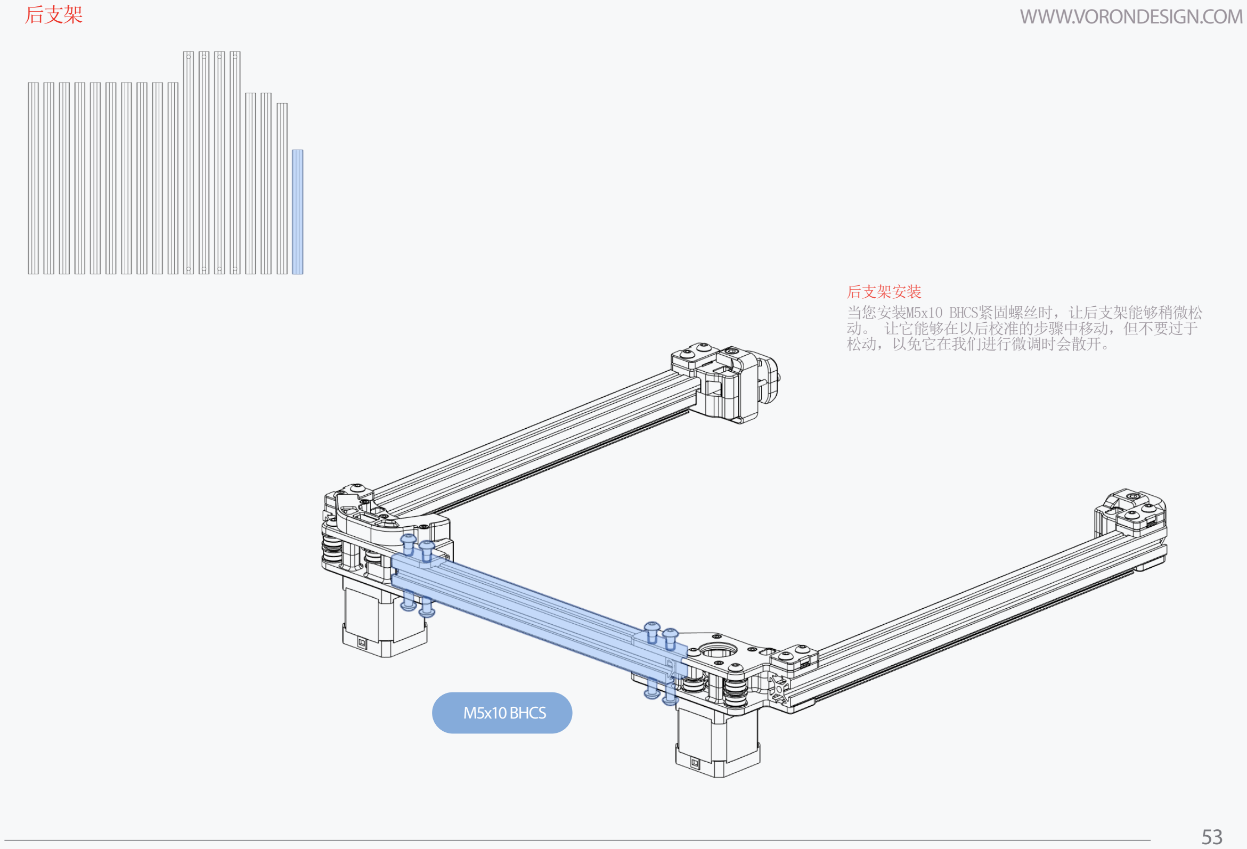
[picture p194: page 53]

53

## M5x10 BHCS

后支架安装
当您安装M5x10 BHCS紧固螺丝时，让后支架能够稍微松 动。 让它能够在以后校准的步骤中移动，但不要过于
松动，以免它在我们进行微调时会散开。

54

挤出机安装篇 | WWW.VORONDESIGN.COM

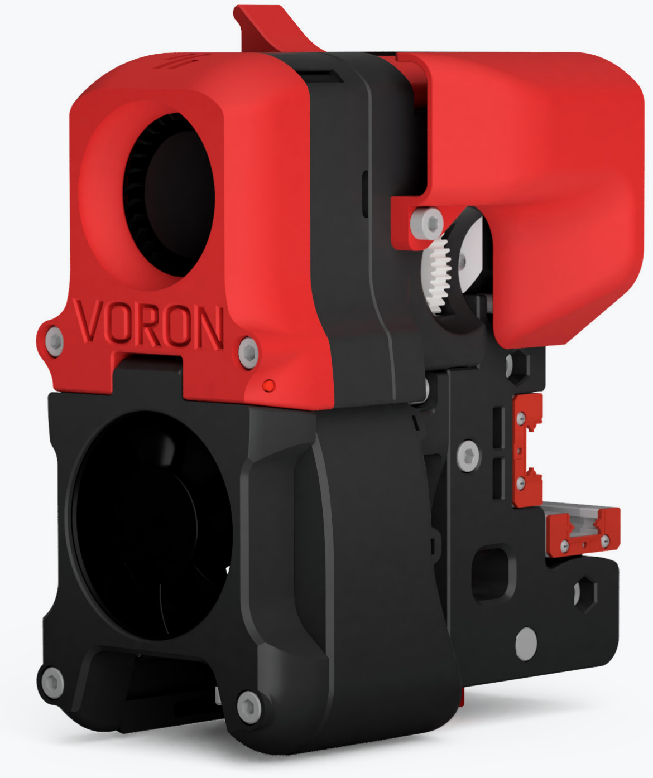
[picture p195: figure]

## WWW.VORONDESIGN.COM

## 挤出机安装架

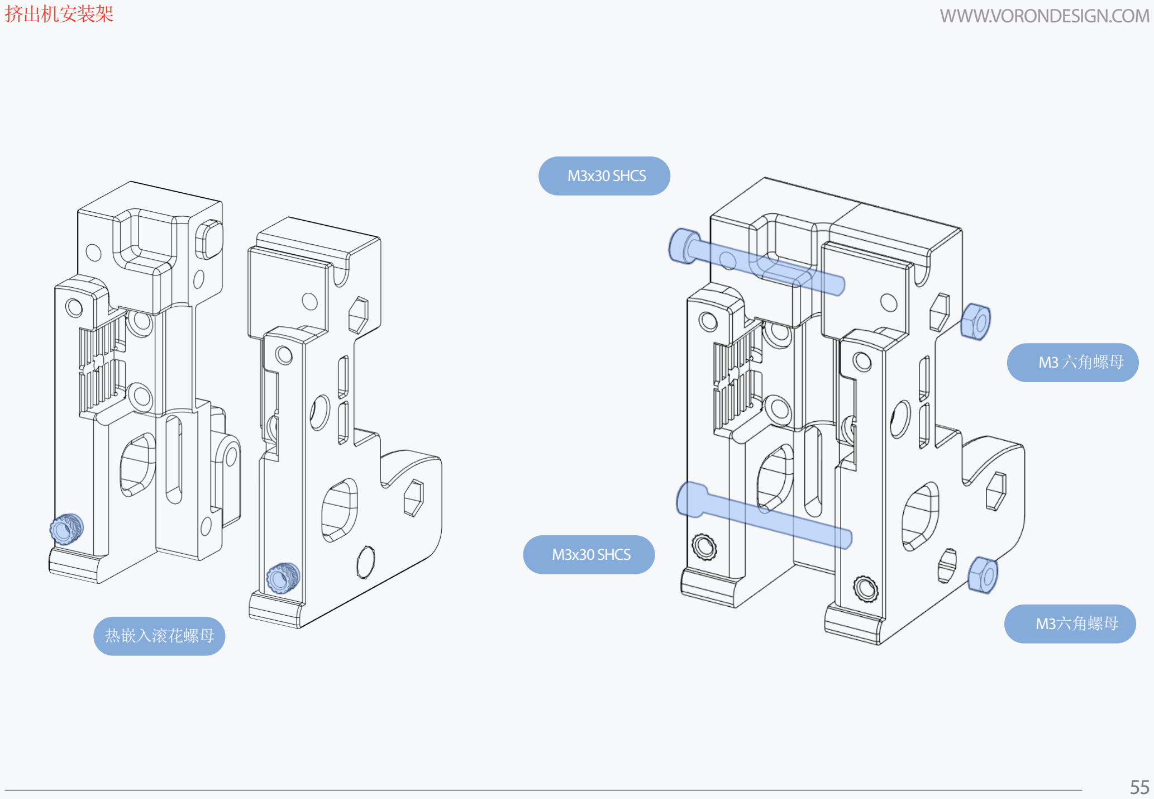
[picture p196: page 55]

55

## M3x30 SHCS

## M3x30 SHCS

M3六角螺母

M3六角螺母
热嵌入滚花螺母

## WWW.VORONDESIGN.COM

## 探针安装板和加强连接块

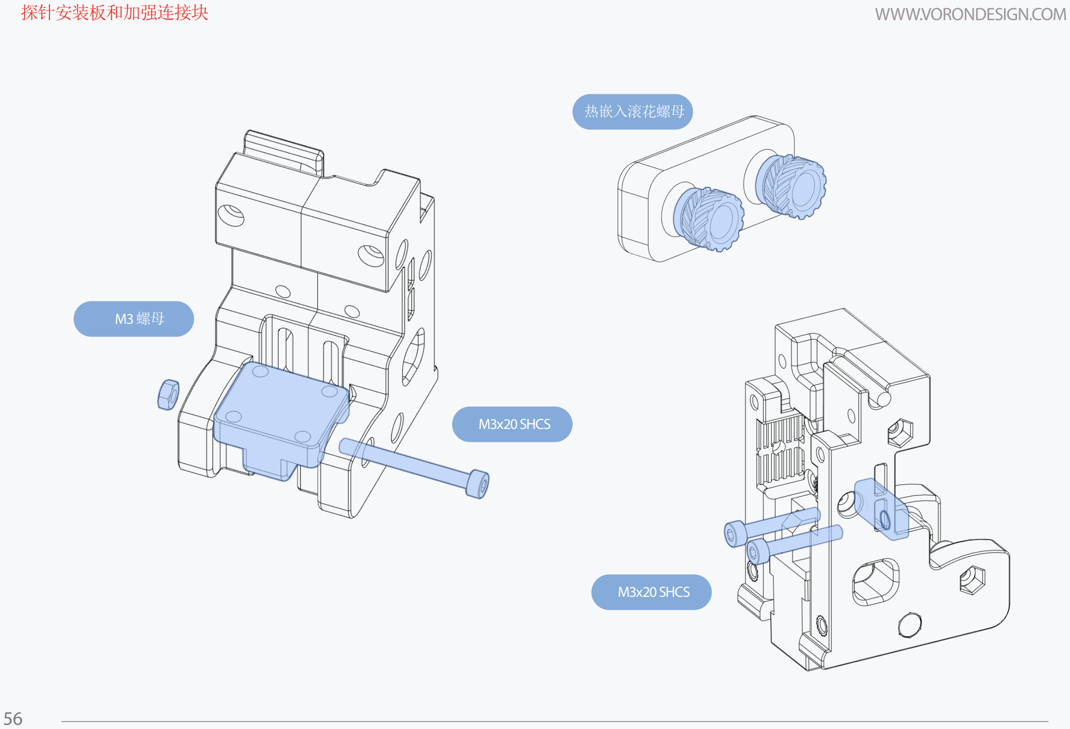
[picture p197: page 56]

56

## M3x20 SHCS

## M3x20 SHCS

## M3螺母

热嵌入滚花螺母

## WWW.VORONDESIGN.COM

## XY轴皮带固定夹块

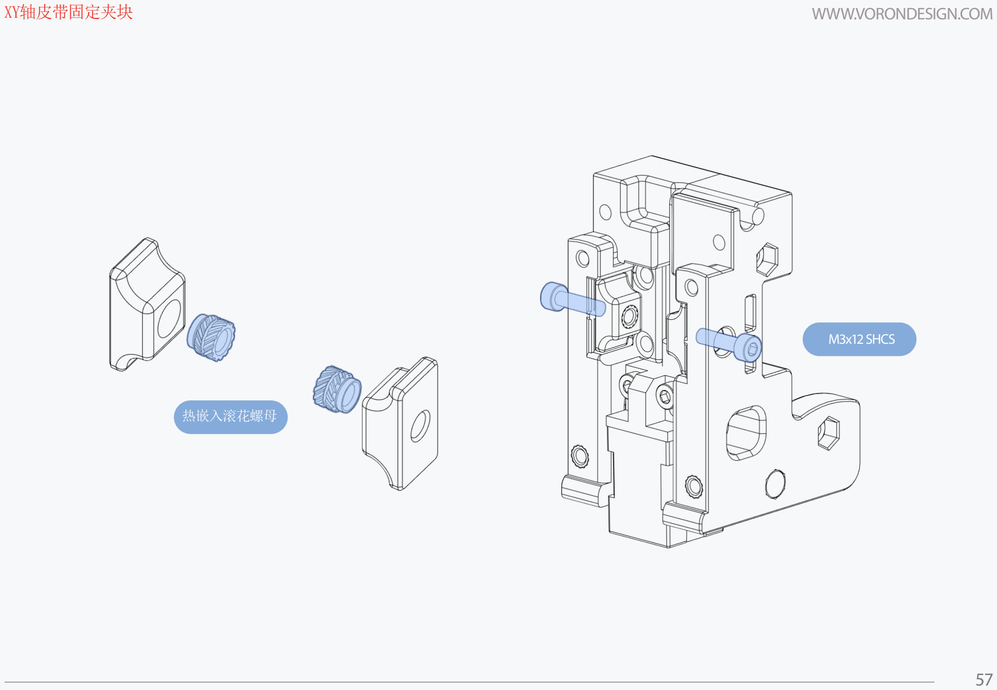
[picture p198: page 57]

57

## M3x12 SHCS

热嵌入滚花螺母

58

## WWW.VORONDESIGN.COM

## 挤出机支架模块总成安装

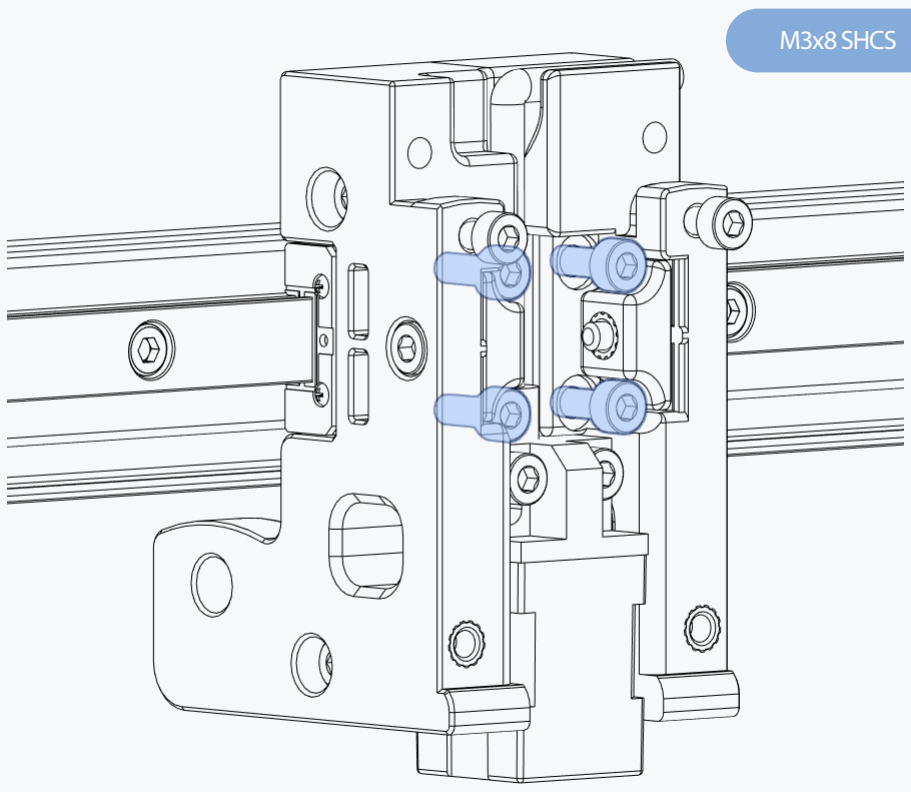
[picture p199: figure]
M3x8 SHCS

如果您碰巧周围有一些M3x
8 BHCS，则可以在此处使
用。它可以使在以后的步
骤中将龙门式输送带束缚
起来更容易一些，但是如
果您没有它们的话，也没
什么大不了的。

圆柱头螺丝选项

59

## WWW.VORONDESIGN.COM

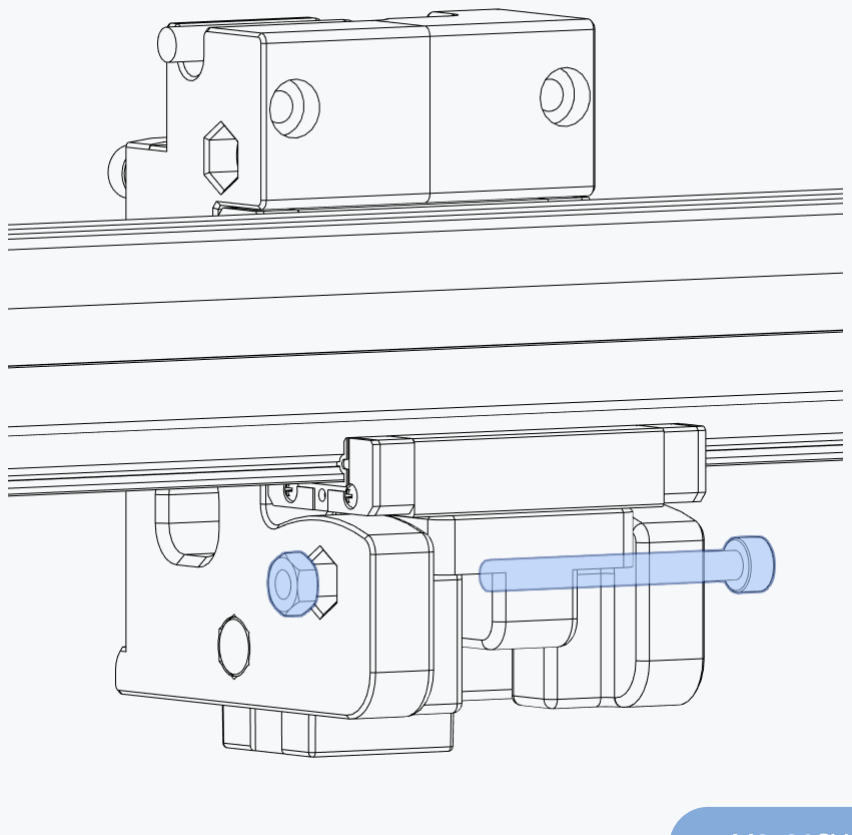
[picture p200: figure]

## M3x30SHCS

M3六角螺母

总装

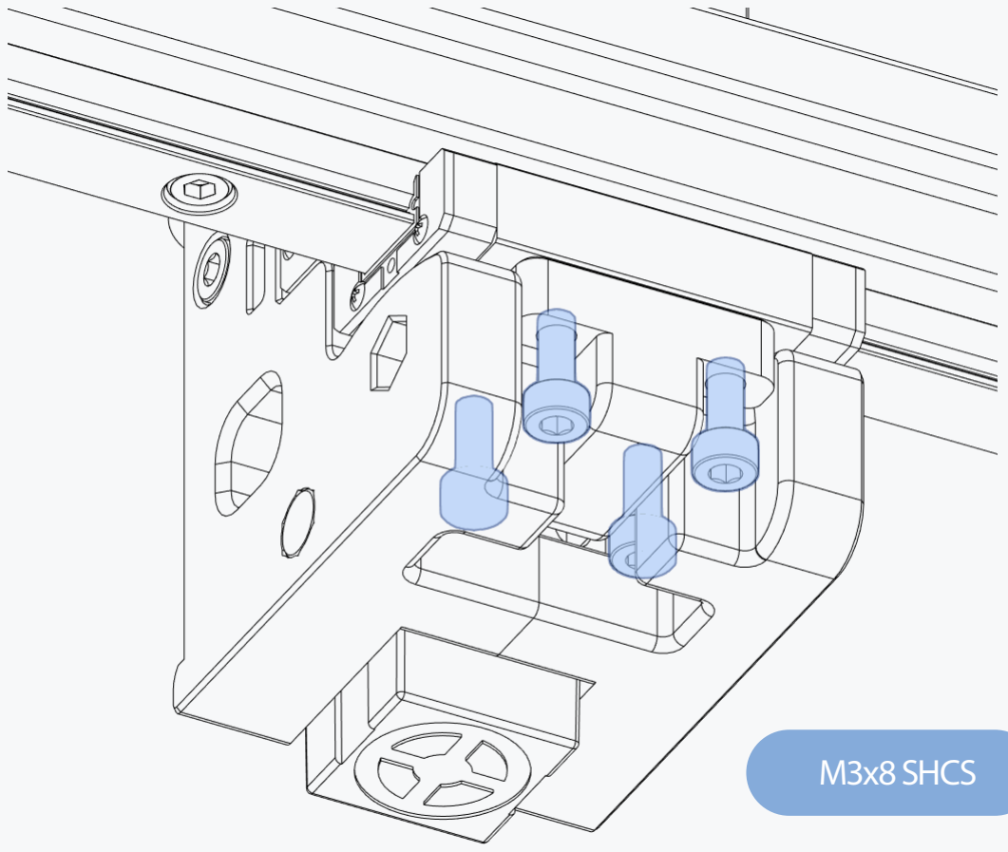
[picture p201: figure]
M3x8 SHCS

皮带穿行路线 | WWW.VORONDESIGN.COM

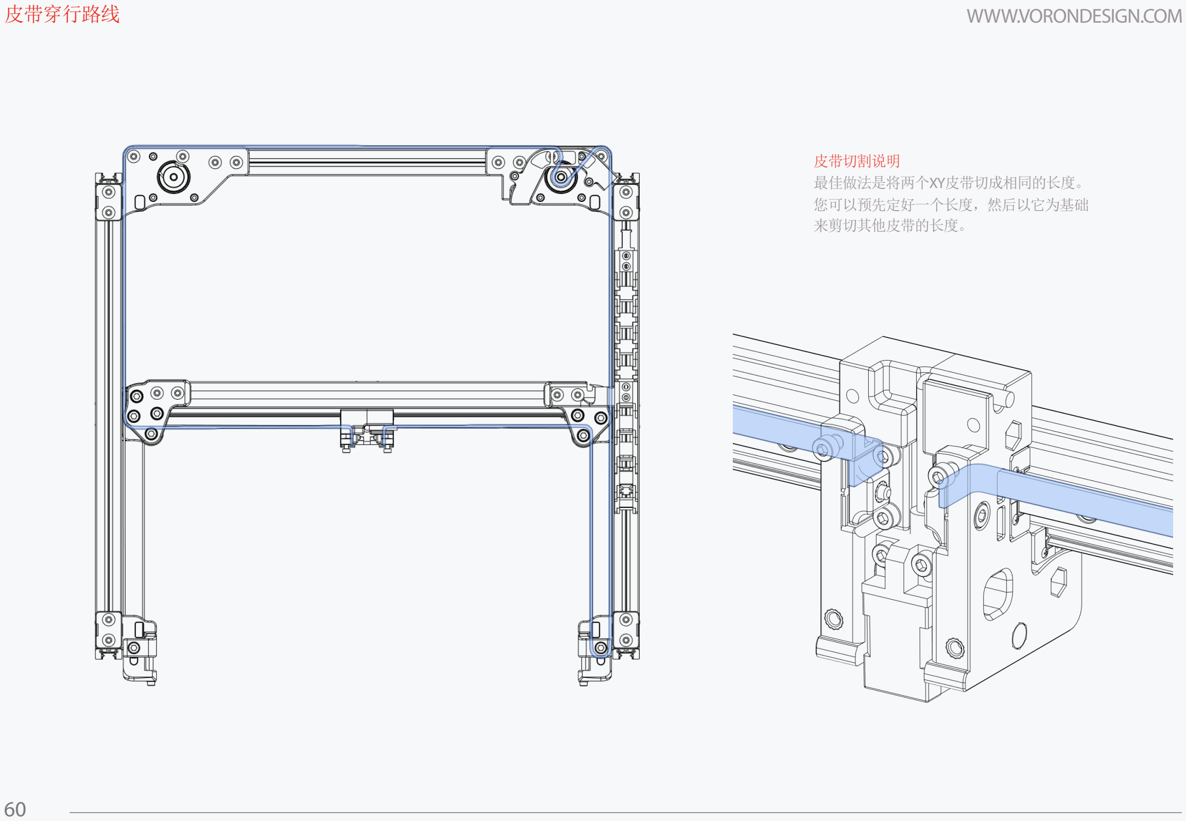
[picture p202: page 60]

60

皮带切割说明
最佳做法是将两个XY皮带切成相同的长度。
您可以预先定好一个长度，然后以它为基础
来剪切其他皮带的长度。

B轴皮带穿行路线 | WWW.VORONDESIGN.COM

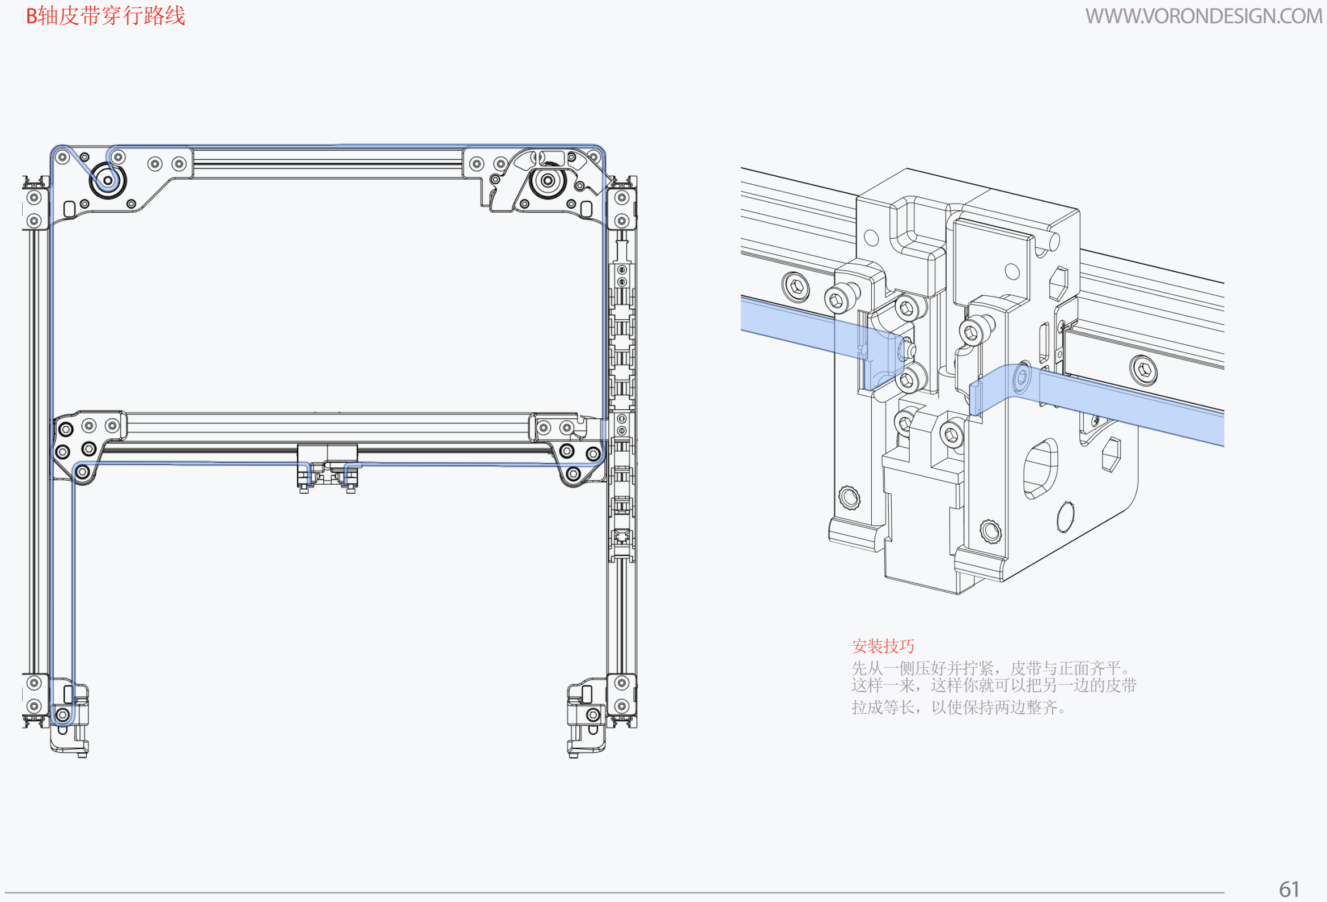
[picture p203: page 61]

61

先从一侧压好并拧紧，皮带与正面齐平。 这样一来，这样你就可以把另一边的皮带

拉成等长，以使保持两边整齐。

安装技巧

## WWW.VORONDESIGN.COM

## 喷头散热端和风扇罩

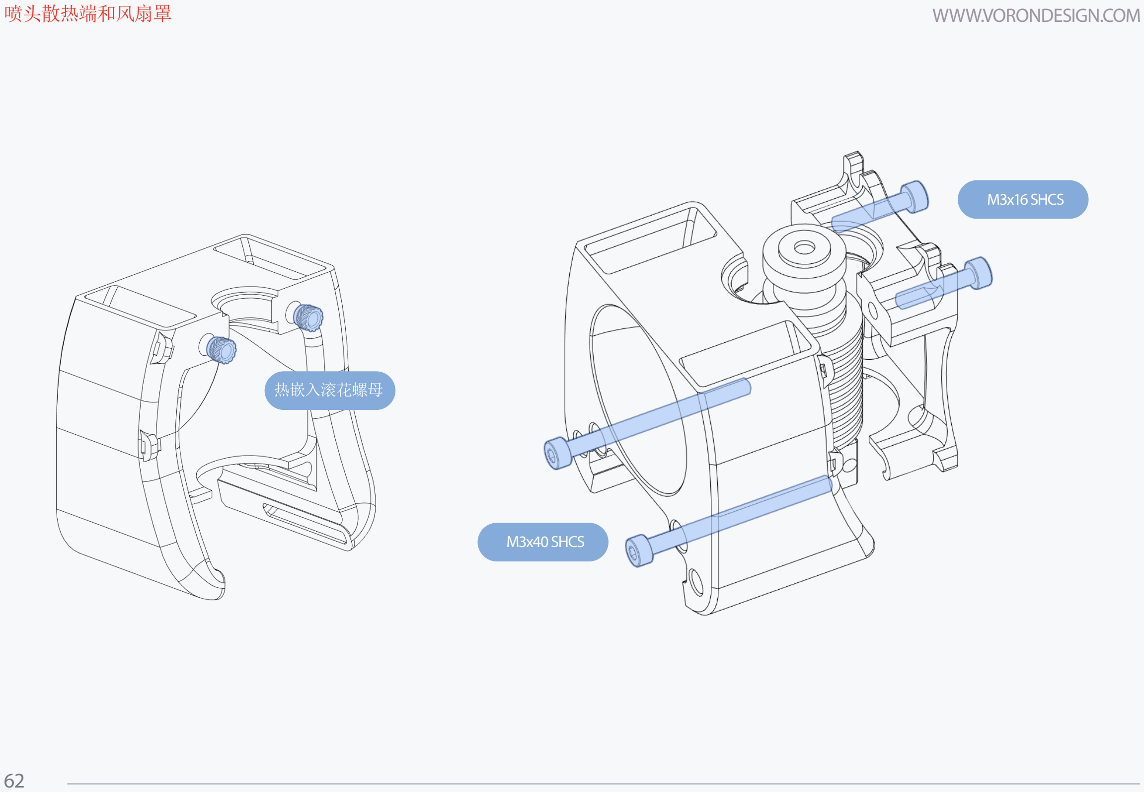
[picture p204: page 62]

62

## M3x40 SHCS

## M3x16 SHCS

热嵌入滚花螺母

## WWW.VORONDESIGN.COM

## 散热模组安装

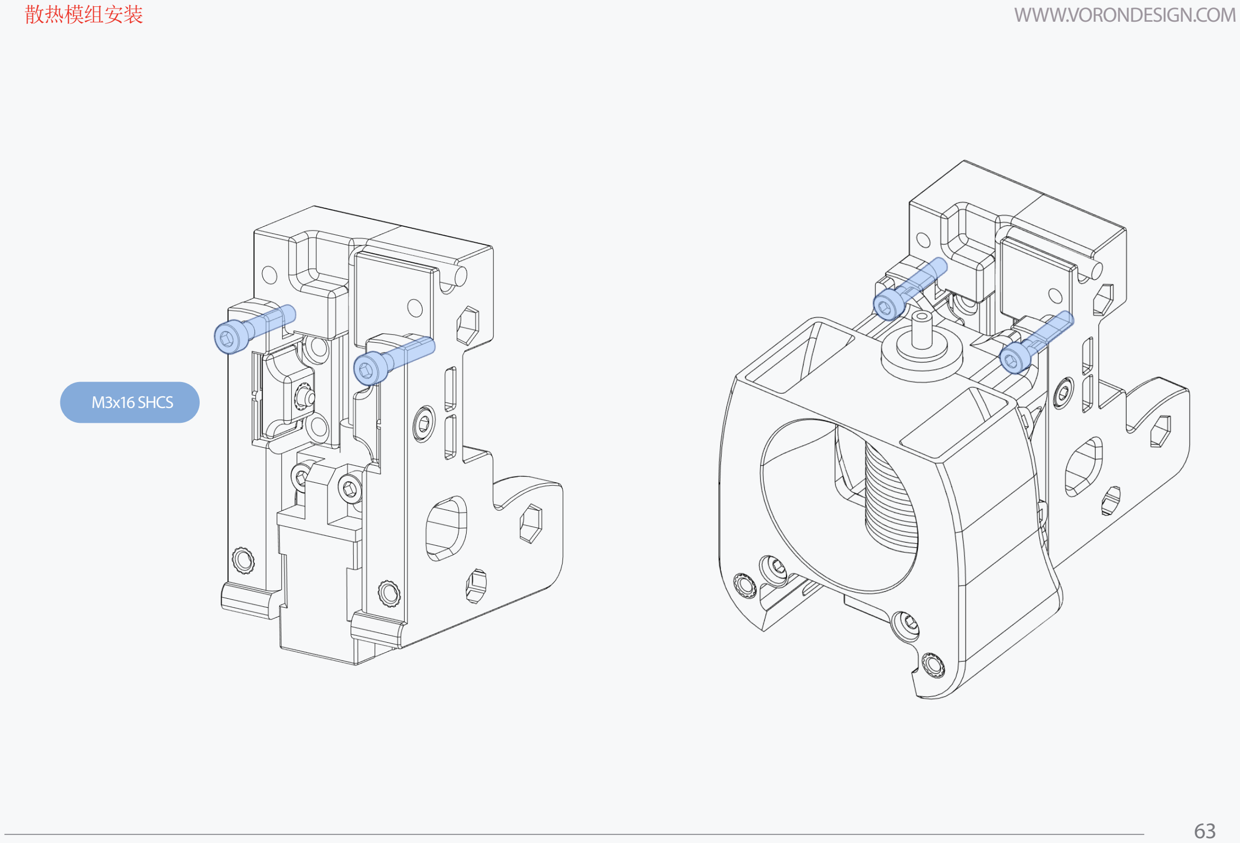
[picture p205: page 63]

63

## M3x16 SHCS

挤出机齿轮箱 | WWW.VORONDESIGN.COM

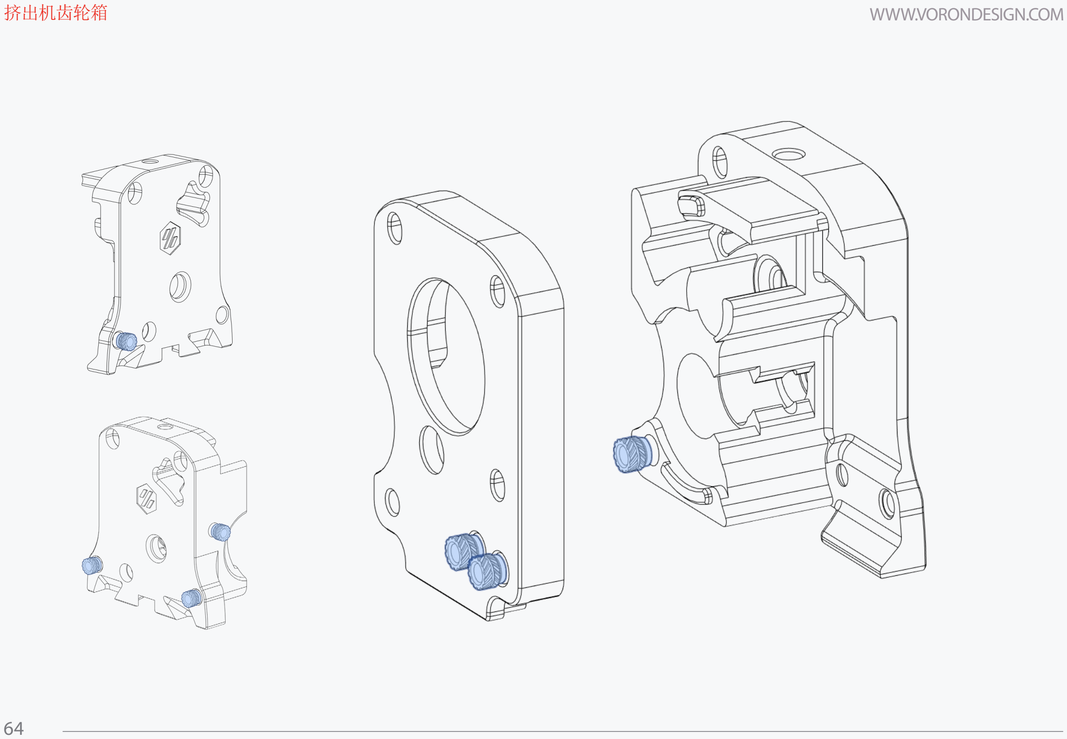
[picture p206: page 64]

64

65

挤出机闩锁 | WWW.VORONDESIGN.COM

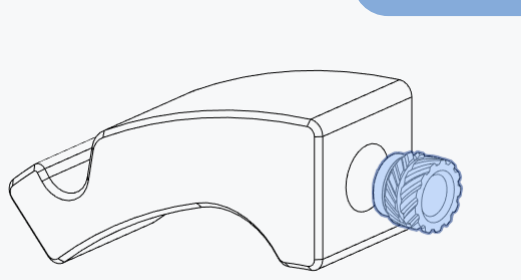
[picture p207: figure]
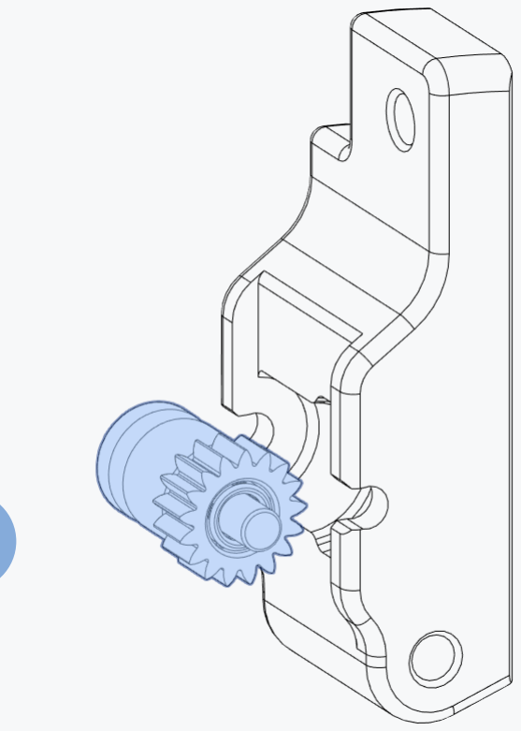
[picture p208: figure]

挤出机惰轮

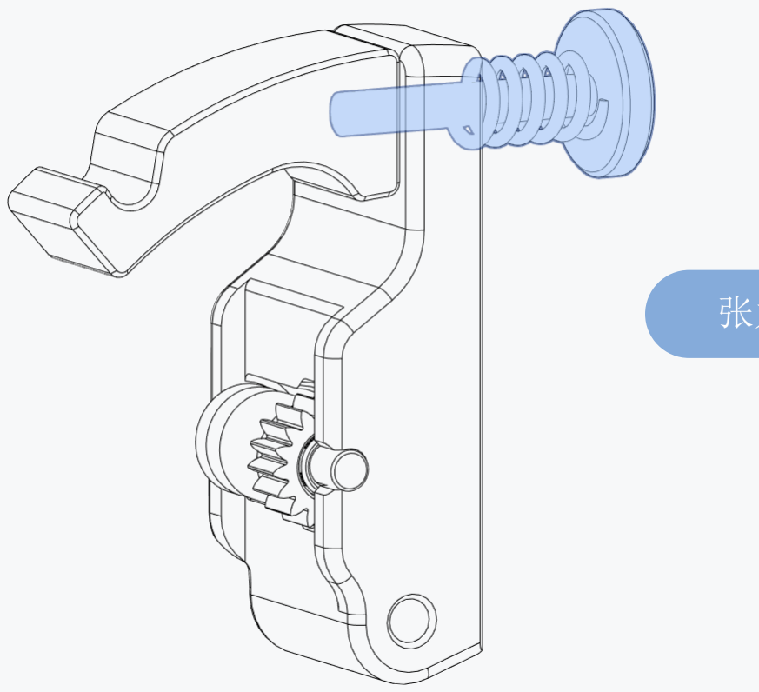
[picture p209: figure]

张力旋钮

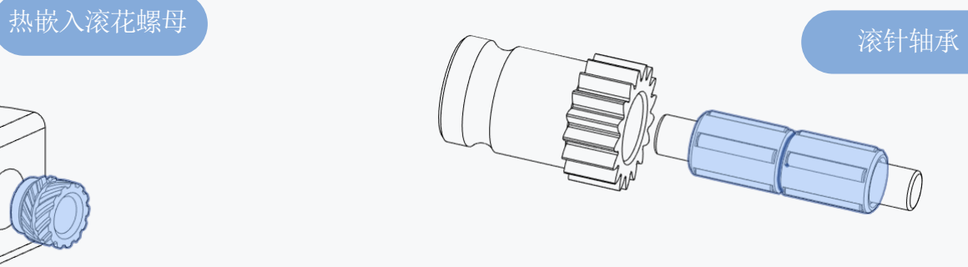
[picture p210: figure]
滚针轴承 热嵌入滚花螺母

## WWW.VORONDESIGN.COM

## 步进齿轮组

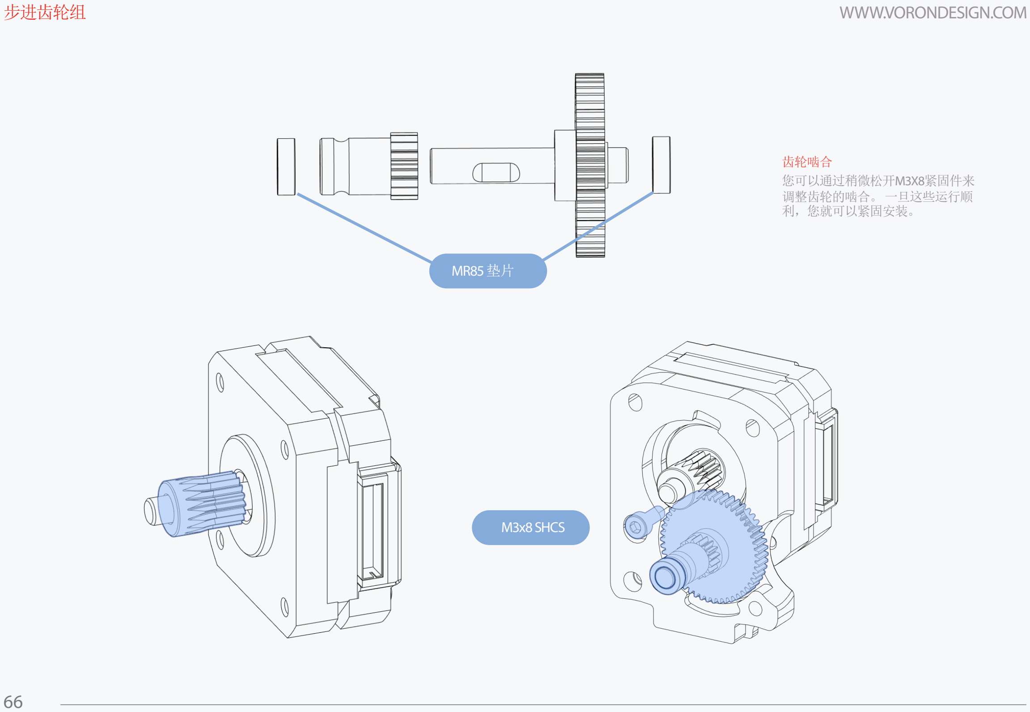
[picture p211: page 66]

66

## M3x8 SHCS

## MR85垫片

您可以通过稍微松开M3X8紧固件来
调整齿轮的啮合。一旦这些运行顺
利，您就可以紧固安装。

齿轮啮合

## WWW.VORONDESIGN.COM

## 齿轮箱

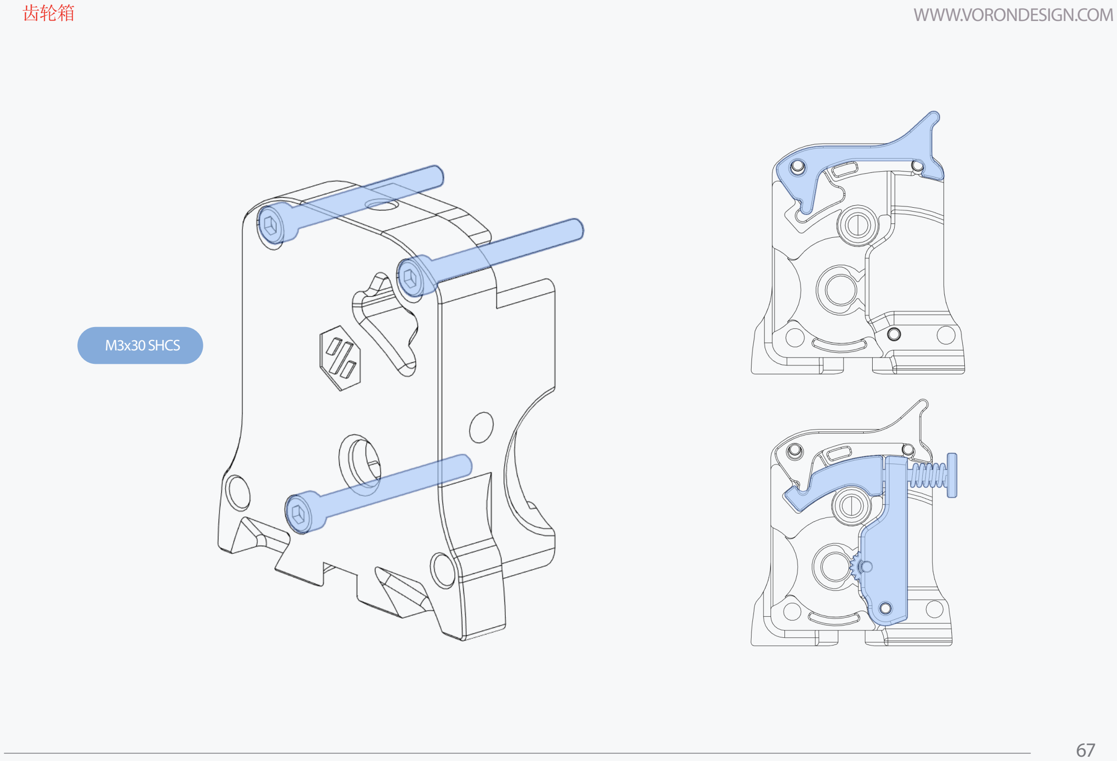
[picture p212: page 67]

67

## M3x30 SHCS

冷却风扇 | WWW.VORONDESIGN.COM

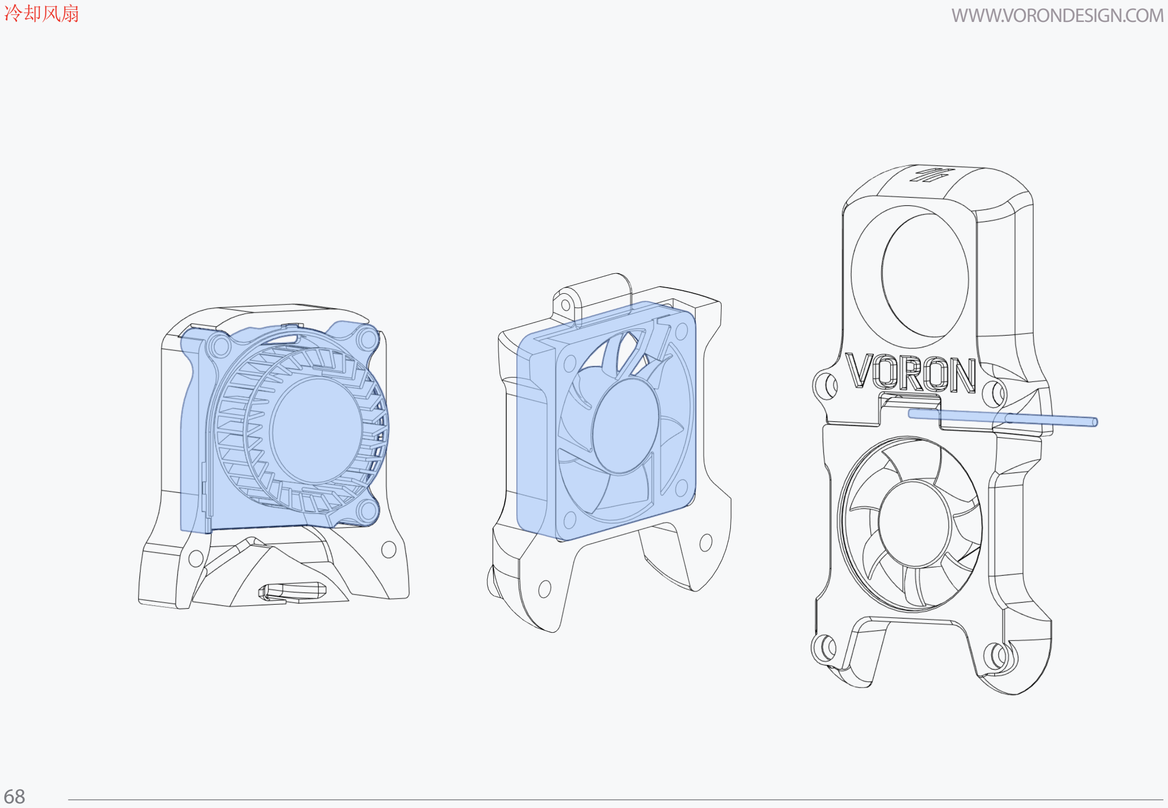
[picture p213: page 68]

68

## WWW.VORONDESIGN.COM

## 两组冷却扇总装

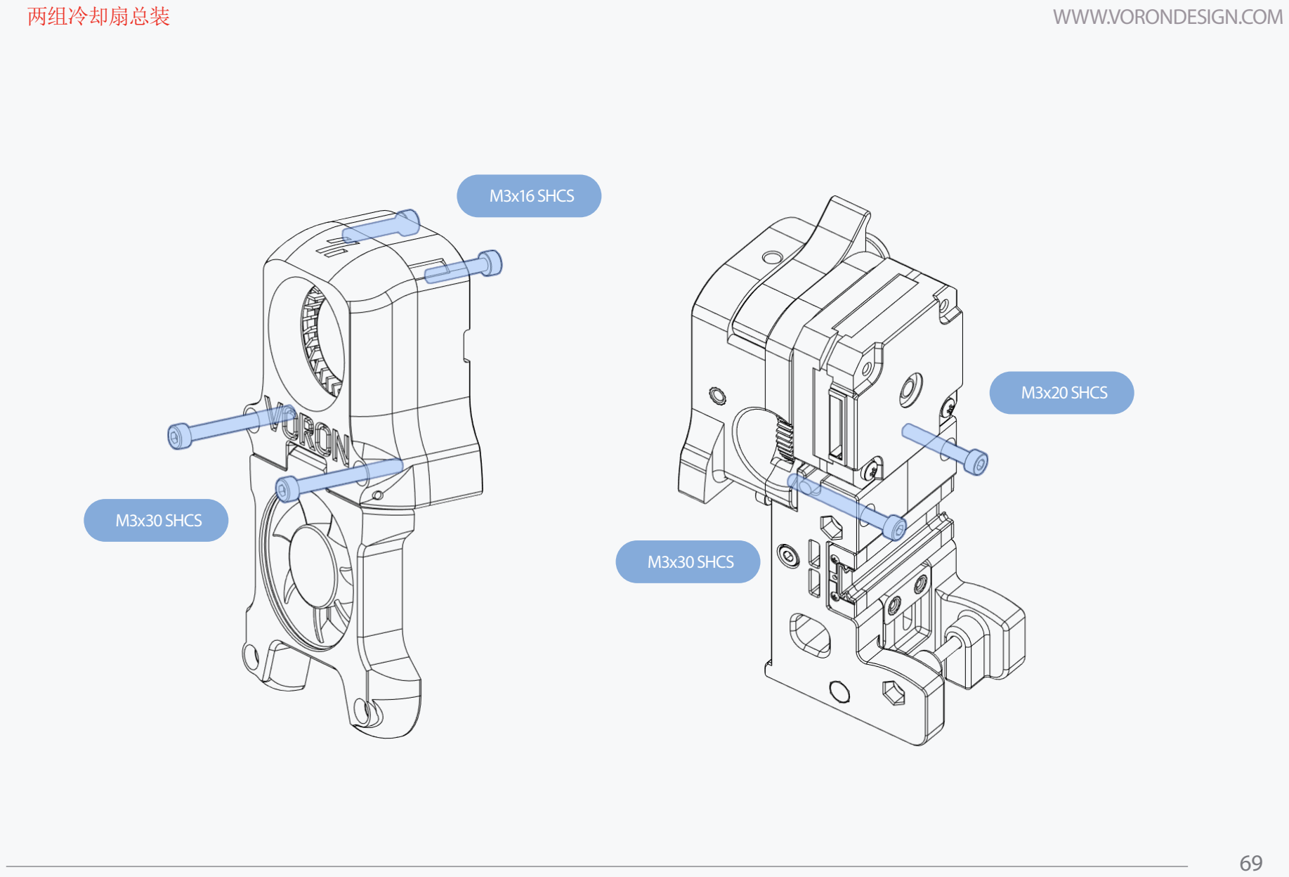
[picture p214: page 69]

69

## M3x30 SHCS

## M3x16 SHCS

## M3x20 SHCS

## M3x30 SHCS

70

## WWW.VORONDESIGN.COM

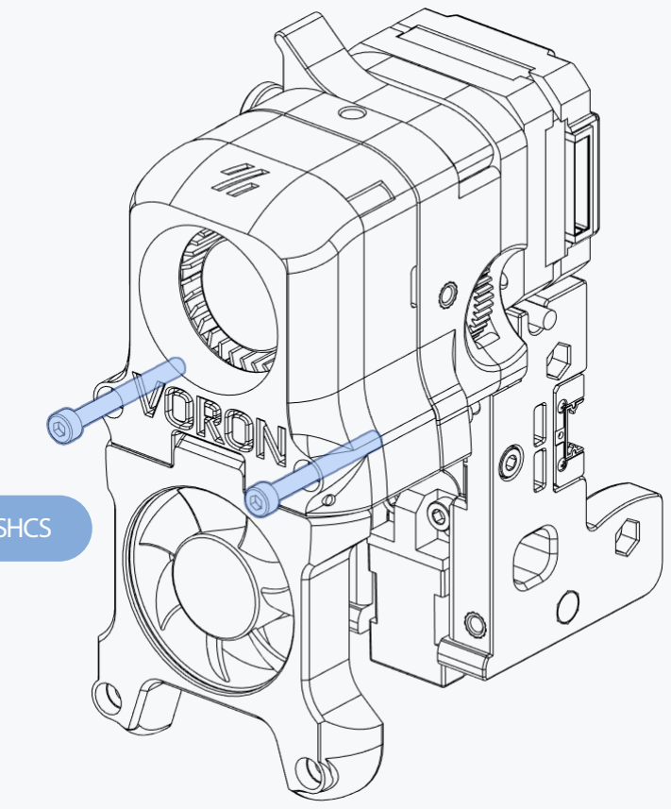
[picture p215: figure]

## M3x30 SHCS

## 安装风扇组总成

## WWW.VORONDESIGN.COM

## 电缆拖链固定支架安装

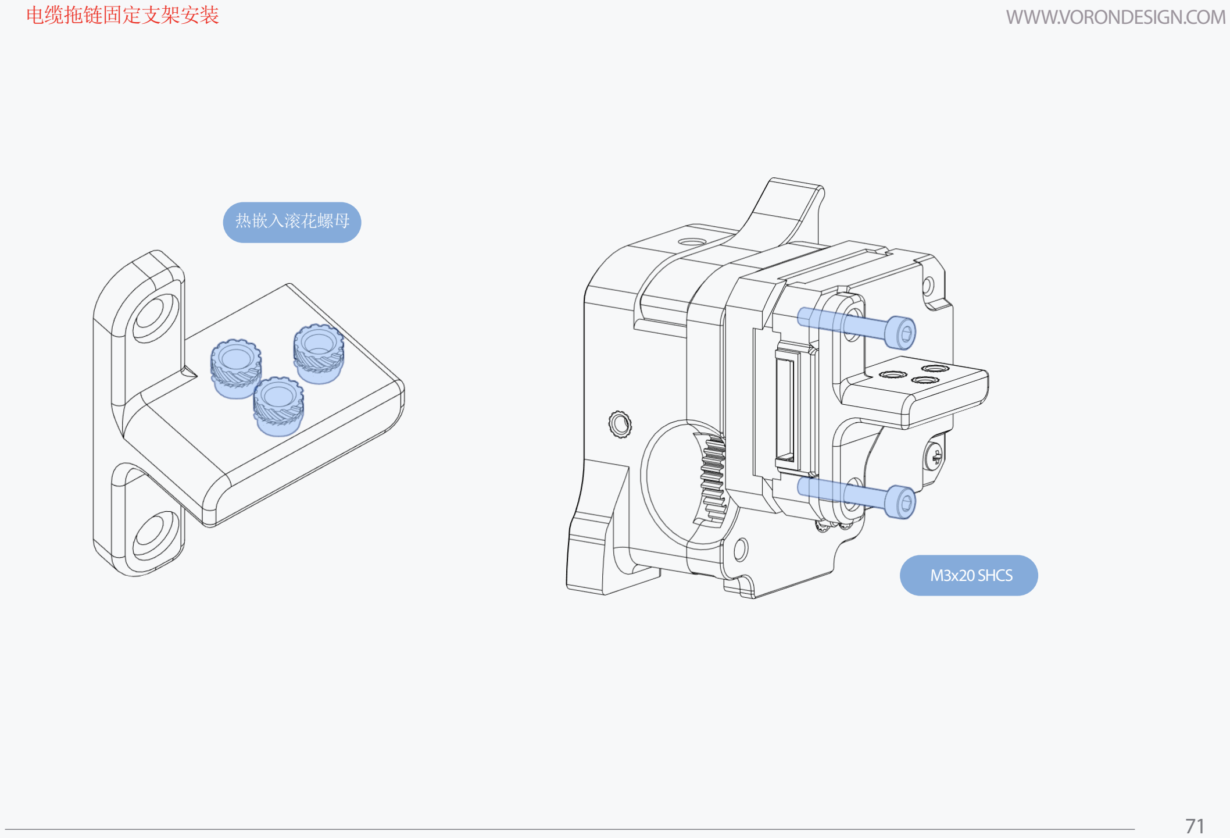
[picture p216: page 71]

71

## M3x20 SHCS

热嵌入滚花螺母

热端喷头模块安装 | WWW.VORONDESIGN.COM

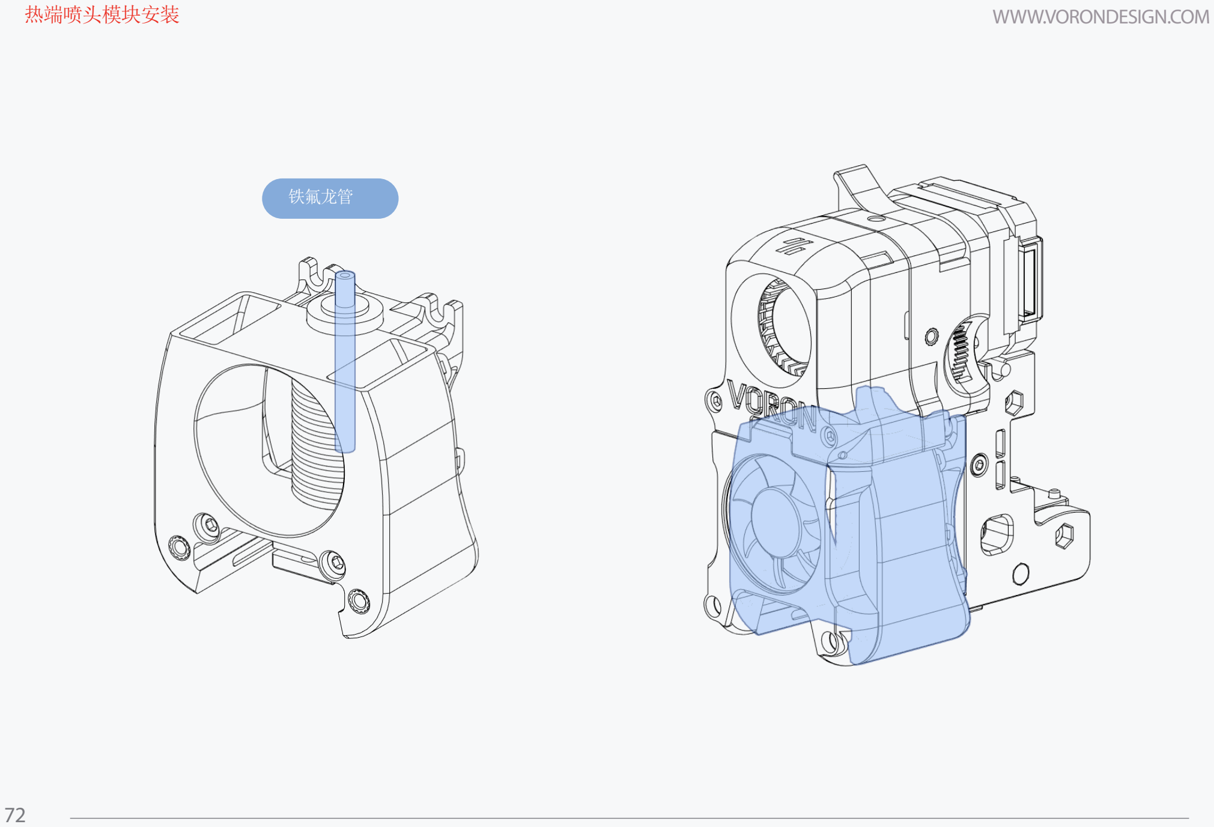
[picture p217: page 72]

72

铁氟龙管

73

## WWW.VORONDESIGN.COM

再次来到了放空自己的时候......

74

Z轴驱动组 | WWW.VORONDESIGN.COM

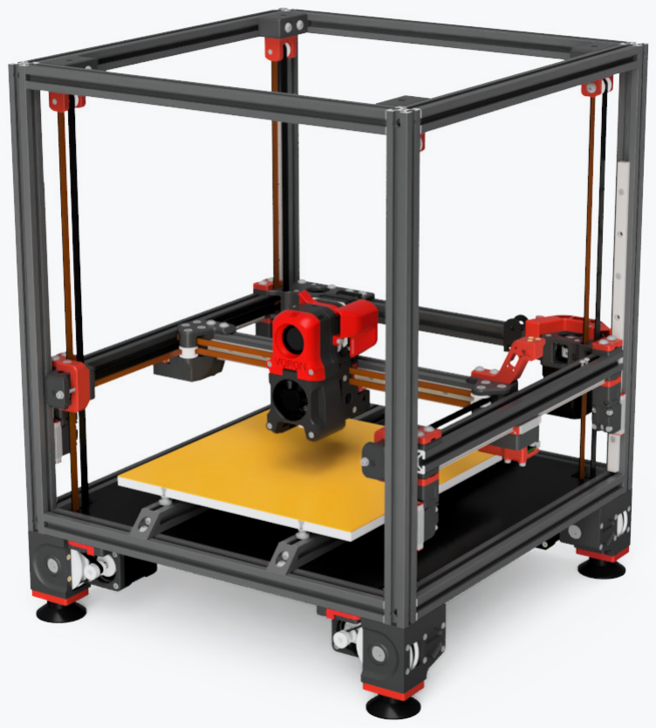
[picture p218: figure]

75

## WWW.VORONDESIGN.COM

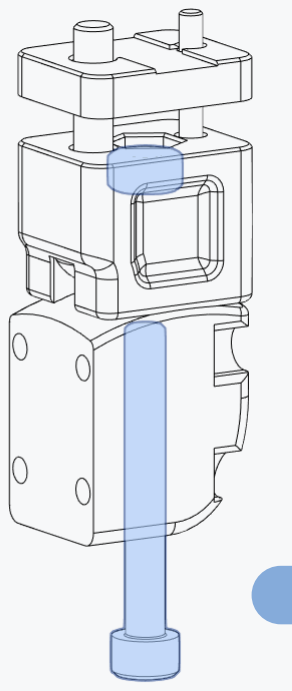
[picture p219: figure]
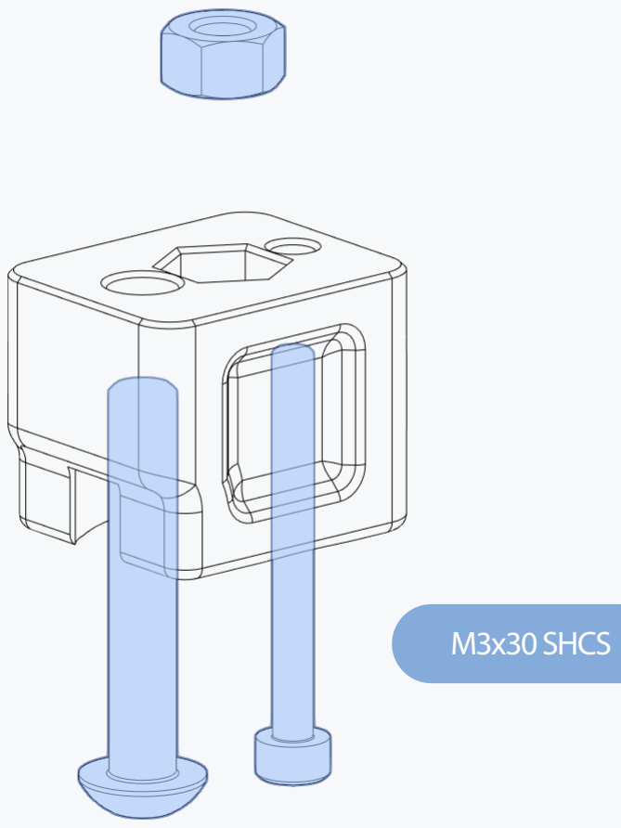
[picture p220: figure]
M3x30 SHCS

## M5x30 BHCS

## M5x40 SHCS

M5六角螺母

## Z轴关节

皮带穿行路线 | WWW.VORONDESIGN.COM

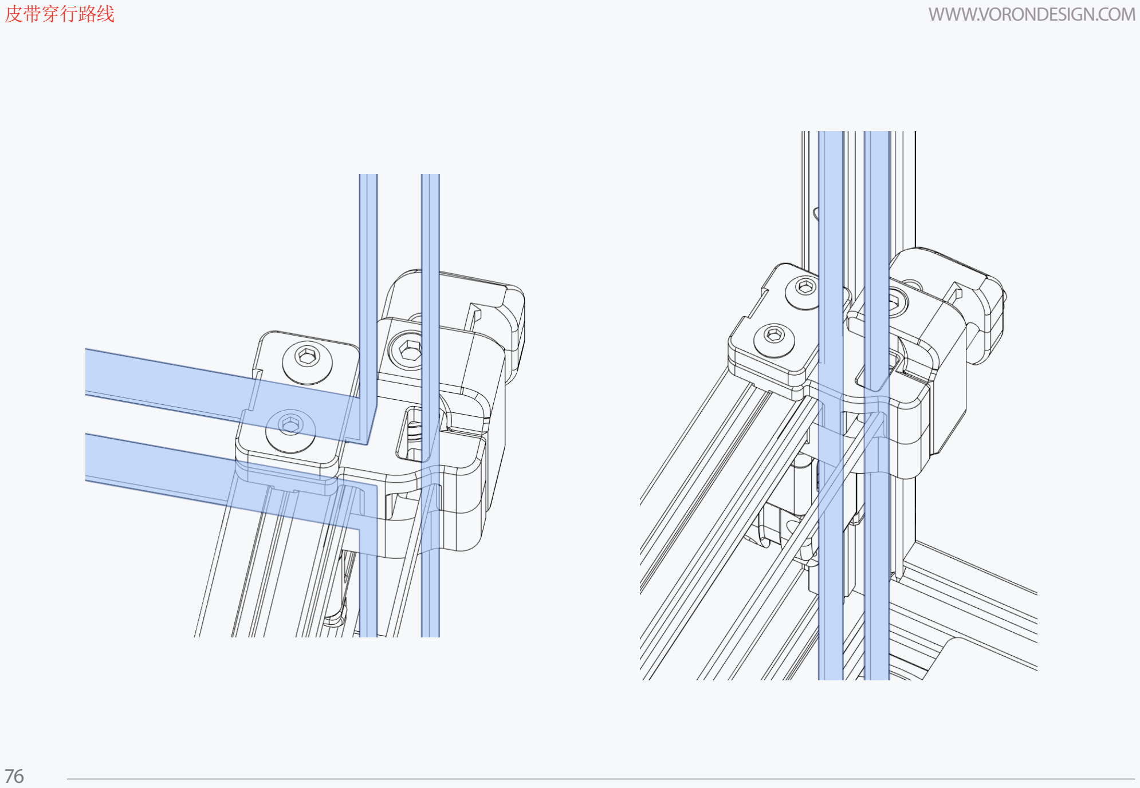
[picture p221: page 76]

76

77

## WWW.VORONDESIGN.COM

## 将Z轴滑动块安装到导轨滑块上

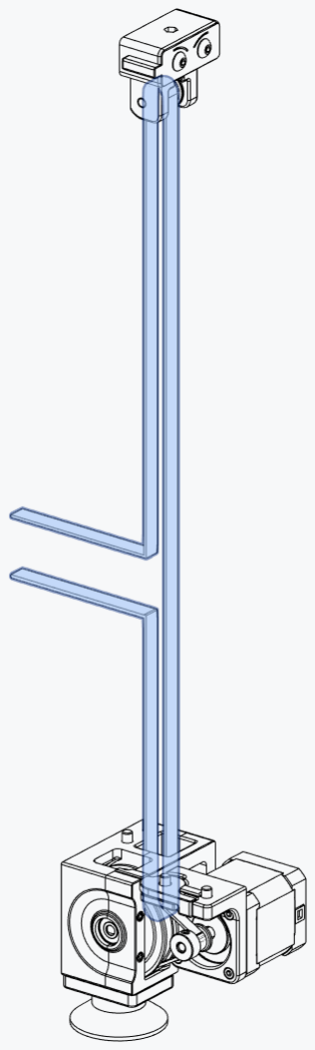
[picture p222: figure]
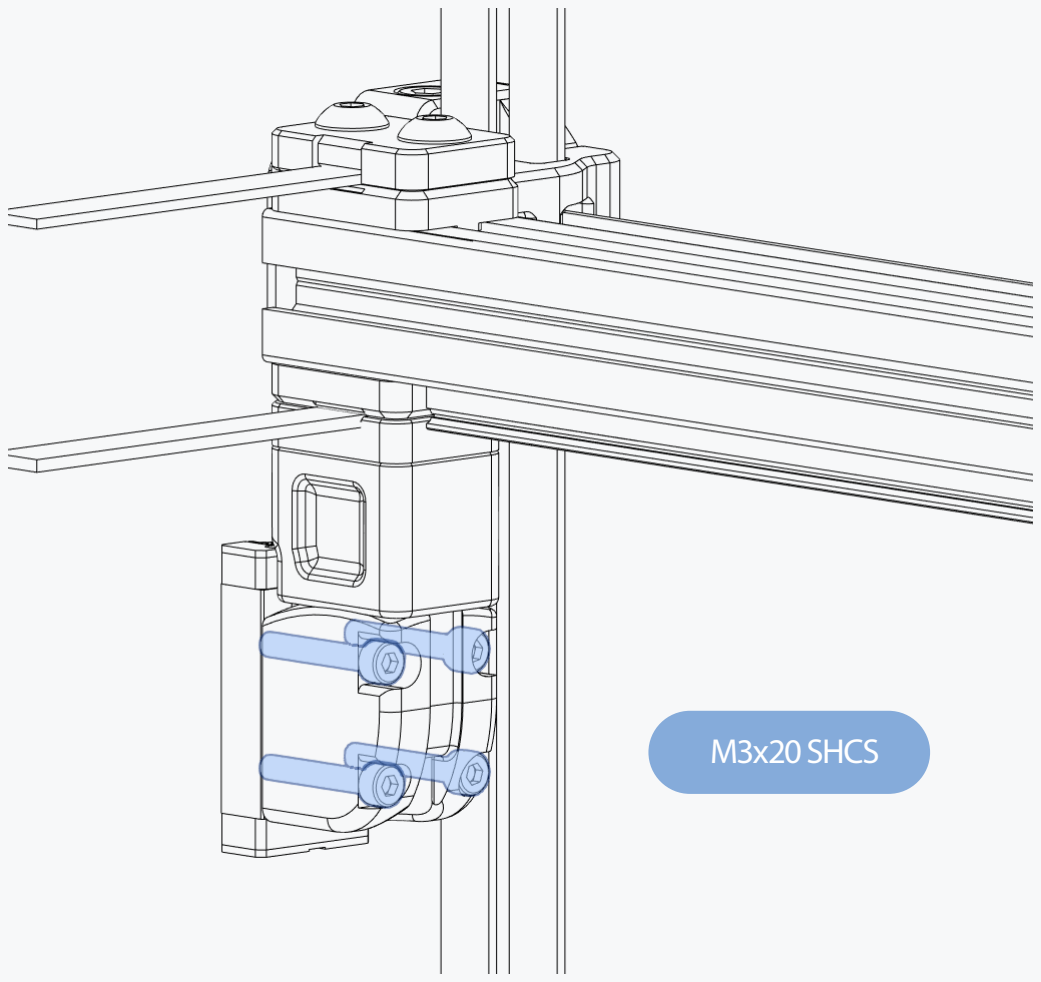
[picture p223: figure]
M3x20 SHCS

78

液晶模组 | WWW.VORONDESIGN.COM

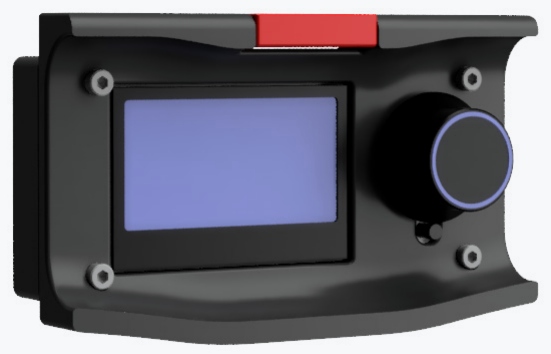
[picture p224: figure]

热嵌入滚花螺母 | WWW.VORONDESIGN.COM

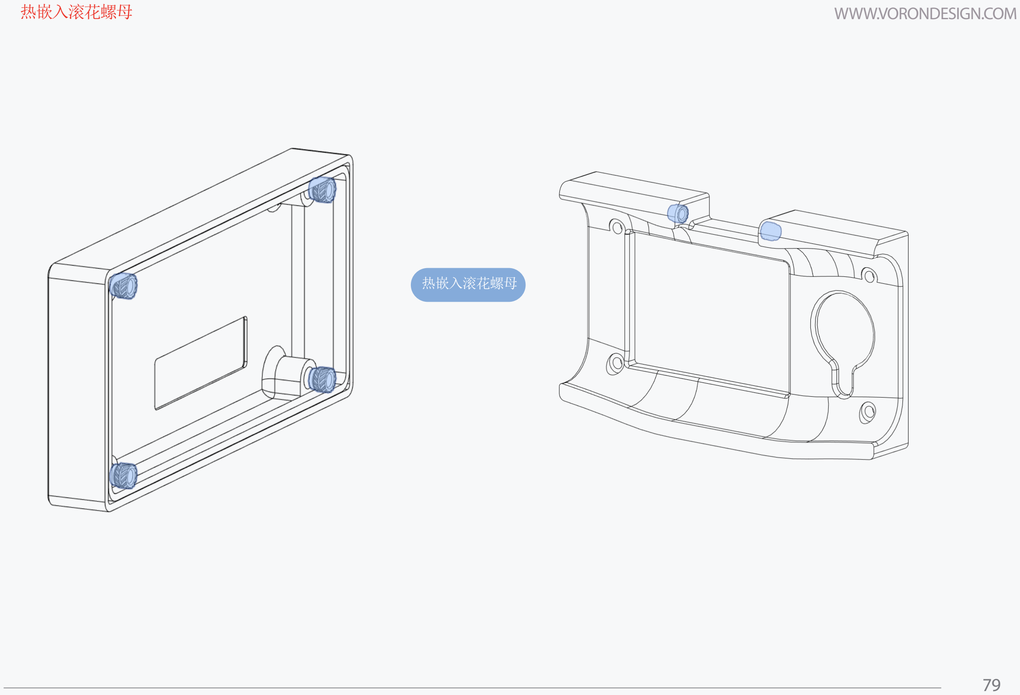
[picture p225: page 79]

79

热嵌入滚花螺母

## WWW.VORONDESIGN.COM

## 液晶外壳垫圈

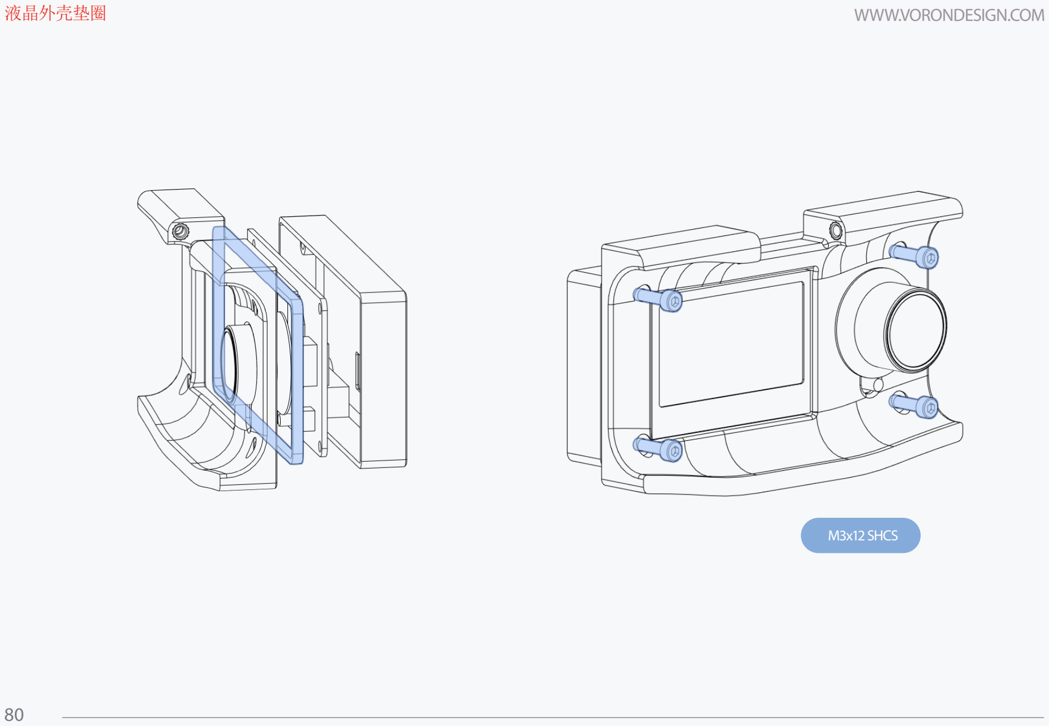
[picture p226: page 80]

80

## M3x12 SHCS

## WWW.VORONDESIGN.COM

## 液晶模组安装块

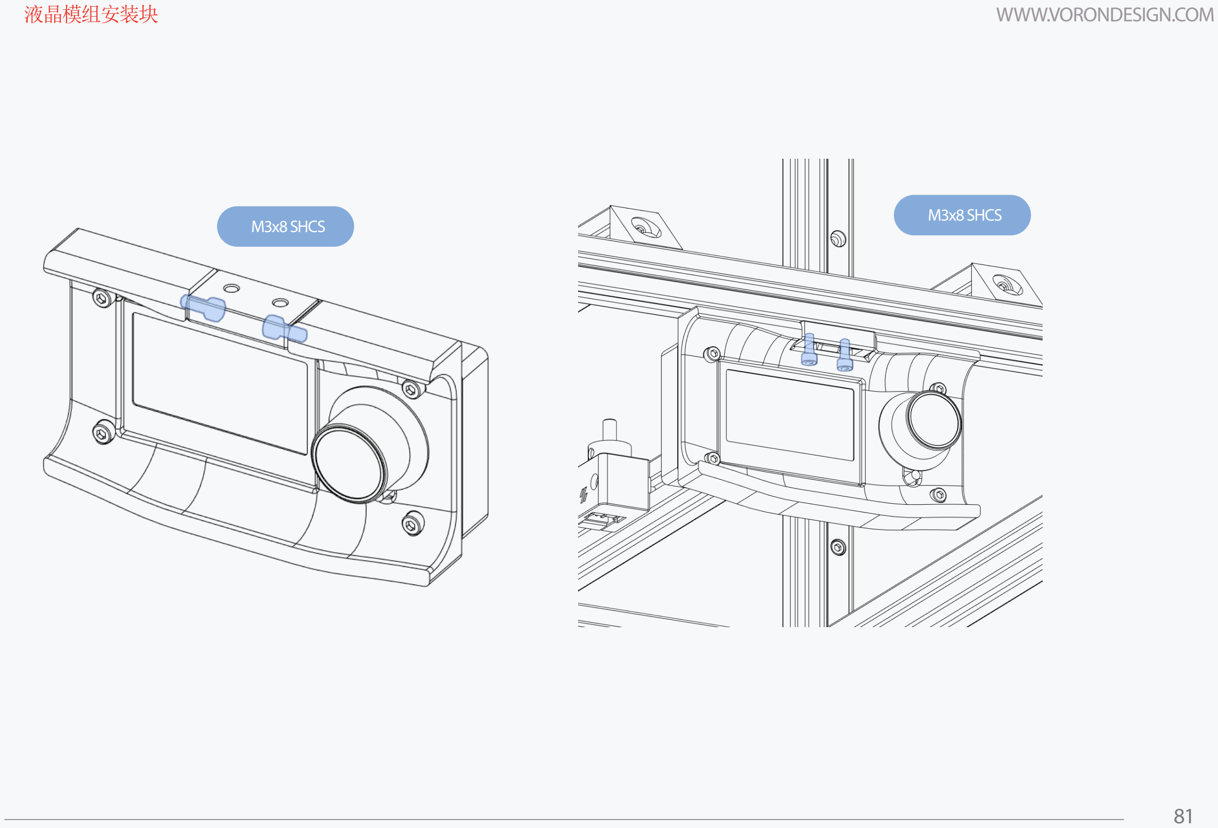
[picture p227: page 81]

81

M3x8 SHCS | M3x8 SHCS

82

整机底部裙边结构一览 | WWW.VORONDESIGN.COM

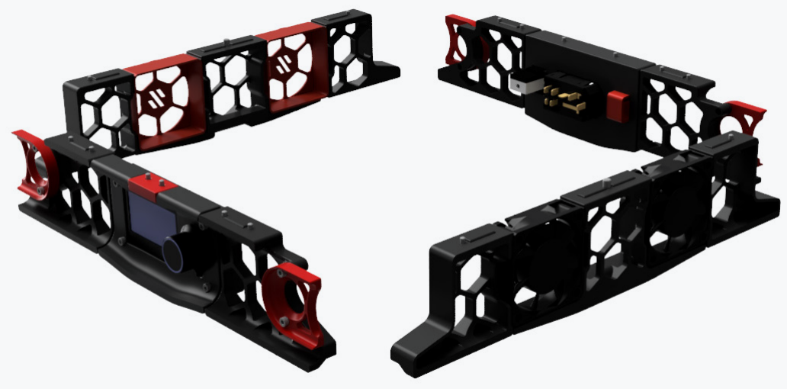
[picture p228: figure]

83

总电源插口 | WWW.VORONDESIGN.COM

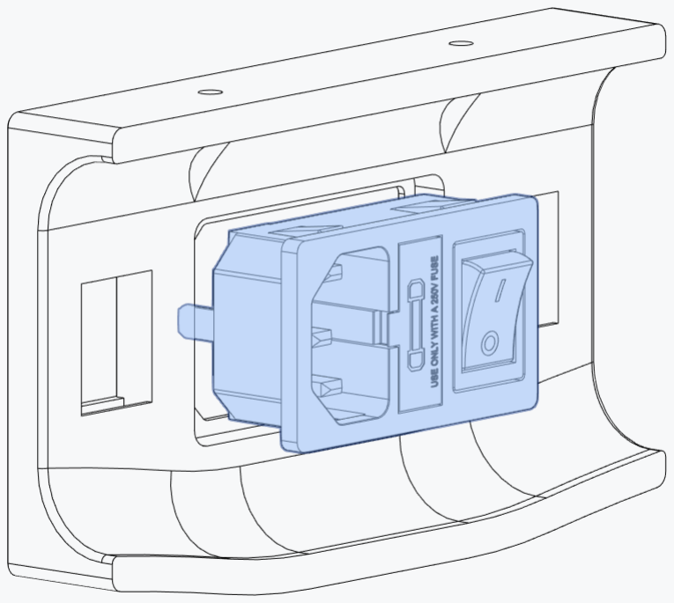
[picture p229: figure]

可选的RJ45接口 | WWW.VORONDESIGN.COM

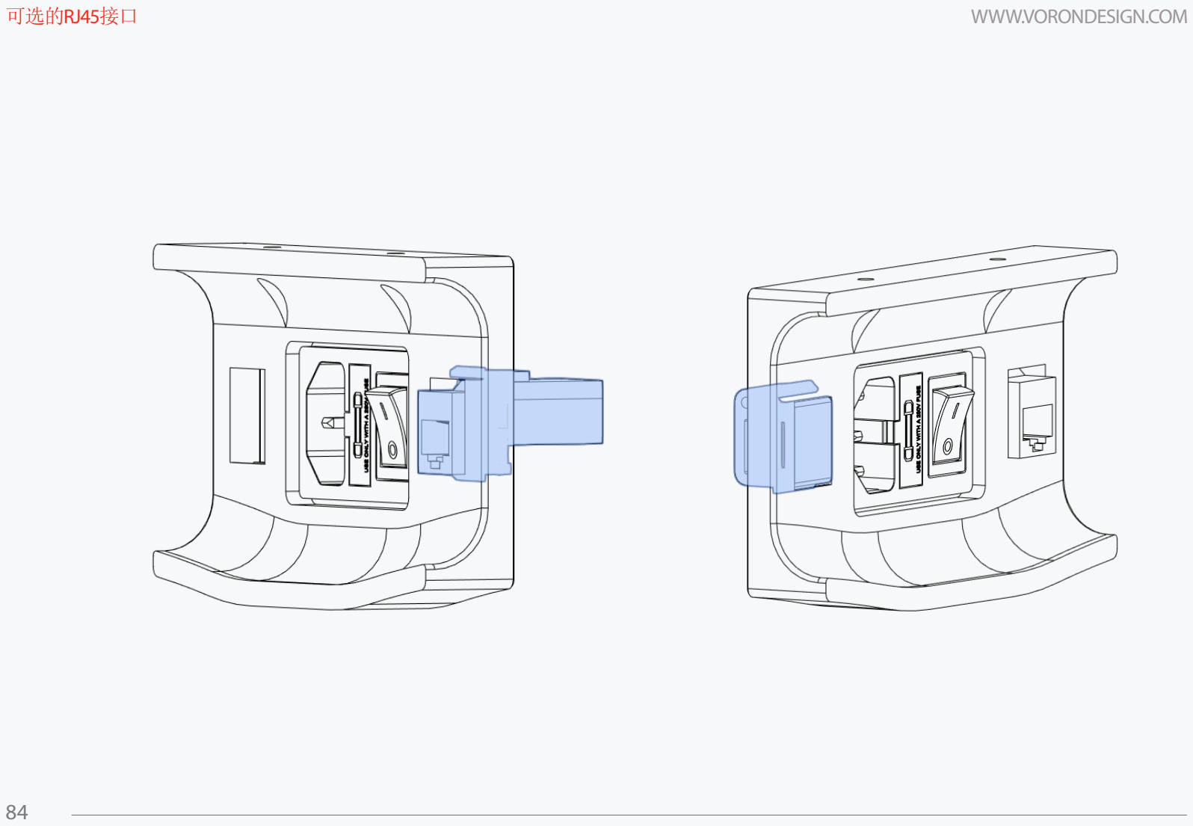
[picture p230: page 84]

84

85

## WWW.VORONDESIGN.COM

## 安装接口外壳

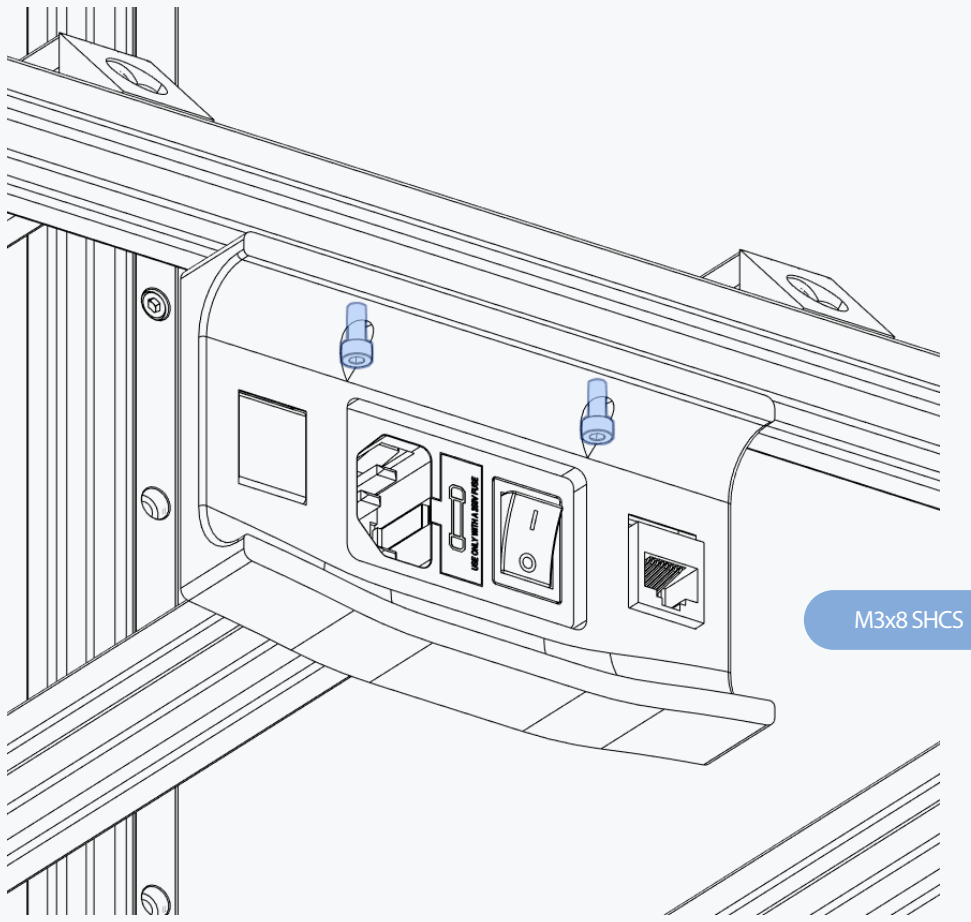
[picture p231: figure]
M3x8 SHCS

电路舱室冷却组件 | WWW.VORONDESIGN.COM

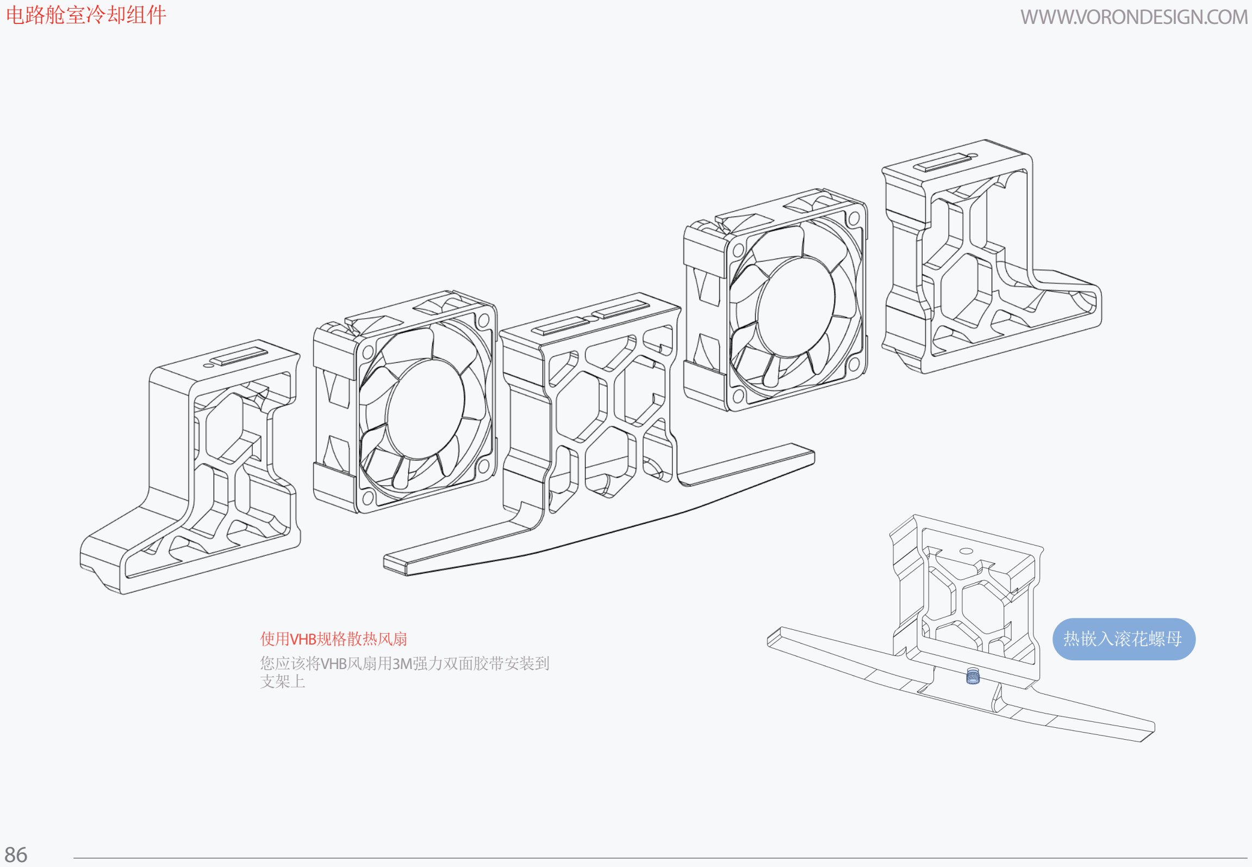
[picture p232: page 86]

86

使用VHB规格散热风扇 | 热嵌入滚花螺母
您应该将VHB风扇用3M强力双面胶带安装到
支架上

## WWW.VORONDESIGN.COM

## 安装电路舱室冷却总成

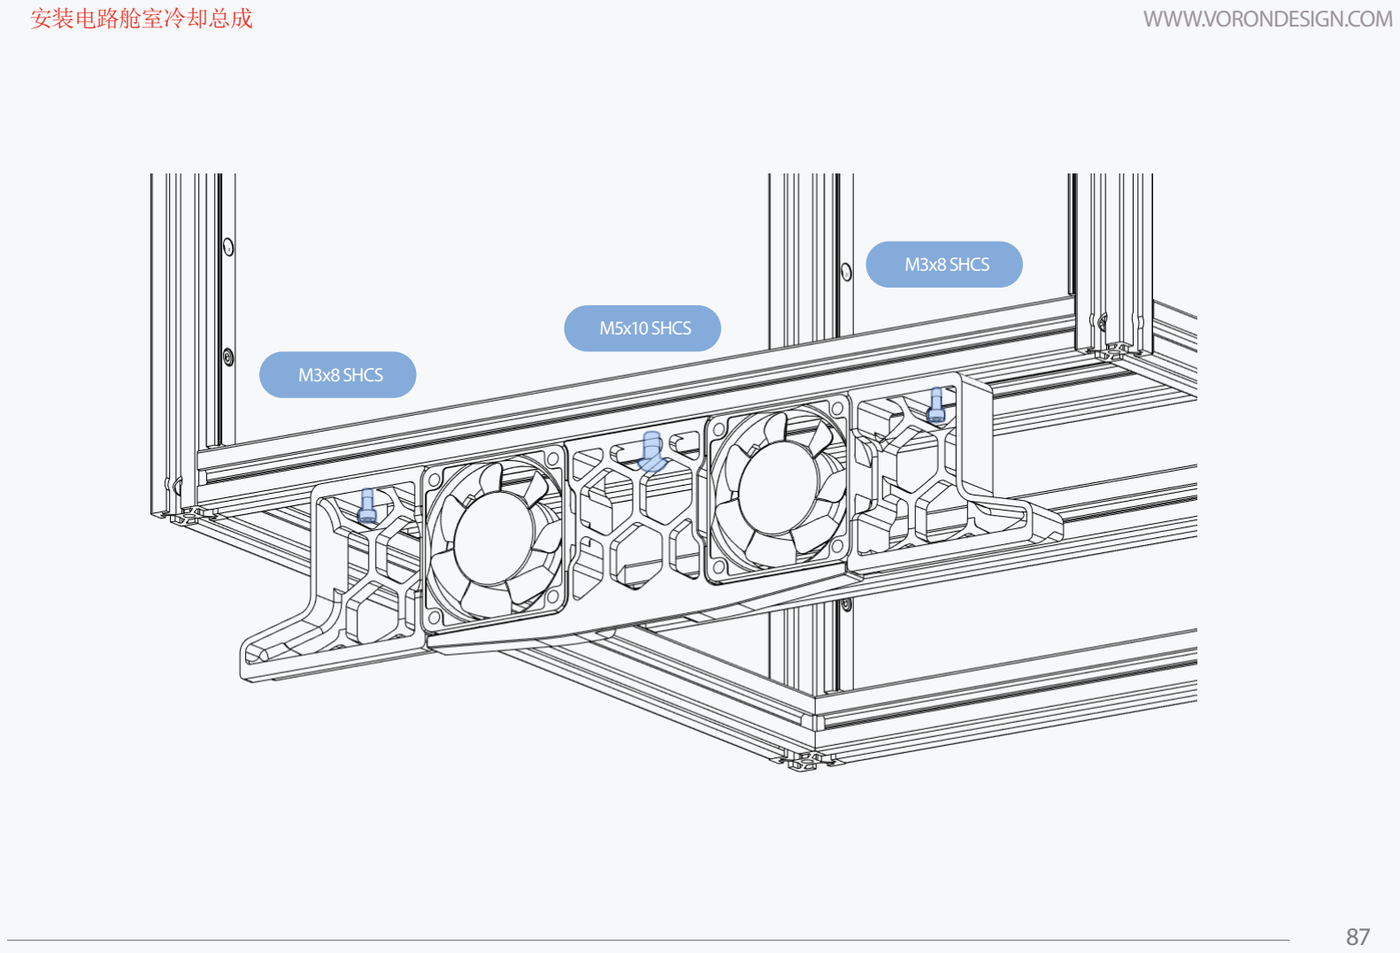
[picture p233: page 87]

87

## M3x8 SHCS

## M3x8 SHCS

## M5x10 SHCS

## WWW.VORONDESIGN.COM

## Z轴同步轮装饰盖

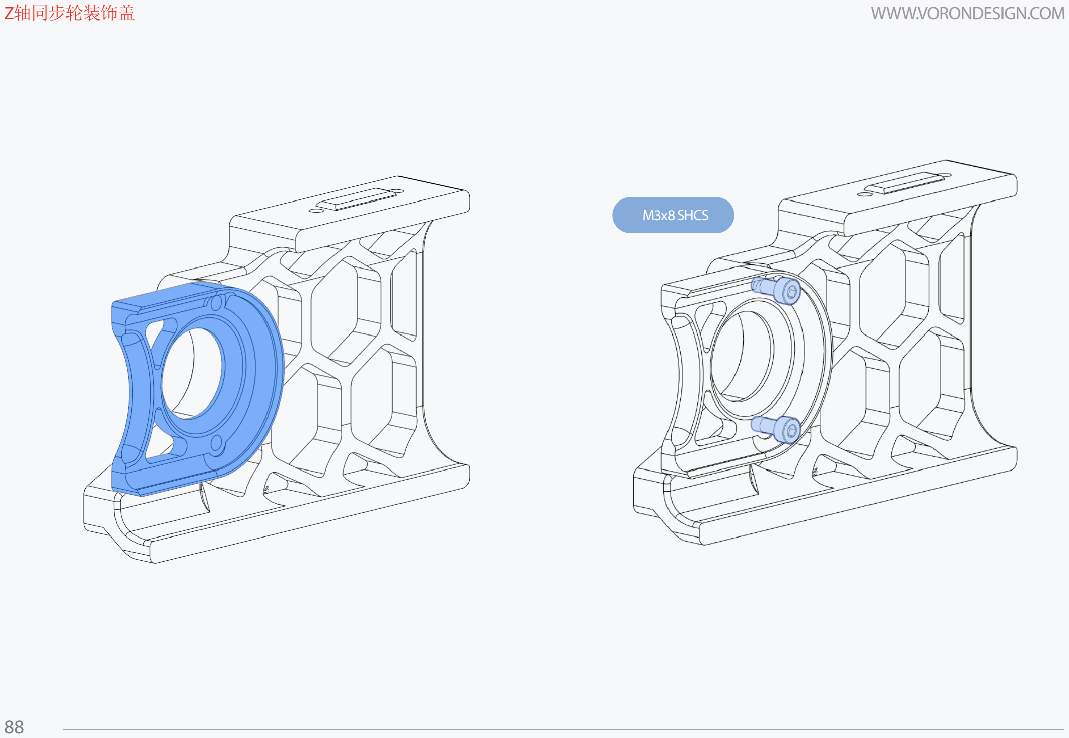
[picture p234: page 88]

88

## M3x8 SHCS

89

## WWW.VORONDESIGN.COM

休息一会，欣赏自己阶段性胜利的时间

90

保温仓外板 | WWW.VORONDESIGN.COM

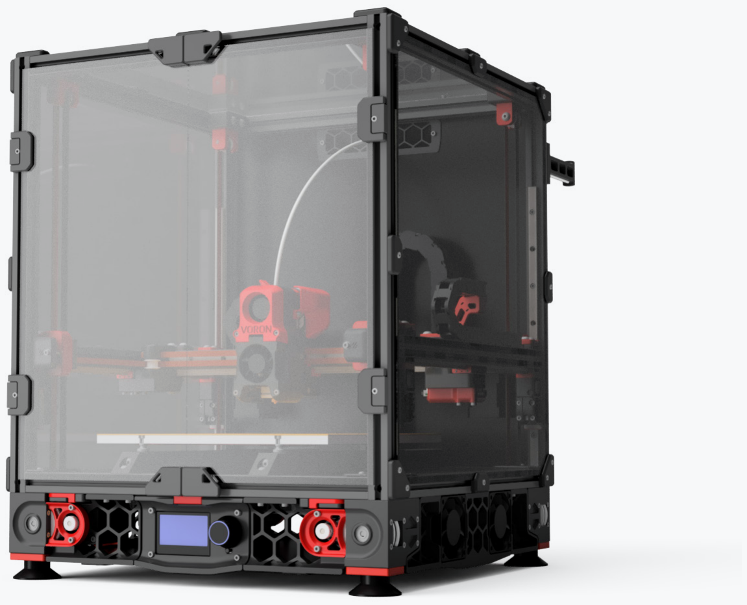
[picture p235: figure]

91

## WWW.VORONDESIGN.COM

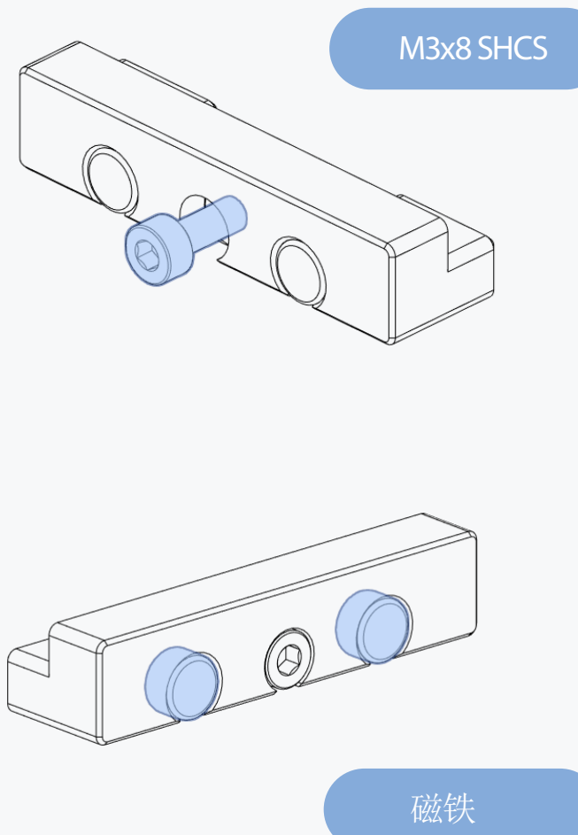
[picture p236: figure]
M3x8 SHCS
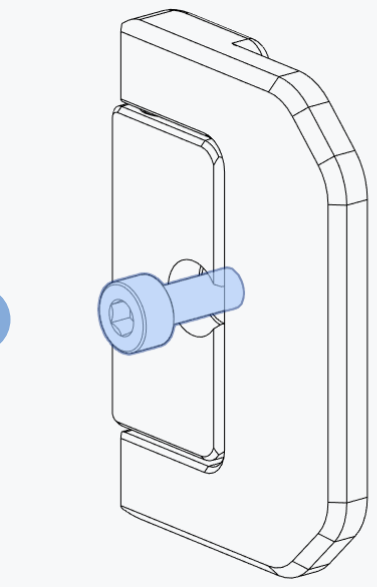
[picture p237: figure]

## M3x8 SHCS

## 对开门配件组

前门 | WWW.VORONDESIGN.COM

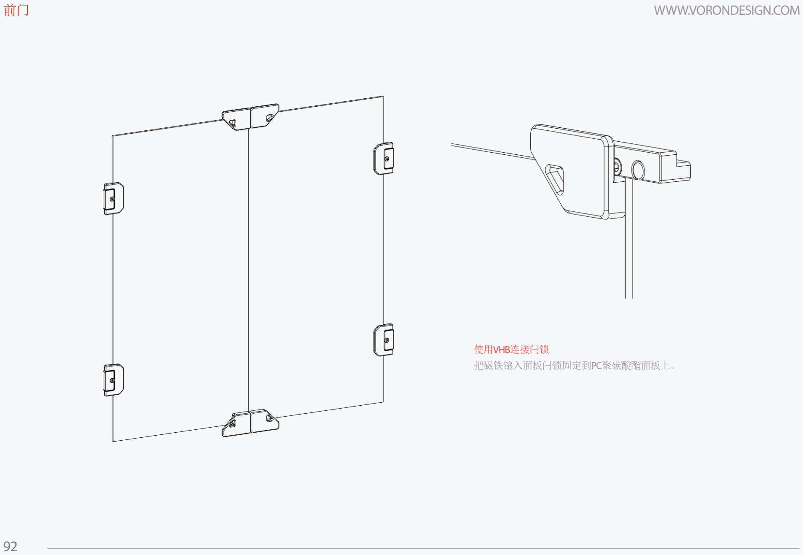
[picture p238: page 92]

92

使用VHB连接闩锁
把磁铁镶入面板闩锁固定到PC聚碳酸酯面板上。

## WWW.VORONDESIGN.COM

## 顶部面板

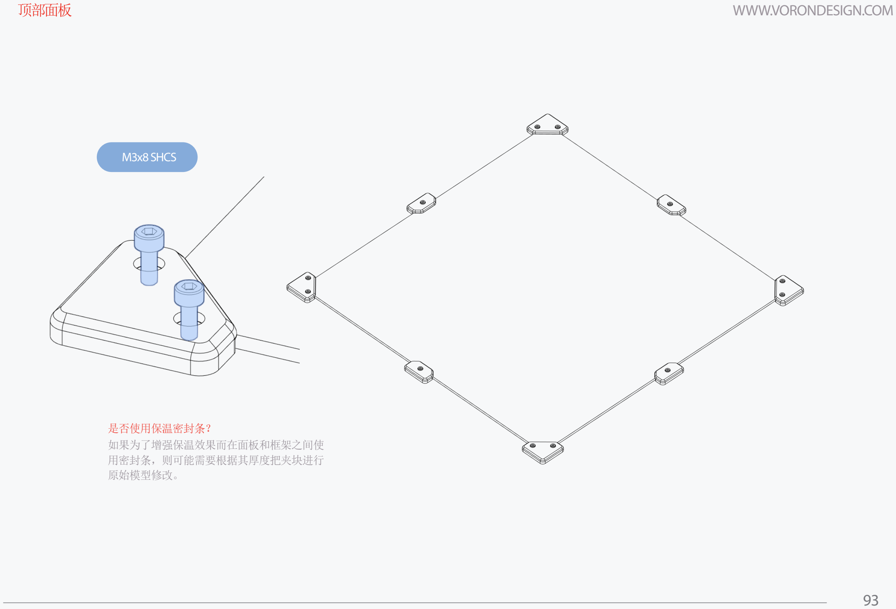
[picture p239: page 93]

93

## M3x8 SHCS

如果为了增强保温效果而在面板和框架之间使
用密封条，则可能需要根据其厚度把夹块进行
原始模型修改。

是否使用保温密封条？

侧板和后面板 | WWW.VORONDESIGN.COM

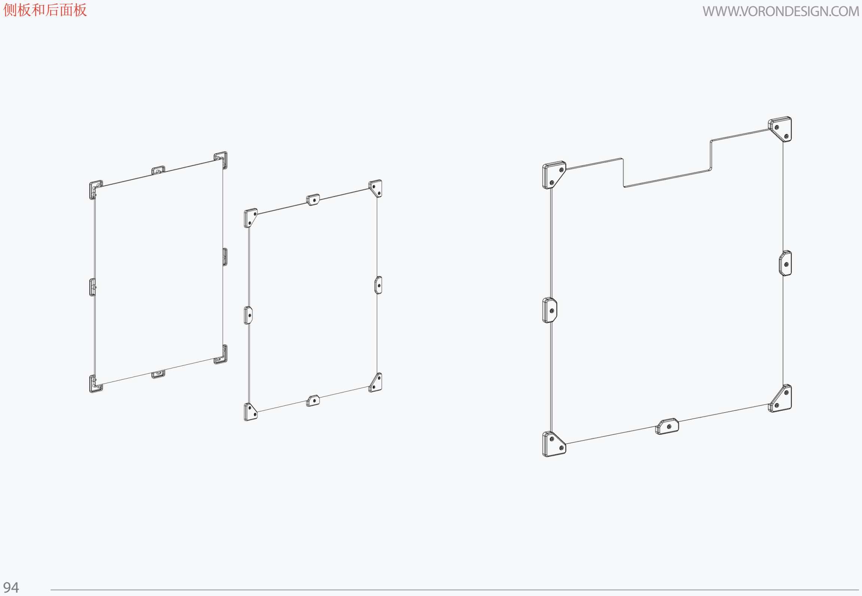
[picture p240: page 94]

94

## WWW.VORONDESIGN.COM

## Z轴皮带出口保护罩

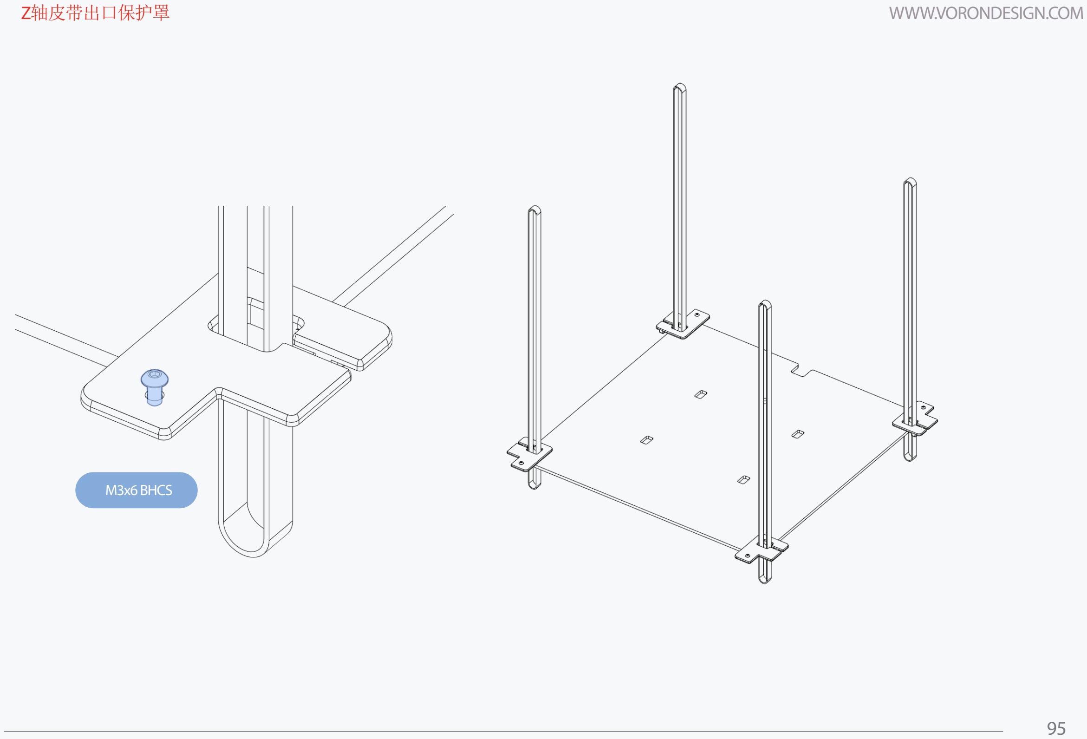
[picture p241: page 95]

95

## M3x6 BHCS

## WWW.VORONDESIGN.COM

## 底部面板

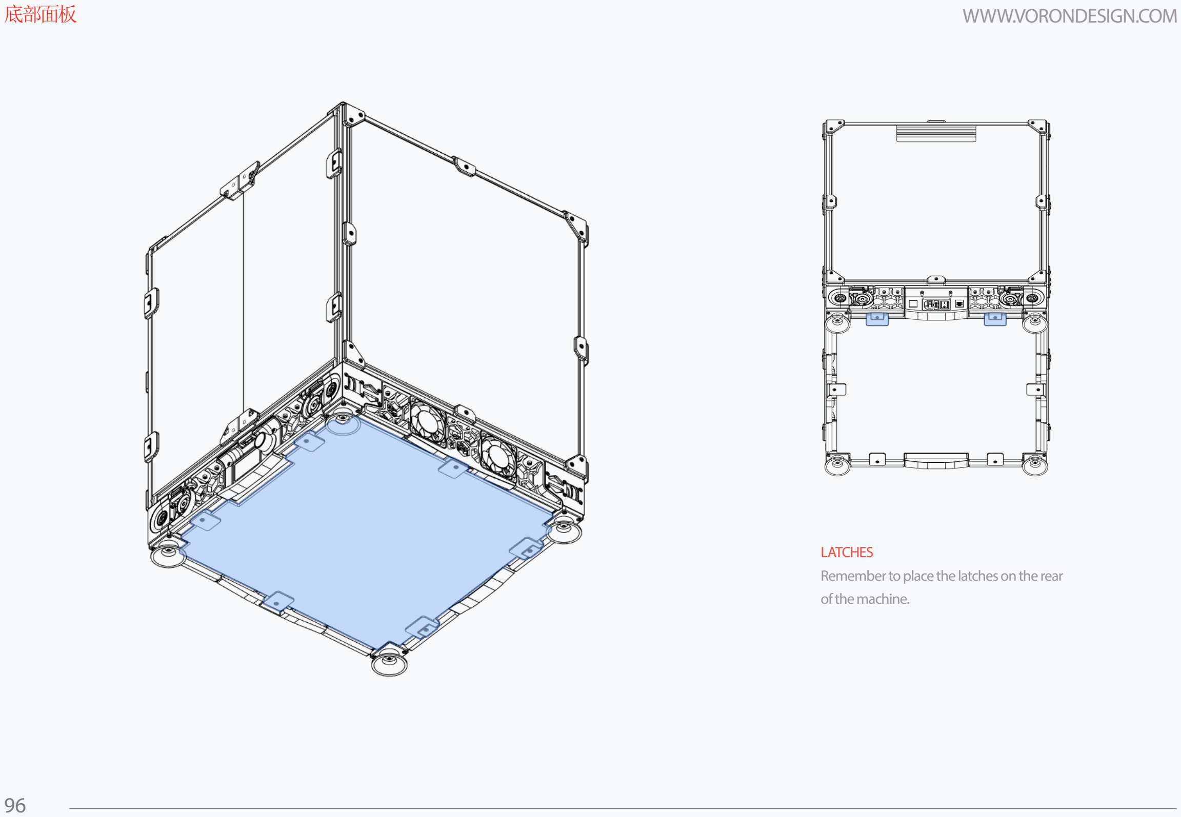
[picture p242: page 96]

96

### LATCHES Remember to place the latches on the rear

of the machine.

97

## WWW.VORONDESIGN.COM

注意保护身体，现在该休息了

98

卷材支架 | WWW.VORONDESIGN.COM

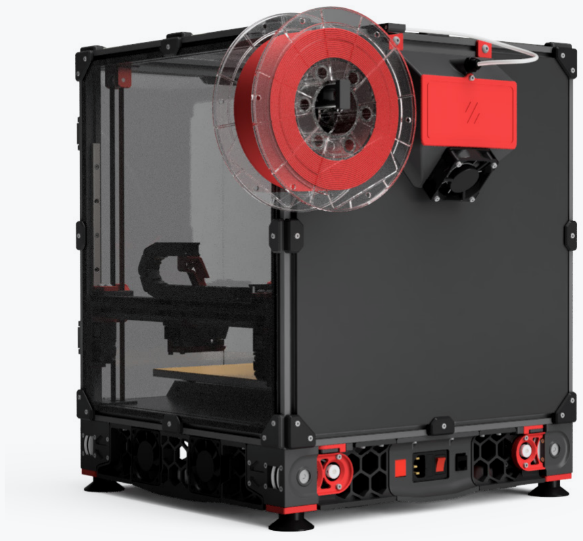
[picture p243: figure]

99

SPOOL HOLDER ASSEMBLY | WWW.VORONDESIGN.COM

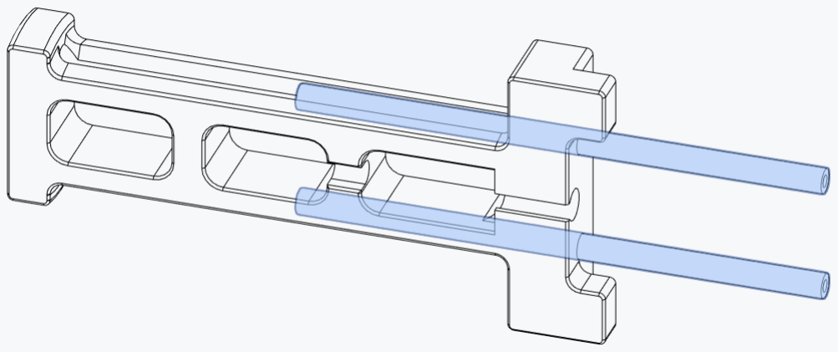
[picture p244: figure]

聚四氟乙烯嵌件

## WWW.VORONDESIGN.COM

## 卷材支架及线材定位框

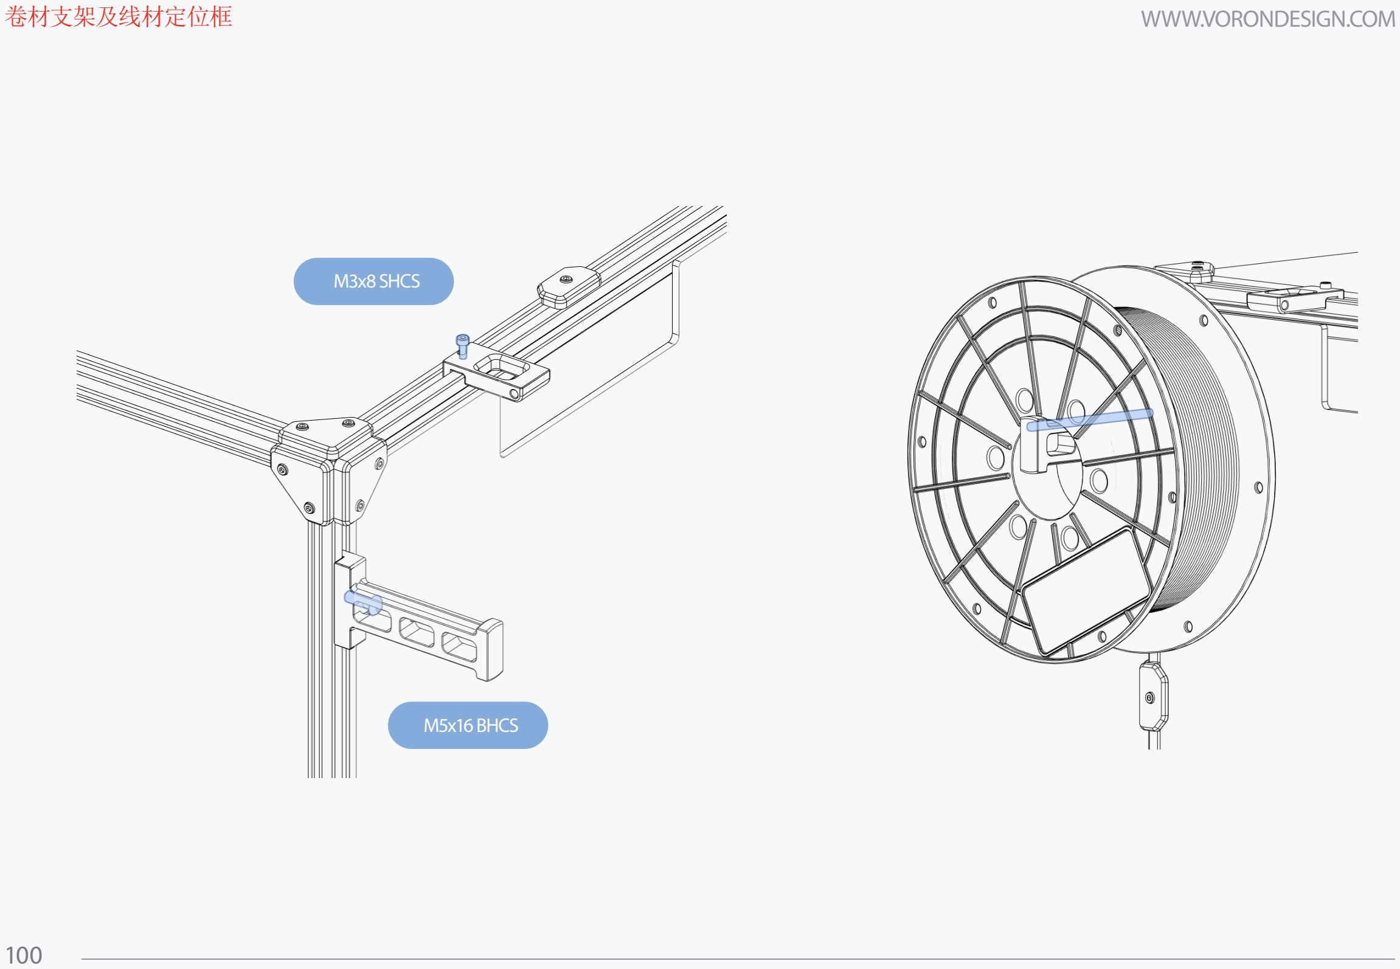
[picture p245: page 100]

100

## M5x16 BHCS

## M3x8 SHCS

101

## WWW.VORONDESIGN.COM

万里长征刚过半

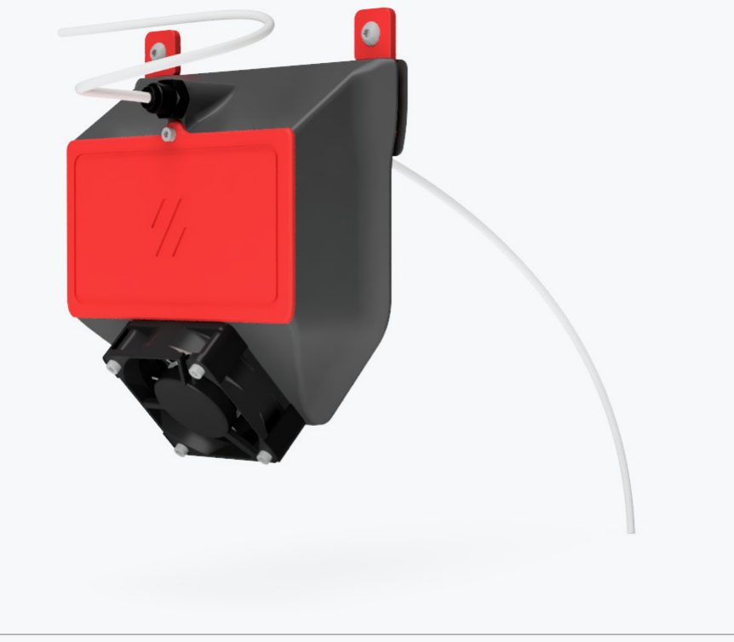
[picture p246: figure]

102

排风过滤模块 | WWW.VORONDESIGN.COM

103

热嵌入部分 | WWW.VORONDESIGN.COM

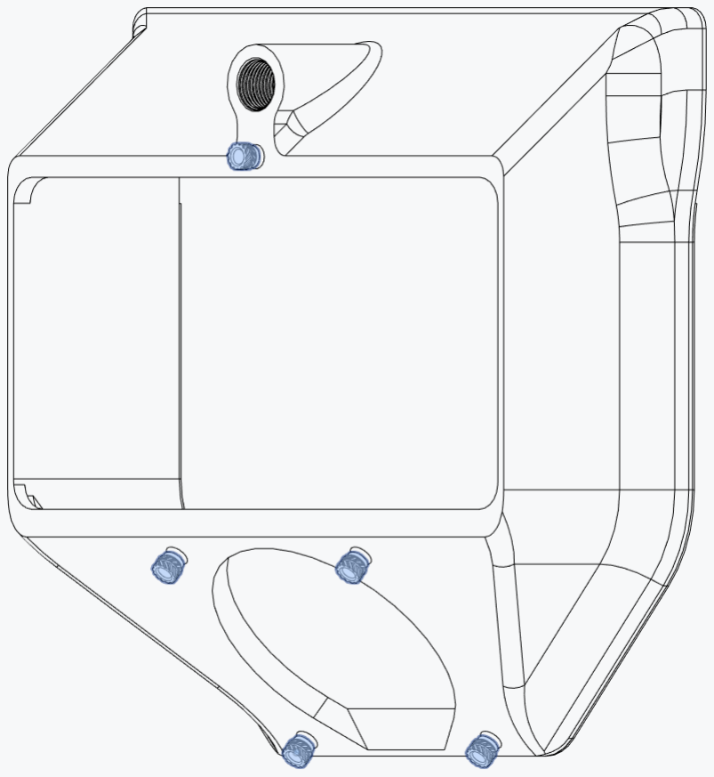
[picture p247: figure]
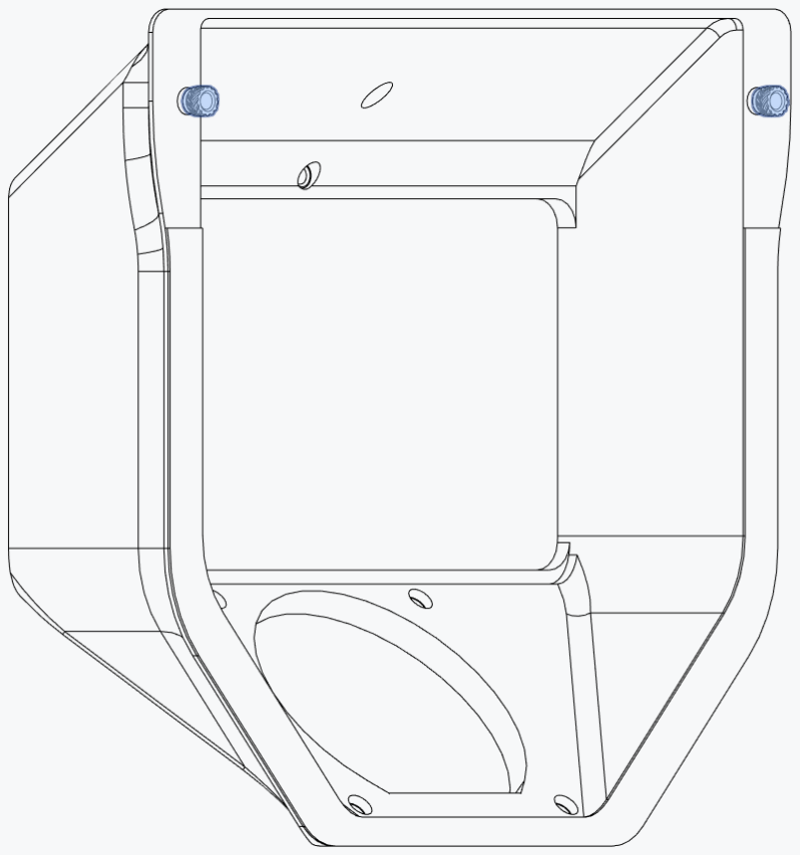
[picture p248: figure]

热嵌入滚花铜螺母

## WWW.VORONDESIGN.COM

## 快接头及风扇的安装

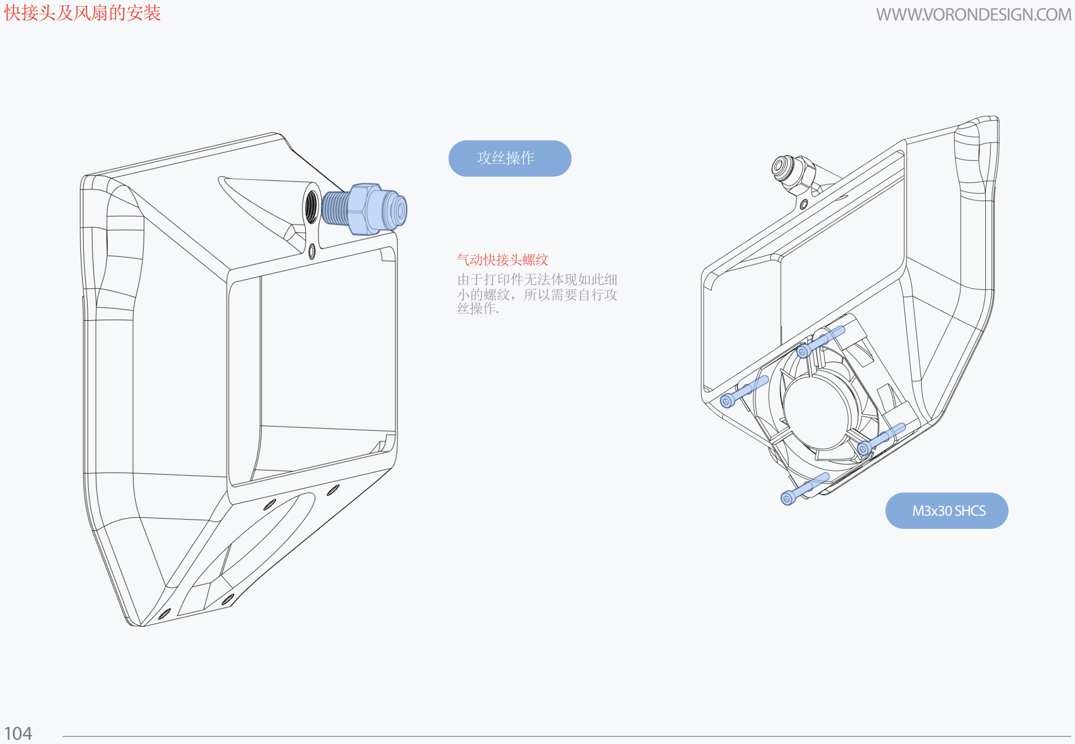
[picture p249: page 104]

104

## M3x30 SHCS

气动快接头螺纹
由于打印件无法体现如此细
小的螺纹，所以需要自行攻
丝操作.

攻丝操作

## WWW.VORONDESIGN.COM

## 滤芯安装

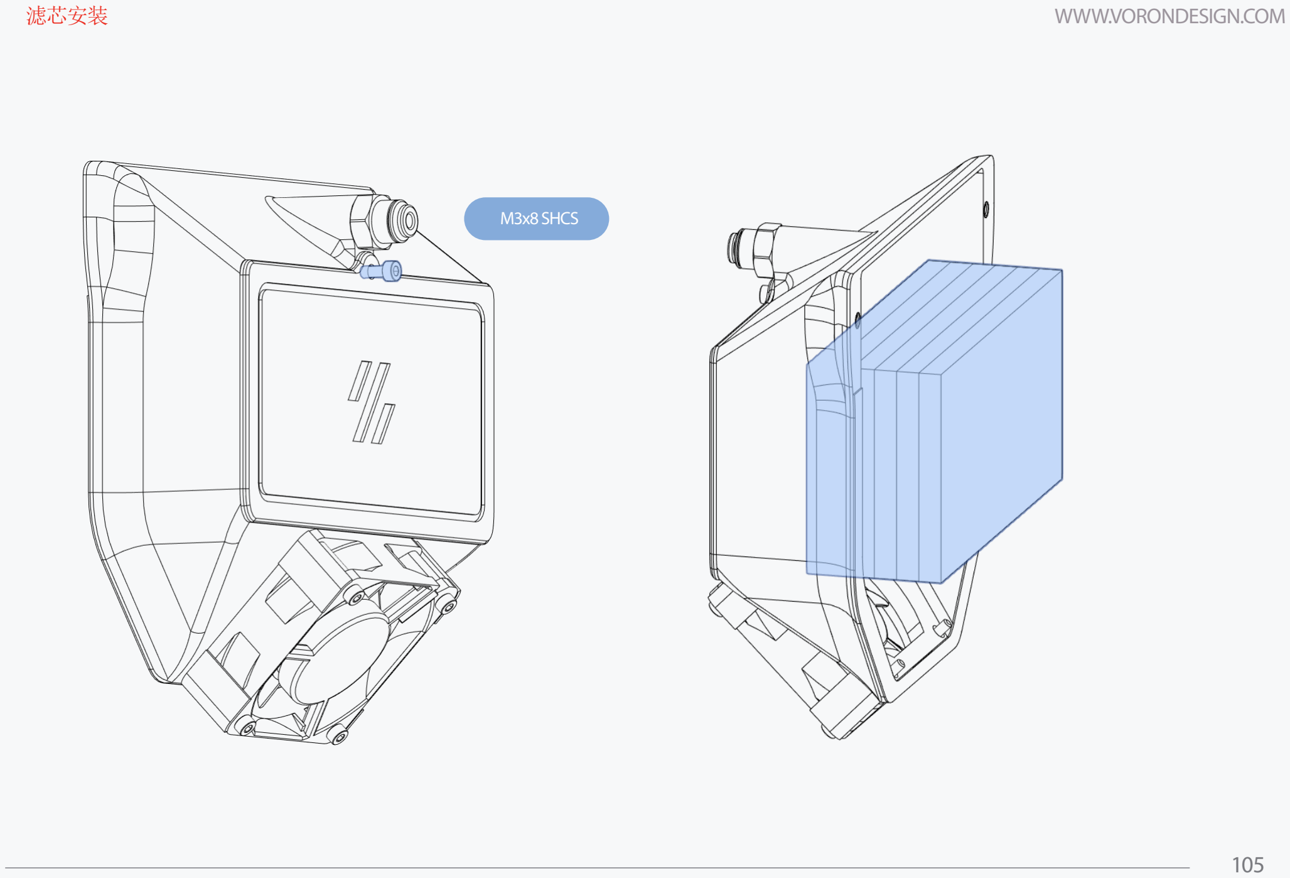
[picture p250: page 105]

105

## M3x8 SHCS

106

## WWW.VORONDESIGN.COM

## BSP Adapter

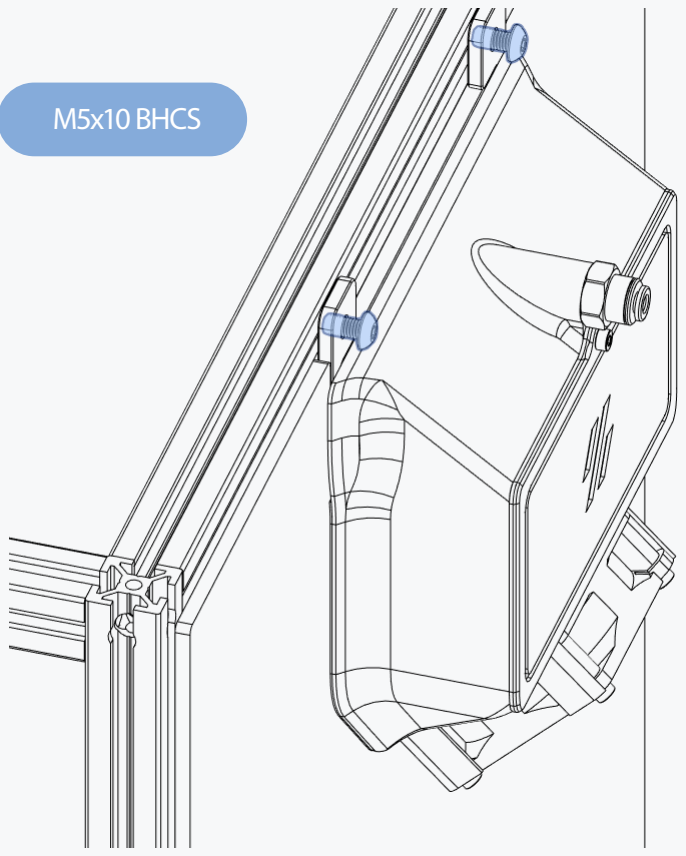
[picture p251: figure]
M5x10 BHCS
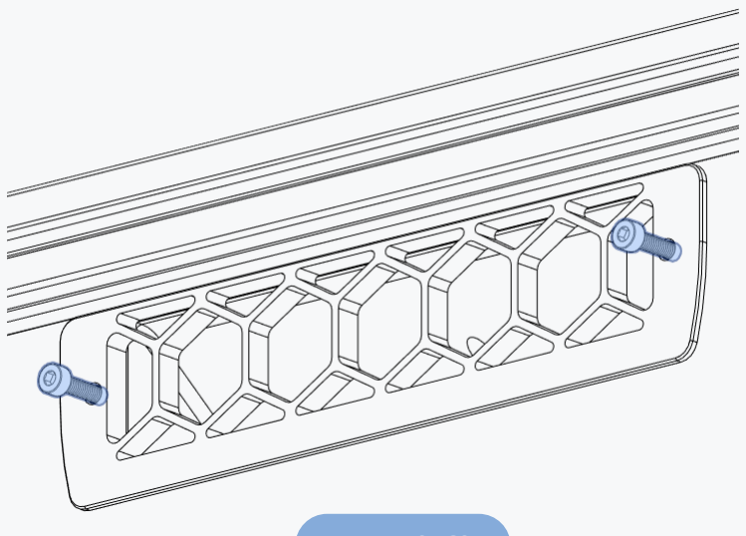
[picture p252: figure]

## M3x12 SHCS

## 过滤器外壳安装

107

铁氟龙送料管安装 | WWW.VORONDESIGN.COM

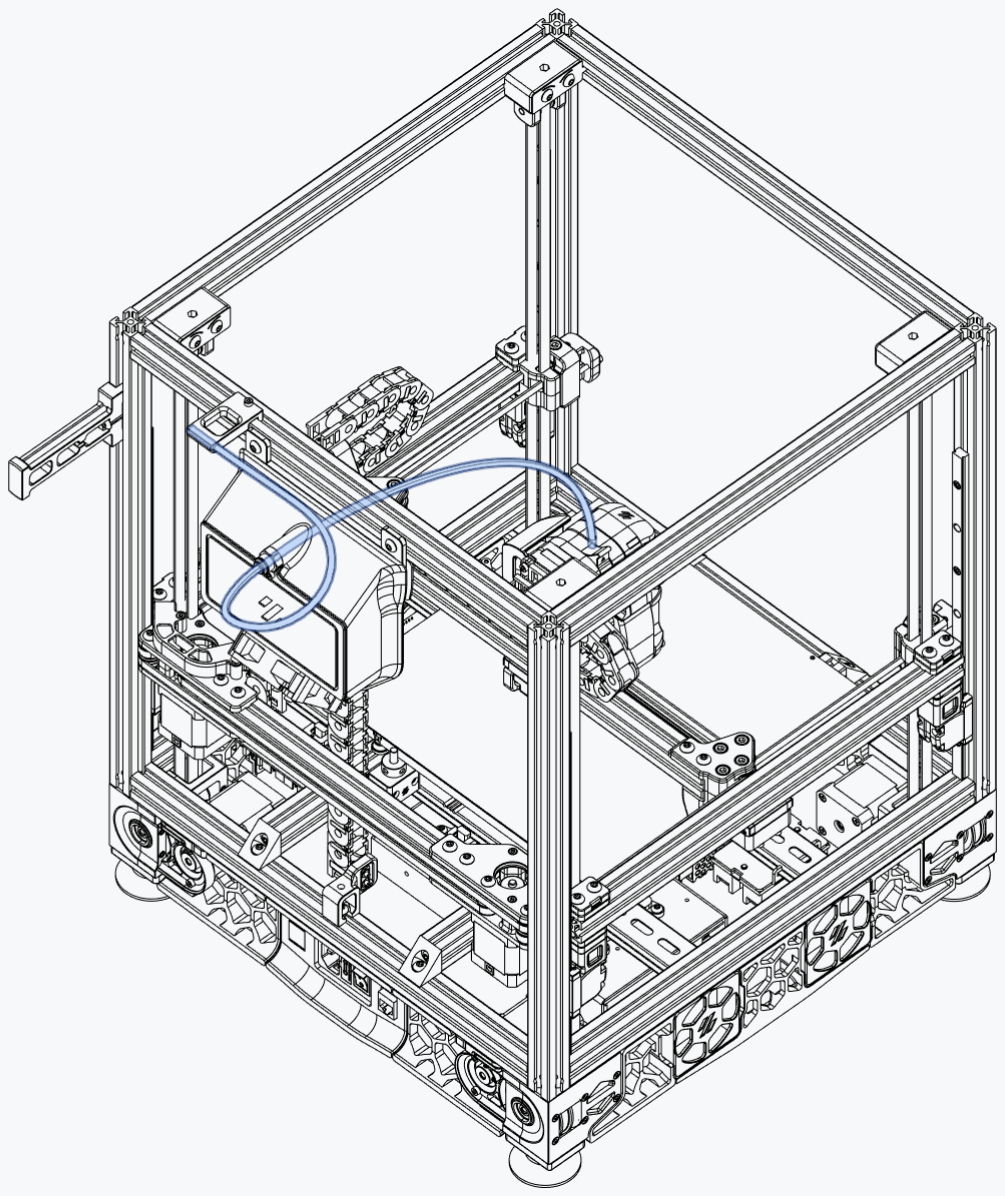
[picture p253: figure]

108

## WWW.VORONDESIGN.COM

## BigTreeTech SKR

## BigTreeTechSKR

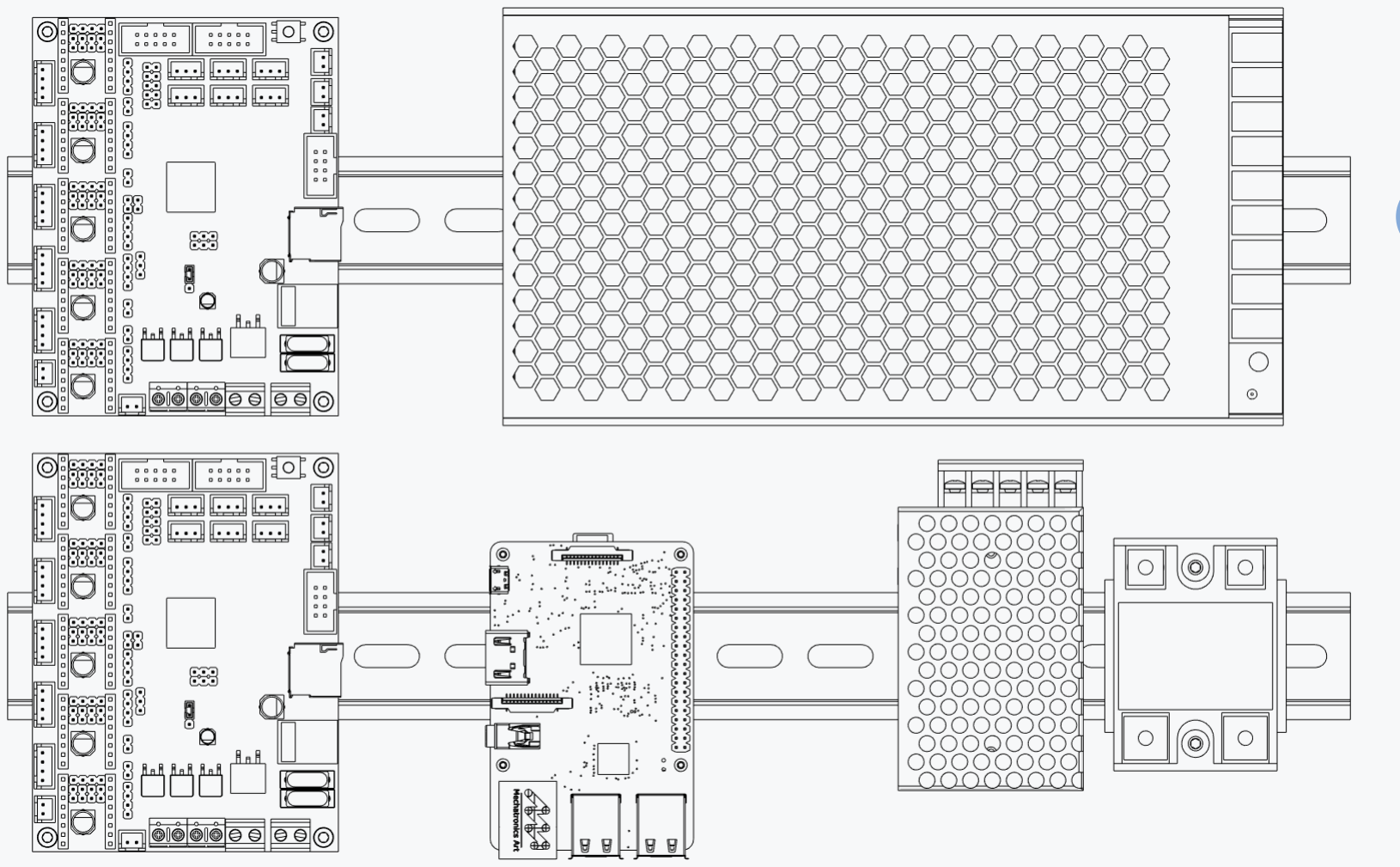
[picture p254: figure]

5V直流电源

24V直流电源

## 电子设备安装

电气安装导轨

树莓派4b

109

## WWW.VORONDESIGN.COM

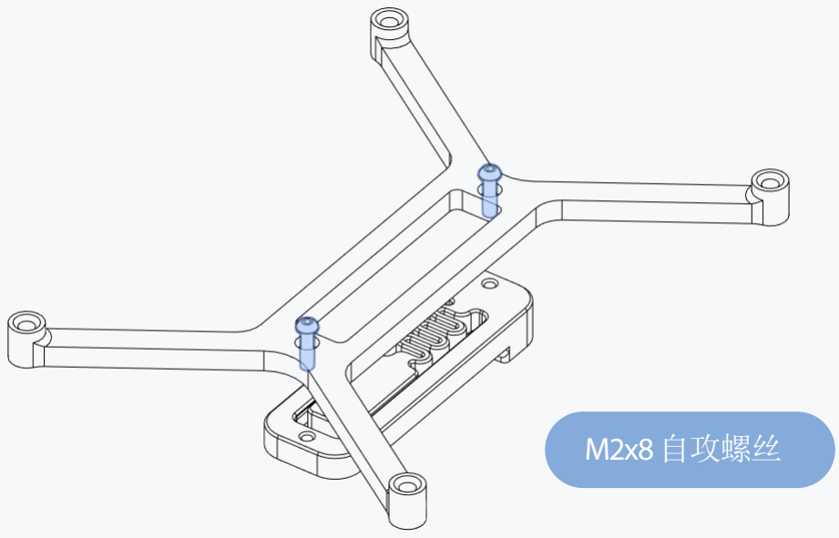
[picture p255: figure]
M2x8自攻螺丝
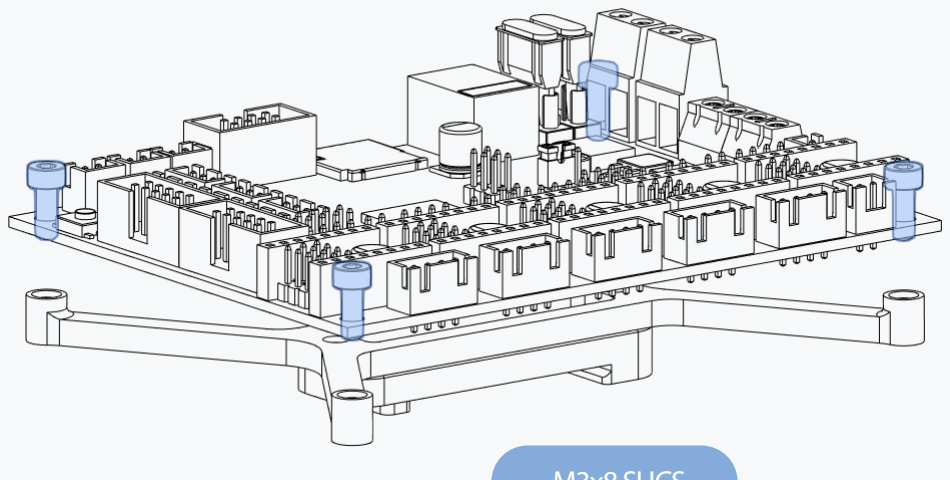
[picture p256: figure]

## M3x8 SHCS

## 主板安装支架

## WWW.VORONDESIGN.COM

## 树莓派支架

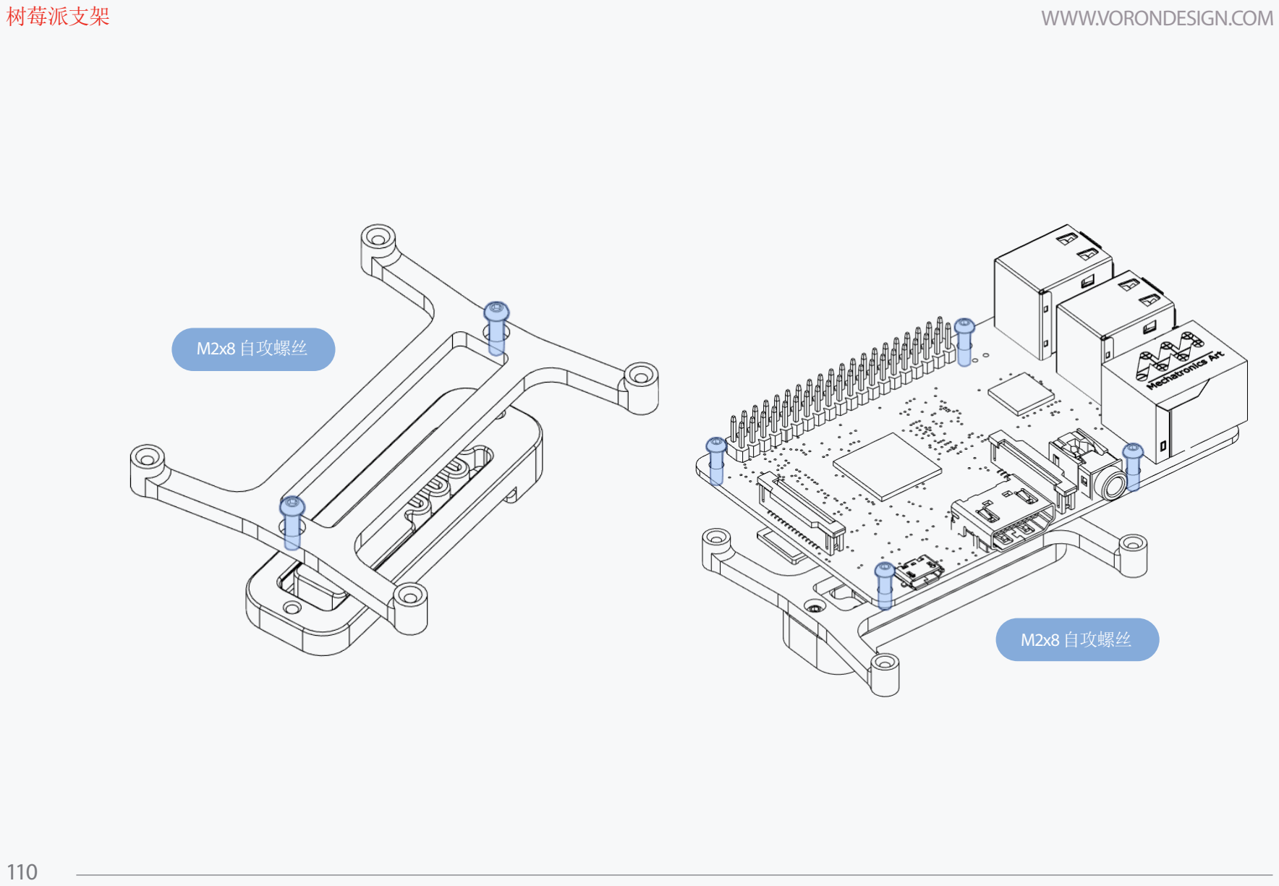
[picture p257: page 110]

110

## M2x8自攻螺丝

## M2x8自攻螺丝

111

## WWW.VORONDESIGN.COM

## 电源安装

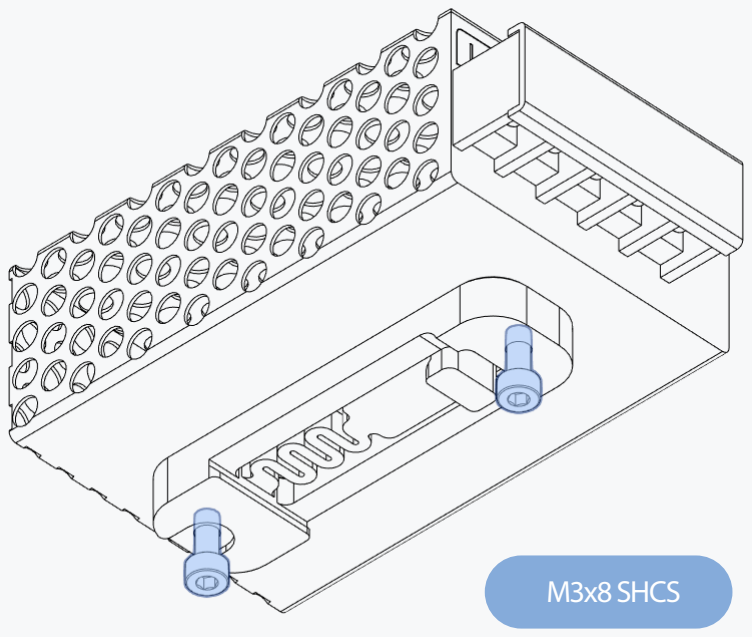
[picture p258: figure]
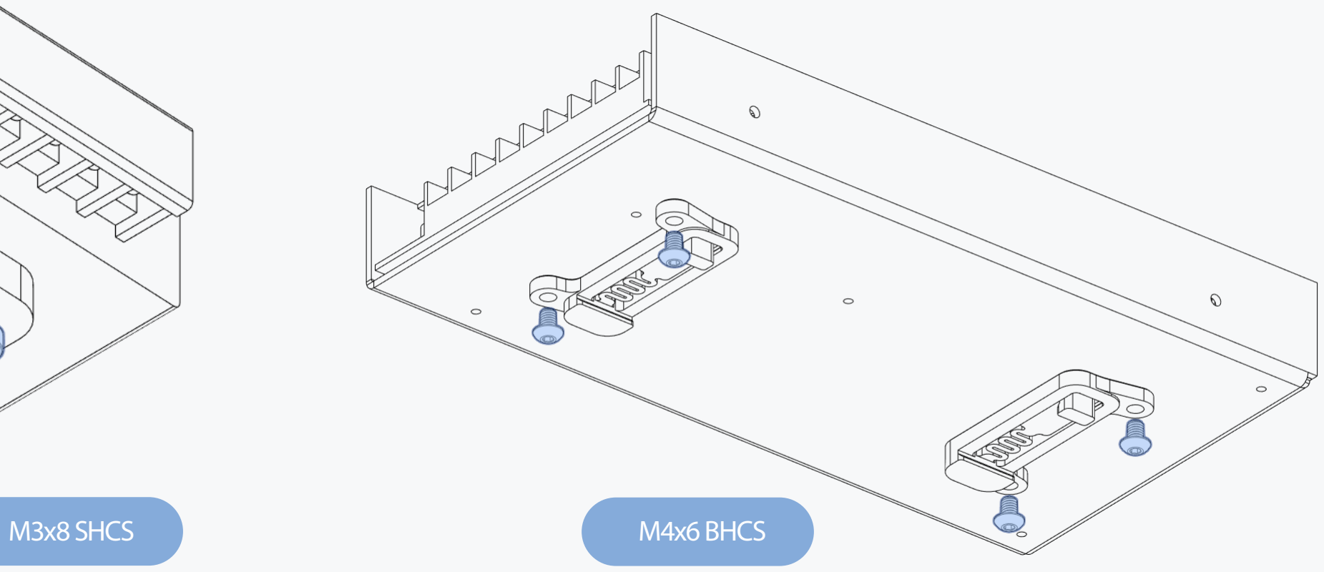
[picture p259: figure]
M3x8 SHCS; M4x6 BHCS

## WWW.VORONDESIGN.COM

## 固态继电器

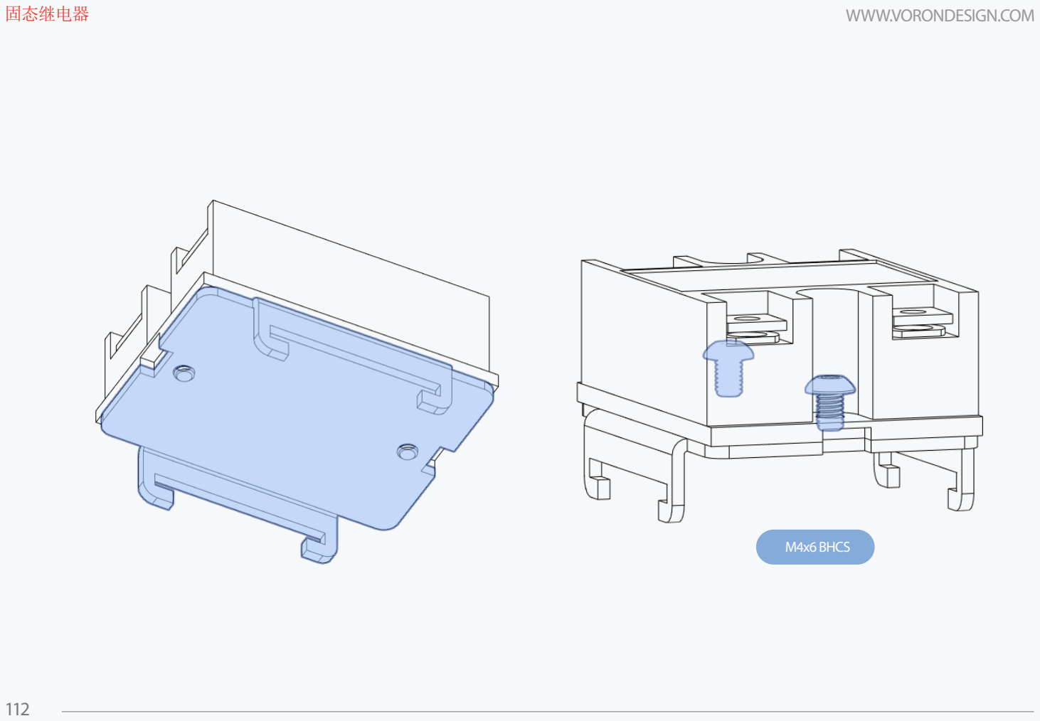
[picture p260: page 112]

112

## M4x6 BHCS

113

电子设备上轨 | WWW.VORONDESIGN.COM

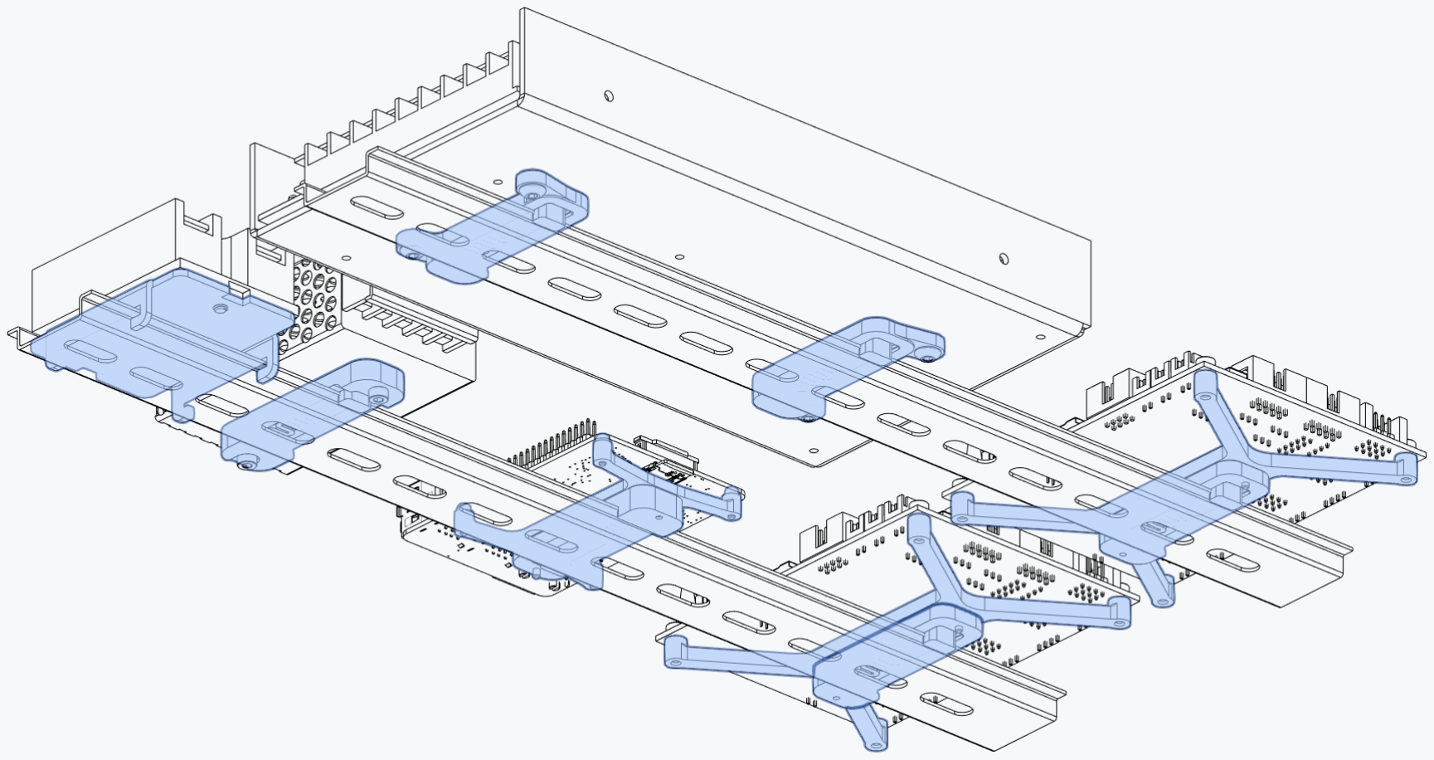
[picture p261: figure]

114

总电源接口 | WWW.VORONDESIGN.COM

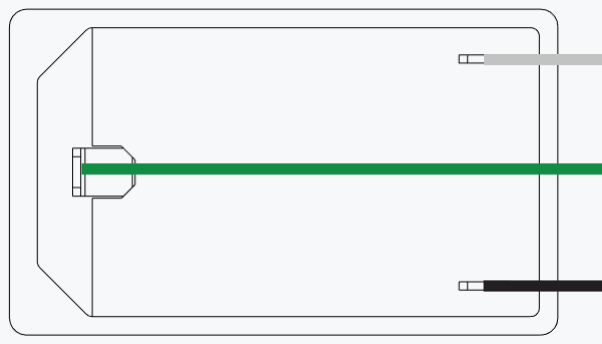
[picture p262: figure]

您即将自行接驳高压电源部分，请务必注意安全.

电源会导致死亡，而且在你因它而死的整个过程中都会受到伤害。

这不是你随意猜猜就能做的事情

## WWW.VORONDESIGN.COM

## 市电端接线

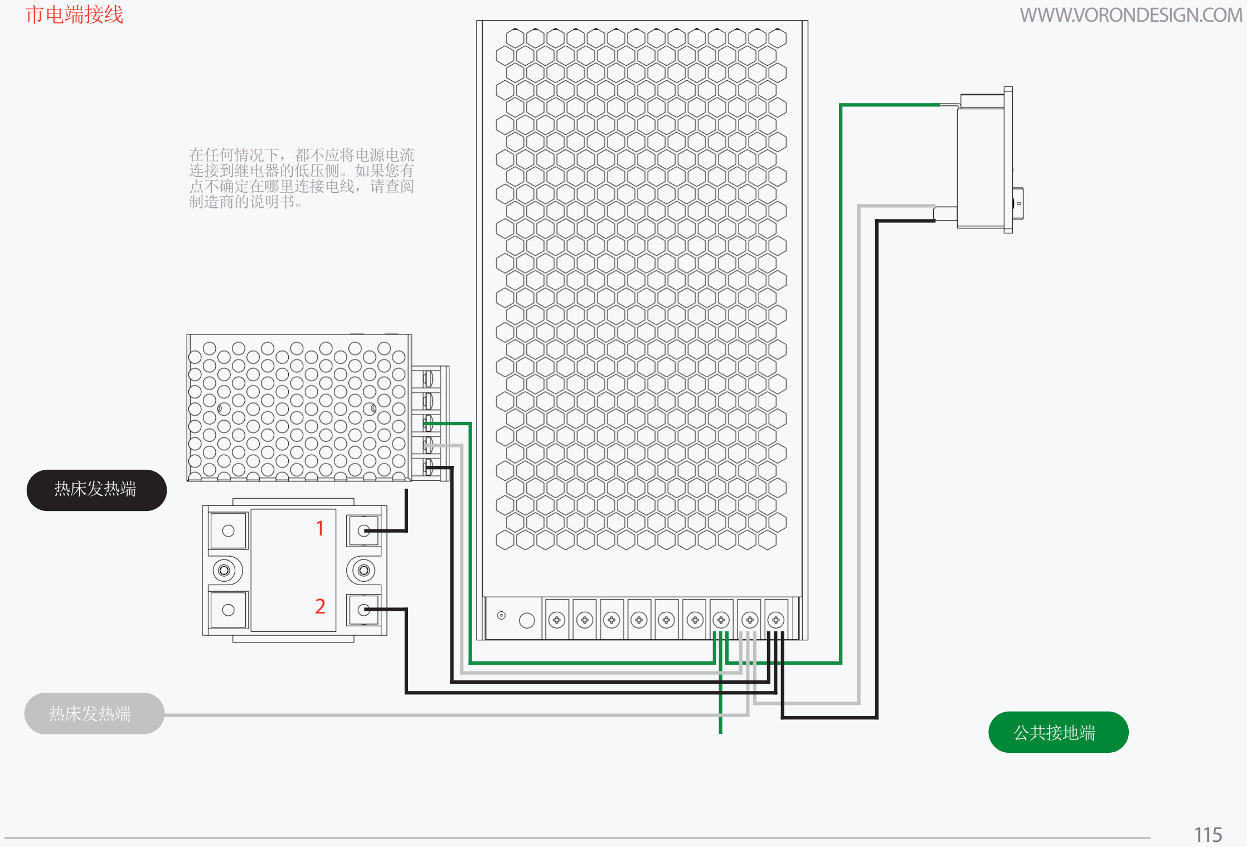
[picture p263: page 115]

115

在任何情况下，都不应将电源电流
连接到继电器的低压侧。如果您有
点不确定在哪里连接电线，请查阅
制造商的说明书。

1

2

热床发热端

热床发热端
公共接地端

116

低压电源 | WWW.VORONDESIGN.COM

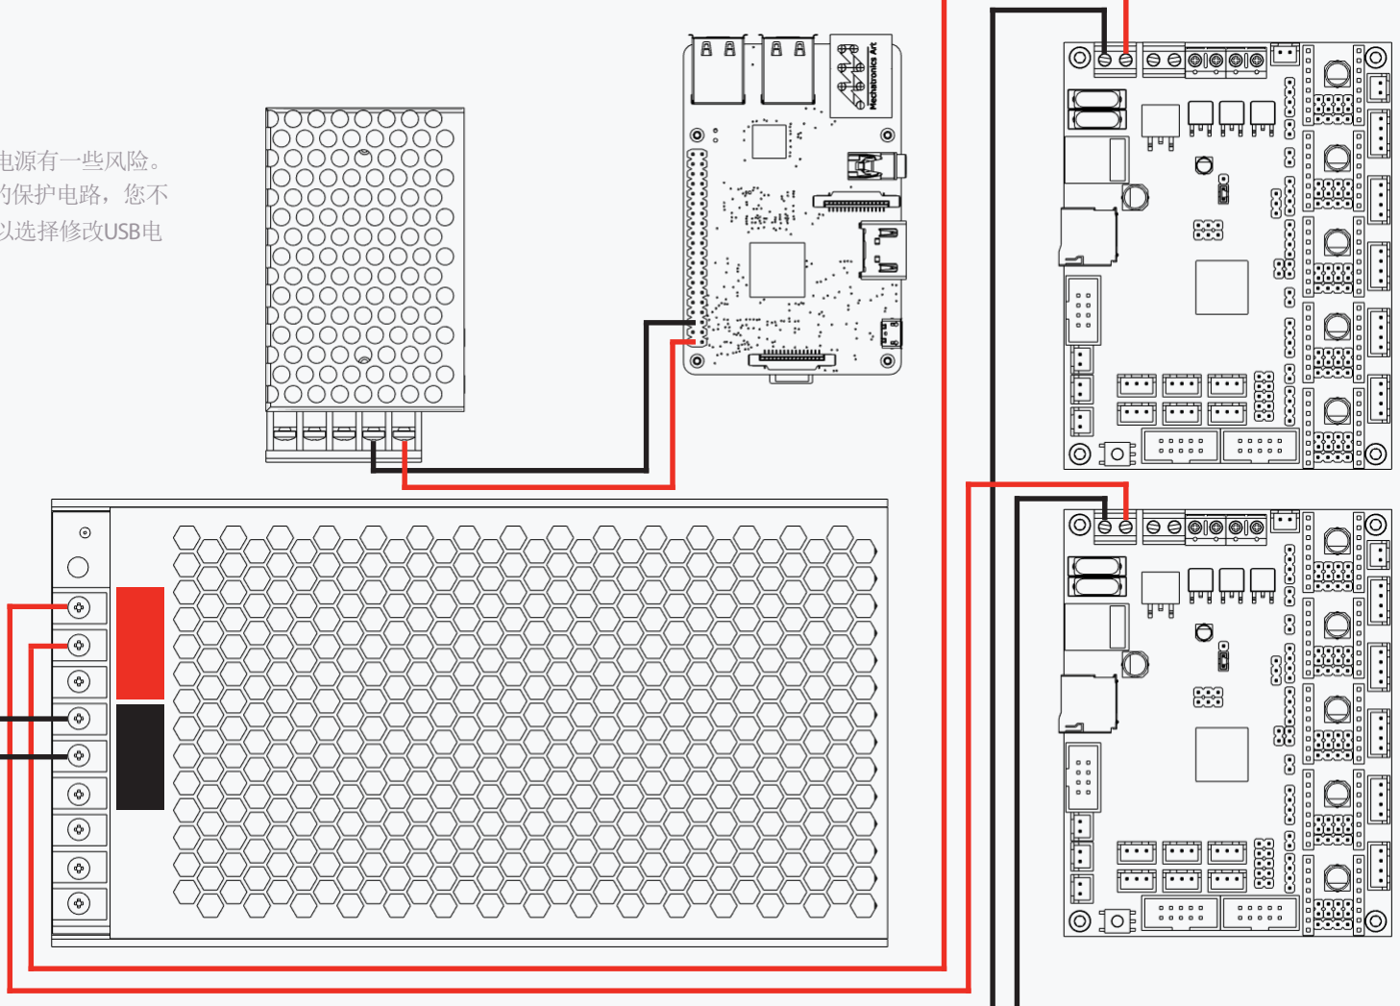
[picture p264: figure]

将树莓派直接连接到直流电源有一些风险。
虽然由于Meanwell电源中的保护电路，您不
太可能遇到问题，但您可以选择修改USB电
缆以利用内置的熔断保险。

直流电源

感应探头

117

## WWW.VORONDESIGN.COM

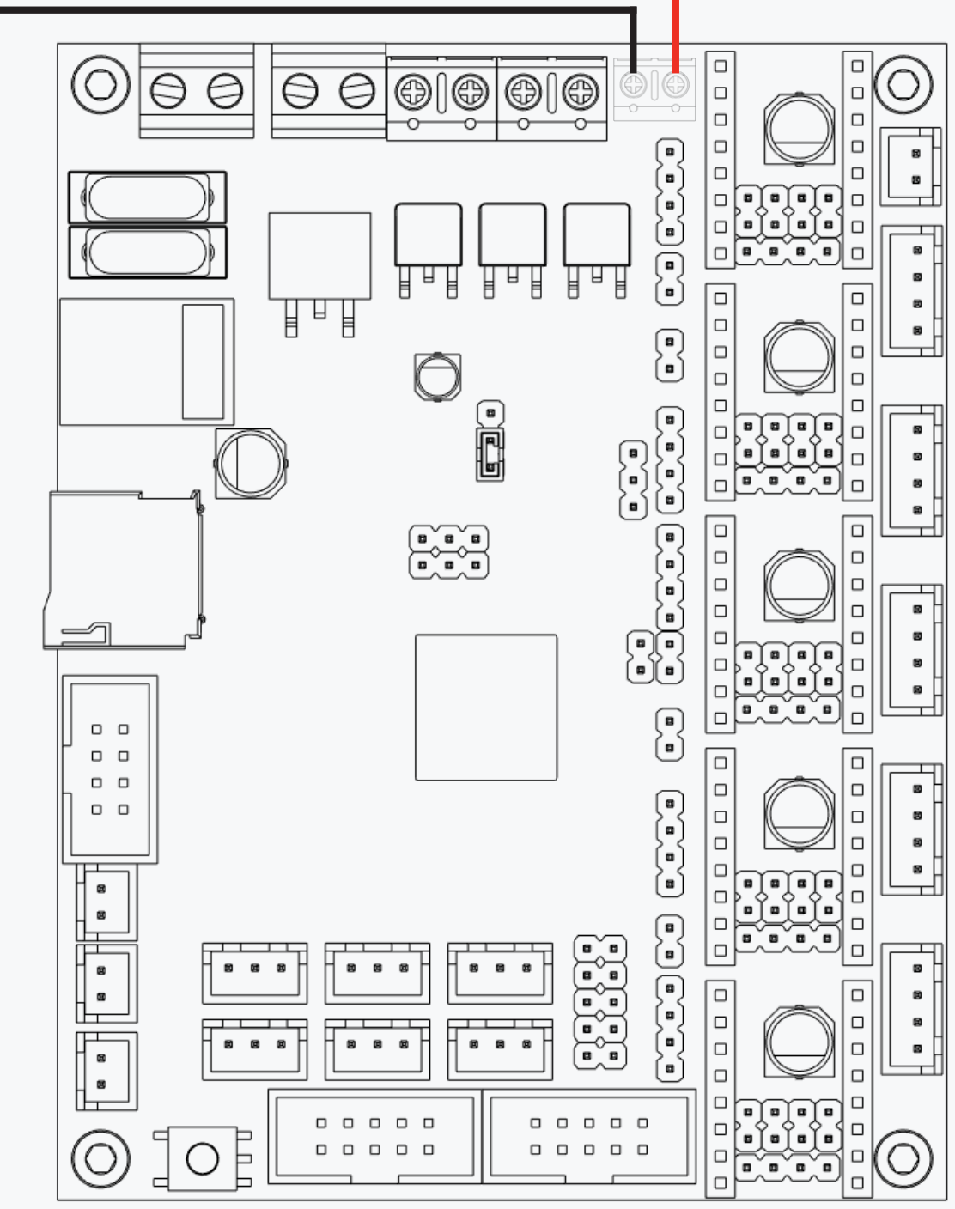
[picture p265: figure]

检查固态继电器端子

在任何情况下，都不应将电源电流连接到继电器
的低压侧。如果您有点不确定在哪里连接电线， 请查阅制造商的说明书。

## MCU Z

## SSR低压

是的，这需要说两遍。

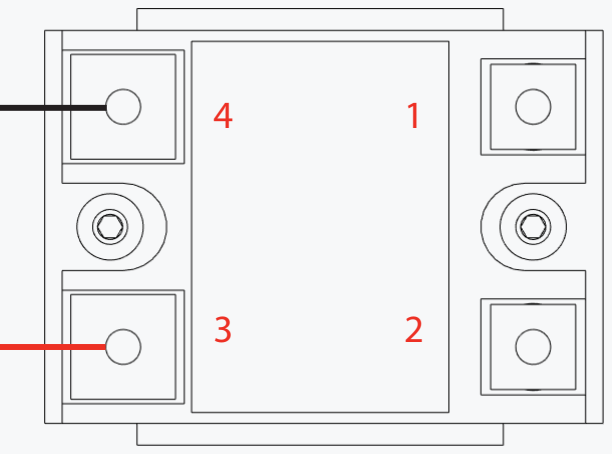
[picture p266: figure]

118

SKR控制器-主板设置 | WWW.VORONDESIGN.COM

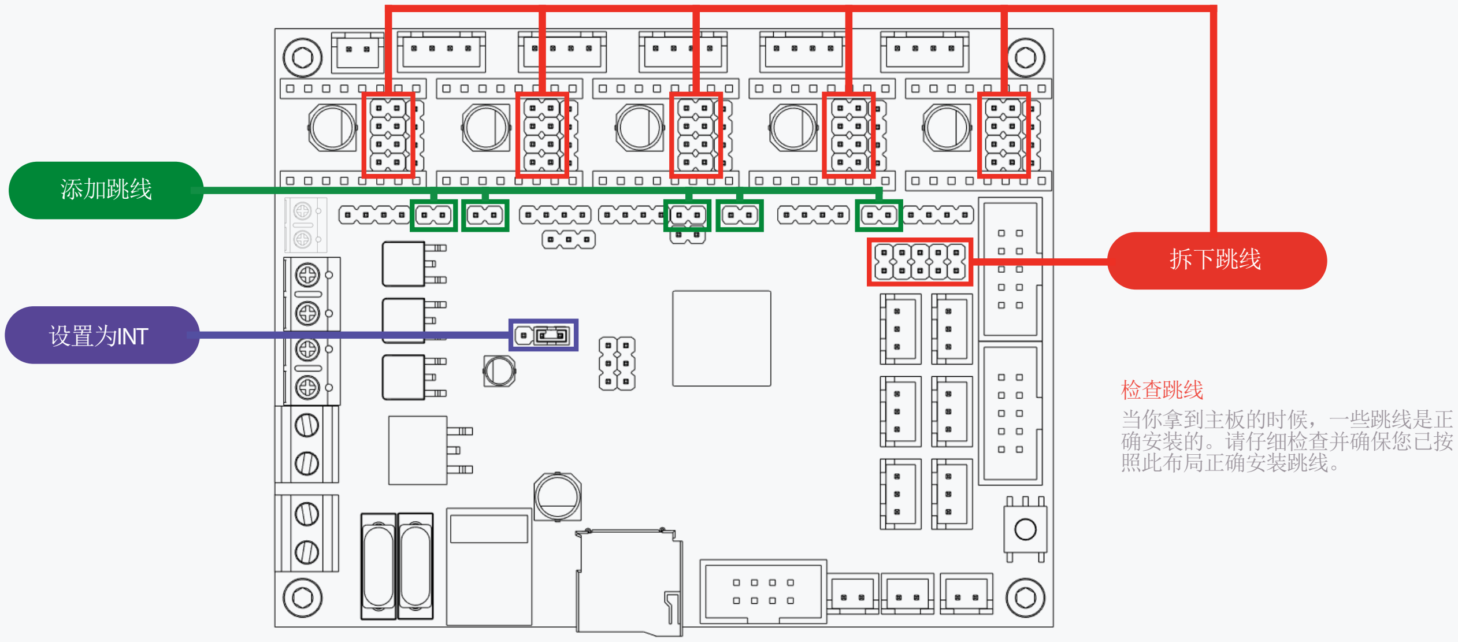
[picture p267: figure]
拆下跳线; 添加跳线; 设置为INT; 检查跳线 当你拿到主板的时候，一些跳线是正 确安装的。请仔细检查并确保您已按 照此布局正确安装跳线。

119

## WWW.VORONDESIGN.COM

X

轴

电

机(左)

Y

轴

电

机(右)

X轴限位

Y轴限位

## SKR控制器-MCU

打印冷却风扇

喉管散热风扇

喷嘴加热端

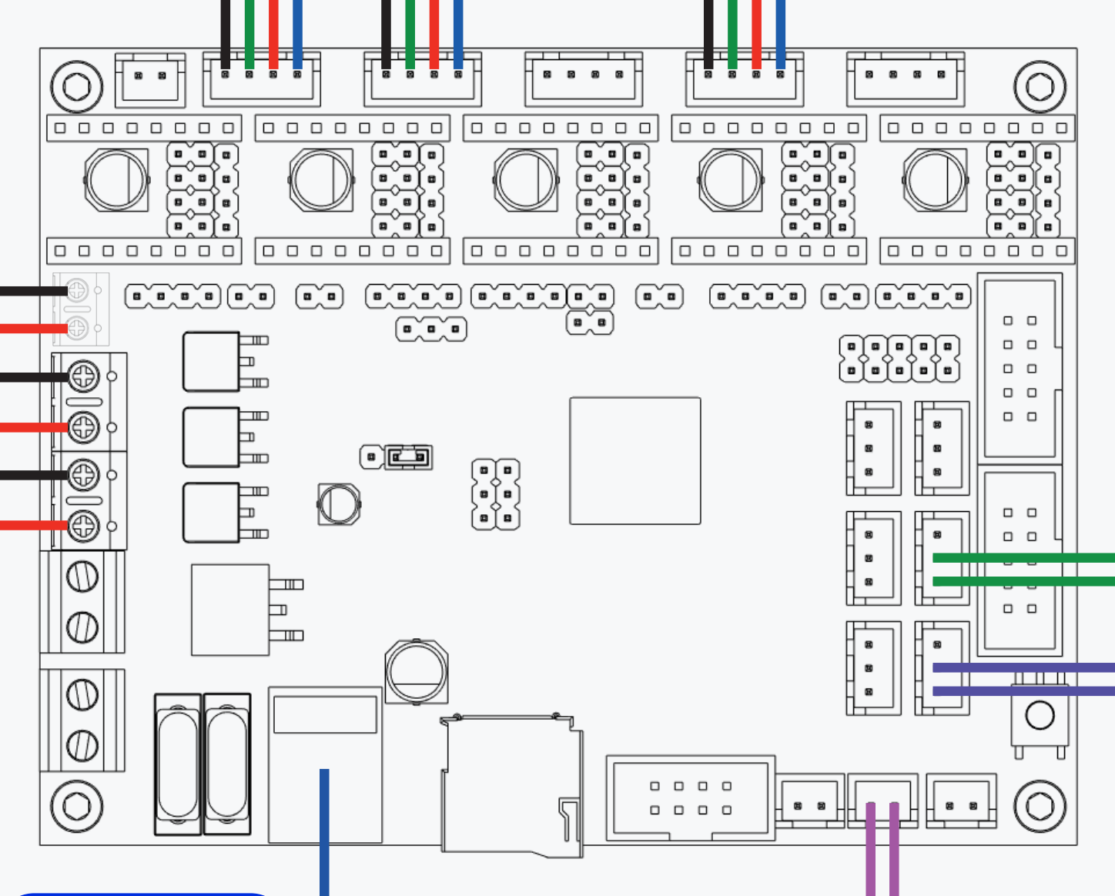
[picture p268: figure]

树莓派 | 喷头温度探测

E轴

电

机

120

SKR CONTROLLER - MCU Z | WWW.VORONDESIGN.COM Z0 | Z1 | Z2 | Z3

Z轴限位

显示端口 EXP1

## SSR控制

电路仓散热风扇

排气扇

显示端口 EXP2

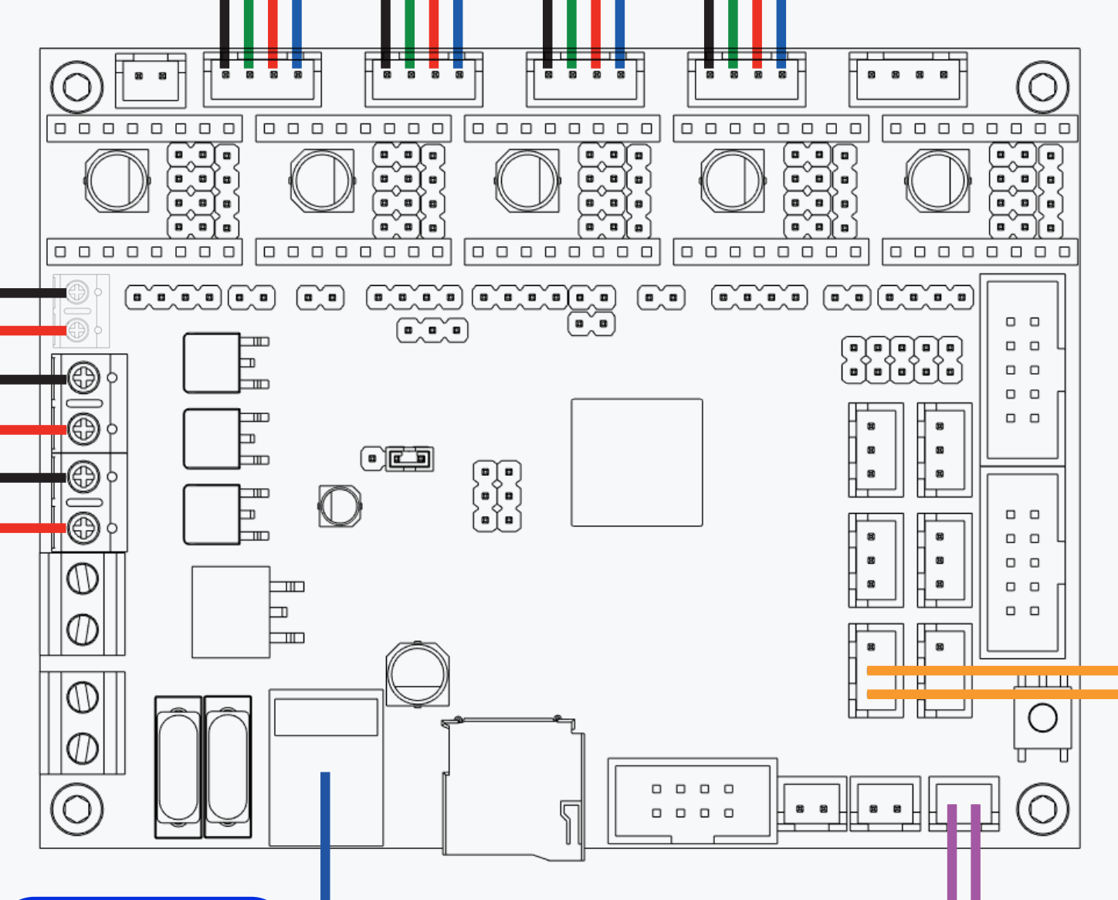
[picture p269: figure]

树莓派 | 热床温度探测

121

感应探头接线 | WWW.VORONDESIGN.COM

感应探头接线
如果您不确定如何连接感应探头，
请参考制造商的说明书。

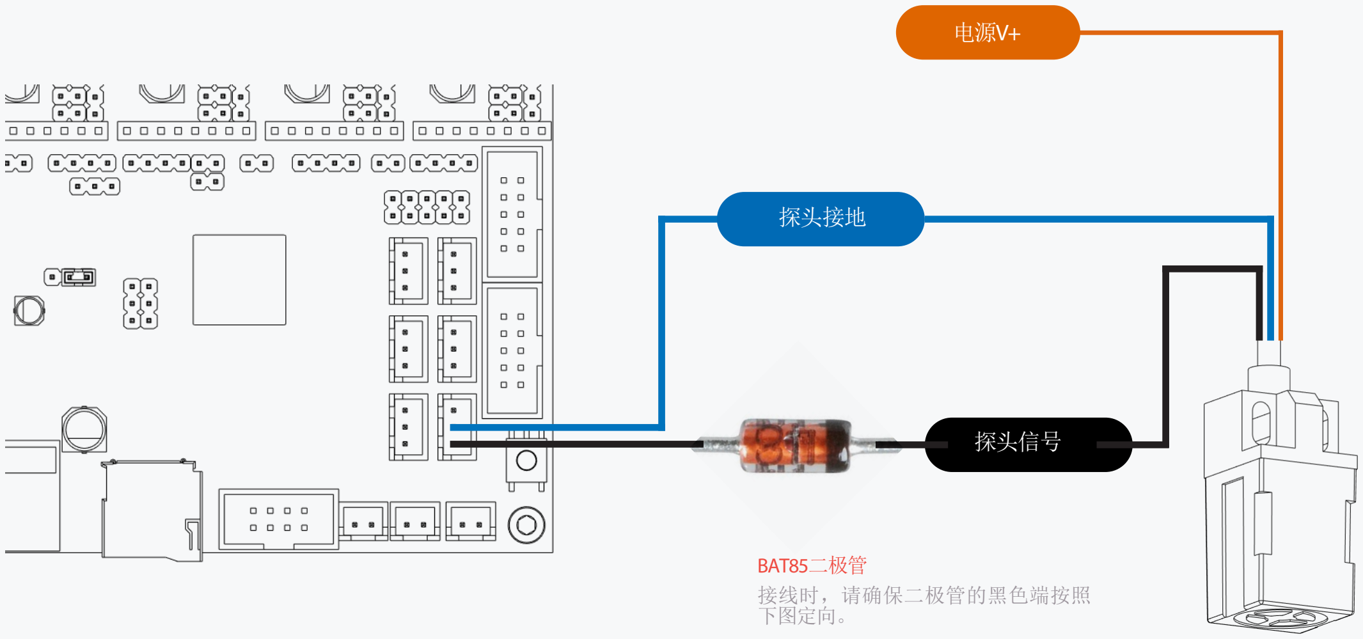
[picture p270: figure]
电源V+; 探头接地; 探头信号; BAT85二极管; 接线时，请确保二极管的黑色端按照 下图定向。

## WWW.VORONDESIGN.COM

## Z轴电机位置及编号

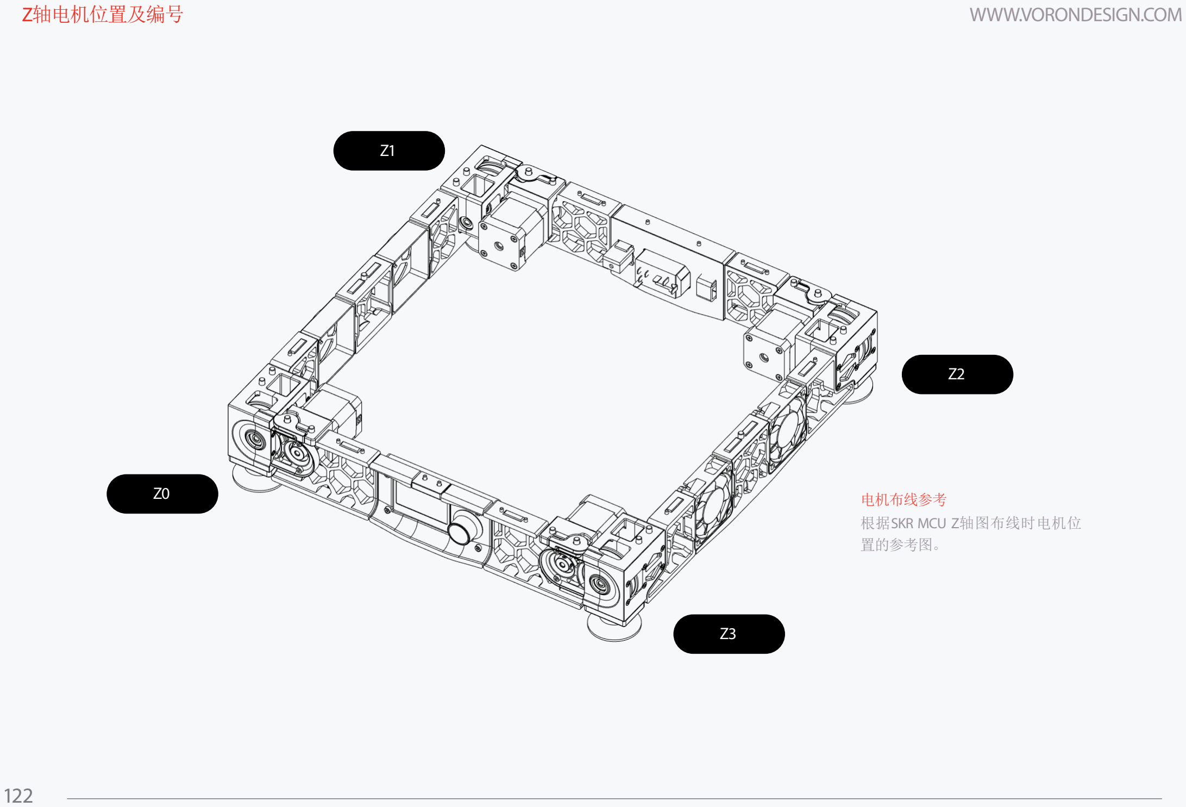
[picture p271: page 122]

122

Z3

Z0

Z1

Z2

根据SKR MCU Z轴图布线时电机位
置的参考图。

电机布线参考

123

## WWW.VORONDESIGN.COM

X | Y

## XY轴电机位置

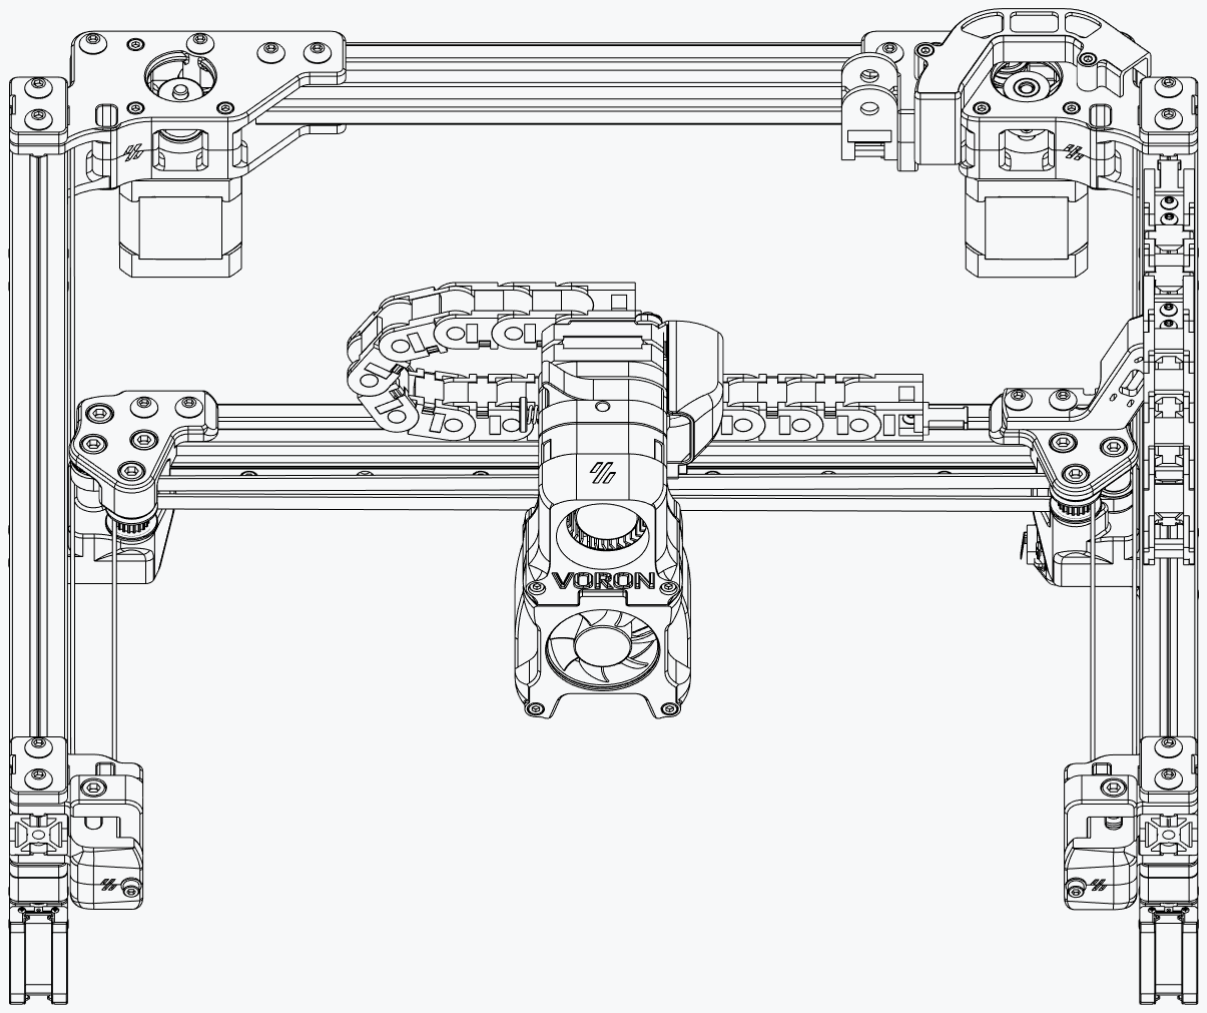
[picture p272: figure]

根据SKR MCU图布线时电机位置的
参考图。

XY轴电机接线位置

124

## WWW.VORONDESIGN.COM

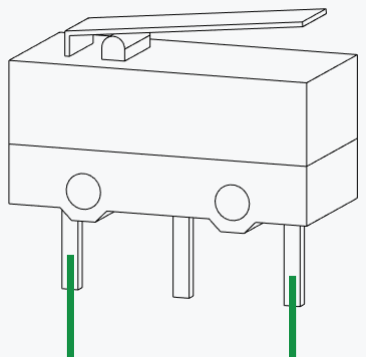
[picture p273: figure]

接线端子
端部止动器接线为常闭（NC）。

这样做的目的是，如果部件出现故障或
可能出现断线，机器将检测电路端部的
中断原因和错误。

## 接线端子定义

控制器

125

## WWW.VORONDESIGN.COM

### https://github.com/KevinOConnor/klipper/blob/master/docs/Config_checks.md

## 运行前检查表

## 电源线

现在是回去仔细检查电源线的好时机。这里的错误可能意味着出现严重故障及人身伤害，所以最好重新检查一下电路。确认您的接 线符合图纸的步骤。

## 低压接线

再次检查您的低压接线是否正确完成。如果有条件使用万用表并花一些时间来测试一遍所有连接是最理想的状态。

## KLIPPER配置检查

验证在Klipper中连接的部分非常简单。凯文写了一本很好的指导书，告诉你该怎么做。你可以在官方的KlipperGithub上找到他的指南 ，点击下方链接。

## 测试打印和序列号

一旦你准备好开始打印，你应该来看看STL文件夹中的一些打印，这些文件用来专门调试本机器。一旦成功打印，那么证明一切准备 就绪可以正式投入使用了.

126

### Github

https://github.com/vorondesign

### Website

www.vorondesign.com

### Discord

https://discord.gg/xgXWctB

# VORON

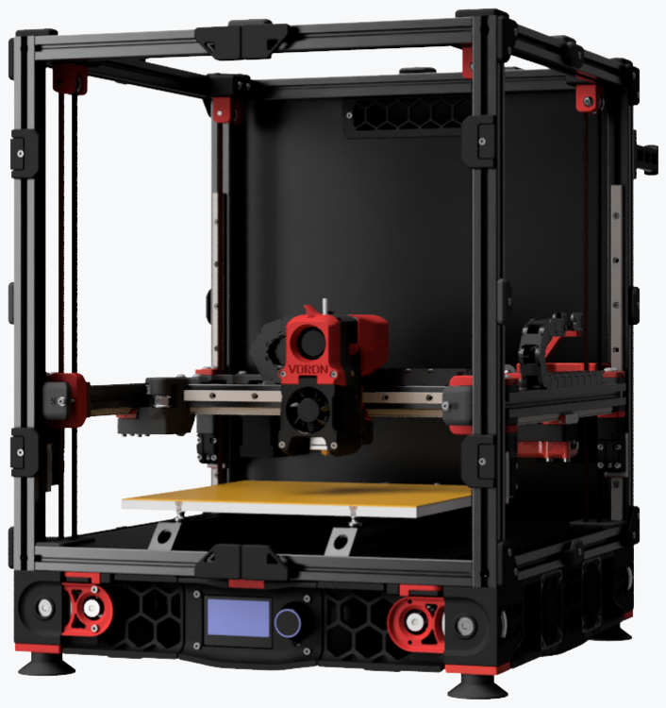
[picture p274: figure]

127
