zhcntiangang/seahorse.github.io/features/troubleshooting.png

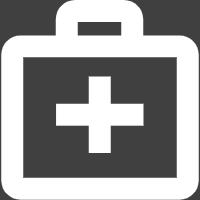
features/troubleshooting.png
