zhcntiangang/seahorse.github.io/docs__assembling__software-first-config.md.d2206a2c.async.js

"use strict";(self.webpackChunkseahorse=self.webpackChunkseahorse||[]).push([[3449],{3931:function(n,t,s){s.r(t);var r=s(72269),x=s(93359),o=s(61788),i=s(18095),d=s(61452),p=s(96057),h=s(85939),l=s(16442),u=s(80936),A=s(67294),a=s(92827),e=s(85893);function c(){return(0,e.jsx)(l.dY,{children:(0,e.jsx)(A.Suspense,{fallback:(0,e.jsx)(u.Z,{}),children:(0,e.jsxs)(e.Fragment,{children:[(0,e.jsx)(i.Z,{type:"warning",children:(0,e.jsx)("p",{children:a.texts[0].value})}),(0,e.jsxs)("div",{className:"markdown",children:[(0,e.jsxs)("h1",{id:"\u521D\u59CB\u5316klipper\u53CA\u6545\u969C\u5904\u7406",children:[(0,e.jsx)("a",{"aria-hidden":"true",tabIndex:"-1",href:"#\u521D\u59CB\u5316klipper\u53CA\u6545\u969C\u5904\u7406",children:(0,e.jsx)("span",{className:"icon icon-link"})}),"\u521D\u59CB\u5316Klipper\u53CA\u6545\u969C\u5904\u7406"]}),(0,e.jsx)("p",{children:(0,e.jsx)("strong",{children:a.texts[1].value})}),(0,e.jsxs)("h2",{id:"1-\u521D\u59CB\u5316printercfg",children:[(0,e.jsx)("a",{"aria-hidden":"true",tabIndex:"-1",href:"#1-\u521D\u59CB\u5316printercfg",children:(0,e.jsx)("span",{className:"icon icon-link"})}),"1 \u521D\u59CB\u5316printer.cfg"]}),(0,e.jsxs)("p",{children:[a.texts[2].value,(0,e.jsx)("code",{children:a.texts[3].value}),a.texts[4].value]}),(0,e.jsxs)("h3",{id:"11-\u6DFB\u52A0\u6A21\u677F\u6587\u4EF6",children:[(0,e.jsx)("a",{"aria-hidden":"true",tabIndex:"-1",href:"#11-\u6DFB\u52A0\u6A21\u677F\u6587\u4EF6",children:(0,e.jsx)("span",{className:"icon icon-link"})}),"1.1 \u6DFB\u52A0\u6A21\u677F\u6587\u4EF6"]}),(0,e.jsxs)("p",{children:[(0,e.jsx)("code",{children:a.texts[5].value}),a.texts[6].value,(0,e.jsx)("code",{children:a.texts[7].value}),a.texts[8].value]}),(0,e.jsxs)("p",{children:[a.texts[9].value,(0,e.jsx)("code",{children:a.texts[10].value}),a.texts[11].value,(0,e.jsx)("code",{children:a.texts[12].value}),a.texts[13].value]}),(0,e.jsxs)("ul",{children:[(0,e.jsxs)("li",{children:[a.texts[14].value,(0,e.jsx)("a",{href:"https://github.com/FYSETC/FYSETC-SPIDER/blob/main/firmware/Klipper/printer.cfg",children:a.texts[15].value})]}),(0,e.jsxs)("li",{children:[a.texts[16].value,(0,e.jsx)("a",{href:"https://gitee.com/fysetc/FYSETC-SPIDER/blob/main/firmware/Klipper/printer.cfg",children:a.texts[17].value})]})]}),(0,e.jsx)("p",{children:a.texts[18].value}),(0,e.jsx)("img",{style:{zoom:"80%"},src:s(46926)}),(0,e.jsx)("p",{children:a.texts[19].value}),(0,e.jsx)("img",{style:{zoom:"50%"},src:s(92809)}),(0,e.jsx)("p",{children:a.texts[20].value}),(0,e.jsx)("img",{style:{zoom:"80%"},src:s(62127)}),(0,e.jsx)("p",{children:a.texts[21].value}),(0,e.jsx)("p",{children:(0,e.jsx)("img",{alt:"",src:s(88433)})}),(0,e.jsx)("p",{children:a.texts[22].value}),(0,e.jsx)("p",{children:(0,e.jsx)("img",{alt:"",src:s(69927)})}),(0,e.jsxs)("h3",{id:"12-\u4E0D\u4FEE\u6539\u5C31\u62A5\u9519",children:[(0,e.jsx)("a",{"aria-hidden":"true",tabIndex:"-1",href:"#12-\u4E0D\u4FEE\u6539\u5C31\u62A5\u9519",children:(0,e.jsx)("span",{className:"icon icon-link"})}),"1.2 \u4E0D\u4FEE\u6539\u5C31\u62A5\u9519"]}),(0,e.jsx)("p",{children:a.texts[23].value}),(0,e.jsx)(d.Z,{lang:"shell",children:a.texts[24].value}),(0,e.jsxs)("h4",{id:"121-mcu-\u8FDE\u63A5\u65B9\u5F0F",children:[(0,e.jsx)("a",{"aria-hidden":"true",tabIndex:"-1",href:"#121-mcu-\u8FDE\u63A5\u65B9\u5F0F",children:(0,e.jsx)("span",{className:"icon icon-link"})}),"1.2.1 MCU \u8FDE\u63A5\u65B9\u5F0F"]}),(0,e.jsx)("p",{children:a.texts[25].value}),(0,e.jsx)("p",{children:(0,e.jsx)("img",{alt:"",src:s(33108)})}),(0,e.jsxs)("h4",{id:"122-\u70ED\u5E8A",children:[(0,e.jsx)("a",{"aria-hidden":"true",tabIndex:"-1",href:"#122-\u70ED\u5E8A",children:(0,e.jsx)("span",{className:"icon icon-link"})}),"1.2.2 \u70ED\u5E8A"]}),(0,e.jsx)("p",{children:(0,e.jsx)("img",{alt:"",src:s(34296)})}),(0,e.jsxs)("p",{children:[a.texts[26].value,(0,e.jsx)("code",{children:a.texts[27].value}),a.texts[28].value,(0,e.jsx)("code",{children:a.texts[29].value}),a.texts[30].value]}),(0,e.jsxs)("p",{children:[a.texts[31].value,(0,e.jsx)("code",{children:a.texts[32].value}),a.texts[33].value]})]}),(0,e.jsxs)(i.Z,{type:"warning",children:[(0,e.jsx)("p",{children:a.texts[34].value}),(0,e.jsxs)("ul",{children:[(0,e.jsx)("li",{children:a.texts[35].value}),(0,e.jsx)("li",{children:a.texts[36].value})]})]}),(0,e.jsxs)("div",{className:"markdown",children:[(0,e.jsx)("img",{style:{zoom:"80%"},src:s(31035)}),(0,e.jsxs)("p",{children:[a.texts[37].value,(0,e.jsx)("code",{children:a.texts[38].value}),a.texts[39].value]}),(0,e.jsx)("img",{style:{zoom:"80%"},src:s(58378)}),(0,e.jsxs)("p",{children:[a.texts[40].value,(0,e.jsx)("a",{href:"https://item.taobao.com/item.htm?spm=a1z09.2.0.0.7de72e8dyRTo13&id=623449050030&_u=e1n1copf56c",children:a.texts[41].value}),a.texts[42].value]}),(0,e.jsxs)("p",{children:[a.texts[43].value,(0,e.jsx)("code",{children:a.texts[44].value}),a.texts[45].value]}),(0,e.jsxs)("ul",{children:[(0,e.jsx)("li",{children:a.texts[46].value}),(0,e.jsx)("li",{children:a.texts[47].value}),(0,e.jsx)("li",{children:a.texts[48].value})]}),(0,e.jsx)("img",{style:{zoom:"67%"},src:s(82987)}),(0,e.jsx)("img",{style:{zoom:"67%"},src:s(60976)}),(0,e.jsx)("img",{style:{zoom:"67%"},src:s(97312)}),(0,e.jsxs)("h4",{id:"123-\u98CE\u6247",children:[(0,e.jsx)("a",{"aria-hidden":"true",tabIndex:"-1",href:"#123-\u98CE\u6247",children:(0,e.jsx)("span",{className:"icon icon-link"})}),"1.2.3 \u98CE\u6247"]}),(0,e.jsx)("p",{children:(0,e.jsx)("img",{alt:"",src:s(86487)})}),(0,e.jsxs)("h4",{id:"124-xyz-\u9650\u4F4D",children:[(0,e.jsx)("a",{"aria-hidden":"true",tabIndex:"-1",href:"#124-xyz-\u9650\u4F4D",children:(0,e.jsx)("span",{className:"icon icon-link"})}),"1.2.4 xyz \u9650\u4F4D"]}),(0,e.jsx)("p",{children:(0,e.jsx)("img",{alt:"",src:s(87704)})}),(0,e.jsxs)("h4",{id:"125-\u63A2\u9488\u4F4D\u7F6E",children:[(0,e.jsx)("a",{"aria-hidden":"true",tabIndex:"-1",href:"#125-\u63A2\u9488\u4F4D\u7F6E",children:(0,e.jsx)("span",{className:"icon icon-link"})}),"1.2.5 \u63A2\u9488\u4F4D\u7F6E"]}),(0,e.jsx)("p",{children:(0,e.jsx)("img",{alt:"",src:s(97268)})}),(0,e.jsx)("p",{children:(0,e.jsx)("img",{alt:"",src:s(57320)})}),(0,e.jsxs)("h3",{id:"13-\u5904\u7406\u8B66\u544A",children:[(0,e.jsx)("a",{"aria-hidden":"true",tabIndex:"-1",href:"#13-\u5904\u7406\u8B66\u544A",children:(0,e.jsx)("span",{className:"icon icon-link"})}),"1.3 \u5904\u7406\u8B66\u544A"]}),(0,e.jsx)("p",{children:a.texts[49].value}),(0,e.jsxs)("ul",{children:[(0,e.jsx)("li",{children:a.texts[50].value}),(0,e.jsx)("li",{children:a.texts[51].value}),(0,e.jsx)("li",{children:a.texts[52].value}),(0,e.jsx)("li",{children:a.texts[53].value})]}),(0,e.jsx)("p",{children:a.texts[54].value}),(0,e.jsx)(d.Z,{lang:"properties",children:a.texts[55].value}),(0,e.jsxs)("p",{children:[a.texts[56].value,(0,e.jsx)("code",{children:a.texts[57].value}),a.texts[58].value,(0,e.jsx)("code",{children:a.texts[59].value}),a.texts[60].value,(0,e.jsx)("a",{href:"https://moonraker.readthedocs.io/en/latest/installation/#policykit-permissions",children:a.texts[61].value}),a.texts[62].value]}),(0,e.jsx)(d.Z,{lang:"shell",children:a.texts[63].value}),(0,e.jsxs)("h3",{id:"14-\u4F18\u5316\u63AA\u65BD",children:[(0,e.jsx)("a",{"aria-hidden":"true",tabIndex:"-1",href:"#14-\u4F18\u5316\u63AA\u65BD",children:(0,e.jsx)("span",{className:"icon icon-link"})}),"1.4 \u4F18\u5316\u63AA\u65BD"]}),(0,e.jsxs)("h4",{id:"141-\u4E3B\u677F\u6E29\u5EA6",children:[(0,e.jsx)("a",{"aria-hidden":"true",tabIndex:"-1",href:"#141-\u4E3B\u677F\u6E29\u5EA6",children:(0,e.jsx)("span",{className:"icon icon-link"})}),"1.4.1 \u4E3B\u677F\u6E29\u5EA6"]}),(0,e.jsx)(d.Z,{lang:"properties",children:a.texts[64].value}),(0,e.jsxs)("h4",{id:"142-\u6811\u8393\u6D3E",children:[(0,e.jsx)("a",{"aria-hidden":"true",tabIndex:"-1",href:"#142-\u6811\u8393\u6D3E",children:(0,e.jsx)("span",{className:"icon icon-link"})}),"1.4.2 \u6811\u8393\u6D3E"]}),(0,e.jsx)(d.Z,{lang:"properties",children:a.texts[65].value}),(0,e.jsxs)("h4",{id:"143-\u4ED3\u6E29",children:[(0,e.jsx)("a",{"aria-hidden":"true",tabIndex:"-1",href:"#143-\u4ED3\u6E29",children:(0,e.jsx)("span",{className:"icon icon-link"})}),"1.4.3 \u4ED3\u6E29"]}),(0,e.jsx)(d.Z,{lang:"properties",children:a.texts[66].value}),(0,e.jsxs)("h4",{id:"144-\u914D\u7F6E\u55B7\u5934\u706F\u5149",children:[(0,e.jsx)("a",{"aria-hidden":"true",tabIndex:"-1",href:"#144-\u914D\u7F6E\u55B7\u5934\u706F\u5149",children:(0,e.jsx)("span",{className:"icon icon-link"})}),"1.4.4 \u914D\u7F6E\u55B7\u5934\u706F\u5149"]})]}),(0,e.jsx)(l.rU,{to:"/voron/assembling/assembling-sb#4%E9%85%8D%E7%BD%AE%E7%81%AF%E5%85%89%E5%91%BD%E4%BB%A4",children:a.texts[67].value}),(0,e.jsxs)("div",{className:"markdown",children:[(0,e.jsxs)("h4",{id:"145-\u4F18\u5316\u6B65\u8FDB\u7535\u673A",children:[(0,e.jsx)("a",{"aria-hidden":"true",tabIndex:"-1",href:"#145-\u4F18\u5316\u6B65\u8FDB\u7535\u673A",children:(0,e.jsx)("span",{className:"icon icon-link"})}),"1.4.5 \u4F18\u5316\u6B65\u8FDB\u7535\u673A"]}),(0,e.jsxs)("ul",{children:[(0,e.jsx)("li",{children:a.texts[68].value}),(0,e.jsx)("li",{children:a.texts[69].value})]}),(0,e.jsx)("p",{children:a.texts[70].value}),(0,e.jsx)(d.Z,{lang:"properties",children:a.texts[71].value}),(0,e.jsxs)("h2",{id:"2-klipper-\u5E38\u89C1\u9519\u8BEF",children:[(0,e.jsx)("a",{"aria-hidden":"true",tabIndex:"-1",href:"#2-klipper-\u5E38\u89C1\u9519\u8BEF",children:(0,e.jsx)("span",{className:"icon icon-link"})}),"2 Klipper \u5E38\u89C1\u9519\u8BEF"]}),(0,e.jsxs)("h3",{id:"21-tmc-uart-error",children:[(0,e.jsx)("a",{"aria-hidden":"true",tabIndex:"-1",href:"#21-tmc-uart-error",children:(0,e.jsx)("span",{className:"icon icon-link"})}),"2.1 TMC UART Error"]}),(0,e.jsx)("p",{children:a.texts[72].value}),(0,e.jsx)("p",{children:(0,e.jsx)("img",{alt:"",src:s(22876)})}),(0,e.jsxs)("h3",{id:"22-adc-error-\u6E29\u5EA6\u9519\u8BEF",children:[(0,e.jsx)("a",{"aria-hidden":"true",tabIndex:"-1",href:"#22-adc-error-\u6E29\u5EA6\u9519\u8BEF",children:(0,e.jsx)("span",{className:"icon icon-link"})}),"2.2 ADC Error \u6E29\u5EA6\u9519\u8BEF"]}),(0,e.jsx)("p",{children:a.texts[73].value}),(0,e.jsx)("p",{children:(0,e.jsx)("img",{alt:"",src:s(42461)})}),(0,e.jsx)("p",{children:a.texts[74].value}),(0,e.jsx)("p",{children:a.texts[75].value}),(0,e.jsx)("p",{children:a.texts[76].value}),(0,e.jsxs)("h3",{id:"23-currently-throttled",children:[(0,e.jsx)("a",{"aria-hidden":"true",tabIndex:"-1",href:"#23-currently-throttled",children:(0,e.jsx)("span",{className:"icon icon-link"})}),"2.3 Currently Throttled"]}),(0,e.jsx)("p",{children:a.texts[77].value}),(0,e.jsx)("p",{children:(0,e.jsx)("img",{alt:"",src:s(97636)})}),(0,e.jsxs)("h3",{id:"24-\u4FEE\u6539\u914D\u7F6E\u6587\u4EF6\u540E\u4E0D\u751F\u6548",children:[(0,e.jsx)("a",{"aria-hidden":"true",tabIndex:"-1",href:"#24-\u4FEE\u6539\u914D\u7F6E\u6587\u4EF6\u540E\u4E0D\u751F\u6548",children:(0,e.jsx)("span",{className:"icon icon-link"})}),"2.4 \u4FEE\u6539\u914D\u7F6E\u6587\u4EF6\u540E\u4E0D\u751F\u6548"]}),(0,e.jsxs)("p",{children:[a.texts[78].value,(0,e.jsx)("code",{children:a.texts[79].value}),a.texts[80].value]}),(0,e.jsxs)("p",{children:[a.texts[81].value,(0,e.jsx)("code",{children:a.texts[82].value})]}),(0,e.jsx)("p",{children:(0,e.jsx)("img",{alt:"",src:s(44045)})}),(0,e.jsxs)("h3",{id:"25-pid-\u9519\u8BEF",children:[(0,e.jsx)("a",{"aria-hidden":"true",tabIndex:"-1",href:"#25-pid-\u9519\u8BEF",children:(0,e.jsx)("span",{className:"icon icon-link"})}),"2.5 Pid \u9519\u8BEF"]}),(0,e.jsx)("p",{children:a.texts[83].value}),(0,e.jsx)("p",{children:a.texts[84].value}),(0,e.jsx)("p",{children:(0,e.jsx)("img",{alt:"",src:s(59010)})}),(0,e.jsx)("p",{children:a.texts[85].value}),(0,e.jsx)("p",{children:(0,e.jsx)("img",{alt:"",src:s(33415)})}),(0,e.jsxs)("h3",{id:"26-\u6E29\u5EA6\u5347\u4E0D\u4E0A\u53BB",children:[(0,e.jsx)("a",{"aria-hidden":"true",tabIndex:"-1",href:"#26-\u6E29\u5EA6\u5347\u4E0D\u4E0A\u53BB",children:(0,e.jsx)("span",{className:"icon icon-link"})}),"2.6 \u6E29\u5EA6\u5347\u4E0D\u4E0A\u53BB"]}),(0,e.jsx)("p",{children:a.texts[86].value}),(0,e.jsx)("p",{children:(0,e.jsx)("img",{alt:"",src:s(77247)})}),(0,e.jsx)(d.Z,{lang:"properties",children:a.texts[87].value}),(0,e.jsxs)("h3",{id:"27-tmc-error",children:[(0,e.jsx)("a",{"aria-hidden":"true",tabIndex:"-1",href:"#27-tmc-error",children:(0,e.jsx)("span",{className:"icon icon-link"})}),"2.7 TMC Error"]}),(0,e.jsx)("p",{children:(0,e.jsx)("a",{href:"https://www.klipper3d.org/TMC_Drivers.html#why-did-i-get-a-tmc-reports-error-error",children:a.texts[88].value})}),(0,e.jsx)("img",{style:{zoom:"67%"},src:s(14348)}),(0,e.jsx)(d.Z,{children:a.texts[89].value}),(0,e.jsxs)("h4",{id:"ot1overtemperror",children:[(0,e.jsx)("a",{"aria-hidden":"true",tabIndex:"-1",href:"#ot1overtemperror",children:(0,e.jsx)("span",{className:"icon icon-link"})}),"ot=1(OvertempError!)"]}),(0,e.jsx)("p",{children:a.texts[90].value}),(0,e.jsxs)("h4",{id:"shorttogndlowsideshort",children:[(0,e.jsx)("a",{"aria-hidden":"true",tabIndex:"-1",href:"#shorttogndlowsideshort",children:(0,e.jsx)("span",{className:"icon icon-link"})}),"ShortToGNDLowSideShort"]}),(0,e.jsx)("p",{children:a.texts[91].value}),(0,e.jsx)("p",{children:a.texts[92].value}),(0,e.jsxs)("h4",{id:"reset1resetcs_actual0resetse0reset",children:[(0,e.jsx)("a",{"aria-hidden":"true",tabIndex:"-1",href:"#reset1resetcs_actual0resetse0reset",children:(0,e.jsx)("span",{className:"icon icon-link"})}),"reset=1(Reset)CS_ACTUAL=0(Reset?)SE=0(Reset?)"]}),(0,e.jsx)("p",{children:a.texts[93].value}),(0,e.jsxs)("h4",{id:"uv_cp1undervoltage",children:[(0,e.jsx)("a",{"aria-hidden":"true",tabIndex:"-1",href:"#uv_cp1undervoltage",children:(0,e.jsx)("span",{className:"icon icon-link"})}),"uv_cp=1(Undervoltage!)"]}),(0,e.jsx)("p",{children:a.texts[94].value}),(0,e.jsxs)("h2",{id:"3-klipper-\u6545\u969C\u6392\u9664",children:[(0,e.jsx)("a",{"aria-hidden":"true",tabIndex:"-1",href:"#3-klipper-\u6545\u969C\u6392\u9664",children:(0,e.jsx)("span",{className:"icon icon-link"})}),"3 Klipper \u6545\u969C\u6392\u9664"]}),(0,e.jsx)("p",{children:a.texts[95].value}),(0,e.jsx)("p",{children:(0,e.jsx)("img",{alt:"",src:s(68338)})}),(0,e.jsxs)("h2",{id:"4-\u786C\u4EF6\u6545\u969C",children:[(0,e.jsx)("a",{"aria-hidden":"true",tabIndex:"-1",href:"#4-\u786C\u4EF6\u6545\u969C",children:(0,e.jsx)("span",{className:"icon icon-link"})}),"4 \u786C\u4EF6\u6545\u969C"]}),(0,e.jsx)("p",{children:a.texts[96].value}),(0,e.jsxs)("h3",{id:"41-\u70ED\u654F\u77ED\u8DEF",children:[(0,e.jsx)("a",{"aria-hidden":"true",tabIndex:"-1",href:"#41-\u70ED\u654F\u77ED\u8DEF",children:(0,e.jsx)("span",{className:"icon icon-link"})}),"4.1 \u70ED\u654F\u77ED\u8DEF"]}),(0,e.jsx)("p",{children:a.texts[97].value}),(0,e.jsxs)("h3",{id:"42-\u7535\u673A\u6296\u52A8",children:[(0,e.jsx)("a",{"aria-hidden":"true",tabIndex:"-1",href:"#42-\u7535\u673A\u6296\u52A8",children:(0,e.jsx)("span",{className:"icon icon-link"})}),"4.2 \u7535\u673A\u6296\u52A8"]}),(0,e.jsx)("p",{children:a.texts[98].value}),(0,e.jsxs)("ul",{children:[(0,e.jsx)("li",{children:a.texts[99].value}),(0,e.jsx)("li",{children:a.texts[100].value})]}),(0,e.jsxs)("h3",{id:"43-\u4E3B\u677F\u6ECB\u6ECB\u58F0\u97F3",children:[(0,e.jsx)("a",{"aria-hidden":"true",tabIndex:"-1",href:"#43-\u4E3B\u677F\u6ECB\u6ECB\u58F0\u97F3",children:(0,e.jsx)("span",{className:"icon icon-link"})}),"4.3 \u4E3B\u677F\u6ECB\u6ECB\u58F0\u97F3"]}),(0,e.jsx)("p",{children:(0,e.jsx)("strong",{children:a.texts[101].value})}),(0,e.jsx)("p",{children:a.texts[102].value}),(0,e.jsxs)("p",{children:[a.texts[103].value,(0,e.jsx)("code",{children:a.texts[104].value}),a.texts[105].value]}),(0,e.jsxs)("h3",{id:"44-\u6A21\u578B\u51B7\u5374\u98CE\u6247\u5F02\u5E38",children:[(0,e.jsx)("a",{"aria-hidden":"true",tabIndex:"-1",href:"#44-\u6A21\u578B\u51B7\u5374\u98CE\u6247\u5F02\u5E38",children:(0,e.jsx)("span",{className:"icon icon-link"})}),"4.4 \u6A21\u578B\u51B7\u5374\u98CE\u6247\u5F02\u5E38"]}),(0,e.jsx)("p",{children:a.texts[106].value}),(0,e.jsx)("p",{children:a.texts[107].value})]})]})})})}t.default=c},92827:function(n,t,s){s.r(t),s.d(t,{texts:function(){return r}});const r=[{value:"Fluidd\u4E0EMainsail\u7684\u914D\u7F6E\u90FD\u5DEE\u4E0D\u591A\uFF0C\u8FD9\u91CC\u4F7F\u7528\u4E86Fluidd\u7684\u56FE\u7247\uFF0C\u4F46\u662F\u5EFA\u8BAE\u4F7F\u7528Mainsail\u3002",paraId:0},{value:"\u5927\u90E8\u5206\u7684\u6545\u969C\u662F\u63A5\u7EBF\u9519\u8BEF\uFF0C\u7EBF\u8DEF\u677E\u7684\u95EE\u9898\uFF0C\u6240\u4EE5\u6709\u4E00\u4E2A\u4E07\u7528\u8868\u4E0E\u76F8\u5E94\u7684\u5939\u5B50\uFF0C\u5BF9\u6392\u9664\u4E0B\u9762\u7684\u6545\u969C\u4F1A\u5F88\u91CD\u8981\u3002",paraId:1,tocIndex:0},{value:"\u53EF\u4EE5\u5728\u4E3B\u677F\u63D0\u4F9B\u7684",paraId:2,tocIndex:1},{value:"printer.cfg",paraId:2,tocIndex:1},{value:"\u6A21\u677F\u6216\u8005\u7F51\u53CB\u7684\u63D0\u4F9B\u7684\u6A21\u677F\u57FA\u7840\u4E0A\u8FDB\u884C\u4FEE\u6539\u3002",paraId:2,tocIndex:1},{value:"printer.cfg",paraId:3,tocIndex:2},{value:" \u662F",paraId:3,tocIndex:2},{value:"klipper",paraId:3,tocIndex:2},{value:"\u91CD\u8981\u7684\u914D\u7F6E\u6587\u4EF6\uFF0C\u5173\u4E8E\u6253\u5370\u673A\u7684\u6240\u6709\u53C2\u6570\uFF0C\u90FD\u662F\u9700\u8981\u5728\u8FD9\u4EFD\u6587\u4EF6\u91CC\u8FDB\u884C\u914D\u7F6E\u3002",paraId:3,tocIndex:2},{value:"\u8718\u86DB\u4E3B\u677F\u63D0\u4F9B\u4E86\u9488\u5BF9 ",paraId:4,tocIndex:2},{value:"Voron2.4",paraId:4,tocIndex:2},{value:" \u6253\u5370\u673A\u7684\u914D\u7F6E\u6587\u4EF6",paraId:4,tocIndex:2},{value:"/firmware/Klipper/printer.cfg",paraId:4,tocIndex:2},{value:"\uFF0C\u53EF\u4EE5\u63D0\u524D\u4E0B\u8F7D\u4E0B\u6765\u3002",paraId:4,tocIndex:2},{value:"github:",paraId:5,tocIndex:2},{value:"FYSETC-SPIDER/printer.cfg at main \xB7 FYSETC/FYSETC-SPIDER \xB7 GitHub",paraId:5,tocIndex:2},{value:"gitee: ",paraId:5,tocIndex:2},{value:"firmware/Klipper/printer.cfg \xB7 FYSETC/FYSETC-SPIDER - Gitee.com",paraId:5,tocIndex:2},{value:"\u5728\u201C\u914D\u7F6E\u201D\u9009\u9879\u5361\u91CC\u627E\u5230\u201C+\u201D\uFF0C\u70B9\u51FB\u6DFB\u52A0\u6587\u4EF6\uFF08\u5982\u4E0B\u56FE\uFF09",paraId:6,tocIndex:2},{value:"\u8F93\u5165\u6587\u4EF6\u540D\u201Cprinter.cfg\u201D\uFF0C\u70B9\u51FB\u4FDD\u5B58\u3002",paraId:7,tocIndex:2},{value:"\u5355\u51FB\u65B0\u6DFB\u52A0\u7684\u6587\u4EF6\u201Cprinter.cfg\u201D\uFF0C\u9009\u62E9\u201C\u7F16\u8F91\u201D",paraId:8,tocIndex:2},{value:"\u8FDB\u5165\u7F16\u8F91\u754C\u9762\uFF0C\u5C06\u672C\u6587\u6700\u540E\u9644\u5F55\u5185\u7684 SPIDER \u4E3B\u677F\u7684\u914D\u7F6E\u4FE1\u606F\u590D\u5236\u7C98\u8D34\u5230\u6B64\u6587\u4EF6\u5185\uFF0C\u5E76\u6839\u636E\u914D\u7F6E\u6587\u4EF6\u7684\u4E2D \u6587\u6CE8\u91CA\uFF0C\u4FEE\u6539\u76F8\u5173\u5185\u5BB9\u3002\u6700\u540E\u70B9\u51FB\u4FDD\u5B58\u5E76\u91CD\u542F\u3002",paraId:9,tocIndex:2},{value:"\u5982\u5404\u9879\u53C2\u6570\u5168\u90E8\u6B63\u786E\uFF0CKlipper \u4F1A\u81EA\u52A8\u8FDE\u63A5\u6253\u5370\u673A\uFF0C\u5DE5\u5177\u680F\u7B49\u4F1A\u81EA\u52A8\u663E\u793A\uFF0C\u6309\u94AE\u53EF\u4EE5\u64CD\u4F5C\u3002",paraId:10,tocIndex:2},{value:"\u914D\u7F6E\u6587\u4EF6\u4E2D\u63D0\u793A\u8981\u4FEE\u6539\u7684\u5185\u5BB9",paraId:11,tocIndex:3},{value:`## *** THINGS TO CHANGE/CHECK: ***
## Spider version                       Please search this file for "SpiderVersion" and uncomment the appropriate line for each
## MCU paths                            [mcu] section
## Thermistor types                     [extruder] and [heater_bed] sections - See 'sensor types' list at end of file
## Z Endstop Switch location            [safe_z_home] section
## Homing end position                  [gcode_macro G32] section
## Z Endstop Switch  offset for Z0      [stepper_z] section
## Probe points                         [quad_gantry_level] section
## Min & Max gantry corner postions     [quad_gantry_level] section
## PID tune                             [extruder] and [heater_bed] sections
## Fine tune E steps                    [extruder] section
`,paraId:12,tocIndex:3},{value:"\u901A\u8FC7\u4E32\u53E3\u6765\u8FDE\u63A5\u8718\u86DB\u548C\u6811\u8393\u6D3E\uFF0C\u5F53\u524D\u4F7F\u7528\u7684\u65F6 Uart \u65B9\u5F0F\u3002",paraId:13,tocIndex:4},{value:"Spider2.3 \u63D0\u4F9B\u7684\u6587\u4EF6\u70ED\u5E8A\u7684",paraId:14,tocIndex:5},{value:"max_power",paraId:14,tocIndex:5},{value:"\u9ED8\u8BA4\u7684\u662F 0.6\uFF0C\u8FD9\u6837\u505A\u6709\u5565\u597D\u5904\u5462\uFF1F\u6700\u521D\u4EE5\u4E3A 0.6 \u662F\u4E3A\u4E86\u7ED9\u4E3B\u677F\u7701\u70B9\uFF0C\u56E0\u4E3A\u662F 220V \u76F4\u6D41\u7535\u52A0\u70ED\u7684\uFF0C\u4F7F\u7528\u4E86\u7EE7\u7535\u5668\u4F9B\u7535\uFF0C\u6CA1\u6709\u5FC5\u8981\u6D88\u8017\u90A3\u4E48\u591A\u7535\u6D41\u3002\u4F46\u662F\u901A\u8FC7\u5B9E\u9A8C\uFF0C\u5C06",paraId:14,tocIndex:5},{value:"max_power",paraId:14,tocIndex:5},{value:"\u8BBE\u7F6E\u6210 1\uFF0C\u52A0\u70ED\u5230 100 \u5EA6\uFF0C\u7528\u4E86\u4E0D\u5230\u4E09\u5206\u4E4B\u4E00\u7684\u65F6\u95F4\u3002\u73B0\u5728\u6CA1\u6709\u5F04\u660E\u767D 0.6 \u7684\u5177\u4F53\u542B\u4E49\uFF1F",paraId:14,tocIndex:5},{value:"\u4E0B\u9762\u662F",paraId:15,tocIndex:5},{value:"0.6",paraId:15,tocIndex:5},{value:"\u7684\u52A0\u70ED\u65F6\u95F4\uFF0C\u52A0\u70ED\u5230 100\xB0 \u9700\u8981 10 \u5206\u949F\u3002\u6700\u540E\u628A\u53C2\u6570\u8BBE\u7F6E\u52300.8\uFF0C\u52A0\u70ED\u6162\u70B9\uFF0C\u8BA9\u70ED\u5E8A\u53D8\u5F62\u4E0D\u90A3\u4E48\u4E25\u91CD\u3002",paraId:15,tocIndex:5},{value:"\u7ECF\u8FC7\u4E00\u5468\u7684\u6D4B\u8BD5\uFF0C\u53D1\u73B00.6\u8FD9\u4E2A\u53C2\u6570\u7684\u8BBE\u7F6E\u662F\u5408\u7406\u7684\uFF0C\u76EE\u7684\u662F\u5F3A\u5236\u8BA9\u4F60\u52A0\u70ED10\u5206\u949F",paraId:16},{value:"\u70ED\u80C0\u51B7\u7F29\u4E0D\u662F\u6E29\u5EA6\u4E0A\u53BB\u4E86\uFF0C\u5B83\u5C31\u9A6C\u4E0A\u81A8\u80C0\uFF0C\u800C\u662F\u4E00\u4E2A\u7F13\u6162\u7684\u8FC7\u7A0B\uFF0C10\u5206\u949F\u300120\u5206\u949F\u300130\u5206\u949F\u540E\u90FD\u5728\u81A8\u80C0\uFF0C\u4E5F\u5C31\u662F\u8BF43\u5206\u949F\u6E29\u5EA6\u5230\u4F4D\u4E86\uFF0C\u4F46\u662F\u81A8\u80C0\u8FD8\u6CA1\u6709\u7ED3\u675F\u3002",paraId:17},{value:"\u8FD9\u4E2A\u5728\u9996\u5C42\u6821\u51C6\u5B9E\u9A8C\u5C31\u7279\u522B\u660E\u663E\uFF0C\u4EC0\u4E48\u53C2\u6570\u90FD\u4E0D\u53D8\uFF0C\u6253\u5370\u7B2C\u4E00\u4E2A\u770B\u6A21\u578B\u770B\u55B7\u5634\u79BB\u70ED\u5E8A\u8FDC\uFF0C\u4F60\u52A0\u70ED\u70ED\u5E8A\u7B4940\u5206\u949F\uFF0C\u4F60\u4F1A\u53D1\u73B0\u55B7\u5634\u79BB\u70ED\u5E8A\u53C8\u8FD1\u4E86\u3002",paraId:17},{value:"\u4E0B\u9762\u662F",paraId:18},{value:"1.0",paraId:18},{value:"\u7684\u52A0\u70ED\u65F6\u95F4\uFF0C\u52A0\u70ED\u5230 100\xB0 \u9700\u8981 3 \u5206\u534A",paraId:18},{value:"\u6211\u4E70\u7684",paraId:19},{value:"\u70ED\u5E8A",paraId:19},{value:"\u7684\u70ED\u654F\u7535\u963B\u662F:NTC100K",paraId:19},{value:"Spider2.3 \u63D0\u4F9B\u7684\u6587\u4EF6\u4E2D\u70ED\u5E8A\u7684\u4F20\u611F\u5668\u662F",paraId:20},{value:"Generic 3950",paraId:20},{value:"\uFF0C\u6211\u8981\u4FEE\u6539\u6210 NTC100K\uFF0C\u7528\u4E07\u7528\u8868\u8FDB\u884C\u6D4B\u91CF\uFF1A",paraId:20},{value:"25\xB0 \u65F6\uFF0C\u6E29\u5EA6\u57FA\u672C\u4E00\u81F4",paraId:21},{value:"60\xB0 \u65F6\uFF0C\u6E29\u5EA6\u504F\u5DEE 5\xB0 \u5DE6\u53F3",paraId:21},{value:"100\xB0 \u65F6\uFF0C\u6E29\u5EA6\u5DEE 25\xB0 \u5DE6\u53F3",paraId:21},{value:"Fluidd\u4F1A\u51FA\u73B0\u4E0B\u5217\u8B66\u544A\uFF0CMainsail\u5DF2\u7ECF\u5185\u7F6E\u4E86\u76F8\u5173\u7684\u4EE3\u7801\u3002",paraId:22,tocIndex:9},{value:"\u865A\u62DF SD \u5361",paraId:23,tocIndex:9},{value:"\u6682\u505C\u7EE7\u7EED\u8BBE\u7F6E",paraId:23,tocIndex:9},{value:"\u53D6\u6D88\u6253\u5370",paraId:23,tocIndex:9},{value:"\u53D1\u73B0 Moonraker \u8B66\u544A\uFF0C\u68C0\u6D4B\u5230 PolKit \u8B66\u544A\u3002",paraId:23,tocIndex:9},{value:"\u628A\u4E0B\u9762\u4EE3\u7801\u590D\u5236\u5230config\u5C31\u53EF\u4EE5\u4E86\u3002",paraId:24,tocIndex:9},{value:`## Virtual SD Card                  # \u865A\u62DFSD\u5361
[virtual_sdcard]                   # \u542F\u7528\u865A\u62DFSD\u5361
path: /home/pi/gcode_files         #\u4E0A\u4F20\u76EE\u5F55\u4E3A\u865A\u62DFSD\u5361\u6839\u76EE\u5F55

# Pause/Resume Functionality
[pause_resume]

[gcode_macro CANCEL_PRINT]
rename_existing: BASE_CANCEL_PRINT
gcode:
    TURN_OFF_HEATERS
    CLEAR_PAUSE
    SDCARD_RESET_FILE
	BASE_CANCEL_PRINT
`,paraId:25,tocIndex:9},{value:"\u662F\u56E0\u4E3A",paraId:26,tocIndex:9},{value:"Moonraker",paraId:26,tocIndex:9},{value:"\u6CA1\u6709\u83B7\u53D6",paraId:26,tocIndex:9},{value:"sudo",paraId:26,tocIndex:9},{value:"\u6743\u9650\uFF0C\u53EA\u8981\u6309\u7167\u4E0B\u9762\u64CD\u4F5C\u5C31\u884C\u3002\u5176\u4ED6\u66F4\u590D\u6742\u7684\u8BF7\u770B",paraId:26,tocIndex:9},{value:"\u5B98\u65B9\u6587\u6863",paraId:26,tocIndex:9},{value:" \u3002",paraId:26,tocIndex:9},{value:`cd ~/moonraker/scripts
./set-policykit-rules.sh
sudo service moonraker restart
`,paraId:27,tocIndex:9},{value:`[temperature_sensor spider2.3]        #\u663E\u793A\u4E3B\u677F\u7684\u6E29\u5EA6
sensor_mcu: mcu
sensor_type: temperature_mcu
min_temp: 0
max_temp: 200
`,paraId:28,tocIndex:11},{value:`[temperature_sensor pi]     # \u6811\u8393\u6D3E\u6E29\u5EA6
sensor_type: temperature_host
min_temp: 0
max_temp: 100
`,paraId:29,tocIndex:12},{value:`[temperature_sensor \u4ED3\u6E29]
sensor_type: EPCOS 100K B57560G104F
sensor_pin: PC1
pullup_resistor:4700
`,paraId:30,tocIndex:13},{value:"\u5173\u4E8E SB \u5934\u7684\u706F\u5149\u914D\u7F6E\uFF0C\u53EF\u4EE5\u53C2\u8003\u8FD9\u91CC",paraId:31},{value:"stealthchop_threshold \u8BBE\u7F6E\u6210 200 \u53EF\u4EE5\u8D77\u5230\u9759\u97F3\u6A21\u5F0F",paraId:32,tocIndex:15},{value:"\u6324\u51FA\u673A\u53EF\u4EE5\u8BBE\u7F6E\u6210100\u3002",paraId:32,tocIndex:15},{value:"\u542C\u8BF4\u6324\u51FA\u673A\u53D1\u70ED\uFF0C\u662F\u4E0D\u662F\u53EF\u4EE5\u8C03\u4F4E\u4E00\u70B9\u3002",paraId:33,tocIndex:15},{value:`[tmc2208 stepper_x]
uart_pin:
#   \u8FDE\u63A5\u5230TMC2208\u7684PDN_UART\u7684\u811A
#   \u8FD9\u4E2A\u53C2\u6570\u5FC5\u987B\u7ED9\u5B9A
#tx_pin:
#   \u5982\u679C\u4F7F\u7528\u5206\u79BB\u63A5\u6536\u548C\u53D1\u9001\u7EBF\u7684\u65B9\u5F0F\u548C\u9A71\u52A8\u5668\u901A\u8BAF
#   \u53EF\u4EE5\u8BBE\u7F6Euart_pin\u6765\u4F5C\u4E3A\u63A5\u6536\u811A\uFF0Ctx_pin\u4F5C\u4E3A\u53D1\u9001\u811A
#   \u9ED8\u8BA4\u662F\u4F7F\u7528uart_pin\u6765\u8BFB\u5199
#select_pins:
#   \u4E00\u4E2A\u4F7F\u7528\uFF08\u82F1\u6587\uFF09\u9017\u53F7\u5206\u9694\u7684\u5F15\u811A\u7684\u5217\u8868\u3002
#   \u8FD9\u662F\u8BBF\u95EEtmc2208\u7684UART\u4E4B\u524D\u8981\u8BBE\u7F6E\u7684\u5F15\u811A\u5217\u8868\u3002
#   \u9700\u8981\u914D\u7F6E\u6A21\u62DF\u5F00\u5173\u6765\u5B9E\u73B0\u4E32\u53E3\u901A\u8BAF\u65F6\u53EF\u80FD\u5F88\u6709\u7528
#   \u9ED8\u8BA4\u662F\u4E0D\u914D\u7F6E\u4EFB\u4F55\u5F15\u811A
#interpolate: True
#   \u5982\u679C\u4E3ATrue\uFF0C\u4F7F\u80FD\u63D2\u8865\uFF08\u9A71\u52A8\u5668\u4F1A\u5728\u5185\u90E8\u4F7F\u7528256\u5FAE\u6B65\uFF09
#   \u8FD9\u4E2A\u63D2\u8865\u4F1A\u5E26\u6765\u4E00\u4E2A\u5C0F\u7684\u7CFB\u7EDF\u4F4D\u7F6E\u504F\u5DEE
#   \u8BE6\u89C1TMC_Drivers.md
#   \u9ED8\u8BA4\u503C\u662FTrue
run_current:
#   \u914D\u7F6E\u9A71\u52A8\u5668\u5728\u9A71\u52A8\u6B65\u8FDB\u7535\u673A\u79FB\u52A8\u65F6\u7684\u7535\u6D41\uFF08\u4EE5\u7535\u6D41\u7684\u6709\u6548\u503C\u5B89\u57F9\u4E3A\u5355\u4F4D\uFF09
#   \u8FD9\u4E2A\u53C2\u6570\u5FC5\u987B\u7ED9\u5B9A
#hold_current:
#   \u914D\u7F6E\u9A71\u52A8\u5668\u5728\u6B65\u8FDB\u7535\u673A\u4E0D\u79FB\u52A8\u65F6\u7684\u7535\u6D41\uFF08\u4EE5\u7535\u6D41\u7684\u6709\u6548\u503C\u5B89\u57F9\u4E3A\u5355\u4F4D\uFF09
#   \u4E0D\u5EFA\u8BAE\u8BBE\u7F6E\u4FDD\u6301\u7535\u6D41\uFF08\u8BE6\u89C1TMC_Drivers.md\uFF09
#   \u9ED8\u8BA4\u662F\u4E0D\u51CF\u5C11\u7535\u6D41
#sense_resistor: 0.110
#   \u7535\u673A\u91C7\u6837\u7535\u963B\u963B\u503C\uFF08\u4EE5\u6B27\u59C6\u4E3A\u5355\u4F4D\uFF09
#   \u9ED8\u8BA4\u662F0.110\u6B27\u59C6
#stealthchop_threshold: 0
#   \u8BBE\u7F6EstealthChop\u6A21\u5F0F\u7684\u95E8\u69DB\u901F\u5EA6\uFF08\u4EE5\u6BEB\u7C73\u6BCF\u79D2\u4E3A\u5355\u4F4D\uFF09
#   \u5F53\u8BBE\u7F6E\u4E86\u8FD9\u4E2A\u91CF\uFF0C\u6B65\u8FDB\u7535\u673A\u901F\u5EA6\u4F4E\u4E8E\u8FD9\u4E2A\u503C\u65F6\u4F1A\u542F\u7528stealthChop\u6A21\u5F0F
#   \u9ED8\u8BA4\u662F0\uFF0C\u610F\u5473\u7740\u5931\u80FD\u4E86stealthChop\u6A21\u5F0F
`,paraId:34,tocIndex:15},{value:"TMC UART Error: \u5F53 TMC \u9A71\u52A8\u7A0B\u5E8F\u548C Spider \u4E3B\u677F\u4E4B\u95F4\u7684\u901A\u8BAF\u5931\u6548\u65F6\uFF0C\u5C31\u4F1A\u51FA\u73B0\u8FD9\u79CD\u60C5\u51B5\u3002\u5F15\u8D77\u4E0A\u8FF0\u6545\u969C \u53EF\u80FD\u6CA1\u6709\u7ED9 Spider \u4E3B\u677F\u63D0\u4F9B 24V \u7684\u7535\u6E90\uFF08TMC \u9A71\u52A8\u5668\u6CA1\u6709\u542F\u52A8\uFF09\uFF0C\u6216\u8005 TMC \u6B65\u8FDB\u9A71\u52A8\u6A21\u5757\u6CA1\u6709\u63D2\u5165\u6B63\u786E \u7684\u4F4D\u7F6E\uFF0C\u6216\u8005\u9A71\u52A8\u5668\u7684\u8DF3\u7EBF\u8BBE\u7F6E\u9519\u8BEF\uFF0C\u8BF7\u91CD\u65B0\u68C0\u67E5\u4EE5\u4E0A\u95EE\u9898\u70B9\u3002",paraId:35,tocIndex:17},{value:'ADC Error: ADC \u662F "\u6A21\u6570\u8F6C\u6362\u5668 "\u7684\u7F29\u5199\uFF0C\u7528\u4E8E\u5C06\u70ED\u654F\u7535\u963B\u8BFB\u6570\u8F6C\u6362\u4E3A\u6324\u51FA\u5934\u548C\u70ED\u5E8A\u7684\u6E29\u5EA6\u3002\u4F5C\u4E3A\u4E00 \u79CD\u5B89 \u5168\u9884\u9632\u63AA\u65BD\uFF0C\u4E00\u65E6 Klipper \u68C0\u6D4B\u5230\u6E29\u5EA6\u8D85\u8FC7\u6700\u5927\u6216\u6700\u5C0F\u9600\u503C\uFF08\u70ED\u654F\u7535\u963B\u53EF\u80FD\u5F00\u8DEF\u6216\u8005\u77ED\u8DEF\uFF09\uFF0C\u7CFB\u7EDF\u5C06\u8FDB\u5165 \u5173\u95ED\u4FDD\u62A4\u6A21\u5F0F\u3002\u8BF7\u4ED4\u7EC6\u68C0\u67E5\uFF0C\u786E\u4FDD\u70ED\u654F\u7535\u963B\u88AB\u63D2\u5165\u5230\u6B63\u786E\u7684\u63D2\u5EA7\u4E0A\u3002',paraId:36,tocIndex:18},{value:"\u628A\u96C6\u6210\u677F\u7684\u7EBF\u7ED9\u62D4\u6389\u4E86\uFF0C\u627E\u4E0D\u5230\u4E86\u6E29\u63A7\u8BBE\u5907\u3002\u5FC5\u987B\u8981\u628A\u70ED\u5E8A\u4E0E\u98CE\u6247\u90FD\u7ED9\u63D2\u4E0A\u4E3B\u677F\u3002",paraId:37,tocIndex:18},{value:"\u6848\u4F8B\uFF1A",paraId:38,tocIndex:18},{value:"\u63D2\u4E0A\u4E5F\u53D1\u73B0\u4E0D\u5BF9\uFF0C\u628A\u70ED\u5E8A\u4E0E\u70ED\u7AEF\u7684\u70ED\u654F\u90FD\u62D4\u4E0B\u6765\uFF0C\u7136\u540E\u7528\u4E07\u7528\u8868\u6D4B\u91CF\u4E24\u6761\u7EBF\uFF0C\u53D1\u73B0\u70ED\u7AEF\u7684\u77ED\u8DEF\u3002\u628A E3DV6 \u62C6\u5F00\u540E\uFF0C\u53D1\u73B0\u70ED\u654F\u7535\u963B\u77ED\u8DEF\u4E86\uFF0C\u505A\u4E86\u7EDD\u7F18\u540E\uFF0C\u7136\u540E\u88C5\u4E0A\u5C31\u597D\u4E86\u3002",paraId:39,tocIndex:18},{value:"Currently Throttled\uFF1A \u6811\u8393\u6D3E\u4F9B\u7535\u4E0D\u8DB3\u6216\u7535\u538B\u4E0D\u7A33\u65F6\uFF0C\u5C06\u4F1A\u6709\u5982\u4E0B\u62A5\u9519\uFF0C\u9700\u66F4\u6362\u66F4\u7C97\u7684\u7535\u6E90\u7EBF\u6216\u8005\u66F4\u6362 \u66F4\u5927\u529F\u7387\u7684\u7535\u6E90\u3002",paraId:40,tocIndex:19},{value:"\u4FEE\u6539\u914D\u7F6E\u6587\u4EF6\u540E\uFF0C\u70B9\u51FB SAVE&RESTART ,\u63D0\u793A\u8FD9\u4E2A\u9519\u8BEF\uFF1A",paraId:41,tocIndex:20},{value:"Failed automated reset of MCU 'mcu'",paraId:41,tocIndex:20},{value:" \u600E\u4E48\u89E3\u51B3\uFF1F",paraId:41,tocIndex:20},{value:"\u89E3\u51B3\u65B9\u6CD5\uFF1A\u7B49\u4E00\u4F1A\uFF0C\u70B9\u51FB",paraId:42,tocIndex:20},{value:"RESTART KLIPPER",paraId:42,tocIndex:20},{value:"\u5012\u9709\uFF0C\u4E70\u4E86\u4E00\u4E2A e3dv6 \u7684\u5934\uFF0C\u6628\u5929\u53D1\u73B0\u70ED\u654F\u77ED\u8DEF\uFF0C\u4ECA\u5929\u53D1\u73B0\u52A0\u70ED\u5934\u6CA1\u6709\u52A0\u70ED\u3002",paraId:43,tocIndex:21},{value:"\u53D1\u73B0\u662F\u52A0\u70ED\u5934\u6CA1\u6709\u5728\u89C4\u5B9A\u7684\u65F6\u95F4\u5185\u8FDB\u884C\u52A0\u70ED\u3002\u89E3\u51B3\u65B9\u6CD5\uFF1A\u7528\u4E07\u7528\u8868\u6D4B\u91CF\u4E00\u4E0B\u7EBF\u8DEF\uFF0C\u8FD9\u91CC\u4F7F\u7528\u7684\u662F\u96C6\u7EBF\u677F\uFF0C\u7535\u6247\u4F1A\u8F6C\uFF0C\u8BF4\u660E 24V+\u6CA1\u6709\u95EE\u9898\uFF0C\u6240\u4EE5\u6D4B\u91CF\u4E00\u4E0B\u4E3B\u677F\u7684\u70ED\u7AEF\u52A0\u70ED V-\u5230\u52A0\u70ED\u5934\u7684\u662F\u5426\u6709\u95EE\u9898\u3002",paraId:44,tocIndex:21},{value:"\u63D0\u793A",paraId:45,tocIndex:21},{value:"\u8BBE\u7F6E\u7684 240 \u5EA6\uFF0C\u4F46\u662F\u5230 140 \u5EA6\u5C31\u4E0A\u4E0D\u53BB\u4E86\u3002\u98CE\u6247\u7684\u8F6C\u901F\u592A\u9AD8\uFF0C\u4E0D\u5C0F\u5FC3\u4E70\u4E86\u4E00\u4E2A 6000 \u8F74\u627F\u7684\u98CE\u6247\uFF0C\u76F4\u63A5\u628A\u52A0\u70ED\u5668\u7ED9\u5439\u5931\u53BB\u6E29\u5EA6\u4E86\u3002\u60F3\u60F3\u8FD8\u6709\u4E00\u4E2A 1 \u4E07\u8F6C\u7684\u53EF\u63A7\u98CE\u6247\uFF0C\u8FD9\u4E2A\u5C31\u66F4\u5389\u5BB3\u4E86\uFF0C\u4E00\u4E0D\u5C0F\u5FC3\u4E70\u591A\u4E86\u3002",paraId:46,tocIndex:22},{value:`[heater_fan hotend_fan]
##	Hotend Fan - FAN0 Connector
##  Uncomment below for SpiderVersion 1.x
#pin: PB0
##  Uncomment below for SpiderVersion 2.2
pin: PA13


max_power: 1.0
kick_start_time: 0.5
heater: extruder
heater_temp: 50.0
##	If you are experiencing back flow, you can reduce fan_speed
# \u62C5\u5FC3\u98CE\u901F\u8FC7\u5927\uFF0C\u6E29\u5EA6\u63D0\u9AD8\u4E0D\u4E0A\uFF0C\u964D\u4F4E\u4E86\u6E29\u5EA6 \uFF0C\u539F\u5148\u662F\uFF1Afan_speed: 1.0
fan_speed: 0.7
`,paraId:47,tocIndex:22},{value:"\u5B98\u65B9\u5206\u6790\u7684\u539F\u56E0",paraId:48,tocIndex:23},{value:`TMC 'extruder' reports error: DRV_STATUS: c00d0103 otpw=1(OvertempWarning!) ot=1(OvertempError!) t120=1 cs_actual=13 stealth=1 stst=1
Once the underlying issue is corrected, use the
"FIRMWARE_RESTART" command to reset the firmware, reload the
config, and restart the host software.
Printer is shutdown
`,paraId:49,tocIndex:23},{value:"\u8FD9\u8868\u660E\u7535\u673A\u9A71\u52A8\u5668\u7981\u7528\u4E86\u81EA\u5DF1\uFF0C\u56E0\u4E3A\u5B83\u53D8\u5F97\u592A\u70ED\u3002\u5178\u578B\u7684\u89E3\u51B3\u65B9\u6848\u662F\u964D\u4F4E\u6B65\u8FDB\u7535\u673A\u7535\u6D41\uFF0C \u589E\u52A0\u6B65\u8FDB\u7535\u673A\u9A71\u52A8\u5668\u7684\u51B7\u5374\uFF0C\u540C\u65F6\u6216\u8005\u589E\u52A0\u6B65\u8FDB\u7535\u673A\u7684\u51B7\u5374\u3002",paraId:50,tocIndex:24},{value:"\u8FD9\u8868\u793A\u9A71\u52A8\u7A0B\u5E8F\u5DF2\u7981\u7528\u81EA\u8EAB\uFF0C\u56E0\u4E3A\u5B83\u68C0\u6D4B\u5230\u975E\u5E38 \u9AD8\u7535\u6D41\u901A\u8FC7\u9A71\u52A8\u5668\u3002\u8FD9\u53EF\u80FD\u8868\u793A\u677E\u52A8\u6216 \u7ED5\u7EBF\u77ED\u81F3\u6B65\u8FDB\u7535\u673A\u6216\u6B65\u8FDB\u7535\u673A\u672C\u8EAB\u3002",paraId:51,tocIndex:25},{value:"\u5982\u679C\u4F7F\u7528\u9690\u8EAB\u65A9\u6CE2\u6A21\u5F0F\u548C TMC \u9A71\u52A8\u7A0B\u5E8F\uFF0C\u4E5F\u53EF\u80FD\u53D1\u751F\u6B64\u9519\u8BEF \u65E0\u6CD5\u51C6\u786E\u9884\u6D4B\u7535\u673A\u7684\u673A\u68B0\u8D1F\u8F7D\u3002 \uFF08\u5982\u679C\u9A71\u52A8\u7A0B\u5E8F\u505A\u51FA\u7CDF\u7CD5\u7684\u9884\u6D4B\uFF0C\u90A3\u4E48\u5B83\u53EF\u80FD\u4F1A\u53D1\u9001\u592A\u591A \u7535\u6D41\u901A\u8FC7\u7535\u673A\u5E76\u89E6\u53D1\u5176\u81EA\u8EAB\u7684\u8FC7\u6D41\u68C0\u6D4B\u3002 \u8981\u5BF9\u6B64\u8FDB\u884C\u6D4B\u8BD5\uFF0C\u8BF7\u7981\u7528\u9690\u8EAB\u65A9\u51FB\u6A21\u5F0F\u5E76\u68C0\u67E5\u9519\u8BEF\u662F\u5426 \u7EE7\u7EED\u53D1\u751F\u3002",paraId:52,tocIndex:25},{value:"\u8FD9\u8868\u793A\u9A71\u52A8\u7A0B\u5E8F\u5DF2\u5728\u6253\u5370\u8FC7\u7A0B\u4E2D\u91CD\u7F6E\u81EA\u8EAB\u3002\u8FD9\u53EF\u80FD\u662F \u7531\u4E8E\u7535\u538B\u6216\u63A5\u7EBF\u95EE\u9898\u3002",paraId:53,tocIndex:26},{value:"\u8FD9\u8868\u793A\u9A71\u52A8\u5668\u5DF2\u68C0\u6D4B\u5230\u4F4E\u7535\u538B\u4E8B\u4EF6\uFF0C\u5E76\u4E14 \u81EA\u5DF1\u6B8B\u75BE\u4E86\u3002\u8FD9\u53EF\u80FD\u662F\u7531\u4E8E\u63A5\u7EBF\u6216\u7535\u6E90\u95EE\u9898\u3002",paraId:54,tocIndex:27},{value:"\u53EF\u4EE5\u901A\u8FC7\u4E0B\u8F7D\u548C\u5206\u6790\u201CKLIPPER.LOG\u201D\u65E5\u5FD7\u6587\u4EF6\uFF0C\u534F\u52A9\u67E5\u627E\u5F15\u8D77\u6545\u969C\u7684\u539F\u56E0",paraId:55,tocIndex:28},{value:"\u5728\u8FDB\u884C\u4E0B\u9762\u68C0\u67E5\u8FC7\u6210\u529F\u53EF\u80FD\u4F1A\u51FA\u73B0\u786C\u4EF6\u6545\u969C\uFF0C\u8BB0\u5F55\u5982\u4E0B",paraId:56,tocIndex:29},{value:"\u7528\u4E07\u7528\u8868\u6D4B\u91CF\u70ED\u654F\uFF0C\u53D1\u73B0\u77ED\u8DEF\uFF0C\u8FD9\u65F6\u5019\u5927\u90E8\u5206\u662F\u5728\u55B7\u5934\u51FA\u7684\u70ED\u654F\u5B89\u88C5\u9519\u8BEF\u3002",paraId:57,tocIndex:30},{value:"\u7535\u673A\u7EBF\u7684\u95EE\u9898\uFF0C\u6362\u4E00\u6839\u7EBF\u8BD5\u8BD5\u3002",paraId:58,tocIndex:31},{value:"\u7EBF\u5E8F\u9519\u8BEF\uFF0C\u8FD9\u4E2A\u5E94\u8BE5\u5F88\u5BB9\u6613\u6392\u9664\u3002",paraId:59,tocIndex:31},{value:"\u63A5\u89E6\u4E0D\u826F\uFF0C4 \u6839\u7EBF\u4E2D\uFF0C\u6709\u4E00\u6839\u63A5\u89E6\u4E0D\u826F\uFF0C\u7528\u4E07\u7528\u8868\u6D4B\u91CF\u4E00\u4E0B\u3002",paraId:59,tocIndex:31},{value:"\u8FD9\u4E48\u6CA1\u53D1\u73B0\u600E\u4E48\u89E3\u51B3\u3002",paraId:60,tocIndex:32},{value:"\u8718\u86DB 2.3 \u4E3B\u677F\u901A\u7535\u542F\u52A8\u540E\u90FD\u6CA1\u6709\u58F0\u97F3\uFF0C\u4F46\u662F\u79FB\u52A8 xy \u540E\uFF0C\u53D1\u73B0\u4E3B\u677F\u4E00\u76F4\u6ECB\u6ECB\u7684\u54CD\uFF0C\u611F\u89C9\u50CF\u98CE\u6247\u6162\u8F6C\u7684\u58F0\u97F3\uFF0C\u5B9E\u9645\u4E0A\u6CA1\u6709\u5F00\u98CE\u6247\uFF0C\u786E\u5B9A\u662F\u4E3B\u677F\u7684\u58F0\u97F3\uFF0C\u8FD9\u662F\u5565\u95EE\u9898\uFF1F\u6B63\u5E38\u5417\uFF1F\u5DF2\u7ECF\u6392\u9664\u6389\u5176\u4ED6\u8BBE\u5907\u7684\u54CD\u58F0\uFF0C\u56E0\u4E3A\u628A\u5176\u4ED6\u8BBE\u5907\u90FD\u62D4\u6389\u4E86\u3002",paraId:61,tocIndex:32},{value:"\u542F\u52A8\u9759\u97F3\u529F\u80FD\uFF1A",paraId:62,tocIndex:32},{value:"stealthchop_threshold : 200",paraId:62,tocIndex:32},{value:"  \u5C31\u53EF\u4EE5\u4E86\u3002",paraId:62,tocIndex:32},{value:"\u73B0\u8C61\uFF1A\u5355\u72EC\u52A0\u70ED\u70ED\u5E8A\uFF0C\u6A21\u578B\u51B7\u5374\u98CE\u6247\u88AB\u542F\u52A8\u8D77\u6765\u3002  \u52A0\u70ED\u55B7\u5634\uFF0C\u6A21\u578B\u51B7\u5374\u98CE\u6247\u4E5F\u81EA\u52A8\u542F\u52A8\u3002",paraId:63,tocIndex:33},{value:"\u539F\u56E0\uFF1Aspider3.2\u4E3B\u677F\u4E0A\u7684\u98CE\u6247\u670924V 12V 5V\u7684\u8DF3\u7EBF\u63A7\u5236\u3002 \u8DF3\u7EBF\u5E3D\u63D2\u5EA7\u4E86\u3002\u4F8B\u5982\u98CE\u6247\u662F24V\uFF0C\u4F46\u662F\u8DF3\u7EBF\u5E3D\u63D2\u5165\u523012V\u4E0A\u4E86\u3002 (\u8FD9\u79CD\u60C5\u51B5\u5728\u4F7F\u7528\u55B7\u5934\u96C6\u7EBF\u677F\uFF0C\u516C\u752824V\u5730\u7EBF\u7684\u65F6\u5019\u9047\u5230\u4E86)\u3002",paraId:64,tocIndex:33}]},14348:function(n,t,s){n.exports=s.p+"static/error-extruder.b8cb0ad3.jpg"},59010:function(n,t,s){n.exports=s.p+"static/error-pid.ff13ee3d.jpg"},33415:function(n,t,s){n.exports=s.p+"static/error-pid2.ba8554cc.jpg"},77247:function(n,t,s){n.exports=s.p+"static/error-pid3.e1a40f1d.jpg"},33108:function(n,t,s){n.exports=s.p+"static/fluidd-mcu-tty.4879d1e5.jpg"},44045:function(n,t,s){n.exports=s.p+"static/fluidd-reset-error.aad9c830.jpg"},31035:function(n,t,s){n.exports=s.p+"static/heater-bed-test2.e23e349a.png"},58378:function(n,t,s){n.exports=s.p+"static/heater-bed-test3.0fbd42e3.png"},42461:function(n,t,s){n.exports=s.p+"static/klipper-error-mcu-shutdown.b4c02d2a.jpg"},97268:function(n,t,s){n.exports=s.p+"static/klipper-error-quad_gantry_level.56449b8a.jpg"},86487:function(n,t,s){n.exports=s.p+"static/klipper-fan-error.7cc96c97.jpg"},34296:function(n,t,s){n.exports=s.p+"static/klipper-heater-bed.0b0249fc.jpg"},57320:function(n,t,s){n.exports=s.p+"static/klipper-quad_gantry_level.1fea3a95.jpg"},87704:function(n,t,s){n.exports=s.p+"static/klipper-stepper_z-error.d4791388.jpg"},46926:function(n,t,s){n.exports=s.p+"static/klipper10.392a1ff6.jpg"},92809:function(n,t,s){n.exports=s.p+"static/klipper11.a28b7508.jpg"},62127:function(n,t,s){n.exports=s.p+"static/klipper12.24cbca37.jpg"},88433:function(n,t,s){n.exports=s.p+"static/klipper13.87621e1d.jpg"},69927:function(n,t,s){n.exports=s.p+"static/klipper14.d386e92a.jpg"},22876:function(n,t,s){n.exports=s.p+"static/klipper15.4234c951.jpg"},97636:function(n){n.exports="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"},68338:function(n,t,s){n.exports=s.p+"static/klipper18.0d458ee6.jpg"},82987:function(n,t,s){n.exports=s.p+"static/temp-test1.82459976.jpg"},60976:function(n,t,s){n.exports=s.p+"static/temp-test2.dfaa0656.jpg"},97312:function(n,t,s){n.exports=s.p+"static/temp-test3.808646bb.jpg"}}]);
