zhcntiangang/seahorse.github.io/docs__purchase__purchase-spend-revision.md.beef2de1.async.js

"use strict";(self.webpackChunkseahorse=self.webpackChunkseahorse||[]).push([[2532],{25768:function(E,n,z){z.r(n);var s=z(72269),i=z(93359),Q=z(61788),d=z(96057),I=z(85939),B=z(16442),a=z(80936),x=z(67294),e=z(37299),A=z(85893);function u(){return(0,A.jsx)(B.dY,{children:(0,A.jsx)(x.Suspense,{fallback:(0,A.jsx)(a.Z,{}),children:(0,A.jsx)(A.Fragment,{children:(0,A.jsxs)("div",{className:"markdown",children:[(0,A.jsxs)("h1",{id:"\u8D39\u7528\u8BF4\u660E-\u589E\u8865",children:[(0,A.jsx)("a",{"aria-hidden":"true",tabIndex:"-1",href:"#\u8D39\u7528\u8BF4\u660E-\u589E\u8865",children:(0,A.jsx)("span",{className:"icon icon-link"})}),"\u8D39\u7528\u8BF4\u660E-\u589E\u8865"]}),(0,A.jsx)("p",{children:e.texts[0].value}),(0,A.jsxs)("h2",{id:"1\u53EF\u66FF\u6362",children:[(0,A.jsx)("a",{"aria-hidden":"true",tabIndex:"-1",href:"#1\u53EF\u66FF\u6362",children:(0,A.jsx)("span",{className:"icon icon-link"})}),"1\u3001\u53EF\u66FF\u6362"]}),(0,A.jsxs)("h3",{id:"11-\u66FF\u6362-wago",children:[(0,A.jsx)("a",{"aria-hidden":"true",tabIndex:"-1",href:"#11-\u66FF\u6362-wago",children:(0,A.jsx)("span",{className:"icon icon-link"})}),"1.1 \u66FF\u6362 Wago"]}),(0,A.jsx)("p",{children:e.texts[1].value}),(0,A.jsx)("img",{style:{zoom:"80%"},src:z(77141)}),(0,A.jsxs)("h3",{id:"12-\u66FF\u6362-led-\u706F\u5E26",children:[(0,A.jsx)("a",{"aria-hidden":"true",tabIndex:"-1",href:"#12-\u66FF\u6362-led-\u706F\u5E26",children:(0,A.jsx)("span",{className:"icon icon-link"})}),"1.2 \u66FF\u6362 Led \u706F\u5E26"]}),(0,A.jsx)("p",{children:e.texts[2].value}),(0,A.jsx)("p",{children:(0,A.jsx)("img",{alt:"",src:z(63153)})}),(0,A.jsx)("p",{children:(0,A.jsx)("img",{alt:"",src:z(43164)})}),(0,A.jsx)("p",{children:(0,A.jsx)("em",{children:e.texts[3].value})}),(0,A.jsxs)("h3",{id:"13-bat85-\u4E8C\u6781\u7BA1",children:[(0,A.jsx)("a",{"aria-hidden":"true",tabIndex:"-1",href:"#13-bat85-\u4E8C\u6781\u7BA1",children:(0,A.jsx)("span",{className:"icon icon-link"})}),"1.3 BAT85 \u4E8C\u6781\u7BA1"]}),(0,A.jsx)("p",{children:e.texts[4].value}),(0,A.jsxs)("h3",{id:"14-\u66FF\u6362\u6EE4\u6CE2\u5668",children:[(0,A.jsx)("a",{"aria-hidden":"true",tabIndex:"-1",href:"#14-\u66FF\u6362\u6EE4\u6CE2\u5668",children:(0,A.jsx)("span",{className:"icon icon-link"})}),"1.4 \u66FF\u6362\u6EE4\u6CE2\u5668"]}),(0,A.jsx)("p",{children:e.texts[5].value}),(0,A.jsx)("p",{children:(0,A.jsx)("img",{alt:"",src:z(44647)})}),(0,A.jsxs)("h3",{id:"15-\u6E29\u63A7\u4FDD\u9669\u4E1D",children:[(0,A.jsx)("a",{"aria-hidden":"true",tabIndex:"-1",href:"#15-\u6E29\u63A7\u4FDD\u9669\u4E1D",children:(0,A.jsx)("span",{className:"icon icon-link"})}),"1.5 \u6E29\u63A7\u4FDD\u9669\u4E1D"]}),(0,A.jsx)("p",{children:e.texts[6].value}),(0,A.jsxs)("h3",{id:"16-\u77ED\u6B65\u8FDB\u7535\u673A",children:[(0,A.jsx)("a",{"aria-hidden":"true",tabIndex:"-1",href:"#16-\u77ED\u6B65\u8FDB\u7535\u673A",children:(0,A.jsx)("span",{className:"icon icon-link"})}),"1.6 \u77ED\u6B65\u8FDB\u7535\u673A"]}),(0,A.jsx)("p",{children:e.texts[7].value}),(0,A.jsxs)("h2",{id:"2\u53EF\u4EE5\u589E\u8D2D",children:[(0,A.jsx)("a",{"aria-hidden":"true",tabIndex:"-1",href:"#2\u53EF\u4EE5\u589E\u8D2D",children:(0,A.jsx)("span",{className:"icon icon-link"})}),"2\u3001\u53EF\u4EE5\u589E\u8D2D"]}),(0,A.jsxs)("h3",{id:"21-sb-\u5934\u8F6C\u63A5\u677F",children:[(0,A.jsx)("a",{"aria-hidden":"true",tabIndex:"-1",href:"#21-sb-\u5934\u8F6C\u63A5\u677F",children:(0,A.jsx)("span",{className:"icon icon-link"})}),"2.1 SB \u5934\u8F6C\u63A5\u677F"]}),(0,A.jsxs)("ul",{children:[(0,A.jsx)("li",{children:e.texts[8].value}),(0,A.jsx)("li",{children:e.texts[9].value})]}),(0,A.jsx)("p",{children:(0,A.jsx)("img",{alt:"",src:z(96577)})}),(0,A.jsx)("p",{children:(0,A.jsx)("img",{alt:"",src:z(52078)})}),(0,A.jsxs)("h3",{id:"22-\u578B\u6750\u56FA\u5B9A\u4EF6",children:[(0,A.jsx)("a",{"aria-hidden":"true",tabIndex:"-1",href:"#22-\u578B\u6750\u56FA\u5B9A\u4EF6",children:(0,A.jsx)("span",{className:"icon icon-link"})}),"2.2 \u578B\u6750\u56FA\u5B9A\u4EF6"]}),(0,A.jsxs)("ul",{children:[(0,A.jsx)("li",{children:e.texts[10].value}),(0,A.jsx)("li",{children:e.texts[11].value}),(0,A.jsx)("li",{children:e.texts[12].value})]}),(0,A.jsx)("p",{children:(0,A.jsx)("img",{alt:"",src:z(69956)})}),(0,A.jsxs)("h3",{id:"23-e3dv6-\u7845\u80F6\u4FDD\u62A4\u5957",children:[(0,A.jsx)("a",{"aria-hidden":"true",tabIndex:"-1",href:"#23-e3dv6-\u7845\u80F6\u4FDD\u62A4\u5957",children:(0,A.jsx)("span",{className:"icon icon-link"})}),"2.3 E3DV6 \u7845\u80F6\u4FDD\u62A4\u5957"]}),(0,A.jsx)("p",{children:e.texts[13].value}),(0,A.jsxs)("h3",{id:"24-\u70ED\u5E8A\u7845\u80F6\u4FDD\u62A4\u5957",children:[(0,A.jsx)("a",{"aria-hidden":"true",tabIndex:"-1",href:"#24-\u70ED\u5E8A\u7845\u80F6\u4FDD\u62A4\u5957",children:(0,A.jsx)("span",{className:"icon icon-link"})}),"2.4 \u70ED\u5E8A\u7845\u80F6\u4FDD\u62A4\u5957"]}),(0,A.jsx)("p",{children:e.texts[14].value}),(0,A.jsx)("p",{children:e.texts[15].value}),(0,A.jsx)("p",{children:(0,A.jsx)("img",{alt:"",src:z(22226)})}),(0,A.jsxs)("h3",{id:"25-\u87BA\u4E1D",children:[(0,A.jsx)("a",{"aria-hidden":"true",tabIndex:"-1",href:"#25-\u87BA\u4E1D",children:(0,A.jsx)("span",{className:"icon icon-link"})}),"2.5 \u87BA\u4E1D"]}),(0,A.jsxs)(d.Z,{children:[(0,A.jsx)("thead",{children:(0,A.jsxs)("tr",{children:[(0,A.jsx)("th",{children:e.texts[16].value}),(0,A.jsx)("th",{children:e.texts[17].value}),(0,A.jsx)("th",{children:e.texts[18].value})]})}),(0,A.jsxs)("tbody",{children:[(0,A.jsxs)("tr",{children:[(0,A.jsx)("td",{children:e.texts[19].value}),(0,A.jsx)("td",{children:e.texts[20].value}),(0,A.jsx)("td",{children:e.texts[21].value})]}),(0,A.jsxs)("tr",{children:[(0,A.jsx)("td",{children:e.texts[22].value}),(0,A.jsx)("td",{children:e.texts[23].value}),(0,A.jsx)("td",{children:e.texts[24].value})]}),(0,A.jsxs)("tr",{children:[(0,A.jsx)("td",{children:e.texts[25].value}),(0,A.jsx)("td",{children:e.texts[26].value}),(0,A.jsx)("td",{children:e.texts[27].value})]})]})]})]})})})})}n.default=u},37299:function(E,n,z){z.r(n),z.d(n,{texts:function(){return s}});const s=[{value:"\u6309\u7167\u5B98\u65B9\u6587\u6863\u7EC4\u88C5\u5B8C\u6BD5\u4E86\uFF0C\u4F46\u662F\u5728\u5B98\u65B9\u6587\u6863\u6709\u4E9B\u4F18\u5316\uFF0C\u5BF9\u73B0\u6709\u7684\u91C7\u8D2D\u91C7\u8D2D\u6E05\u5355\u8FDB\u884C\u4E86\u8C03\u6574\u3002",paraId:0,tocIndex:0},{value:"\u7528\u5BFC\u8F68\u5F0F\u5FEB\u901F\u6309\u538B\u5F0F\u63A5\u7EBF\u7AEF\u5B50\u6765\u66FF\u6362",paraId:1,tocIndex:2},{value:"\u7528\u767D\u8272\u706F\u5C31\u53EF\u4EE5\u4E86\uFF0C\u4F46\u662F\u505A\u4E2A\u624B\u52A8\u5F00\u5173\u3002\u53EF\u4EE5\u4E70\u4E24\u4E2A\u3002",paraId:2,tocIndex:3},{value:"\u8FD9\u4E2A\u5F00\u5173\u5C31\u7B97\u6240\u6709\u7684\u706F\u90FD\u5173\u95ED\u4E86\uFF0C\u5F00\u5173\u4E0A\u7684\u706F\u4E5F\u4F1A\u4EAE\u3002\u4F46\u662F\u8FD9\u4E2A\u5F00\u5173\u5BF9\u63A5\u7EBF\u6709\u4E00\u5B9A\u8981\u6C42\uFF0C\u5982\u679C\u611F\u89C9\u63A5\u7EBF\u9EBB\u70E6\uFF0C\u53EF\u4EE5\u4E70\u4E2A\u624B\u52A8\u63A7\u5236\u7684\u5F00\u5173\u3002",paraId:3,tocIndex:3},{value:"\u4E0D\u8981\u4E70\u4E86\uFF0C\u5355\u72EC\u4E70\u5F88\u8D35\u3002\u4E70\u4E2A SB \u5934\u96C6\u7EBF\u5668\uFF0C\u4E0A\u9762\u5C31\u5E26\u4E00\u4E2A\u4E8C\u6781\u7BA1\u3002",paraId:4,tocIndex:4},{value:"\u6CA1\u5FC5\u8981\uFF0C20 \u591A\u5143\u94B1\u7684\u6EE4\u6CE2\u5668\u589E\u52A0\u4E86\u6210\u672C\u30025 \u5143\u7684\u5F00\u5173\u5DF2\u7ECF\u5F88\u597D\u7528\u4E86\u3002",paraId:5,tocIndex:5},{value:"\u70ED\u5E8A\u7684\u52A0\u70ED\u57AB\u81EA\u5E26\u6E29\u63A7\u4FDD\u9669\u4E1D\u3002",paraId:6,tocIndex:6},{value:"\u5982\u679C\u7528 SB \u5934\uFF0C\u90A3\u4E48\u77ED 42 \u6B65\u8FDB\u7535\u673A\u5C31\u4E0D\u9700\u8981\u4E86\u3002",paraId:7,tocIndex:7},{value:"\u4E0D\u7528\u5355\u72EC\u8D2D\u4E70 BAT85 \u4E8C\u6781\u7BA1",paraId:8,tocIndex:9},{value:"\u4E0D\u8981\u4E70 LED \u706F\u73E0\uFF0C\u4E70\u4E2A\u96C6\u6210\u54C1\u4F1A\u4FBF\u5B9C\u4E00\u70B9\u3002",paraId:8,tocIndex:9},{value:"2028 \u9ED1\u8272\u89D2\u7801",paraId:9,tocIndex:10},{value:"\u94DD\u628A\u624B",paraId:9,tocIndex:10},{value:"\u5C01\u6761\uFF1A\u7528\u6765\u628A LED \u7684\u7535\u7EBF\u7ED9\u538B\u5165\u3002",paraId:9,tocIndex:10},{value:"\u4E70\u4E00\u4E2A\u4EE5\u514D\u55B7\u5934\u88AB\u98CE\u5439\u51C9\u4E86\u3002",paraId:10,tocIndex:11},{value:"\u81EA\u5DF1\u505A\u4E00\u4E2A\uFF0C\u628A\u4FA7\u9762\u8FB9\u4E5F\u7ED9\u9632\u62A4\u4E0A\uFF0C\u6BD4\u9694\u70ED\u68C9\u597D\u770B\u4E00\u70B9\u3002",paraId:11,tocIndex:12},{value:"\u5269\u4F59\u7684\u5C3A\u5BF8\u653E\u5728\u55B7\u5634\u4E0A\u3002",paraId:12,tocIndex:12},{value:"\u540D\u79F0",paraId:13,tocIndex:13},{value:"\u7C7B\u578B",paraId:13,tocIndex:13},{value:"\u6570\u91CF",paraId:13,tocIndex:13},{value:"\u5706\u5934\u5185\u516D\u89D2 M5-10",paraId:13,tocIndex:13},{value:"\u589E\u52A0",paraId:13,tocIndex:13},{value:"20",paraId:13,tocIndex:13},{value:"M3\u8239\u578B\u87BA\u6BCD",paraId:13,tocIndex:13},{value:"\u589E\u52A0",paraId:13,tocIndex:13},{value:"40",paraId:13,tocIndex:13},{value:"M3\u5F39\u73E0\u87BA\u6BCD",paraId:13,tocIndex:13},{value:"\u589E\u52A0",paraId:13,tocIndex:13},{value:"20",paraId:13,tocIndex:13}]},44647:function(E){E.exports="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"},63153:function(E,n,z){E.exports=z.p+"static/zg-led-deng.525b32a1.jpg"},43164:function(E,n,z){E.exports=z.p+"static/zg-led-kg.b383d3fd.jpg"},22226:function(E,n,z){E.exports=z.p+"static/zg-re.fc678ffc.jpg"},96577:function(E){E.exports="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"},52078:function(E){E.exports="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"},69956:function(E,n,z){E.exports=z.p+"static/zg-xc.8079f7d9.jpg"},77141:function(E,n,z){E.exports=z.p+"static/zg-xianguiduanzi.d9c9c3cc.jpg"}}]);
